beanz/m-bot-scad/readme.md

# M-bot
D-Bot-style printer with MGN rails

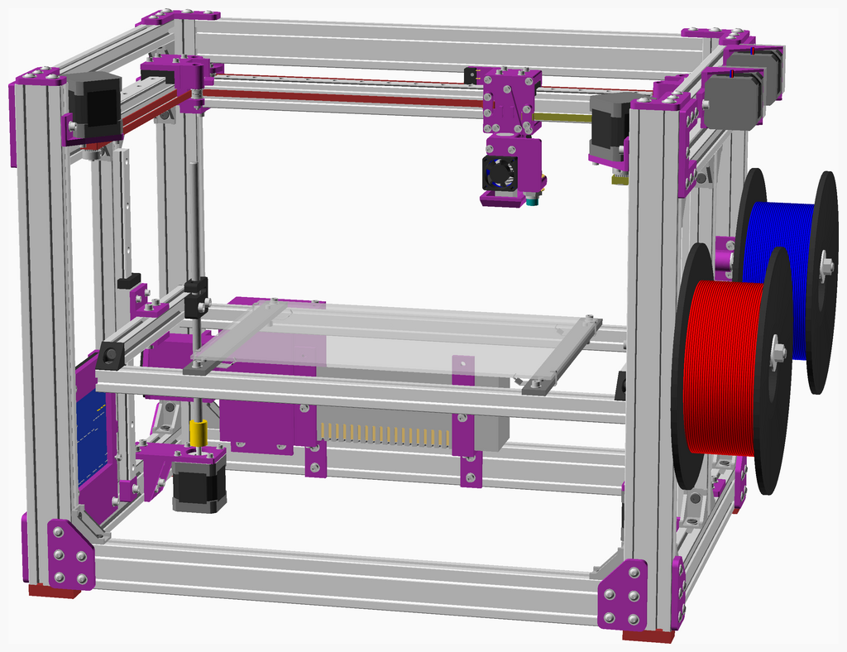
[picture p1: assemblies/main_assembled.png]
Main Assembly


<span></span>

---
## Table of Contents
1. [Parts list](#Parts_list)
1. [Duct Assembly](#duct_assembly)
1. [Z Motor Assembly](#z_motor_assembly)
1. [Spool Rod Assembly](#spool_rod_assembly)
1. [Bed Assembly](#bed_assembly)
1. [Z Axis Assembly](#z_axis_assembly)
1. [Idler Assembly](#idler_assembly)
1. [Right Y Carriage Assembly](#right_y_carriage_assembly)
1. [Left Y Carriage Assembly](#left_y_carriage_assembly)
1. [X Carriage Rear Assembly](#x_carriage_rear_assembly)
1. [X Carriage Front Assembly](#x_carriage_front_assembly)
1. [X Carriage Assembly](#x_carriage_assembly)
1. [X Rail Assembly](#x_rail_assembly)
1. [X Rail Extrusion Assembly](#x_rail_extrusion_assembly)
1. [X Rail Carriage Assembly](#x_rail_carriage_assembly)
1. [X Axis Assembly](#x_axis_assembly)
1. [Xy Combined Assembly](#xy_combined_assembly)
1. [Lower Back Frame Assembly](#lower_back_frame_assembly)
1. [Milled Corner For Tapped End Assembly](#milled_corner_for_tapped_end_assembly)
1. [Cast Corner Bracket Assembly](#cast_corner_bracket_assembly)
1. [Left Front Top Corner Assembly](#left_front_top_corner_assembly)
1. [Left Back Top Corner Assembly](#left_back_top_corner_assembly)
1. [Side Top Corner Assembly](#side_top_corner_assembly)
1. [Left Motor Assembly](#left_motor_assembly)
1. [Y Endstop Assembly](#y_endstop_assembly)
1. [Y Rail Assembly](#y_rail_assembly)
1. [Left Y Rail Assembly](#left_y_rail_assembly)
1. [Left Upper End Assembly](#left_upper_end_assembly)
1. [Bottom Corner Assembly](#bottom_corner_assembly)
1. [Reversed Bottom Corner Assembly](#reversed_bottom_corner_assembly)
1. [Duet Mount Assembly](#duet_mount_assembly)
1. [Z Carriage Assembly](#z_carriage_assembly)
1. [Z Rail Assembly](#z_rail_assembly)
1. [Left Z Axis Rail Assembly](#left_z_axis_rail_assembly)
1. [Milled Corner Bracket Assembly](#milled_corner_bracket_assembly)
1. [Rail Guard Assembly](#rail_guard_assembly)
1. [Z Motor Mount Assembly](#z_motor_mount_assembly)
1. [Left Lower End Assembly](#left_lower_end_assembly)
1. [Left Lower End With Z Assembly](#left_lower_end_with_z_assembly)
1. [Left Central End Assembly](#left_central_end_assembly)
1. [Dual Idler Assembly](#dual_idler_assembly)
1. [Back Left Idler Assembly](#back_left_idler_assembly)
1. [Left Rear Upright Assembly](#left_rear_upright_assembly)
1. [Left Central And Rear Assembly](#left_central_and_rear_assembly)
1. [Left Front Upright Assembly](#left_front_upright_assembly)
1. [Left End Frame Assembly](#left_end_frame_assembly)
1. [Left End With Z Carriage Rail Assembly](#left_end_with_z_carriage_rail_assembly)
1. [Titan Mount Assembly](#titan_mount_assembly)
1. [Right Front Top Corner Assembly](#right_front_top_corner_assembly)
1. [Right Back Top Corner Assembly](#right_back_top_corner_assembly)
1. [Right Motor Assembly](#right_motor_assembly)
1. [Right Y Rail Assembly](#right_y_rail_assembly)
1. [Right Upper End Assembly](#right_upper_end_assembly)
1. [Right Z Axis Rail Assembly](#right_z_axis_rail_assembly)
1. [Right Lower End Assembly](#right_lower_end_assembly)
1. [Right Lower End With Z Assembly](#right_lower_end_with_z_assembly)
1. [Right Central End Assembly](#right_central_end_assembly)
1. [Back Right Idler Assembly](#back_right_idler_assembly)
1. [Right Rear Upright Assembly](#right_rear_upright_assembly)
1. [Right Central And Rear Assembly](#right_central_and_rear_assembly)
1. [Right Front Upright Assembly](#right_front_upright_assembly)
1. [Right End Frame Assembly](#right_end_frame_assembly)
1. [Right End With Z Carriage Rail Assembly](#right_end_with_z_carriage_rail_assembly)
1. [Frame Assembly](#frame_assembly)
1. [Frame With X Rail Assembly](#frame_with_x_rail_assembly)
1. [Frame With Bed Assembly](#frame_with_bed_assembly)
1. [Frame With Spool Holder Assembly](#frame_with_spool_holder_assembly)
1. [Frame With Z Motor Assembly](#frame_with_z_motor_assembly)
1. [Hotend Assembly](#hotend_assembly)
1. [Belts Assembly](#belts_assembly)
1. [Socket Assembly](#socket_assembly)
1. [Duet Assembly](#duet_assembly)
1. [Main Assembly](#main_assembly)

<span></span>
[Top](#TOP)

---

## Parts list
| <span style="writing-mode: vertical-rl; text-orientation: mixed;">Duct</span> | <span style="writing-mode: vertical-rl; text-orientation: mixed;">2 x Z&nbsp;Motor</span> | <span style="writing-mode: vertical-rl; text-orientation: mixed;">2 x Spool&nbsp;Rod</span> | <span style="writing-mode: verti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
|---:|---:|---:|---:|---:|---:|---:|---:|---:|---:|---:|---:|---:|---:|---:|---:|---:|---:|---:|---:|---:|---:|---:|---:|---:|---:|---:|---:|---:|---:|---:|---:|---:|---:|---:|---:|---:|---:|---:|---:|---:|---:|---:|---:|---:|---:|---:|---:|---:|---:|---:|---:|---:|---:|---:|---:|---:|---:|---:|---:|---:|---:|---:|---:|---:|---:|---:|---:|---:|---:|---:|---:|---:|:---|
|  |  |  |  |  |  |  |  |  |  |  |  |  |  |  |  |  |  |  |  |  |  |  |  |  |  |  |  |  |  |  |  |  |  |  |  |  |  |  |  |  |  |  |  |  |  |  |  |  |  |  |  |  |  |  |  |  |  |  |  |  |  |  |  |  |  |  |  |  |  |  |  | | **Vitamins** |
| &nbsp;&nbsp;.&nbsp; | &nbsp;&nbsp;.&nbsp; | &nbsp;&nbsp;4&nbsp; | &nbsp;&nbsp;.&nbsp; | &nbsp;&nbsp;.&nbsp; | &nbsp;&nbsp;.&nbsp; | &nbsp;&nbsp;.&nbsp; | &nbsp;&nbsp;.&nbsp; | &nbsp;&nbsp;.&nbsp; | &nbsp;&nbsp;.&nbsp; | &nbsp;&nbsp;.&nbsp; | &nbsp;&nbsp;.&nbsp; | &nbsp;&nbsp;.&nbsp; | &nbsp;&nbsp;.&nbsp; | &nbsp;&nbsp;.&nbsp; | &nbsp;&nbsp;.&nbsp; | &nbsp;&nbsp;.&nbsp; | &nbsp;&nbsp;.&nbsp; | &nbsp;&nbsp;.&nbsp; | &nbsp;&nbsp;.&nbsp; | &nbsp;&nbsp;.&nbsp; | &nbsp;&nbsp;.&nbsp; | &nbsp;&nbsp;.&nbsp; | &nbsp;&nbsp;.&nbsp; | &nbsp;&nbsp;.&nbsp; | &nbsp;&nbsp;.&nbsp; | &nbsp;&nbsp;.&nbsp; | &nbsp;&nbsp;.&nbsp; | &nbsp;&nbsp;.&nbsp; | &nbsp;&nbsp;.&nbsp; | &nbsp;&nbsp;.&nbsp; | &nbsp;&nbsp;.&nbsp; | &nbsp;&nbsp;.&nbsp; | &nbsp;&nbsp;.&nbsp; | &nbsp;&nbsp;.&nbsp; | &nbsp;&nbsp;.&nbsp; | &nbsp;&nbsp;.&nbsp; | &nbsp;&nbsp;.&nbsp; | &nbsp;&nbsp;.&nbsp; | &nbsp;&nbsp;.&nbsp; | &nbsp;&nbsp;.&nbsp; | &nbsp;&nbsp;.&nbsp; | &nbsp;&nbsp;.&nbsp; | &nbsp;&nbsp;.&nbsp; | &nbsp;&nbsp;.&nbsp; | &nbsp;&nbsp;.&nbsp; | &nbsp;&nbsp;.&nbsp; | &nbsp;&nbsp;.&nbsp; | &nbsp;&nbsp;.&nbsp; | &nbsp;&nbsp;.&nbsp; | &nbsp;&nbsp;.&nbsp; | &nbsp;&nbsp;.&nbsp; | &nbsp;&nbsp;.&nbsp; | &nbsp;&nbsp;.&nbsp; | &nbsp;&nbsp;.&nbsp; | &nbsp;&nbsp;.&nbsp; | &nbsp;&nbsp;.&nbsp; | &nbsp;&nbsp;.&nbsp; | &nbsp;&nbsp;.&nbsp; | &nbsp;&nbsp;.&nbsp; | &nbsp;&nbsp;.&nbsp; | &nbsp;&nbsp;.&nbsp; | &nbsp;&nbsp;.&nbsp; | &nbsp;&nbsp;.&nbsp; | &nbsp;&nbsp;.&nbsp; | &nbsp;&nbsp;.&nbsp; | &nbsp;&nbsp;.&nbsp; | &nbsp;&nbsp;.&nbsp; | &nbsp;&nbsp;.&nbsp; | &nbsp;&nbsp;.&nbsp; | &nbsp;&nbsp;.&nbsp; | &nbsp;&nbsp;.&nbsp; |  &nbsp;&nbsp;4&nbsp; | &nbsp;&nbsp; Ball bearing 608-2RS 8mm x 22mm x 7mm |
| &nbsp;&nbsp;.&nbsp; | &nbsp;&nbsp;.&nbsp; | &nbsp;&nbsp;.&nbsp; | &nbsp;&nbsp;.&nbsp; | &nbsp;&nbsp;.&nbsp; | &nbsp;&nbsp;8&nbsp; | &nbsp;&nbsp;.&nbsp; | &nbsp;&nbsp;.&nbsp; | &nbsp;&nbsp;.&nbsp; | &nbsp;&nbsp;.&nbsp; | &nbsp;&nbsp;.&nbsp; | &nbsp;&nbsp;.&nbsp; | &nbsp;&nbsp;.&nbsp; | &nbsp;&nbsp;.&nbsp; | &nbsp;&nbsp;.&nbsp; | &nbsp;&nbsp;.&nbsp; | &nbsp;&nbsp;.&nbsp; | &nbsp;&nbsp;.&nbsp; | &nbsp;&nbsp;.&nbsp; | &nbsp;&nbsp;.&nbsp; | &nbsp;&nbsp;.&nbsp; | &nbsp;&nbsp;.&nbsp; | &nbsp;&nbsp;.&nbsp; | &nbsp;&nbsp;.&nbsp; | &nbsp;&nbsp;.&nbsp; | &nbsp;&nbsp;.&nbsp; | &nbsp;&nbsp;.&nbsp; | &nbsp;&nbsp;.&nbsp; | &nbsp;&nbsp;.&nbsp; | &nbsp;&nbsp;.&nbsp; | &nbsp;&nbsp;.&nbsp; | &nbsp;&nbsp;.&nbsp; | &nbsp;&nbsp;.&nbsp; | &nbsp;&nbsp;.&nbsp; | &nbsp;&nbsp;.&nbsp; | &nbsp;&nbsp;.&nbsp; | &nbsp;&nbsp;.&nbsp; | &nbsp;&nbsp;.&nbsp; | &nbsp;&nbsp;.&nbsp; | &nbsp;&nbsp;8&nbsp; | &nbsp;&nbsp;.&nbsp; | &nbsp;&nbsp;.&nbsp; | &nbsp;&nbsp;.&nbsp; | &nbsp;&nbsp;.&nbsp; | &nbsp;&nbsp;.&nbsp; | &nbsp;&nbsp;.&nbsp; | &nbsp;&nbsp;.&nbsp; | &nbsp;&nbsp;.&nbsp; | &nbsp;&nbsp;.&nbsp; | &nbsp;&nbsp;.&nbsp; | &nbsp;&nbsp;.&nbsp; | &nbsp;&nbsp;.&nbsp; | &nbsp;&nbsp;.&nbsp; | &nbsp;&nbsp;.&nbsp; | &nbsp;&nbsp;.&nbsp; | &nbsp;&nbsp;.&nbsp; | &nbsp;&nbsp;.&nbsp; | &nbsp;&nbsp;.&nbsp; | &nbsp;&nbsp;.&nbsp; | &nbsp;&nbsp;.&nbsp; | &nbsp;&nbsp;.&nbsp; | &nbsp;&nbsp;.&nbsp; | &nbsp;&nbsp;.&nbsp; | &nbsp;&nbsp;.&nbsp; | &nbsp;&nbsp;.&nbsp; | &nbsp;&nbsp;.&nbsp; | &nbsp;&nbsp;.&nbsp; | &nbsp;&nbsp;.&nbsp; | &nbsp;&nbsp;.&nbsp; | &nbsp;&nbsp;.&nbsp; | &nbsp;&nbsp;.&nbsp; | &nbsp;&nbsp;.&nbsp; |  &nbsp;&nbsp;16&nbsp; | &nbsp;&nbsp; Ball bearing F623-2RS 3mm x 10mm x 4mm |
| &nbsp;&nbsp;1&nbsp; | &nbsp;&nbsp;.&nbsp; | &nbsp;&nbsp;.&nbsp; | &nbsp;&nbsp;.&nbsp; | &nbsp;&nbsp;.&nbsp; | &nbsp;&nbsp;.&nbsp; | &nbsp;&nbsp;.&nbsp; | &nbsp;&nbsp;.&nbsp; | &nbsp;&nbsp;.&nbsp; | &nbsp;&nbsp;.&nbsp; | &nbsp;&nbsp;.&nbsp; | &nbsp;&nbsp;.&nbsp; | &nbsp;&nbsp;.&nbsp; | &nbsp;&nbsp;.&nbsp; | &nbsp;&nbsp;.&nbsp; | &nbsp;&nbsp;.&nbsp; | &nbsp;&nbsp;.&nbsp; | &nbsp;&nbsp;.&nbsp; | &nbsp;&nbsp;.&nbsp; | &nbsp;&nbsp;.&nbsp; | &nbsp;&nbsp;.&nbsp; | &nbsp;&nbsp;.&nbsp; | &nbsp;&nbsp;.&nbsp; | &nbsp;&nbsp;.&nbsp; | &nbsp;&nbsp;.&nbsp; | &nbsp;&nbsp;.&nbsp; | &nbsp;&nbsp;.&nbsp; | &nbsp;&nbsp;.&nbsp; | &nbsp;&nbsp;.&nbsp; | &nbsp;&nbsp;.&nbsp; | &nbsp;&nbsp;.&nbsp; | &nbsp;&nbsp;.&nbsp; | &nbsp;&nbsp;.&nbsp; | &nbsp;&nbsp;.&nbsp; | &nbsp;&nbsp;.&nbsp; | &nbsp;&nbsp;.&nbsp; | &nbsp;&nbsp;.&nbsp; | &nbsp;&nbsp;.&nbsp; | &nbsp;&nbsp;.&nbsp; | &nbsp;&nbsp;.&nbsp; | &nbsp;&nbsp;.&nbsp; | &nbsp;&nbsp;.&nbsp; | &nbsp;&nbsp;.&nbsp; | &nbsp;&nbsp;.&nbsp; | &nbsp;&nbsp;.&nbsp; | &nbsp;&nbsp;.&nbsp; | &nbsp;&nbsp;.&nbsp; | &nbsp;&nbsp;.&nbsp; | &nbsp;&nbsp;.&nbsp; | &nbsp;&nbsp;.&nbsp; | &nbsp;&nbsp;.&nbsp; | &nbsp;&nbsp;.&nbsp; | &nbsp;&nbsp;.&nbsp; | &nbsp;&nbsp;.&nbsp; | &nbsp;&nbsp;.&nbsp; | &nbsp;&nbsp;.&nbsp; | &nbsp;&nbsp;.&nbsp; | &nbsp;&nbsp;.&nbsp; | &nbsp;&nbsp;.&nbsp; | &nbsp;&nbsp;.&nbsp; | &nbsp;&nbsp;.&nbsp; | &nbsp;&nbsp;.&nbsp; | &nbsp;&nbsp;.&nbsp; | &nbsp;&nbsp;.&nbsp; | &nbsp;&nbsp;.&nbsp; | &nbsp;&nbsp;.&nbsp; | &nbsp;&nbsp;.&nbsp; | &nbsp;&nbsp;.&nbsp; | &nbsp;&nbsp;.&nbsp; | &nbsp;&nbsp;.&nbsp; | &nbsp;&nbsp;.&nbsp; | &nbsp;&nbsp;.&nbsp; |  &nbsp;&nbsp;1&nbsp; | &nbsp;&nbsp; Blower Runda RB5015 |
| &nbsp;&nbsp;.&nbsp; | &nbsp;&nbsp;.&nbsp; | &nbsp;&nbsp;.&nbsp; | &nbsp;&nbsp;.&nbsp; | &nbsp;&nbsp;.&nbsp; | &nbsp;&nbsp;.&nbsp; | &nbsp;&nbsp;.&nbsp; | &nbsp;&nbsp;.&nbsp; | &nbsp;&nbsp;.&nbsp; | &nbsp;&nbsp;.&nbsp; | &nbsp;&nbsp;.&nbsp; | &nbsp;&nbsp;.&nbsp; | &nbsp;&nbsp;.&nbsp; | &nbsp;&nbsp;.&nbsp; | &nbsp;&nbsp;.&nbsp; | &nbsp;&nbsp;.&nbsp; | &nbsp;&nbsp;.&nbsp; | &nbsp;&nbsp;.&nbsp; | &nbsp;&nbsp;.&nbsp; | &nbsp;&nbsp;.&nbsp; | &nbsp;&nbsp;.&nbsp; | &nbsp;&nbsp;.&nbsp; | &nbsp;&nbsp;.&nbsp; | &nbsp;&nbsp;.&nbsp; | &nbsp;&nbsp;.&nbsp; | &nbsp;&nbsp;.&nbsp; | &nbsp;&nbsp;.&nbsp; | &nbsp;&nbsp;.&nbsp; | &nbsp;&nbsp;.&nbsp; | &nbsp;&nbsp;.&nbsp; | &nbsp;&nbsp;.&nbsp; | &nbsp;&nbsp;.&nbsp; | &nbsp;&nbsp;.&nbsp; | &nbsp;&nbsp;.&nbsp; | &nbsp;&nbsp;.&nbsp; | &nbsp;&nbsp;.&nbsp; | &nbsp;&nbsp;.&nbsp; | &nbsp;&nbsp;.&nbsp; | &nbsp;&nbsp;.&nbsp; | &nbsp;&nbsp;.&nbsp; | &nbsp;&nbsp;.&nbsp; | &nbsp;&nbsp;.&nbsp; | &nbsp;&nbsp;.&nbsp; | &nbsp;&nbsp;.&nbsp; | &nbsp;&nbsp;.&nbsp; | &nbsp;&nbsp;.&nbsp; | &nbsp;&nbsp;.&nbsp; | &nbsp;&nbsp;.&nbsp; | &nbsp;&nbsp;.&nbsp; | &nbsp;&nbsp;.&nbsp; | &nbsp;&nbsp;.&nbsp; | &nbsp;&nbsp;.&nbsp; | &nbsp;&nbsp;.&nbsp; | &nbsp;&nbsp;.&nbsp; | &nbsp;&nbsp;.&nbsp; | &nbsp;&nbsp;.&nbsp; | &nbsp;&nbsp;.&nbsp; | &nbsp;&nbsp;.&nbsp; | &nbsp;&nbsp;.&nbsp; | &nbsp;&nbsp;.&nbsp; | &nbsp;&nbsp;.&nbsp; | &nbsp;&nbsp;.&nbsp; | &nbsp;&nbsp;.&nbsp; | &nbsp;&nbsp;.&nbsp; | &nbsp;&nbsp;.&nbsp; | &nbsp;&nbsp;.&nbsp; | &nbsp;&nbsp;.&nbsp; | &nbsp;&nbsp;.&nbsp; | &nbsp;&nbsp;.&nbsp; | &nbsp;&nbsp;.&nbsp; | &nbsp;&nbsp;1&nbsp; | &nbsp;&nbsp;.&nbsp; |  &nbsp;&nbsp;1&nbsp; | &nbsp;&nbsp; Cat 5 patch cable 300mm |
| &nbsp;&nbsp;.&nbsp; | &nbsp;&nbsp;.&nbsp; | &nbsp;&nbsp;.&nbsp; | &nbsp;&nbsp;.&nbsp; | &nbsp;&nbsp;.&nbsp; | &nbsp;&nbsp;.&nbsp; | &nbsp;&nbsp;.&nbsp; | &nbsp;&nbsp;.&nbsp; | &nbsp;&nbsp;.&nbsp; | &nbsp;&nbsp;.&nbsp; | &nbsp;&nbsp;.&nbsp; | &nbsp;&nbsp;.&nbsp; | &nbsp;&nbsp;.&nbsp; | &nbsp;&nbsp;.&nbsp; | &nbsp;&nbsp;.&nbsp; | &nbsp;&nbsp;.&nbsp; | &nbsp;&nbsp;.&nbsp; | &nbsp;&nbsp;.&nbsp; | &nbsp;&nbsp;.&nbsp; | &nbsp;&nbsp;.&nbsp; | &nbsp;&nbsp;.&nbsp; | &nbsp;&nbsp;.&nbsp; | &nbsp;&nbsp;.&nbsp; | &nbsp;&nbsp;.&nbsp; | &nbsp;&nbsp;.&nbsp; | &nbsp;&nbsp;.&nbsp; | &nbsp;&nbsp;.&nbsp; | &nbsp;&nbsp;.&nbsp; | &nbsp;&nbsp;.&nbsp; | &nbsp;&nbsp;.&nbsp; | &nbsp;&nbsp;.&nbsp; | &nbsp;&nbsp;.&nbsp; | &nbsp;&nbsp;.&nbsp; | &nbsp;&nbsp;.&nbsp; | &nbsp;&nbsp;.&nbsp; | &nbsp;&nbsp;.&nbsp; | &nbsp;&nbsp;.&nbsp; | &nbsp;&nbsp;.&nbsp; | &nbsp;&nbsp;.&nbsp; | &nbsp;&nbsp;.&nbsp; | &nbsp;&nbsp;.&nbsp; | &nbsp;&nbsp;.&nbsp; | &nbsp;&nbsp;.&nbsp; | &nbsp;&nbsp;.&nbsp; | &nbsp;&nbsp;.&nbsp; | &nbsp;&nbsp;.&nbsp; | &nbsp;&nbsp;.&nbsp; | &nbsp;&nbsp;.&nbsp; | &nbsp;&nbsp;.&nbsp; | &nbsp;&nbsp;.&nbsp; | &nbsp;&nbsp;.&nbsp; | &nbsp;&nbsp;.&nbsp; | &nbsp;&nbsp;.&nbsp; | &nbsp;&nbsp;.&nbsp; | &nbsp;&nbsp;.&nbsp; | &nbsp;&nbsp;.&nbsp; | &nbsp;&nbsp;.&nbsp; | &nbsp;&nbsp;.&nbsp; | &nbsp;&nbsp;.&nbsp; | &nbsp;&nbsp;.&nbsp; | &nbsp;&nbsp;.&nbsp; | &nbsp;&nbsp;.&nbsp; | &nbsp;&nbsp;.&nbsp; | &nbsp;&nbsp;.&nbsp; | &nbsp;&nbsp;.&nbsp; | &nbsp;&nbsp;.&nbsp; | &nbsp;&nbsp;.&nbsp; | &nbsp;&nbsp;.&nbsp; | &nbsp;&nbsp;.&nbsp; | &nbsp;&nbsp;.&nbsp; | &nbsp;&nbsp;1&nbsp; | &nbsp;&nbsp;.&nbsp; |  &nbsp;&nbsp;1&nbsp; | &nbsp;&nbsp; Duet 2 Ethernet electronics |
| &nbsp;&nbsp;.&nbsp; | &nbsp;&nbsp;.&nbsp; | &nbsp;&nbsp;.&nbsp; | &nbsp;&nbsp;.&nbsp; | &nbsp;&nbsp;.&nbsp; | &nbsp;&nbsp;.&nbsp; | &nbsp;&nbsp;.&nbsp; | &nbsp;&nbsp;.&nbsp; | &nbsp;&nbsp;.&nbsp; | &nbsp;&nbsp;.&nbsp; | &nbsp;&nbsp;.&nbsp; | &nbsp;&nbsp;.&nbsp; | &nbsp;&nbsp;.&nbsp; | &nbsp;&nbsp;.&nbsp; | &nbsp;&nbsp;.&nbsp; | &nbsp;&nbsp;.&nbsp; | &nbsp;&nbsp;.&nbsp; | &nbsp;&nbsp;.&nbsp; | &nbsp;&nbsp;.&nbsp; | &nbsp;&nbsp;.&nbsp; | &nbsp;&nbsp;.&nbsp; | &nbsp;&nbsp;.&nbsp; | &nbsp;&nbsp;.&nbsp; | &nbsp;&nbsp;.&nbsp; | &nbsp;&nbsp;.&nbsp; | &nbsp;&nbsp;.&nbsp; | &nbsp;&nbsp;.&nbsp; | &nbsp;&nbsp;.&nbsp; | &nbsp;&nbsp;.&nbsp; | &nbsp;&nbsp;.&nbsp; | &nbsp;&nbsp;.&nbsp; | &nbsp;&nbsp;.&nbsp; | &nbsp;&nbsp;.&nbsp; | &nbsp;&nbsp;.&nbsp; | &nbsp;&nbsp;.&nbsp; | &nbsp;&nbsp;.&nbsp; | &nbsp;&nbsp;.&nbsp; | &nbsp;&nbsp;.&nbsp; | &nbsp;&nbsp;.&nbsp; | &nbsp;&nbsp;.&nbsp; | &nbsp;&nbsp;.&nbsp; | &nbsp;&nbsp;.&nbsp; | &nbsp;&nbsp;.&nbsp; | &nbsp;&nbsp;.&nbsp; | &nbsp;&nbsp;.&nbsp; | &nbsp;&nbsp;.&nbsp; | &nbsp;&nbsp;2&nbsp; | &nbsp;&nbsp;.&nbsp; | &nbsp;&nbsp;.&nbsp; | &nbsp;&nbsp;.&nbsp; | &nbsp;&nbsp;.&nbsp; | &nbsp;&nbsp;.&nbsp; | &nbsp;&nbsp;.&nbsp; | &nbsp;&nbsp;.&nbsp; | &nbsp;&nbsp;.&nbsp; | &nbsp;&nbsp;.&nbsp; | &nbsp;&nbsp;.&nbsp; | &nbsp;&nbsp;.&nbsp; | &nbsp;&nbsp;.&nbsp; | &nbsp;&nbsp;.&nbsp; | &nbsp;&nbsp;.&nbsp; | &nbsp;&nbsp;.&nbsp; | &nbsp;&nbsp;.&nbsp; | &nbsp;&nbsp;.&nbsp; | &nbsp;&nbsp;.&nbsp; | &nbsp;&nbsp;.&nbsp; | &nbsp;&nbsp;.&nbsp; | &nbsp;&nbsp;.&nbsp; | &nbsp;&nbsp;.&nbsp; | &nbsp;&nbsp;.&nbsp; | &nbsp;&nbsp;.&nbsp; | &nbsp;&nbsp;.&nbsp; |  &nbsp;&nbsp;2&nbsp; | &nbsp;&nbsp; E3D Titan Extruder |
| &nbsp;&nbsp;.&nbsp; | &nbsp;&nbsp;.&nbsp; | &nbsp;&nbsp;.&nbsp; | &nbsp;&nbsp;.&nbsp; | &nbsp;&nbsp;.&nbsp; | &nbsp;&nbsp;.&nbsp; | &nbsp;&nbsp;.&nbsp; | &nbsp;&nbsp;.&nbsp; | &nbsp;&nbsp;.&nbsp; | &nbsp;&nbsp;.&nbsp; | &nbsp;&nbsp;.&nbsp; | &nbsp;&nbsp;.&nbsp; | &nbsp;&nbsp;.&nbsp; | &nbsp;&nbsp;.&nbsp; | &nbsp;&nbsp;.&nbsp; | &nbsp;&nbsp;.&nbsp; | &nbsp;&nbsp;.&nbsp; | &nbsp;&nbsp;.&nbsp; | &nbsp;&nbsp;.&nbsp; | &nbsp;&nbsp;.&nbsp; | &nbsp;&nbsp;.&nbsp; | &nbsp;&nbsp;.&nbsp; | &nbsp;&nbsp;.&nbsp; | &nbsp;&nbsp;.&nbsp; | &nbsp;&nbsp;.&nbsp; | &nbsp;&nbsp;.&nbsp; | &nbsp;&nbsp;.&nbsp; | &nbsp;&nbsp;.&nbsp; | &nbsp;&nbsp;.&nbsp; | &nbsp;&nbsp;.&nbsp; | &nbsp;&nbsp;.&nbsp; | &nbsp;&nbsp;.&nbsp; | &nbsp;&nbsp;.&nbsp; | &nbsp;&nbsp;.&nbsp; | &nbsp;&nbsp;.&nbsp; | &nbsp;&nbsp;.&nbsp; | &nbsp;&nbsp;.&nbsp; | &nbsp;&nbsp;.&nbsp; | &nbsp;&nbsp;.&nbsp; | &nbsp;&nbsp;.&nbsp; | &nbsp;&nbsp;.&nbsp; | &nbsp;&nbsp;.&nbsp; | &nbsp;&nbsp;.&nbsp; | &nbsp;&nbsp;.&nbsp; | &nbsp;&nbsp;.&nbsp; | &nbsp;&nbsp;1&nbsp; | &nbsp;&nbsp;.&nbsp; | &nbsp;&nbsp;.&nbsp; | &nbsp;&nbsp;.&nbsp; | &nbsp;&nbsp;.&nbsp; | &nbsp;&nbsp;.&nbsp; | &nbsp;&nbsp;.&nbsp; | &nbsp;&nbsp;.&nbsp; | &nbsp;&nbsp;.&nbsp; | &nbsp;&nbsp;.&nbsp; | &nbsp;&nbsp;.&nbsp; | &nbsp;&nbsp;.&nbsp; | &nbsp;&nbsp;.&nbsp; | &nbsp;&nbsp;.&nbsp; | &nbsp;&nbsp;.&nbsp; | &nbsp;&nbsp;.&nbsp; | &nbsp;&nbsp;1&nbsp; | &nbsp;&nbsp;.&nbsp; | &nbsp;&nbsp;.&nbsp; | &nbsp;&nbsp;.&nbsp; | &nbsp;&nbsp;.&nbsp; | &nbsp;&nbsp;.&nbsp; | &nbsp;&nbsp;.&nbsp; | &nbsp;&nbsp;.&nbsp; | &nbsp;&nbsp;.&nbsp; | &nbsp;&nbsp;.&nbsp; | &nbsp;&nbsp;.&nbsp; |  &nbsp;&nbsp;2&nbsp; | &nbsp;&nbsp; Extrusion E2020 x 220mm |
| &nbsp;&nbsp;.&nbsp; | &nbsp;&nbsp;.&nbsp; | &nbsp;&nbsp;.&nbsp; | &nbsp;&nbsp;.&nbsp; | &nbsp;&nbsp;.&nbsp; | &nbsp;&nbsp;.&nbsp; | &nbsp;&nbsp;.&nbsp; | &nbsp;&nbsp;.&nbsp; | &nbsp;&nbsp;.&nbsp; | &nbsp;&nbsp;.&nbsp; | &nbsp;&nbsp;.&nbsp; | &nbsp;&nbsp;.&nbsp; | &nbsp;&nbsp;.&nbsp; | &nbsp;&nbsp;.&nbsp; | &nbsp;&nbsp;.&nbsp; | &nbsp;&nbsp;.&nbsp; | &nbsp;&nbsp;.&nbsp; | &nbsp;&nbsp;.&nbsp; | &nbsp;&nbsp;.&nbsp; | &nbsp;&nbsp;.&nbsp; | &nbsp;&nbsp;.&nbsp; | &nbsp;&nbsp;.&nbsp; | &nbsp;&nbsp;.&nbsp; | &nbsp;&nbsp;.&nbsp; | &nbsp;&nbsp;.&nbsp; | &nbsp;&nbsp;.&nbsp; | &nbsp;&nbsp;.&nbsp; | &nbsp;&nbsp;.&nbsp; | &nbsp;&nbsp;.&nbsp; | &nbsp;&nbsp;.&nbsp; | &nbsp;&nbsp;.&nbsp; | &nbsp;&nbsp;.&nbsp; | &nbsp;&nbsp;1&nbsp; | &nbsp;&nbsp;.&nbsp; | &nbsp;&nbsp;.&nbsp; | &nbsp;&nbsp;.&nbsp; | &nbsp;&nbsp;.&nbsp; | &nbsp;&nbsp;.&nbsp; | &nbsp;&nbsp;.&nbsp; | &nbsp;&nbsp;.&nbsp; | &nbsp;&nbsp;.&nbsp; | &nbsp;&nbsp;.&nbsp; | &nbsp;&nbsp;.&nbsp; | &nbsp;&nbsp;.&nbsp; | &nbsp;&nbsp;.&nbsp; | &nbsp;&nbsp;.&nbsp; | &nbsp;&nbsp;.&nbsp; | &nbsp;&nbsp;.&nbsp; | &nbsp;&nbsp;.&nbsp; | &nbsp;&nbsp;.&nbsp; | &nbsp;&nbsp;.&nbsp; | &nbsp;&nbsp;.&nbsp; | &nbsp;&nbsp;1&nbsp; | &nbsp;&nbsp;.&nbsp; | &nbsp;&nbsp;.&nbsp; | &nbsp;&nbsp;.&nbsp; | &nbsp;&nbsp;.&nbsp; | &nbsp;&nbsp;.&nbsp; | &nbsp;&nbsp;.&nbsp; | &nbsp;&nbsp;.&nbsp; | &nbsp;&nbsp;.&nbsp; | &nbsp;&nbsp;.&nbsp; | &nbsp;&nbsp;.&nbsp; | &nbsp;&nbsp;.&nbsp; | &nbsp;&nbsp;.&nbsp; | &nbsp;&nbsp;.&nbsp; | &nbsp;&nbsp;.&nbsp; | &nbsp;&nbsp;.&nbsp; | &nbsp;&nbsp;.&nbsp; | &nbsp;&nbsp;.&nbsp; | &nbsp;&nbsp;.&nbsp; | &nbsp;&nbsp;.&nbsp; |  &nbsp;&nbsp;2&nbsp; | &nbsp;&nbsp; Extrusion E2020 x 320mm |
| &nbsp;&nbsp;.&nbsp; | &nbsp;&nbsp;.&nbsp; | &nbsp;&nbsp;.&nbsp; | &nbsp;&nbsp;.&nbsp; | &nbsp;&nbsp;.&nbsp; | &nbsp;&nbsp;.&nbsp; | &nbsp;&nbsp;.&nbsp; | &nbsp;&nbsp;.&nbsp; | &nbsp;&nbsp;.&nbsp; | &nbsp;&nbsp;.&nbsp; | &nbsp;&nbsp;.&nbsp; | &nbsp;&nbsp;.&nbsp; | &nbsp;&nbsp;.&nbsp; | &nbsp;&nbsp;.&nbsp; | &nbsp;&nbsp;.&nbsp; | &nbsp;&nbsp;.&nbsp; | &nbsp;&nbsp;.&nbsp; | &nbsp;&nbsp;.&nbsp; | &nbsp;&nbsp;.&nbsp; | &nbsp;&nbsp;.&nbsp; | &nbsp;&nbsp;.&nbsp; | &nbsp;&nbsp;.&nbsp; | &nbsp;&nbsp;.&nbsp; | &nbsp;&nbsp;.&nbsp; | &nbsp;&nbsp;.&nbsp; | &nbsp;&nbsp;.&nbsp; | &nbsp;&nbsp;1&nbsp; | &nbsp;&nbsp;.&nbsp; | &nbsp;&nbsp;.&nbsp; | &nbsp;&nbsp;.&nbsp; | &nbsp;&nbsp;.&nbsp; | &nbsp;&nbsp;.&nbsp; | &nbsp;&nbsp;.&nbsp; | &nbsp;&nbsp;.&nbsp; | &nbsp;&nbsp;.&nbsp; | &nbsp;&nbsp;.&nbsp; | &nbsp;&nbsp;.&nbsp; | &nbsp;&nbsp;.&nbsp; | &nbsp;&nbsp;.&nbsp; | &nbsp;&nbsp;.&nbsp; | &nbsp;&nbsp;.&nbsp; | &nbsp;&nbsp;.&nbsp; | &nbsp;&nbsp;.&nbsp; | &nbsp;&nbsp;.&nbsp; | &nbsp;&nbsp;.&nbsp; | &nbsp;&nbsp;.&nbsp; | &nbsp;&nbsp;.&nbsp; | &nbsp;&nbsp;.&nbsp; | &nbsp;&nbsp;.&nbsp; | &nbsp;&nbsp;.&nbsp; | &nbsp;&nbsp;.&nbsp; | &nbsp;&nbsp;1&nbsp; | &nbsp;&nbsp;.&nbsp; | &nbsp;&nbsp;.&nbsp; | &nbsp;&nbsp;.&nbsp; | &nbsp;&nbsp;.&nbsp; | &nbsp;&nbsp;.&nbsp; | &nbsp;&nbsp;.&nbsp; | &nbsp;&nbsp;.&nbsp; | &nbsp;&nbsp;.&nbsp; | &nbsp;&nbsp;.&nbsp; | &nbsp;&nbsp;.&nbsp; | &nbsp;&nbsp;.&nbsp; | &nbsp;&nbsp;.&nbsp; | &nbsp;&nbsp;.&nbsp; | &nbsp;&nbsp;.&nbsp; | &nbsp;&nbsp;.&nbsp; | &nbsp;&nbsp;.&nbsp; | &nbsp;&nbsp;.&nbsp; | &nbsp;&nbsp;.&nbsp; | &nbsp;&nbsp;.&nbsp; | &nbsp;&nbsp;.&nbsp; |  &nbsp;&nbsp;2&nbsp; | &nbsp;&nbsp; Extrusion E2020 x 354mm |
| &nbsp;&nbsp;.&nbsp; | &nbsp;&nbsp;.&nbsp; | &nbsp;&nbsp;.&nbsp; | &nbsp;&nbsp;.&nbsp; | &nbsp;&nbsp;.&nbsp; | &nbsp;&nbsp;.&nbsp; | &nbsp;&nbsp;.&nbsp; | &nbsp;&nbsp;.&nbsp; | &nbsp;&nbsp;.&nbsp; | &nbsp;&nbsp;.&nbsp; | &nbsp;&nbsp;.&nbsp; | &nbsp;&nbsp;.&nbsp; | &nbsp;&nbsp;1&nbsp; | &nbsp;&nbsp;.&nbsp; | &nbsp;&nbsp;.&nbsp; | &nbsp;&nbsp;.&nbsp; | &nbsp;&nbsp;.&nbsp; | &nbsp;&nbsp;.&nbsp; | &nbsp;&nbsp;.&nbsp; | &nbsp;&nbsp;.&nbsp; | &nbsp;&nbsp;.&nbsp; | &nbsp;&nbsp;.&nbsp; | &nbsp;&nbsp;.&nbsp; | &nbsp;&nbsp;.&nbsp; | &nbsp;&nbsp;.&nbsp; | &nbsp;&nbsp;.&nbsp; | &nbsp;&nbsp;.&nbsp; | &nbsp;&nbsp;.&nbsp; | &nbsp;&nbsp;.&nbsp; | &nbsp;&nbsp;.&nbsp; | &nbsp;&nbsp;.&nbsp; | &nbsp;&nbsp;.&nbsp; | &nbsp;&nbsp;.&nbsp; | &nbsp;&nbsp;.&nbsp; | &nbsp;&nbsp;.&nbsp; | &nbsp;&nbsp;.&nbsp; | &nbsp;&nbsp;.&nbsp; | &nbsp;&nbsp;.&nbsp; | &nbsp;&nbsp;.&nbsp; | &nbsp;&nbsp;.&nbsp; | &nbsp;&nbsp;.&nbsp; | &nbsp;&nbsp;.&nbsp; | &nbsp;&nbsp;.&nbsp; | &nbsp;&nbsp;.&nbsp; | &nbsp;&nbsp;.&nbsp; | &nbsp;&nbsp;.&nbsp; | &nbsp;&nbsp;.&nbsp; | &nbsp;&nbsp;.&nbsp; | &nbsp;&nbsp;.&nbsp; | &nbsp;&nbsp;.&nbsp; | &nbsp;&nbsp;.&nbsp; | &nbsp;&nbsp;.&nbsp; | &nbsp;&nbsp;.&nbsp; | &nbsp;&nbsp;.&nbsp; | &nbsp;&nbsp;.&nbsp; | &nbsp;&nbsp;.&nbsp; | &nbsp;&nbsp;.&nbsp; | &nbsp;&nbsp;.&nbsp; | &nbsp;&nbsp;.&nbsp; | &nbsp;&nbsp;.&nbsp; | &nbsp;&nbsp;.&nbsp; | &nbsp;&nbsp;.&nbsp; | &nbsp;&nbsp;.&nbsp; | &nbsp;&nbsp;.&nbsp; | &nbsp;&nbsp;.&nbsp; | &nbsp;&nbsp;.&nbsp; | &nbsp;&nbsp;.&nbsp; | &nbsp;&nbsp;.&nbsp; | &nbsp;&nbsp;.&nbsp; | &nbsp;&nbsp;.&nbsp; | &nbsp;&nbsp;.&nbsp; | &nbsp;&nbsp;.&nbsp; |  &nbsp;&nbsp;1&nbsp; | &nbsp;&nbsp; Extrusion E2020 x 450mm |
| &nbsp;&nbsp;.&nbsp; | &nbsp;&nbsp;.&nbsp; | &nbsp;&nbsp;.&nbsp; | &nbsp;&nbsp;.&nbsp; | &nbsp;&nbsp;2&nbsp; | &nbsp;&nbsp;.&nbsp; | &nbsp;&nbsp;.&nbsp; | &nbsp;&nbsp;.&nbsp; | &nbsp;&nbsp;.&nbsp; | &nbsp;&nbsp;.&nbsp; | &nbsp;&nbsp;.&nbsp; | &nbsp;&nbsp;.&nbsp; | &nbsp;&nbsp;.&nbsp; | &nbsp;&nbsp;.&nbsp; | &nbsp;&nbsp;.&nbsp; | &nbsp;&nbsp;.&nbsp; | &nbsp;&nbsp;.&nbsp; | &nbsp;&nbsp;.&nbsp; | &nbsp;&nbsp;.&nbsp; | &nbsp;&nbsp;.&nbsp; | &nbsp;&nbsp;.&nbsp; | &nbsp;&nbsp;.&nbsp; | &nbsp;&nbsp;.&nbsp; | &nbsp;&nbsp;.&nbsp; | &nbsp;&nbsp;.&nbsp; | &nbsp;&nbsp;.&nbsp; | &nbsp;&nbsp;.&nbsp; | &nbsp;&nbsp;.&nbsp; | &nbsp;&nbsp;.&nbsp; | &nbsp;&nbsp;.&nbsp; | &nbsp;&nbsp;.&nbsp; | &nbsp;&nbsp;.&nbsp; | &nbsp;&nbsp;.&nbsp; | &nbsp;&nbsp;.&nbsp; | &nbsp;&nbsp;.&nbsp; | &nbsp;&nbsp;.&nbsp; | &nbsp;&nbsp;.&nbsp; | &nbsp;&nbsp;.&nbsp; | &nbsp;&nbsp;.&nbsp; | &nbsp;&nbsp;.&nbsp; | &nbsp;&nbsp;.&nbsp; | &nbsp;&nbsp;.&nbsp; | &nbsp;&nbsp;.&nbsp; | &nbsp;&nbsp;.&nbsp; | &nbsp;&nbsp;.&nbsp; | &nbsp;&nbsp;.&nbsp; | &nbsp;&nbsp;.&nbsp; | &nbsp;&nbsp;.&nbsp; | &nbsp;&nbsp;.&nbsp; | &nbsp;&nbsp;.&nbsp; | &nbsp;&nbsp;.&nbsp; | &nbsp;&nbsp;.&nbsp; | &nbsp;&nbsp;.&nbsp; | &nbsp;&nbsp;.&nbsp; | &nbsp;&nbsp;.&nbsp; | &nbsp;&nbsp;.&nbsp; | &nbsp;&nbsp;.&nbsp; | &nbsp;&nbsp;.&nbsp; | &nbsp;&nbsp;.&nbsp; | &nbsp;&nbsp;.&nbsp; | &nbsp;&nbsp;.&nbsp; | &nbsp;&nbsp;.&nbsp; | &nbsp;&nbsp;.&nbsp; | &nbsp;&nbsp;.&nbsp; | &nbsp;&nbsp;.&nbsp; | &nbsp;&nbsp;.&nbsp; | &nbsp;&nbsp;.&nbsp; | &nbsp;&nbsp;.&nbsp; | &nbsp;&nbsp;.&nbsp; | &nbsp;&nbsp;.&nbsp; | &nbsp;&nbsp;.&nbsp; | &nbsp;&nbsp;.&nbsp; |  &nbsp;&nbsp;2&nbsp; | &nbsp;&nbsp; Extrusion E2020 x 470mm |
| &nbsp;&nbsp;.&nbsp; | &nbsp;&nbsp;.&nbsp; | &nbsp;&nbsp;.&nbsp; | &nbsp;&nbsp;.&nbsp; | &nbsp;&nbsp;.&nbsp; | &nbsp;&nbsp;.&nbsp; | &nbsp;&nbsp;.&nbsp; | &nbsp;&nbsp;.&nbsp; | &nbsp;&nbsp;.&nbsp; | &nbsp;&nbsp;.&nbsp; | &nbsp;&nbsp;.&nbsp; | &nbsp;&nbsp;.&nbsp; | &nbsp;&nbsp;.&nbsp; | &nbsp;&nbsp;.&nbsp; | &nbsp;&nbsp;.&nbsp; | &nbsp;&nbsp;.&nbsp; | &nbsp;&nbsp;.&nbsp; | &nbsp;&nbsp;.&nbsp; | &nbsp;&nbsp;.&nbsp; | &nbsp;&nbsp;.&nbsp; | &nbsp;&nbsp;.&nbsp; | &nbsp;&nbsp;.&nbsp; | &nbsp;&nbsp;.&nbsp; | &nbsp;&nbsp;.&nbsp; | &nbsp;&nbsp;.&nbsp; | &nbsp;&nbsp;1&nbsp; | &nbsp;&nbsp;.&nbsp; | &nbsp;&nbsp;.&nbsp; | &nbsp;&nbsp;.&nbsp; | &nbsp;&nbsp;.&nbsp; | &nbsp;&nbsp;.&nbsp; | &nbsp;&nbsp;.&nbsp; | &nbsp;&nbsp;.&nbsp; | &nbsp;&nbsp;.&nbsp; | &nbsp;&nbsp;.&nbsp; | &nbsp;&nbsp;.&nbsp; | &nbsp;&nbsp;1&nbsp; | &nbsp;&nbsp;.&nbsp; | &nbsp;&nbsp;.&nbsp; | &nbsp;&nbsp;.&nbsp; | &nbsp;&nbsp;.&nbsp; | &nbsp;&nbsp;.&nbsp; | &nbsp;&nbsp;.&nbsp; | &nbsp;&nbsp;.&nbsp; | &nbsp;&nbsp;.&nbsp; | &nbsp;&nbsp;.&nbsp; | &nbsp;&nbsp;.&nbsp; | &nbsp;&nbsp;.&nbsp; | &nbsp;&nbsp;.&nbsp; | &nbsp;&nbsp;.&nbsp; | &nbsp;&nbsp;1&nbsp; | &nbsp;&nbsp;.&nbsp; | &nbsp;&nbsp;.&nbsp; | &nbsp;&nbsp;1&nbsp; | &nbsp;&nbsp;.&nbsp; | &nbsp;&nbsp;.&nbsp; | &nbsp;&nbsp;.&nbsp; | &nbsp;&nbsp;.&nbsp; | &nbsp;&nbsp;.&nbsp; | &nbsp;&nbsp;.&nbsp; | &nbsp;&nbsp;.&nbsp; | &nbsp;&nbsp;.&nbsp; | &nbsp;&nbsp;.&nbsp; | &nbsp;&nbsp;.&nbsp; | &nbsp;&nbsp;.&nbsp; | &nbsp;&nbsp;.&nbsp; | &nbsp;&nbsp;.&nbsp; | &nbsp;&nbsp;.&nbsp; | &nbsp;&nbsp;.&nbsp; | &nbsp;&nbsp;.&nbsp; | &nbsp;&nbsp;.&nbsp; | &nbsp;&nbsp;.&nbsp; |  &nbsp;&nbsp;4&nbsp; | &nbsp;&nbsp; Extrusion E2040 x 354mm |
| &nbsp;&nbsp;.&nbsp; | &nbsp;&nbsp;.&nbsp; | &nbsp;&nbsp;.&nbsp; | &nbsp;&nbsp;.&nbsp; | &nbsp;&nbsp;.&nbsp; | &nbsp;&nbsp;.&nbsp; | &nbsp;&nbsp;.&nbsp; | &nbsp;&nbsp;.&nbsp; | &nbsp;&nbsp;.&nbsp; | &nbsp;&nbsp;.&nbsp; | &nbsp;&nbsp;.&nbsp; | &nbsp;&nbsp;.&nbsp; | &nbsp;&nbsp;.&nbsp; | &nbsp;&nbsp;.&nbsp; | &nbsp;&nbsp;.&nbsp; | &nbsp;&nbsp;.&nbsp; | &nbsp;&nbsp;.&nbsp; | &nbsp;&nbsp;.&nbsp; | &nbsp;&nbsp;.&nbsp; | &nbsp;&nbsp;.&nbsp; | &nbsp;&nbsp;.&nbsp; | &nbsp;&nbsp;.&nbsp; | &nbsp;&nbsp;.&nbsp; | &nbsp;&nbsp;.&nbsp; | &nbsp;&nbsp;.&nbsp; | &nbsp;&nbsp;.&nbsp; | &nbsp;&nbsp;.&nbsp; | &nbsp;&nbsp;.&nbsp; | &nbsp;&nbsp;.&nbsp; | &nbsp;&nbsp;.&nbsp; | &nbsp;&nbsp;.&nbsp; | &nbsp;&nbsp;.&nbsp; | &nbsp;&nbsp;.&nbsp; | &nbsp;&nbsp;.&nbsp; | &nbsp;&nbsp;.&nbsp; | &nbsp;&nbsp;.&nbsp; | &nbsp;&nbsp;.&nbsp; | &nbsp;&nbsp;.&nbsp; | &nbsp;&nbsp;.&nbsp; | &nbsp;&nbsp;.&nbsp; | &nbsp;&nbsp;.&nbsp; | &nbsp;&nbsp;1&nbsp; | &nbsp;&nbsp;.&nbsp; | &nbsp;&nbsp;1&nbsp; | &nbsp;&nbsp;.&nbsp; | &nbsp;&nbsp;.&nbsp; | &nbsp;&nbsp;.&nbsp; | &nbsp;&nbsp;.&nbsp; | &nbsp;&nbsp;.&nbsp; | &nbsp;&nbsp;.&nbsp; | &nbsp;&nbsp;.&nbsp; | &nbsp;&nbsp;.&nbsp; | &nbsp;&nbsp;.&nbsp; | &nbsp;&nbsp;.&nbsp; | &nbsp;&nbsp;.&nbsp; | &nbsp;&nbsp;.&nbsp; | &nbsp;&nbsp;.&nbsp; | &nbsp;&nbsp;1&nbsp; | &nbsp;&nbsp;.&nbsp; | &nbsp;&nbsp;1&nbsp; | &nbsp;&nbsp;.&nbsp; | &nbsp;&nbsp;.&nbsp; | &nbsp;&nbsp;.&nbsp; | &nbsp;&nbsp;.&nbsp; | &nbsp;&nbsp;.&nbsp; | &nbsp;&nbsp;.&nbsp; | &nbsp;&nbsp;.&nbsp; | &nbsp;&nbsp;.&nbsp; | &nbsp;&nbsp;.&nbsp; | &nbsp;&nbsp;.&nbsp; | &nbsp;&nbsp;.&nbsp; | &nbsp;&nbsp;.&nbsp; |  &nbsp;&nbsp;4&nbsp; | &nbsp;&nbsp; Extrusion E2040 x 430mm |
| &nbsp;&nbsp;.&nbsp; | &nbsp;&nbsp;.&nbsp; | &nbsp;&nbsp;.&nbsp; | &nbsp;&nbsp;.&nbsp; | &nbsp;&nbsp;.&nbsp; | &nbsp;&nbsp;.&nbsp; | &nbsp;&nbsp;.&nbsp; | &nbsp;&nbsp;.&nbsp; | &nbsp;&nbsp;.&nbsp; | &nbsp;&nbsp;.&nbsp; | &nbsp;&nbsp;.&nbsp; | &nbsp;&nbsp;.&nbsp; | &nbsp;&nbsp;.&nbsp; | &nbsp;&nbsp;.&nbsp; | &nbsp;&nbsp;.&nbsp; | &nbsp;&nbsp;.&nbsp; | &nbsp;&nbsp;1&nbsp; | &nbsp;&nbsp;.&nbsp; | &nbsp;&nbsp;.&nbsp; | &nbsp;&nbsp;.&nbsp; | &nbsp;&nbsp;.&nbsp; | &nbsp;&nbsp;.&nbsp; | &nbsp;&nbsp;.&nbsp; | &nbsp;&nbsp;.&nbsp; | &nbsp;&nbsp;.&nbsp; | &nbsp;&nbsp;.&nbsp; | &nbsp;&nbsp;.&nbsp; | &nbsp;&nbsp;.&nbsp; | &nbsp;&nbsp;.&nbsp; | &nbsp;&nbsp;.&nbsp; | &nbsp;&nbsp;.&nbsp; | &nbsp;&nbsp;.&nbsp; | &nbsp;&nbsp;.&nbsp; | &nbsp;&nbsp;.&nbsp; | &nbsp;&nbsp;.&nbsp; | &nbsp;&nbsp;.&nbsp; | &nbsp;&nbsp;.&nbsp; | &nbsp;&nbsp;.&nbsp; | &nbsp;&nbsp;.&nbsp; | &nbsp;&nbsp;.&nbsp; | &nbsp;&nbsp;.&nbsp; | &nbsp;&nbsp;.&nbsp; | &nbsp;&nbsp;.&nbsp; | &nbsp;&nbsp;.&nbsp; | &nbsp;&nbsp;.&nbsp; | &nbsp;&nbsp;.&nbsp; | &nbsp;&nbsp;.&nbsp; | &nbsp;&nbsp;.&nbsp; | &nbsp;&nbsp;.&nbsp; | &nbsp;&nbsp;.&nbsp; | &nbsp;&nbsp;.&nbsp; | &nbsp;&nbsp;.&nbsp; | &nbsp;&nbsp;.&nbsp; | &nbsp;&nbsp;.&nbsp; | &nbsp;&nbsp;.&nbsp; | &nbsp;&nbsp;.&nbsp; | &nbsp;&nbsp;.&nbsp; | &nbsp;&nbsp;.&nbsp; | &nbsp;&nbsp;.&nbsp; | &nbsp;&nbsp;.&nbsp; | &nbsp;&nbsp;.&nbsp; | &nbsp;&nbsp;.&nbsp; | &nbsp;&nbsp;2&nbsp; | &nbsp;&nbsp;.&nbsp; | &nbsp;&nbsp;.&nbsp; | &nbsp;&nbsp;.&nbsp; | &nbsp;&nbsp;.&nbsp; | &nbsp;&nbsp;.&nbsp; | &nbsp;&nbsp;.&nbsp; | &nbsp;&nbsp;.&nbsp; | &nbsp;&nbsp;.&nbsp; | &nbsp;&nbsp;.&nbsp; |  &nbsp;&nbsp;3&nbsp; | &nbsp;&nbsp; Extrusion E2040 x 472mm |
| &nbsp;&nbsp;.&nbsp; | &nbsp;&nbsp;.&nbsp; | &nbsp;&nbsp;.&nbsp; | &nbsp;&nbsp;.&nbsp; | &nbsp;&nbsp;.&nbsp; | &nbsp;&nbsp;.&nbsp; | &nbsp;&nbsp;.&nbsp; | &nbsp;&nbsp;.&nbsp; | &nbsp;&nbsp;.&nbsp; | &nbsp;&nbsp;.&nbsp; | &nbsp;&nbsp;.&nbsp; | &nbsp;&nbsp;.&nbsp; | &nbsp;&nbsp;.&nbsp; | &nbsp;&nbsp;.&nbsp; | &nbsp;&nbsp;.&nbsp; | &nbsp;&nbsp;.&nbsp; | &nbsp;&nbsp;.&nbsp; | &nbsp;&nbsp;.&nbsp; | &nbsp;&nbsp;24&nbsp; | &nbsp;&nbsp;.&nbsp; | &nbsp;&nbsp;.&nbsp; | &nbsp;&nbsp;.&nbsp; | &nbsp;&nbsp;.&nbsp; | &nbsp;&nbsp;.&nbsp; | &nbsp;&nbsp;.&nbsp; | &nbsp;&nbsp;.&nbsp; | &nbsp;&nbsp;.&nbsp; | &nbsp;&nbsp;.&nbsp; | &nbsp;&nbsp;.&nbsp; | &nbsp;&nbsp;.&nbsp; | &nbsp;&nbsp;.&nbsp; | &nbsp;&nbsp;.&nbsp; | &nbsp;&nbsp;.&nbsp; | &nbsp;&nbsp;.&nbsp; | &nbsp;&nbsp;.&nbsp; | &nbsp;&nbsp;.&nbsp; | &nbsp;&nbsp;.&nbsp; | &nbsp;&nbsp;.&nbsp; | &nbsp;&nbsp;.&nbsp; | &nbsp;&nbsp;.&nbsp; | &nbsp;&nbsp;.&nbsp; | &nbsp;&nbsp;.&nbsp; | &nbsp;&nbsp;.&nbsp; | &nbsp;&nbsp;.&nbsp; | &nbsp;&nbsp;.&nbsp; | &nbsp;&nbsp;.&nbsp; | &nbsp;&nbsp;.&nbsp; | &nbsp;&nbsp;.&nbsp; | &nbsp;&nbsp;.&nbsp; | &nbsp;&nbsp;.&nbsp; | &nbsp;&nbsp;.&nbsp; | &nbsp;&nbsp;.&nbsp; | &nbsp;&nbsp;.&nbsp; | &nbsp;&nbsp;.&nbsp; | &nbsp;&nbsp;.&nbsp; | &nbsp;&nbsp;.&nbsp; | &nbsp;&nbsp;.&nbsp; | &nbsp;&nbsp;.&nbsp; | &nbsp;&nbsp;.&nbsp; | &nbsp;&nbsp;.&nbsp; | &nbsp;&nbsp;.&nbsp; | &nbsp;&nbsp;.&nbsp; | &nbsp;&nbsp;.&nbsp; | &nbsp;&nbsp;.&nbsp; | &nbsp;&nbsp;.&nbsp; | &nbsp;&nbsp;.&nbsp; | &nbsp;&nbsp;.&nbsp; | &nbsp;&nbsp;.&nbsp; | &nbsp;&nbsp;.&nbsp; | &nbsp;&nbsp;.&nbsp; | &nbsp;&nbsp;.&nbsp; | &nbsp;&nbsp;.&nbsp; |  &nbsp;&nbsp;24&nbsp; | &nbsp;&nbsp; Extrusion corner bracket 20mm for E2020t |
| &nbsp;&nbsp;.&nbsp; | &nbsp;&nbsp;.&nbsp; | &nbsp;&nbsp;.&nbsp; | &nbsp;&nbsp;.&nbsp; | &nbsp;&nbsp;.&nbsp; | &nbsp;&nbsp;.&nbsp; | &nbsp;&nbsp;.&nbsp; | &nbsp;&nbsp;.&nbsp; | &nbsp;&nbsp;.&nbsp; | &nbsp;&nbsp;.&nbsp; | &nbsp;&nbsp;.&nbsp; | &nbsp;&nbsp;.&nbsp; | &nbsp;&nbsp;.&nbsp; | &nbsp;&nbsp;.&nbsp; | &nbsp;&nbsp;.&nbsp; | &nbsp;&nbsp;.&nbsp; | &nbsp;&nbsp;.&nbsp; | &nbsp;&nbsp;.&nbsp; | &nbsp;&nbsp;.&nbsp; | &nbsp;&nbsp;.&nbsp; | &nbsp;&nbsp;.&nbsp; | &nbsp;&nbsp;.&nbsp; | &nbsp;&nbsp;.&nbsp; | &nbsp;&nbsp;.&nbsp; | &nbsp;&nbsp;.&nbsp; | &nbsp;&nbsp;.&nbsp; | &nbsp;&nbsp;.&nbsp; | &nbsp;&nbsp;.&nbsp; | &nbsp;&nbsp;.&nbsp; | &nbsp;&nbsp;.&nbsp; | &nbsp;&nbsp;.&nbsp; | &nbsp;&nbsp;.&nbsp; | &nbsp;&nbsp;.&nbsp; | &nbsp;&nbsp;.&nbsp; | &nbsp;&nbsp;.&nbsp; | &nbsp;&nbsp;.&nbsp; | &nbsp;&nbsp;.&nbsp; | &nbsp;&nbsp;.&nbsp; | &nbsp;&nbsp;.&nbsp; | &nbsp;&nbsp;.&nbsp; | &nbsp;&nbsp;.&nbsp; | &nbsp;&nbsp;1&nbsp; | &nbsp;&nbsp;.&nbsp; | &nbsp;&nbsp;.&nbsp; | &nbsp;&nbsp;.&nbsp; | &nbsp;&nbsp;.&nbsp; | &nbsp;&nbsp;.&nbsp; | &nbsp;&nbsp;.&nbsp; | &nbsp;&nbsp;.&nbsp; | &nbsp;&nbsp;.&nbsp; | &nbsp;&nbsp;.&nbsp; | &nbsp;&nbsp;.&nbsp; | &nbsp;&nbsp;.&nbsp; | &nbsp;&nbsp;.&nbsp; | &nbsp;&nbsp;.&nbsp; | &nbsp;&nbsp;.&nbsp; | &nbsp;&nbsp;.&nbsp; | &nbsp;&nbsp;1&nbsp; | &nbsp;&nbsp;.&nbsp; | &nbsp;&nbsp;.&nbsp; | &nbsp;&nbsp;.&nbsp; | &nbsp;&nbsp;.&nbsp; | &nbsp;&nbsp;.&nbsp; | &nbsp;&nbsp;.&nbsp; | &nbsp;&nbsp;.&nbsp; | &nbsp;&nbsp;.&nbsp; | &nbsp;&nbsp;.&nbsp; | &nbsp;&nbsp;.&nbsp; | &nbsp;&nbsp;.&nbsp; | &nbsp;&nbsp;.&nbsp; | &nbsp;&nbsp;.&nbsp; | &nbsp;&nbsp;.&nbsp; |  &nbsp;&nbsp;2&nbsp; | &nbsp;&nbsp; Extrusion inner corner bracket for E2020t |
| &nbsp;&nbsp;.&nbsp; | &nbsp;&nbsp;.&nbsp; | &nbsp;&nbsp;.&nbsp; | &nbsp;&nbsp;.&nbsp; | &nbsp;&nbsp;.&nbsp; | &nbsp;&nbsp;.&nbsp; | &nbsp;&nbsp;.&nbsp; | &nbsp;&nbsp;.&nbsp; | &nbsp;&nbsp;.&nbsp; | &nbsp;&nbsp;.&nbsp; | &nbsp;&nbsp;.&nbsp; | &nbsp;&nbsp;.&nbsp; | &nbsp;&nbsp;.&nbsp; | &nbsp;&nbsp;.&nbsp; | &nbsp;&nbsp;.&nbsp; | &nbsp;&nbsp;.&nbsp; | &nbsp;&nbsp;.&nbsp; | &nbsp;&nbsp;.&nbsp; | &nbsp;&nbsp;.&nbsp; | &nbsp;&nbsp;.&nbsp; | &nbsp;&nbsp;.&nbsp; | &nbsp;&nbsp;.&nbsp; | &nbsp;&nbsp;.&nbsp; | &nbsp;&nbsp;.&nbsp; | &nbsp;&nbsp;.&nbsp; | &nbsp;&nbsp;.&nbsp; | &nbsp;&nbsp;.&nbsp; | &nbsp;&nbsp;.&nbsp; | &nbsp;&nbsp;.&nbsp; | &nbsp;&nbsp;.&nbsp; | &nbsp;&nbsp;.&nbsp; | &nbsp;&nbsp;.&nbsp; | &nbsp;&nbsp;.&nbsp; | &nbsp;&nbsp;.&nbsp; | &nbsp;&nbsp;.&nbsp; | &nbsp;&nbsp;.&nbsp; | &nbsp;&nbsp;.&nbsp; | &nbsp;&nbsp;.&nbsp; | &nbsp;&nbsp;.&nbsp; | &nbsp;&nbsp;.&nbsp; | &nbsp;&nbsp;.&nbsp; | &nbsp;&nbsp;.&nbsp; | &nbsp;&nbsp;.&nbsp; | &nbsp;&nbsp;.&nbsp; | &nbsp;&nbsp;.&nbsp; | &nbsp;&nbsp;.&nbsp; | &nbsp;&nbsp;.&nbsp; | &nbsp;&nbsp;.&nbsp; | &nbsp;&nbsp;.&nbsp; | &nbsp;&nbsp;.&nbsp; | &nbsp;&nbsp;.&nbsp; | &nbsp;&nbsp;.&nbsp; | &nbsp;&nbsp;.&nbsp; | &nbsp;&nbsp;.&nbsp; | &nbsp;&nbsp;.&nbsp; | &nbsp;&nbsp;.&nbsp; | &nbsp;&nbsp;.&nbsp; | &nbsp;&nbsp;.&nbsp; | &nbsp;&nbsp;.&nbsp; | &nbsp;&nbsp;.&nbsp; | &nbsp;&nbsp;.&nbsp; | &nbsp;&nbsp;.&nbsp; | &nbsp;&nbsp;.&nbsp; | &nbsp;&nbsp;.&nbsp; | &nbsp;&nbsp;.&nbsp; | &nbsp;&nbsp;.&nbsp; | &nbsp;&nbsp;.&nbsp; | &nbsp;&nbsp;1&nbsp; | &nbsp;&nbsp;.&nbsp; | &nbsp;&nbsp;.&nbsp; | &nbsp;&nbsp;.&nbsp; | &nbsp;&nbsp;.&nbsp; |  &nbsp;&nbsp;1&nbsp; | &nbsp;&nbsp; Fan 30mm x 10mm |
| &nbsp;&nbsp;.&nbsp; | &nbsp;&nbsp;.&nbsp; | &nbsp;&nbsp;.&nbsp; | &nbsp;&nbsp;.&nbsp; | &nbsp;&nbsp;.&nbsp; | &nbsp;&nbsp;.&nbsp; | &nbsp;&nbsp;.&nbsp; | &nbsp;&nbsp;.&nbsp; | &nbsp;&nbsp;.&nbsp; | &nbsp;&nbsp;.&nbsp; | &nbsp;&nbsp;.&nbsp; | &nbsp;&nbsp;.&nbsp; | &nbsp;&nbsp;.&nbsp; | &nbsp;&nbsp;.&nbsp; | &nbsp;&nbsp;.&nbsp; | &nbsp;&nbsp;.&nbsp; | &nbsp;&nbsp;.&nbsp; | &nbsp;&nbsp;.&nbsp; | &nbsp;&nbsp;.&nbsp; | &nbsp;&nbsp;.&nbsp; | &nbsp;&nbsp;.&nbsp; | &nbsp;&nbsp;.&nbsp; | &nbsp;&nbsp;.&nbsp; | &nbsp;&nbsp;.&nbsp; | &nbsp;&nbsp;.&nbsp; | &nbsp;&nbsp;.&nbsp; | &nbsp;&nbsp;.&nbsp; | &nbsp;&nbsp;.&nbsp; | &nbsp;&nbsp;.&nbsp; | &nbsp;&nbsp;.&nbsp; | &nbsp;&nbsp;.&nbsp; | &nbsp;&nbsp;.&nbsp; | &nbsp;&nbsp;.&nbsp; | &nbsp;&nbsp;.&nbsp; | &nbsp;&nbsp;.&nbsp; | &nbsp;&nbsp;.&nbsp; | &nbsp;&nbsp;.&nbsp; | &nbsp;&nbsp;.&nbsp; | &nbsp;&nbsp;.&nbsp; | &nbsp;&nbsp;.&nbsp; | &nbsp;&nbsp;.&nbsp; | &nbsp;&nbsp;.&nbsp; | &nbsp;&nbsp;.&nbsp; | &nbsp;&nbsp;.&nbsp; | &nbsp;&nbsp;.&nbsp; | &nbsp;&nbsp;.&nbsp; | &nbsp;&nbsp;.&nbsp; | &nbsp;&nbsp;.&nbsp; | &nbsp;&nbsp;.&nbsp; | &nbsp;&nbsp;.&nbsp; | &nbsp;&nbsp;.&nbsp; | &nbsp;&nbsp;.&nbsp; | &nbsp;&nbsp;.&nbsp; | &nbsp;&nbsp;.&nbsp; | &nbsp;&nbsp;.&nbsp; | &nbsp;&nbsp;.&nbsp; | &nbsp;&nbsp;.&nbsp; | &nbsp;&nbsp;.&nbsp; | &nbsp;&nbsp;.&nbsp; | &nbsp;&nbsp;.&nbsp; | &nbsp;&nbsp;.&nbsp; | &nbsp;&nbsp;.&nbsp; | &nbsp;&nbsp;.&nbsp; | &nbsp;&nbsp;.&nbsp; | &nbsp;&nbsp;.&nbsp; | &nbsp;&nbsp;2&nbsp; | &nbsp;&nbsp;.&nbsp; | &nbsp;&nbsp;.&nbsp; | &nbsp;&nbsp;.&nbsp; | &nbsp;&nbsp;.&nbsp; | &nbsp;&nbsp;.&nbsp; | &nbsp;&nbsp;.&nbsp; |  &nbsp;&nbsp;2&nbsp; | &nbsp;&nbsp; Filament spool 200 x 60 |
| &nbsp;&nbsp;.&nbsp; | &nbsp;&nbsp;.&nbsp; | &nbsp;&nbsp;.&nbsp; | &nbsp;&nbsp;.&nbsp; | &nbsp;&nbsp;.&nbsp; | &nbsp;&nbsp;.&nbsp; | &nbsp;&nbsp;.&nbsp; | &nbsp;&nbsp;.&nbsp; | &nbsp;&nbsp;.&nbsp; | &nbsp;&nbsp;.&nbsp; | &nbsp;&nbsp;.&nbsp; | &nbsp;&nbsp;.&nbsp; | &nbsp;&nbsp;.&nbsp; | &nbsp;&nbsp;.&nbsp; | &nbsp;&nbsp;.&nbsp; | &nbsp;&nbsp;.&nbsp; | &nbsp;&nbsp;.&nbsp; | &nbsp;&nbsp;.&nbsp; | &nbsp;&nbsp;.&nbsp; | &nbsp;&nbsp;.&nbsp; | &nbsp;&nbsp;.&nbsp; | &nbsp;&nbsp;.&nbsp; | &nbsp;&nbsp;.&nbsp; | &nbsp;&nbsp;.&nbsp; | &nbsp;&nbsp;.&nbsp; | &nbsp;&nbsp;.&nbsp; | &nbsp;&nbsp;.&nbsp; | &nbsp;&nbsp;.&nbsp; | &nbsp;&nbsp;.&nbsp; | &nbsp;&nbsp;.&nbsp; | &nbsp;&nbsp;.&nbsp; | &nbsp;&nbsp;.&nbsp; | &nbsp;&nbsp;.&nbsp; | &nbsp;&nbsp;.&nbsp; | &nbsp;&nbsp;.&nbsp; | &nbsp;&nbsp;.&nbsp; | &nbsp;&nbsp;.&nbsp; | &nbsp;&nbsp;.&nbsp; | &nbsp;&nbsp;.&nbsp; | &nbsp;&nbsp;.&nbsp; | &nbsp;&nbsp;.&nbsp; | &nbsp;&nbsp;.&nbsp; | &nbsp;&nbsp;.&nbsp; | &nbsp;&nbsp;.&nbsp; | &nbsp;&nbsp;.&nbsp; | &nbsp;&nbsp;.&nbsp; | &nbsp;&nbsp;.&nbsp; | &nbsp;&nbsp;.&nbsp; | &nbsp;&nbsp;.&nbsp; | &nbsp;&nbsp;.&nbsp; | &nbsp;&nbsp;.&nbsp; | &nbsp;&nbsp;.&nbsp; | &nbsp;&nbsp;.&nbsp; | &nbsp;&nbsp;.&nbsp; | &nbsp;&nbsp;.&nbsp; | &nbsp;&nbsp;.&nbsp; | &nbsp;&nbsp;.&nbsp; | &nbsp;&nbsp;.&nbsp; | &nbsp;&nbsp;.&nbsp; | &nbsp;&nbsp;.&nbsp; | &nbsp;&nbsp;.&nbsp; | &nbsp;&nbsp;.&nbsp; | &nbsp;&nbsp;.&nbsp; | &nbsp;&nbsp;.&nbsp; | &nbsp;&nbsp;.&nbsp; | &nbsp;&nbsp;.&nbsp; | &nbsp;&nbsp;.&nbsp; | &nbsp;&nbsp;.&nbsp; | &nbsp;&nbsp;1&nbsp; | &nbsp;&nbsp;.&nbsp; | &nbsp;&nbsp;.&nbsp; | &nbsp;&nbsp;.&nbsp; |  &nbsp;&nbsp;1&nbsp; | &nbsp;&nbsp; GT2 1601.66 |
| &nbsp;&nbsp;.&nbsp; | &nbsp;&nbsp;.&nbsp; | &nbsp;&nbsp;.&nbsp; | &nbsp;&nbsp;.&nbsp; | &nbsp;&nbsp;.&nbsp; | &nbsp;&nbsp;.&nbsp; | &nbsp;&nbsp;.&nbsp; | &nbsp;&nbsp;.&nbsp; | &nbsp;&nbsp;.&nbsp; | &nbsp;&nbsp;.&nbsp; | &nbsp;&nbsp;.&nbsp; | &nbsp;&nbsp;.&nbsp; | &nbsp;&nbsp;.&nbsp; | &nbsp;&nbsp;.&nbsp; | &nbsp;&nbsp;.&nbsp; | &nbsp;&nbsp;.&nbsp; | &nbsp;&nbsp;.&nbsp; | &nbsp;&nbsp;.&nbsp; | &nbsp;&nbsp;.&nbsp; | &nbsp;&nbsp;.&nbsp; | &nbsp;&nbsp;.&nbsp; | &nbsp;&nbsp;.&nbsp; | &nbsp;&nbsp;.&nbsp; | &nbsp;&nbsp;.&nbsp; | &nbsp;&nbsp;.&nbsp; | &nbsp;&nbsp;.&nbsp; | &nbsp;&nbsp;.&nbsp; | &nbsp;&nbsp;.&nbsp; | &nbsp;&nbsp;.&nbsp; | &nbsp;&nbsp;.&nbsp; | &nbsp;&nbsp;.&nbsp; | &nbsp;&nbsp;.&nbsp; | &nbsp;&nbsp;.&nbsp; | &nbsp;&nbsp;.&nbsp; | &nbsp;&nbsp;.&nbsp; | &nbsp;&nbsp;.&nbsp; | &nbsp;&nbsp;.&nbsp; | &nbsp;&nbsp;.&nbsp; | &nbsp;&nbsp;.&nbsp; | &nbsp;&nbsp;.&nbsp; | &nbsp;&nbsp;.&nbsp; | &nbsp;&nbsp;.&nbsp; | &nbsp;&nbsp;.&nbsp; | &nbsp;&nbsp;.&nbsp; | &nbsp;&nbsp;.&nbsp; | &nbsp;&nbsp;.&nbsp; | &nbsp;&nbsp;.&nbsp; | &nbsp;&nbsp;.&nbsp; | &nbsp;&nbsp;.&nbsp; | &nbsp;&nbsp;.&nbsp; | &nbsp;&nbsp;.&nbsp; | &nbsp;&nbsp;.&nbsp; | &nbsp;&nbsp;.&nbsp; | &nbsp;&nbsp;.&nbsp; | &nbsp;&nbsp;.&nbsp; | &nbsp;&nbsp;.&nbsp; | &nbsp;&nbsp;.&nbsp; | &nbsp;&nbsp;.&nbsp; | &nbsp;&nbsp;.&nbsp; | &nbsp;&nbsp;.&nbsp; | &nbsp;&nbsp;.&nbsp; | &nbsp;&nbsp;.&nbsp; | &nbsp;&nbsp;.&nbsp; | &nbsp;&nbsp;.&nbsp; | &nbsp;&nbsp;.&nbsp; | &nbsp;&nbsp;.&nbsp; | &nbsp;&nbsp;.&nbsp; | &nbsp;&nbsp;.&nbsp; | &nbsp;&nbsp;1&nbsp; | &nbsp;&nbsp;.&nbsp; | &nbsp;&nbsp;.&nbsp; | &nbsp;&nbsp;.&nbsp; |  &nbsp;&nbsp;1&nbsp; | &nbsp;&nbsp; GT2 1609.36 |
| &nbsp;&nbsp;.&nbsp; | &nbsp;&nbsp;.&nbsp; | &nbsp;&nbsp;.&nbsp; | &nbsp;&nbsp;.&nbsp; | &nbsp;&nbsp;.&nbsp; | &nbsp;&nbsp;.&nbsp; | &nbsp;&nbsp;.&nbsp; | &nbsp;&nbsp;.&nbsp; | &nbsp;&nbsp;.&nbsp; | &nbsp;&nbsp;.&nbsp; | &nbsp;&nbsp;.&nbsp; | &nbsp;&nbsp;.&nbsp; | &nbsp;&nbsp;.&nbsp; | &nbsp;&nbsp;.&nbsp; | &nbsp;&nbsp;.&nbsp; | &nbsp;&nbsp;.&nbsp; | &nbsp;&nbsp;.&nbsp; | &nbsp;&nbsp;.&nbsp; | &nbsp;&nbsp;.&nbsp; | &nbsp;&nbsp;.&nbsp; | &nbsp;&nbsp;.&nbsp; | &nbsp;&nbsp;.&nbsp; | &nbsp;&nbsp;.&nbsp; | &nbsp;&nbsp;.&nbsp; | &nbsp;&nbsp;.&nbsp; | &nbsp;&nbsp;.&nbsp; | &nbsp;&nbsp;.&nbsp; | &nbsp;&nbsp;.&nbsp; | &nbsp;&nbsp;.&nbsp; | &nbsp;&nbsp;.&nbsp; | &nbsp;&nbsp;.&nbsp; | &nbsp;&nbsp;.&nbsp; | &nbsp;&nbsp;.&nbsp; | &nbsp;&nbsp;.&nbsp; | &nbsp;&nbsp;.&nbsp; | &nbsp;&nbsp;.&nbsp; | &nbsp;&nbsp;.&nbsp; | &nbsp;&nbsp;.&nbsp; | &nbsp;&nbsp;.&nbsp; | &nbsp;&nbsp;.&nbsp; | &nbsp;&nbsp;.&nbsp; | &nbsp;&nbsp;.&nbsp; | &nbsp;&nbsp;.&nbsp; | &nbsp;&nbsp;.&nbsp; | &nbsp;&nbsp;.&nbsp; | &nbsp;&nbsp;.&nbsp; | &nbsp;&nbsp;.&nbsp; | &nbsp;&nbsp;.&nbsp; | &nbsp;&nbsp;.&nbsp; | &nbsp;&nbsp;.&nbsp; | &nbsp;&nbsp;.&nbsp; | &nbsp;&nbsp;.&nbsp; | &nbsp;&nbsp;.&nbsp; | &nbsp;&nbsp;.&nbsp; | &nbsp;&nbsp;.&nbsp; | &nbsp;&nbsp;.&nbsp; | &nbsp;&nbsp;.&nbsp; | &nbsp;&nbsp;.&nbsp; | &nbsp;&nbsp;.&nbsp; | &nbsp;&nbsp;.&nbsp; | &nbsp;&nbsp;.&nbsp; | &nbsp;&nbsp;.&nbsp; | &nbsp;&nbsp;.&nbsp; | &nbsp;&nbsp;.&nbsp; | &nbsp;&nbsp;.&nbsp; | &nbsp;&nbsp;.&nbsp; | &nbsp;&nbsp;.&nbsp; | &nbsp;&nbsp;.&nbsp; | &nbsp;&nbsp;.&nbsp; | &nbsp;&nbsp;1&nbsp; | &nbsp;&nbsp;.&nbsp; | &nbsp;&nbsp;.&nbsp; |  &nbsp;&nbsp;1&nbsp; | &nbsp;&nbsp; IEC320 C14 switched fused inlet module |
| &nbsp;&nbsp;.&nbsp; | &nbsp;&nbsp;.&nbsp; | &nbsp;&nbsp;.&nbsp; | &nbsp;&nbsp;.&nbsp; | &nbsp;&nbsp;.&nbsp; | &nbsp;&nbsp;.&nbsp; | &nbsp;&nbsp;.&nbsp; | &nbsp;&nbsp;.&nbsp; | &nbsp;&nbsp;.&nbsp; | &nbsp;&nbsp;.&nbsp; | &nbsp;&nbsp;.&nbsp; | &nbsp;&nbsp;.&nbsp; | &nbsp;&nbsp;.&nbsp; | &nbsp;&nbsp;.&nbsp; | &nbsp;&nbsp;.&nbsp; | &nbsp;&nbsp;.&nbsp; | &nbsp;&nbsp;.&nbsp; | &nbsp;&nbsp;.&nbsp; | &nbsp;&nbsp;.&nbsp; | &nbsp;&nbsp;.&nbsp; | &nbsp;&nbsp;.&nbsp; | &nbsp;&nbsp;.&nbsp; | &nbsp;&nbsp;.&nbsp; | &nbsp;&nbsp;.&nbsp; | &nbsp;&nbsp;.&nbsp; | &nbsp;&nbsp;.&nbsp; | &nbsp;&nbsp;.&nbsp; | &nbsp;&nbsp;.&nbsp; | &nbsp;&nbsp;.&nbsp; | &nbsp;&nbsp;.&nbsp; | &nbsp;&nbsp;.&nbsp; | &nbsp;&nbsp;.&nbsp; | &nbsp;&nbsp;.&nbsp; | &nbsp;&nbsp;.&nbsp; | &nbsp;&nbsp;.&nbsp; | &nbsp;&nbsp;.&nbsp; | &nbsp;&nbsp;.&nbsp; | &nbsp;&nbsp;.&nbsp; | &nbsp;&nbsp;.&nbsp; | &nbsp;&nbsp;.&nbsp; | &nbsp;&nbsp;.&nbsp; | &nbsp;&nbsp;.&nbsp; | &nbsp;&nbsp;.&nbsp; | &nbsp;&nbsp;.&nbsp; | &nbsp;&nbsp;.&nbsp; | &nbsp;&nbsp;.&nbsp; | &nbsp;&nbsp;.&nbsp; | &nbsp;&nbsp;.&nbsp; | &nbsp;&nbsp;.&nbsp; | &nbsp;&nbsp;.&nbsp; | &nbsp;&nbsp;.&nbsp; | &nbsp;&nbsp;.&nbsp; | &nbsp;&nbsp;.&nbsp; | &nbsp;&nbsp;.&nbsp; | &nbsp;&nbsp;.&nbsp; | &nbsp;&nbsp;.&nbsp; | &nbsp;&nbsp;.&nbsp; | &nbsp;&nbsp;.&nbsp; | &nbsp;&nbsp;.&nbsp; | &nbsp;&nbsp;.&nbsp; | &nbsp;&nbsp;.&nbsp; | &nbsp;&nbsp;.&nbsp; | &nbsp;&nbsp;.&nbsp; | &nbsp;&nbsp;.&nbsp; | &nbsp;&nbsp;.&nbsp; | &nbsp;&nbsp;.&nbsp; | &nbsp;&nbsp;.&nbsp; | &nbsp;&nbsp;1&nbsp; | &nbsp;&nbsp;.&nbsp; | &nbsp;&nbsp;.&nbsp; | &nbsp;&nbsp;.&nbsp; | &nbsp;&nbsp;.&nbsp; |  &nbsp;&nbsp;1&nbsp; | &nbsp;&nbsp; Inductive Probe |
| &nbsp;&nbsp;.&nbsp; | &nbsp;&nbsp;2&nbsp; | &nbsp;&nbsp;.&nbsp; | &nbsp;&nbsp;.&nbsp; | &nbsp;&nbsp;.&nbsp; | &nbsp;&nbsp;.&nbsp; | &nbsp;&nbsp;.&nbsp; | &nbsp;&nbsp;.&nbsp; | &nbsp;&nbsp;.&nbsp; | &nbsp;&nbsp;.&nbsp; | &nbsp;&nbsp;.&nbsp; | &nbsp;&nbsp;.&nbsp; | &nbsp;&nbsp;.&nbsp; | &nbsp;&nbsp;.&nbsp; | &nbsp;&nbsp;.&nbsp; | &nbsp;&nbsp;.&nbsp; | &nbsp;&nbsp;.&nbsp; | &nbsp;&nbsp;.&nbsp; | &nbsp;&nbsp;.&nbsp; | &nbsp;&nbsp;.&nbsp; | &nbsp;&nbsp;.&nbsp; | &nbsp;&nbsp;.&nbsp; | &nbsp;&nbsp;.&nbsp; | &nbsp;&nbsp;.&nbsp; | &nbsp;&nbsp;.&nbsp; | &nbsp;&nbsp;.&nbsp; | &nbsp;&nbsp;.&nbsp; | &nbsp;&nbsp;.&nbsp; | &nbsp;&nbsp;.&nbsp; | &nbsp;&nbsp;.&nbsp; | &nbsp;&nbsp;.&nbsp; | &nbsp;&nbsp;.&nbsp; | &nbsp;&nbsp;.&nbsp; | &nbsp;&nbsp;.&nbsp; | &nbsp;&nbsp;.&nbsp; | &nbsp;&nbsp;.&nbsp; | &nbsp;&nbsp;.&nbsp; | &nbsp;&nbsp;.&nbsp; | &nbsp;&nbsp;.&nbsp; | &nbsp;&nbsp;.&nbsp; | &nbsp;&nbsp;.&nbsp; | &nbsp;&nbsp;.&nbsp; | &nbsp;&nbsp;.&nbsp; | &nbsp;&nbsp;.&nbsp; | &nbsp;&nbsp;.&nbsp; | &nbsp;&nbsp;.&nbsp; | &nbsp;&nbsp;.&nbsp; | &nbsp;&nbsp;.&nbsp; | &nbsp;&nbsp;.&nbsp; | &nbsp;&nbsp;.&nbsp; | &nbsp;&nbsp;.&nbsp; | &nbsp;&nbsp;.&nbsp; | &nbsp;&nbsp;.&nbsp; | &nbsp;&nbsp;.&nbsp; | &nbsp;&nbsp;.&nbsp; | &nbsp;&nbsp;.&nbsp; | &nbsp;&nbsp;.&nbsp; | &nbsp;&nbsp;.&nbsp; | &nbsp;&nbsp;.&nbsp; | &nbsp;&nbsp;.&nbsp; | &nbsp;&nbsp;.&nbsp; | &nbsp;&nbsp;.&nbsp; | &nbsp;&nbsp;.&nbsp; | &nbsp;&nbsp;.&nbsp; | &nbsp;&nbsp;.&nbsp; | &nbsp;&nbsp;.&nbsp; | &nbsp;&nbsp;.&nbsp; | &nbsp;&nbsp;.&nbsp; | &nbsp;&nbsp;.&nbsp; | &nbsp;&nbsp;.&nbsp; | &nbsp;&nbsp;.&nbsp; | &nbsp;&nbsp;.&nbsp; |  &nbsp;&nbsp;2&nbsp; | &nbsp;&nbsp; Leadscrew 8 x 250mm, 8mm lead, 4 starts |
| &nbsp;&nbsp;.&nbsp; | &nbsp;&nbsp;.&nbsp; | &nbsp;&nbsp;.&nbsp; | &nbsp;&nbsp;.&nbsp; | &nbsp;&nbsp;.&nbsp; | &nbsp;&nbsp;.&nbsp; | &nbsp;&nbsp;.&nbsp; | &nbsp;&nbsp;.&nbsp; | &nbsp;&nbsp;.&nbsp; | &nbsp;&nbsp;.&nbsp; | &nbsp;&nbsp;.&nbsp; | &nbsp;&nbsp;1&nbsp; | &nbsp;&nbsp;.&nbsp; | &nbsp;&nbsp;.&nbsp; | &nbsp;&nbsp;.&nbsp; | &nbsp;&nbsp;.&nbsp; | &nbsp;&nbsp;.&nbsp; | &nbsp;&nbsp;.&nbsp; | &nbsp;&nbsp;.&nbsp; | &nbsp;&nbsp;.&nbsp; | &nbsp;&nbsp;.&nbsp; | &nbsp;&nbsp;.&nbsp; | &nbsp;&nbsp;.&nbsp; | &nbsp;&nbsp;.&nbsp; | &nbsp;&nbsp;.&nbsp; | &nbsp;&nbsp;.&nbsp; | &nbsp;&nbsp;.&nbsp; | &nbsp;&nbsp;.&nbsp; | &nbsp;&nbsp;.&nbsp; | &nbsp;&nbsp;.&nbsp; | &nbsp;&nbsp;.&nbsp; | &nbsp;&nbsp;.&nbsp; | &nbsp;&nbsp;.&nbsp; | &nbsp;&nbsp;.&nbsp; | &nbsp;&nbsp;.&nbsp; | &nbsp;&nbsp;.&nbsp; | &nbsp;&nbsp;.&nbsp; | &nbsp;&nbsp;.&nbsp; | &nbsp;&nbsp;.&nbsp; | &nbsp;&nbsp;.&nbsp; | &nbsp;&nbsp;.&nbsp; | &nbsp;&nbsp;.&nbsp; | &nbsp;&nbsp;.&nbsp; | &nbsp;&nbsp;.&nbsp; | &nbsp;&nbsp;.&nbsp; | &nbsp;&nbsp;.&nbsp; | &nbsp;&nbsp;.&nbsp; | &nbsp;&nbsp;.&nbsp; | &nbsp;&nbsp;.&nbsp; | &nbsp;&nbsp;.&nbsp; | &nbsp;&nbsp;.&nbsp; | &nbsp;&nbsp;.&nbsp; | &nbsp;&nbsp;.&nbsp; | &nbsp;&nbsp;.&nbsp; | &nbsp;&nbsp;.&nbsp; | &nbsp;&nbsp;.&nbsp; | &nbsp;&nbsp;.&nbsp; | &nbsp;&nbsp;.&nbsp; | &nbsp;&nbsp;.&nbsp; | &nbsp;&nbsp;.&nbsp; | &nbsp;&nbsp;.&nbsp; | &nbsp;&nbsp;.&nbsp; | &nbsp;&nbsp;.&nbsp; | &nbsp;&nbsp;.&nbsp; | &nbsp;&nbsp;.&nbsp; | &nbsp;&nbsp;.&nbsp; | &nbsp;&nbsp;.&nbsp; | &nbsp;&nbsp;.&nbsp; | &nbsp;&nbsp;.&nbsp; | &nbsp;&nbsp;.&nbsp; | &nbsp;&nbsp;.&nbsp; | &nbsp;&nbsp;.&nbsp; |  &nbsp;&nbsp;1&nbsp; | &nbsp;&nbsp; Linear rail MGN12 x 400mm |
| &nbsp;&nbsp;.&nbsp; | &nbsp;&nbsp;.&nbsp; | &nbsp;&nbsp;.&nbsp; | &nbsp;&nbsp;.&nbsp; | &nbsp;&nbsp;.&nbsp; | &nbsp;&nbsp;.&nbsp; | &nbsp;&nbsp;.&nbsp; | &nbsp;&nbsp;.&nbsp; | &nbsp;&nbsp;.&nbsp; | &nbsp;&nbsp;.&nbsp; | &nbsp;&nbsp;.&nbsp; | &nbsp;&nbsp;.&nbsp; | &nbsp;&nbsp;.&nbsp; | &nbsp;&nbsp;.&nbsp; | &nbsp;&nbsp;.&nbsp; | &nbsp;&nbsp;.&nbsp; | &nbsp;&nbsp;.&nbsp; | &nbsp;&nbsp;.&nbsp; | &nbsp;&nbsp;.&nbsp; | &nbsp;&nbsp;.&nbsp; | &nbsp;&nbsp;.&nbsp; | &nbsp;&nbsp;.&nbsp; | &nbsp;&nbsp;.&nbsp; | &nbsp;&nbsp;.&nbsp; | &nbsp;&nbsp;2&nbsp; | &nbsp;&nbsp;.&nbsp; | &nbsp;&nbsp;.&nbsp; | &nbsp;&nbsp;.&nbsp; | &nbsp;&nbsp;.&nbsp; | &nbsp;&nbsp;.&nbsp; | &nbsp;&nbsp;.&nbsp; | &nbsp;&nbsp;2&nbsp; | &nbsp;&nbsp;.&nbsp; | &nbsp;&nbsp;.&nbsp; | &nbsp;&nbsp;.&nbsp; | &nbsp;&nbsp;.&nbsp; | &nbsp;&nbsp;.&nbsp; | &nbsp;&nbsp;.&nbsp; | &nbsp;&nbsp;.&nbsp; | &nbsp;&nbsp;.&nbsp; | &nbsp;&nbsp;.&nbsp; | &nbsp;&nbsp;.&nbsp; | &nbsp;&nbsp;.&nbsp; | &nbsp;&nbsp;.&nbsp; | &nbsp;&nbsp;.&nbsp; | &nbsp;&nbsp;.&nbsp; | &nbsp;&nbsp;.&nbsp; | &nbsp;&nbsp;.&nbsp; | &nbsp;&nbsp;.&nbsp; | &nbsp;&nbsp;.&nbsp; | &nbsp;&nbsp;.&nbsp; | &nbsp;&nbsp;.&nbsp; | &nbsp;&nbsp;.&nbsp; | &nbsp;&nbsp;.&nbsp; | &nbsp;&nbsp;.&nbsp; | &nbsp;&nbsp;.&nbsp; | &nbsp;&nbsp;.&nbsp; | &nbsp;&nbsp;.&nbsp; | &nbsp;&nbsp;.&nbsp; | &nbsp;&nbsp;.&nbsp; | &nbsp;&nbsp;.&nbsp; | &nbsp;&nbsp;.&nbsp; | &nbsp;&nbsp;.&nbsp; | &nbsp;&nbsp;.&nbsp; | &nbsp;&nbsp;.&nbsp; | &nbsp;&nbsp;.&nbsp; | &nbsp;&nbsp;.&nbsp; | &nbsp;&nbsp;.&nbsp; | &nbsp;&nbsp;.&nbsp; | &nbsp;&nbsp;.&nbsp; | &nbsp;&nbsp;.&nbsp; | &nbsp;&nbsp;.&nbsp; |  &nbsp;&nbsp;4&nbsp; | &nbsp;&nbsp; Linear rail MGN15 x 300mm |
| &nbsp;&nbsp;.&nbsp; | &nbsp;&nbsp;.&nbsp; | &nbsp;&nbsp;.&nbsp; | &nbsp;&nbsp;.&nbsp; | &nbsp;&nbsp;.&nbsp; | &nbsp;&nbsp;.&nbsp; | &nbsp;&nbsp;.&nbsp; | &nbsp;&nbsp;.&nbsp; | &nbsp;&nbsp;.&nbsp; | &nbsp;&nbsp;.&nbsp; | &nbsp;&nbsp;.&nbsp; | &nbsp;&nbsp;1&nbsp; | &nbsp;&nbsp;.&nbsp; | &nbsp;&nbsp;.&nbsp; | &nbsp;&nbsp;.&nbsp; | &nbsp;&nbsp;.&nbsp; | &nbsp;&nbsp;.&nbsp; | &nbsp;&nbsp;.&nbsp; | &nbsp;&nbsp;.&nbsp; | &nbsp;&nbsp;.&nbsp; | &nbsp;&nbsp;.&nbsp; | &nbsp;&nbsp;.&nbsp; | &nbsp;&nbsp;.&nbsp; | &nbsp;&nbsp;.&nbsp; | &nbsp;&nbsp;.&nbsp; | &nbsp;&nbsp;.&nbsp; | &nbsp;&nbsp;.&nbsp; | &nbsp;&nbsp;.&nbsp; | &nbsp;&nbsp;.&nbsp; | &nbsp;&nbsp;.&nbsp; | &nbsp;&nbsp;.&nbsp; | &nbsp;&nbsp;.&nbsp; | &nbsp;&nbsp;.&nbsp; | &nbsp;&nbsp;.&nbsp; | &nbsp;&nbsp;.&nbsp; | &nbsp;&nbsp;.&nbsp; | &nbsp;&nbsp;.&nbsp; | &nbsp;&nbsp;.&nbsp; | &nbsp;&nbsp;.&nbsp; | &nbsp;&nbsp;.&nbsp; | &nbsp;&nbsp;.&nbsp; | &nbsp;&nbsp;.&nbsp; | &nbsp;&nbsp;.&nbsp; | &nbsp;&nbsp;.&nbsp; | &nbsp;&nbsp;.&nbsp; | &nbsp;&nbsp;.&nbsp; | &nbsp;&nbsp;.&nbsp; | &nbsp;&nbsp;.&nbsp; | &nbsp;&nbsp;.&nbsp; | &nbsp;&nbsp;.&nbsp; | &nbsp;&nbsp;.&nbsp; | &nbsp;&nbsp;.&nbsp; | &nbsp;&nbsp;.&nbsp; | &nbsp;&nbsp;.&nbsp; | &nbsp;&nbsp;.&nbsp; | &nbsp;&nbsp;.&nbsp; | &nbsp;&nbsp;.&nbsp; | &nbsp;&nbsp;.&nbsp; | &nbsp;&nbsp;.&nbsp; | &nbsp;&nbsp;.&nbsp; | &nbsp;&nbsp;.&nbsp; | &nbsp;&nbsp;.&nbsp; | &nbsp;&nbsp;.&nbsp; | &nbsp;&nbsp;.&nbsp; | &nbsp;&nbsp;.&nbsp; | &nbsp;&nbsp;.&nbsp; | &nbsp;&nbsp;.&nbsp; | &nbsp;&nbsp;.&nbsp; | &nbsp;&nbsp;.&nbsp; | &nbsp;&nbsp;.&nbsp; | &nbsp;&nbsp;.&nbsp; | &nbsp;&nbsp;.&nbsp; |  &nbsp;&nbsp;1&nbsp; | &nbsp;&nbsp; Linear rail carriage MGN12H |
| &nbsp;&nbsp;.&nbsp; | &nbsp;&nbsp;.&nbsp; | &nbsp;&nbsp;.&nbsp; | &nbsp;&nbsp;.&nbsp; | &nbsp;&nbsp;.&nbsp; | &nbsp;&nbsp;.&nbsp; | &nbsp;&nbsp;.&nbsp; | &nbsp;&nbsp;.&nbsp; | &nbsp;&nbsp;.&nbsp; | &nbsp;&nbsp;.&nbsp; | &nbsp;&nbsp;.&nbsp; | &nbsp;&nbsp;.&nbsp; | &nbsp;&nbsp;.&nbsp; | &nbsp;&nbsp;.&nbsp; | &nbsp;&nbsp;.&nbsp; | &nbsp;&nbsp;.&nbsp; | &nbsp;&nbsp;.&nbsp; | &nbsp;&nbsp;.&nbsp; | &nbsp;&nbsp;.&nbsp; | &nbsp;&nbsp;.&nbsp; | &nbsp;&nbsp;.&nbsp; | &nbsp;&nbsp;.&nbsp; | &nbsp;&nbsp;.&nbsp; | &nbsp;&nbsp;.&nbsp; | &nbsp;&nbsp;2&nbsp; | &nbsp;&nbsp;.&nbsp; | &nbsp;&nbsp;.&nbsp; | &nbsp;&nbsp;.&nbsp; | &nbsp;&nbsp;.&nbsp; | &nbsp;&nbsp;.&nbsp; | &nbsp;&nbsp;2&nbsp; | &nbsp;&nbsp;.&nbsp; | &nbsp;&nbsp;.&nbsp; | &nbsp;&nbsp;.&nbsp; | &nbsp;&nbsp;.&nbsp; | &nbsp;&nbsp;.&nbsp; | &nbsp;&nbsp;.&nbsp; | &nbsp;&nbsp;.&nbsp; | &nbsp;&nbsp;.&nbsp; | &nbsp;&nbsp;.&nbsp; | &nbsp;&nbsp;.&nbsp; | &nbsp;&nbsp;.&nbsp; | &nbsp;&nbsp;.&nbsp; | &nbsp;&nbsp;.&nbsp; | &nbsp;&nbsp;.&nbsp; | &nbsp;&nbsp;.&nbsp; | &nbsp;&nbsp;.&nbsp; | &nbsp;&nbsp;.&nbsp; | &nbsp;&nbsp;.&nbsp; | &nbsp;&nbsp;.&nbsp; | &nbsp;&nbsp;.&nbsp; | &nbsp;&nbsp;.&nbsp; | &nbsp;&nbsp;.&nbsp; | &nbsp;&nbsp;.&nbsp; | &nbsp;&nbsp;.&nbsp; | &nbsp;&nbsp;.&nbsp; | &nbsp;&nbsp;.&nbsp; | &nbsp;&nbsp;.&nbsp; | &nbsp;&nbsp;.&nbsp; | &nbsp;&nbsp;.&nbsp; | &nbsp;&nbsp;.&nbsp; | &nbsp;&nbsp;.&nbsp; | &nbsp;&nbsp;.&nbsp; | &nbsp;&nbsp;.&nbsp; | &nbsp;&nbsp;.&nbsp; | &nbsp;&nbsp;.&nbsp; | &nbsp;&nbsp;.&nbsp; | &nbsp;&nbsp;.&nbsp; | &nbsp;&nbsp;.&nbsp; | &nbsp;&nbsp;.&nbsp; | &nbsp;&nbsp;.&nbsp; | &nbsp;&nbsp;.&nbsp; |  &nbsp;&nbsp;4&nbsp; | &nbsp;&nbsp; Linear rail carriage MGN15H |
| &nbsp;&nbsp;.&nbsp; | &nbsp;&nbsp;.&nbsp; | &nbsp;&nbsp;.&nbsp; | &nbsp;&nbsp;.&nbsp; | &nbsp;&nbsp;.&nbsp; | &nbsp;&nbsp;.&nbsp; | &nbsp;&nbsp;.&nbsp; | &nbsp;&nbsp;.&nbsp; | &nbsp;&nbsp;.&nbsp; | &nbsp;&nbsp;.&nbsp; | &nbsp;&nbsp;.&nbsp; | &nbsp;&nbsp;.&nbsp; | &nbsp;&nbsp;.&nbsp; | &nbsp;&nbsp;.&nbsp; | &nbsp;&nbsp;.&nbsp; | &nbsp;&nbsp;.&nbsp; | &nbsp;&nbsp;.&nbsp; | &nbsp;&nbsp;.&nbsp; | &nbsp;&nbsp;.&nbsp; | &nbsp;&nbsp;.&nbsp; | &nbsp;&nbsp;.&nbsp; | &nbsp;&nbsp;.&nbsp; | &nbsp;&nbsp;.&nbsp; | &nbsp;&nbsp;.&nbsp; | &nbsp;&nbsp;.&nbsp; | &nbsp;&nbsp;.&nbsp; | &nbsp;&nbsp;.&nbsp; | &nbsp;&nbsp;.&nbsp; | &nbsp;&nbsp;.&nbsp; | &nbsp;&nbsp;.&nbsp; | &nbsp;&nbsp;.&nbsp; | &nbsp;&nbsp;.&nbsp; | &nbsp;&nbsp;.&nbsp; | &nbsp;&nbsp;.&nbsp; | &nbsp;&nbsp;.&nbsp; | &nbsp;&nbsp;.&nbsp; | &nbsp;&nbsp;.&nbsp; | &nbsp;&nbsp;.&nbsp; | &nbsp;&nbsp;.&nbsp; | &nbsp;&nbsp;.&nbsp; | &nbsp;&nbsp;.&nbsp; | &nbsp;&nbsp;.&nbsp; | &nbsp;&nbsp;.&nbsp; | &nbsp;&nbsp;.&nbsp; | &nbsp;&nbsp;.&nbsp; | &nbsp;&nbsp;.&nbsp; | &nbsp;&nbsp;.&nbsp; | &nbsp;&nbsp;.&nbsp; | &nbsp;&nbsp;.&nbsp; | &nbsp;&nbsp;.&nbsp; | &nbsp;&nbsp;.&nbsp; | &nbsp;&nbsp;.&nbsp; | &nbsp;&nbsp;.&nbsp; | &nbsp;&nbsp;.&nbsp; | &nbsp;&nbsp;.&nbsp; | &nbsp;&nbsp;.&nbsp; | &nbsp;&nbsp;.&nbsp; | &nbsp;&nbsp;.&nbsp; | &nbsp;&nbsp;.&nbsp; | &nbsp;&nbsp;.&nbsp; | &nbsp;&nbsp;.&nbsp; | &nbsp;&nbsp;.&nbsp; | &nbsp;&nbsp;.&nbsp; | &nbsp;&nbsp;.&nbsp; | &nbsp;&nbsp;.&nbsp; | &nbsp;&nbsp;.&nbsp; | &nbsp;&nbsp;.&nbsp; | &nbsp;&nbsp;.&nbsp; | &nbsp;&nbsp;.&nbsp; | &nbsp;&nbsp;.&nbsp; | &nbsp;&nbsp;1&nbsp; | &nbsp;&nbsp;.&nbsp; |  &nbsp;&nbsp;1&nbsp; | &nbsp;&nbsp; Micro SD card |
| &nbsp;&nbsp;.&nbsp; | &nbsp;&nbsp;.&nbsp; | &nbsp;&nbsp;.&nbsp; | &nbsp;&nbsp;.&nbsp; | &nbsp;&nbsp;.&nbsp; | &nbsp;&nbsp;.&nbsp; | &nbsp;&nbsp;.&nbsp; | &nbsp;&nbsp;.&nbsp; | &nbsp;&nbsp;1&nbsp; | &nbsp;&nbsp;.&nbsp; | &nbsp;&nbsp;.&nbsp; | &nbsp;&nbsp;.&nbsp; | &nbsp;&nbsp;.&nbsp; | &nbsp;&nbsp;.&nbsp; | &nbsp;&nbsp;.&nbsp; | &nbsp;&nbsp;.&nbsp; | &nbsp;&nbsp;.&nbsp; | &nbsp;&nbsp;.&nbsp; | &nbsp;&nbsp;.&nbsp; | &nbsp;&nbsp;.&nbsp; | &nbsp;&nbsp;.&nbsp; | &nbsp;&nbsp;.&nbsp; | &nbsp;&nbsp;.&nbsp; | &nbsp;&nbsp;1&nbsp; | &nbsp;&nbsp;.&nbsp; | &nbsp;&nbsp;.&nbsp; | &nbsp;&nbsp;.&nbsp; | &nbsp;&nbsp;.&nbsp; | &nbsp;&nbsp;.&nbsp; | &nbsp;&nbsp;.&nbsp; | &nbsp;&nbsp;.&nbsp; | &nbsp;&nbsp;.&nbsp; | &nbsp;&nbsp;.&nbsp; | &nbsp;&nbsp;.&nbsp; | &nbsp;&nbsp;.&nbsp; | &nbsp;&nbsp;.&nbsp; | &nbsp;&nbsp;.&nbsp; | &nbsp;&nbsp;.&nbsp; | &nbsp;&nbsp;.&nbsp; | &nbsp;&nbsp;.&nbsp; | &nbsp;&nbsp;.&nbsp; | &nbsp;&nbsp;.&nbsp; | &nbsp;&nbsp;.&nbsp; | &nbsp;&nbsp;.&nbsp; | &nbsp;&nbsp;.&nbsp; | &nbsp;&nbsp;.&nbsp; | &nbsp;&nbsp;.&nbsp; | &nbsp;&nbsp;.&nbsp; | &nbsp;&nbsp;.&nbsp; | &nbsp;&nbsp;.&nbsp; | &nbsp;&nbsp;.&nbsp; | &nbsp;&nbsp;.&nbsp; | &nbsp;&nbsp;.&nbsp; | &nbsp;&nbsp;.&nbsp; | &nbsp;&nbsp;.&nbsp; | &nbsp;&nbsp;.&nbsp; | &nbsp;&nbsp;.&nbsp; | &nbsp;&nbsp;.&nbsp; | &nbsp;&nbsp;.&nbsp; | &nbsp;&nbsp;.&nbsp; | &nbsp;&nbsp;.&nbsp; | &nbsp;&nbsp;.&nbsp; | &nbsp;&nbsp;.&nbsp; | &nbsp;&nbsp;.&nbsp; | &nbsp;&nbsp;.&nbsp; | &nbsp;&nbsp;.&nbsp; | &nbsp;&nbsp;.&nbsp; | &nbsp;&nbsp;.&nbsp; | &nbsp;&nbsp;.&nbsp; | &nbsp;&nbsp;.&nbsp; | &nbsp;&nbsp;.&nbsp; | &nbsp;&nbsp;.&nbsp; |  &nbsp;&nbsp;2&nbsp; | &nbsp;&nbsp; Microswitch SS-01 or SS-5GL |
| &nbsp;&nbsp;.&nbsp; | &nbsp;&nbsp;.&nbsp; | &nbsp;&nbsp;.&nbsp; | &nbsp;&nbsp;.&nbsp; | &nbsp;&nbsp;.&nbsp; | &nbsp;&nbsp;.&nbsp; | &nbsp;&nbsp;.&nbsp; | &nbsp;&nbsp;.&nbsp; | &nbsp;&nbsp;.&nbsp; | &nbsp;&nbsp;.&nbsp; | &nbsp;&nbsp;.&nbsp; | &nbsp;&nbsp;.&nbsp; | &nbsp;&nbsp;.&nbsp; | &nbsp;&nbsp;.&nbsp; | &nbsp;&nbsp;.&nbsp; | &nbsp;&nbsp;.&nbsp; | &nbsp;&nbsp;.&nbsp; | &nbsp;&nbsp;.&nbsp; | &nbsp;&nbsp;.&nbsp; | &nbsp;&nbsp;.&nbsp; | &nbsp;&nbsp;.&nbsp; | &nbsp;&nbsp;.&nbsp; | &nbsp;&nbsp;.&nbsp; | &nbsp;&nbsp;.&nbsp; | &nbsp;&nbsp;.&nbsp; | &nbsp;&nbsp;.&nbsp; | &nbsp;&nbsp;.&nbsp; | &nbsp;&nbsp;.&nbsp; | &nbsp;&nbsp;.&nbsp; | &nbsp;&nbsp;.&nbsp; | &nbsp;&nbsp;.&nbsp; | &nbsp;&nbsp;.&nbsp; | &nbsp;&nbsp;.&nbsp; | &nbsp;&nbsp;.&nbsp; | &nbsp;&nbsp;.&nbsp; | &nbsp;&nbsp;.&nbsp; | &nbsp;&nbsp;.&nbsp; | &nbsp;&nbsp;.&nbsp; | &nbsp;&nbsp;.&nbsp; | &nbsp;&nbsp;.&nbsp; | &nbsp;&nbsp;.&nbsp; | &nbsp;&nbsp;.&nbsp; | &nbsp;&nbsp;.&nbsp; | &nbsp;&nbsp;.&nbsp; | &nbsp;&nbsp;.&nbsp; | &nbsp;&nbsp;.&nbsp; | &nbsp;&nbsp;.&nbsp; | &nbsp;&nbsp;.&nbsp; | &nbsp;&nbsp;.&nbsp; | &nbsp;&nbsp;.&nbsp; | &nbsp;&nbsp;.&nbsp; | &nbsp;&nbsp;.&nbsp; | &nbsp;&nbsp;.&nbsp; | &nbsp;&nbsp;.&nbsp; | &nbsp;&nbsp;.&nbsp; | &nbsp;&nbsp;.&nbsp; | &nbsp;&nbsp;.&nbsp; | &nbsp;&nbsp;.&nbsp; | &nbsp;&nbsp;.&nbsp; | &nbsp;&nbsp;.&nbsp; | &nbsp;&nbsp;.&nbsp; | &nbsp;&nbsp;.&nbsp; | &nbsp;&nbsp;.&nbsp; | &nbsp;&nbsp;.&nbsp; | &nbsp;&nbsp;.&nbsp; | &nbsp;&nbsp;.&nbsp; | &nbsp;&nbsp;.&nbsp; | &nbsp;&nbsp;2&nbsp; | &nbsp;&nbsp;.&nbsp; | &nbsp;&nbsp;.&nbsp; | &nbsp;&nbsp;.&nbsp; | &nbsp;&nbsp;.&nbsp; |  &nbsp;&nbsp;2&nbsp; | &nbsp;&nbsp; Nut M12 x 4mm  |
| &nbsp;&nbsp;.&nbsp; | &nbsp;&nbsp;.&nbsp; | &nbsp;&nbsp;.&nbsp; | &nbsp;&nbsp;.&nbsp; | &nbsp;&nbsp;.&nbsp; | &nbsp;&nbsp;.&nbsp; | &nbsp;&nbsp;.&nbsp; | &nbsp;&nbsp;.&nbsp; | &nbsp;&nbsp;.&nbsp; | &nbsp;&nbsp;.&nbsp; | &nbsp;&nbsp;.&nbsp; | &nbsp;&nbsp;16&nbsp; | &nbsp;&nbsp;.&nbsp; | &nbsp;&nbsp;.&nbsp; | &nbsp;&nbsp;.&nbsp; | &nbsp;&nbsp;.&nbsp; | &nbsp;&nbsp;.&nbsp; | &nbsp;&nbsp;.&nbsp; | &nbsp;&nbsp;.&nbsp; | &nbsp;&nbsp;.&nbsp; | &nbsp;&nbsp;.&nbsp; | &nbsp;&nbsp;.&nbsp; | &nbsp;&nbsp;.&nbsp; | &nbsp;&nbsp;.&nbsp; | &nbsp;&nbsp;.&nbsp; | &nbsp;&nbsp;.&nbsp; | &nbsp;&nbsp;.&nbsp; | &nbsp;&nbsp;.&nbsp; | &nbsp;&nbsp;.&nbsp; | &nbsp;&nbsp;.&nbsp; | &nbsp;&nbsp;.&nbsp; | &nbsp;&nbsp;.&nbsp; | &nbsp;&nbsp;.&nbsp; | &nbsp;&nbsp;.&nbsp; | &nbsp;&nbsp;.&nbsp; | &nbsp;&nbsp;.&nbsp; | &nbsp;&nbsp;.&nbsp; | &nbsp;&nbsp;.&nbsp; | &nbsp;&nbsp;.&nbsp; | &nbsp;&nbsp;.&nbsp; | &nbsp;&nbsp;.&nbsp; | &nbsp;&nbsp;.&nbsp; | &nbsp;&nbsp;.&nbsp; | &nbsp;&nbsp;.&nbsp; | &nbsp;&nbsp;.&nbsp; | &nbsp;&nbsp;.&nbsp; | &nbsp;&nbsp;.&nbsp; | &nbsp;&nbsp;.&nbsp; | &nbsp;&nbsp;.&nbsp; | &nbsp;&nbsp;.&nbsp; | &nbsp;&nbsp;.&nbsp; | &nbsp;&nbsp;.&nbsp; | &nbsp;&nbsp;.&nbsp; | &nbsp;&nbsp;.&nbsp; | &nbsp;&nbsp;.&nbsp; | &nbsp;&nbsp;.&nbsp; | &nbsp;&nbsp;.&nbsp; | &nbsp;&nbsp;.&nbsp; | &nbsp;&nbsp;.&nbsp; | &nbsp;&nbsp;.&nbsp; | &nbsp;&nbsp;.&nbsp; | &nbsp;&nbsp;.&nbsp; | &nbsp;&nbsp;.&nbsp; | &nbsp;&nbsp;.&nbsp; | &nbsp;&nbsp;.&nbsp; | &nbsp;&nbsp;.&nbsp; | &nbsp;&nbsp;.&nbsp; | &nbsp;&nbsp;.&nbsp; | &nbsp;&nbsp;.&nbsp; | &nbsp;&nbsp;.&nbsp; | &nbsp;&nbsp;.&nbsp; | &nbsp;&nbsp;.&nbsp; |  &nbsp;&nbsp;16&nbsp; | &nbsp;&nbsp; Nut M3 sliding T |
| &nbsp;&nbsp;1&nbsp; | &nbsp;&nbsp;.&nbsp; | &nbsp;&nbsp;.&nbsp; | &nbsp;&nbsp;.&nbsp; | &nbsp;&nbsp;.&nbsp; | &nbsp;&nbsp;.&nbsp; | &nbsp;&nbsp;2&nbsp; | &nbsp;&nbsp;2&nbsp; | &nbsp;&nbsp;5&nbsp; | &nbsp;&nbsp;7&nbsp; | &nbsp;&nbsp;2&nbsp; | &nbsp;&nbsp;.&nbsp; | &nbsp;&nbsp;.&nbsp; | &nbsp;&nbsp;.&nbsp; | &nbsp;&nbsp;2&nbsp; | &nbsp;&nbsp;.&nbsp; | &nbsp;&nbsp;.&nbsp; | &nbsp;&nbsp;.&nbsp; | &nbsp;&nbsp;.&nbsp; | &nbsp;&nbsp;.&nbsp; | &nbsp;&nbsp;.&nbsp; | &nbsp;&nbsp;.&nbsp; | &nbsp;&nbsp;.&nbsp; | &nbsp;&nbsp;.&nbsp; | &nbsp;&nbsp;.&nbsp; | &nbsp;&nbsp;.&nbsp; | &nbsp;&nbsp;.&nbsp; | &nbsp;&nbsp;.&nbsp; | &nbsp;&nbsp;.&nbsp; | &nbsp;&nbsp;.&nbsp; | &nbsp;&nbsp;.&nbsp; | &nbsp;&nbsp;.&nbsp; | &nbsp;&nbsp;.&nbsp; | &nbsp;&nbsp;.&nbsp; | &nbsp;&nbsp;.&nbsp; | &nbsp;&nbsp;.&nbsp; | &nbsp;&nbsp;.&nbsp; | &nbsp;&nbsp;.&nbsp; | &nbsp;&nbsp;.&nbsp; | &nbsp;&nbsp;.&nbsp; | &nbsp;&nbsp;1&nbsp; | &nbsp;&nbsp;.&nbsp; | &nbsp;&nbsp;.&nbsp; | &nbsp;&nbsp;.&nbsp; | &nbsp;&nbsp;.&nbsp; | &nbsp;&nbsp;.&nbsp; | &nbsp;&nbsp;.&nbsp; | &nbsp;&nbsp;.&nbsp; | &nbsp;&nbsp;.&nbsp; | &nbsp;&nbsp;.&nbsp; | &nbsp;&nbsp;.&nbsp; | &nbsp;&nbsp;.&nbsp; | &nbsp;&nbsp;.&nbsp; | &nbsp;&nbsp;.&nbsp; | &nbsp;&nbsp;.&nbsp; | &nbsp;&nbsp;.&nbsp; | &nbsp;&nbsp;1&nbsp; | &nbsp;&nbsp;.&nbsp; | &nbsp;&nbsp;.&nbsp; | &nbsp;&nbsp;.&nbsp; | &nbsp;&nbsp;.&nbsp; | &nbsp;&nbsp;.&nbsp; | &nbsp;&nbsp;.&nbsp; | &nbsp;&nbsp;.&nbsp; | &nbsp;&nbsp;.&nbsp; | &nbsp;&nbsp;.&nbsp; | &nbsp;&nbsp;.&nbsp; | &nbsp;&nbsp;2&nbsp; | &nbsp;&nbsp;.&nbsp; | &nbsp;&nbsp;.&nbsp; | &nbsp;&nbsp;4&nbsp; | &nbsp;&nbsp;.&nbsp; |  &nbsp;&nbsp;29&nbsp; | &nbsp;&nbsp; Nut M3 x 2.4mm  |
| &nbsp;&nbsp;.&nbsp; | &nbsp;&nbsp;.&nbsp; | &nbsp;&nbsp;.&nbsp; | &nbsp;&nbsp;.&nbsp; | &nbsp;&nbsp;4&nbsp; | &nbsp;&nbsp;.&nbsp; | &nbsp;&nbsp;2&nbsp; | &nbsp;&nbsp;2&nbsp; | &nbsp;&nbsp;.&nbsp; | &nbsp;&nbsp;.&nbsp; | &nbsp;&nbsp;.&nbsp; | &nbsp;&nbsp;.&nbsp; | &nbsp;&nbsp;.&nbsp; | &nbsp;&nbsp;.&nbsp; | &nbsp;&nbsp;.&nbsp; | &nbsp;&nbsp;.&nbsp; | &nbsp;&nbsp;6&nbsp; | &nbsp;&nbsp;.&nbsp; | &nbsp;&nbsp;48&nbsp; | &nbsp;&nbsp;2&nbsp; | &nbsp;&nbsp;3&nbsp; | &nbsp;&nbsp;28&nbsp; | &nbsp;&nbsp;3&nbsp; | &nbsp;&nbsp;1&nbsp; | &nbsp;&nbsp;16&nbsp; | &nbsp;&nbsp;.&nbsp; | &nbsp;&nbsp;.&nbsp; | &nbsp;&nbsp;20&nbsp; | &nbsp;&nbsp;20&nbsp; | &nbsp;&nbsp;6&nbsp; | &nbsp;&nbsp;.&nbsp; | &nbsp;&nbsp;16&nbsp; | &nbsp;&nbsp;.&nbsp; | &nbsp;&nbsp;.&nbsp; | &nbsp;&nbsp;2&nbsp; | &nbsp;&nbsp;.&nbsp; | &nbsp;&nbsp;.&nbsp; | &nbsp;&nbsp;.&nbsp; | &nbsp;&nbsp;.&nbsp; | &nbsp;&nbsp;.&nbsp; | &nbsp;&nbsp;3&nbsp; | &nbsp;&nbsp;4&nbsp; | &nbsp;&nbsp;.&nbsp; | &nbsp;&nbsp;.&nbsp; | &nbsp;&nbsp;.&nbsp; | &nbsp;&nbsp;4&nbsp; | &nbsp;&nbsp;4&nbsp; | &nbsp;&nbsp;2&nbsp; | &nbsp;&nbsp;3&nbsp; | &nbsp;&nbsp;3&nbsp; | &nbsp;&nbsp;.&nbsp; | &nbsp;&nbsp;.&nbsp; | &nbsp;&nbsp;.&nbsp; | &nbsp;&nbsp;.&nbsp; | &nbsp;&nbsp;.&nbsp; | &nbsp;&nbsp;.&nbsp; | &nbsp;&nbsp;3&nbsp; | &nbsp;&nbsp;4&nbsp; | &nbsp;&nbsp;.&nbsp; | &nbsp;&nbsp;4&nbsp; | &nbsp;&nbsp;.&nbsp; | &nbsp;&nbsp;4&nbsp; | &nbsp;&nbsp;.&nbsp; | &nbsp;&nbsp;.&nbsp; | &nbsp;&nbsp;.&nbsp; | &nbsp;&nbsp;.&nbsp; | &nbsp;&nbsp;.&nbsp; | &nbsp;&nbsp;.&nbsp; | &nbsp;&nbsp;.&nbsp; | &nbsp;&nbsp;.&nbsp; | &nbsp;&nbsp;.&nbsp; | &nbsp;&nbsp;.&nbsp; |  &nbsp;&nbsp;217&nbsp; | &nbsp;&nbsp; Nut M4 sliding T |
| &nbsp;&nbsp;.&nbsp; | &nbsp;&nbsp;.&nbsp; | &nbsp;&nbsp;.&nbsp; | &nbsp;&nbsp;.&nbsp; | &nbsp;&nbsp;.&nbsp; | &nbsp;&nbsp;.&nbsp; | &nbsp;&nbsp;.&nbsp; | &nbsp;&nbsp;.&nbsp; | &nbsp;&nbsp;.&nbsp; | &nbsp;&nbsp;.&nbsp; | &nbsp;&nbsp;.&nbsp; | &nbsp;&nbsp;.&nbsp; | &nbsp;&nbsp;.&nbsp; | &nbsp;&nbsp;.&nbsp; | &nbsp;&nbsp;.&nbsp; | &nbsp;&nbsp;.&nbsp; | &nbsp;&nbsp;.&nbsp; | &nbsp;&nbsp;4&nbsp; | &nbsp;&nbsp;.&nbsp; | &nbsp;&nbsp;.&nbsp; | &nbsp;&nbsp;.&nbsp; | &nbsp;&nbsp;.&nbsp; | &nbsp;&nbsp;.&nbsp; | &nbsp;&nbsp;.&nbsp; | &nbsp;&nbsp;.&nbsp; | &nbsp;&nbsp;.&nbsp; | &nbsp;&nbsp;.&nbsp; | &nbsp;&nbsp;.&nbsp; | &nbsp;&nbsp;.&nbsp; | &nbsp;&nbsp;.&nbsp; | &nbsp;&nbsp;.&nbsp; | &nbsp;&nbsp;.&nbsp; | &nbsp;&nbsp;.&nbsp; | &nbsp;&nbsp;8&nbsp; | &nbsp;&nbsp;.&nbsp; | &nbsp;&nbsp;12&nbsp; | &nbsp;&nbsp;.&nbsp; | &nbsp;&nbsp;.&nbsp; | &nbsp;&nbsp;.&nbsp; | &nbsp;&nbsp;.&nbsp; | &nbsp;&nbsp;.&nbsp; | &nbsp;&nbsp;.&nbsp; | &nbsp;&nbsp;.&nbsp; | &nbsp;&nbsp;.&nbsp; | &nbsp;&nbsp;.&nbsp; | &nbsp;&nbsp;2&nbsp; | &nbsp;&nbsp;.&nbsp; | &nbsp;&nbsp;.&nbsp; | &nbsp;&nbsp;.&nbsp; | &nbsp;&nbsp;.&nbsp; | &nbsp;&nbsp;.&nbsp; | &nbsp;&nbsp;.&nbsp; | &nbsp;&nbsp;.&nbsp; | &nbsp;&nbsp;.&nbsp; | &nbsp;&nbsp;.&nbsp; | &nbsp;&nbsp;.&nbsp; | &nbsp;&nbsp;.&nbsp; | &nbsp;&nbsp;.&nbsp; | &nbsp;&nbsp;.&nbsp; | &nbsp;&nbsp;.&nbsp; | &nbsp;&nbsp;.&nbsp; | &nbsp;&nbsp;2&nbsp; | &nbsp;&nbsp;.&nbsp; | &nbsp;&nbsp;.&nbsp; | &nbsp;&nbsp;.&nbsp; | &nbsp;&nbsp;.&nbsp; | &nbsp;&nbsp;.&nbsp; | &nbsp;&nbsp;.&nbsp; | &nbsp;&nbsp;.&nbsp; | &nbsp;&nbsp;.&nbsp; | &nbsp;&nbsp;.&nbsp; | &nbsp;&nbsp;.&nbsp; |  &nbsp;&nbsp;28&nbsp; | &nbsp;&nbsp; Nut M5 sliding T |
| &nbsp;&nbsp;.&nbsp; | &nbsp;&nbsp;.&nbsp; | &nbsp;&nbsp;.&nbsp; | &nbsp;&nbsp;4&nbsp; | &nbsp;&nbsp;.&nbsp; | &nbsp;&nbsp;.&nbsp; | &nbsp;&nbsp;.&nbsp; | &nbsp;&nbsp;.&nbsp; | &nbsp;&nbsp;.&nbsp; | &nbsp;&nbsp;.&nbsp; | &nbsp;&nbsp;.&nbsp; | &nbsp;&nbsp;.&nbsp; | &nbsp;&nbsp;.&nbsp; | &nbsp;&nbsp;.&nbsp; | &nbsp;&nbsp;.&nbsp; | &nbsp;&nbsp;.&nbsp; | &nbsp;&nbsp;.&nbsp; | &nbsp;&nbsp;.&nbsp; | &nbsp;&nbsp;.&nbsp; | &nbsp;&nbsp;.&nbsp; | &nbsp;&nbsp;.&nbsp; | &nbsp;&nbsp;.&nbsp; | &nbsp;&nbsp;.&nbsp; | &nbsp;&nbsp;.&nbsp; | &nbsp;&nbsp;.&nbsp; | &nbsp;&nbsp;.&nbsp; | &nbsp;&nbsp;.&nbsp; | &nbsp;&nbsp;.&nbsp; | &nbsp;&nbsp;.&nbsp; | &nbsp;&nbsp;.&nbsp; | &nbsp;&nbsp;.&nbsp; | &nbsp;&nbsp;.&nbsp; | &nbsp;&nbsp;.&nbsp; | &nbsp;&nbsp;.&nbsp; | &nbsp;&nbsp;.&nbsp; | &nbsp;&nbsp;.&nbsp; | &nbsp;&nbsp;.&nbsp; | &nbsp;&nbsp;.&nbsp; | &nbsp;&nbsp;.&nbsp; | &nbsp;&nbsp;.&nbsp; | &nbsp;&nbsp;.&nbsp; | &nbsp;&nbsp;.&nbsp; | &nbsp;&nbsp;.&nbsp; | &nbsp;&nbsp;.&nbsp; | &nbsp;&nbsp;.&nbsp; | &nbsp;&nbsp;.&nbsp; | &nbsp;&nbsp;.&nbsp; | &nbsp;&nbsp;.&nbsp; | &nbsp;&nbsp;.&nbsp; | &nbsp;&nbsp;.&nbsp; | &nbsp;&nbsp;.&nbsp; | &nbsp;&nbsp;.&nbsp; | &nbsp;&nbsp;.&nbsp; | &nbsp;&nbsp;.&nbsp; | &nbsp;&nbsp;.&nbsp; | &nbsp;&nbsp;.&nbsp; | &nbsp;&nbsp;.&nbsp; | &nbsp;&nbsp;.&nbsp; | &nbsp;&nbsp;.&nbsp; | &nbsp;&nbsp;.&nbsp; | &nbsp;&nbsp;.&nbsp; | &nbsp;&nbsp;.&nbsp; | &nbsp;&nbsp;.&nbsp; | &nbsp;&nbsp;.&nbsp; | &nbsp;&nbsp;.&nbsp; | &nbsp;&nbsp;.&nbsp; | &nbsp;&nbsp;.&nbsp; | &nbsp;&nbsp;.&nbsp; | &nbsp;&nbsp;.&nbsp; | &nbsp;&nbsp;.&nbsp; | &nbsp;&nbsp;.&nbsp; | &nbsp;&nbsp;.&nbsp; |  &nbsp;&nbsp;4&nbsp; | &nbsp;&nbsp; Nut M5 x 4mm  |
| &nbsp;&nbsp;.&nbsp; | &nbsp;&nbsp;.&nbsp; | &nbsp;&nbsp;8&nbsp; | &nbsp;&nbsp;.&nbsp; | &nbsp;&nbsp;.&nbsp; | &nbsp;&nbsp;.&nbsp; | &nbsp;&nbsp;.&nbsp; | &nbsp;&nbsp;.&nbsp; | &nbsp;&nbsp;.&nbsp; | &nbsp;&nbsp;.&nbsp; | &nbsp;&nbsp;.&nbsp; | &nbsp;&nbsp;.&nbsp; | &nbsp;&nbsp;.&nbsp; | &nbsp;&nbsp;.&nbsp; | &nbsp;&nbsp;.&nbsp; | &nbsp;&nbsp;.&nbsp; | &nbsp;&nbsp;.&nbsp; | &nbsp;&nbsp;.&nbsp; | &nbsp;&nbsp;.&nbsp; | &nbsp;&nbsp;.&nbsp; | &nbsp;&nbsp;.&nbsp; | &nbsp;&nbsp;.&nbsp; | &nbsp;&nbsp;.&nbsp; | &nbsp;&nbsp;.&nbsp; | &nbsp;&nbsp;.&nbsp; | &nbsp;&nbsp;.&nbsp; | &nbsp;&nbsp;.&nbsp; | &nbsp;&nbsp;.&nbsp; | &nbsp;&nbsp;.&nbsp; | &nbsp;&nbsp;.&nbsp; | &nbsp;&nbsp;.&nbsp; | &nbsp;&nbsp;.&nbsp; | &nbsp;&nbsp;.&nbsp; | &nbsp;&nbsp;.&nbsp; | &nbsp;&nbsp;.&nbsp; | &nbsp;&nbsp;.&nbsp; | &nbsp;&nbsp;.&nbsp; | &nbsp;&nbsp;.&nbsp; | &nbsp;&nbsp;.&nbsp; | &nbsp;&nbsp;.&nbsp; | &nbsp;&nbsp;.&nbsp; | &nbsp;&nbsp;.&nbsp; | &nbsp;&nbsp;.&nbsp; | &nbsp;&nbsp;.&nbsp; | &nbsp;&nbsp;.&nbsp; | &nbsp;&nbsp;.&nbsp; | &nbsp;&nbsp;.&nbsp; | &nbsp;&nbsp;.&nbsp; | &nbsp;&nbsp;.&nbsp; | &nbsp;&nbsp;.&nbsp; | &nbsp;&nbsp;.&nbsp; | &nbsp;&nbsp;.&nbsp; | &nbsp;&nbsp;.&nbsp; | &nbsp;&nbsp;.&nbsp; | &nbsp;&nbsp;.&nbsp; | &nbsp;&nbsp;.&nbsp; | &nbsp;&nbsp;.&nbsp; | &nbsp;&nbsp;.&nbsp; | &nbsp;&nbsp;.&nbsp; | &nbsp;&nbsp;.&nbsp; | &nbsp;&nbsp;.&nbsp; | &nbsp;&nbsp;.&nbsp; | &nbsp;&nbsp;.&nbsp; | &nbsp;&nbsp;.&nbsp; | &nbsp;&nbsp;.&nbsp; | &nbsp;&nbsp;4&nbsp; | &nbsp;&nbsp;.&nbsp; | &nbsp;&nbsp;.&nbsp; | &nbsp;&nbsp;.&nbsp; | &nbsp;&nbsp;.&nbsp; | &nbsp;&nbsp;.&nbsp; | &nbsp;&nbsp;.&nbsp; |  &nbsp;&nbsp;12&nbsp; | &nbsp;&nbsp; Nut M8 x 6.5mm  |
| &nbsp;&nbsp;.&nbsp; | &nbsp;&nbsp;.&nbsp; | &nbsp;&nbsp;.&nbsp; | &nbsp;&nbsp;.&nbsp; | &nbsp;&nbsp;.&nbsp; | &nbsp;&nbsp;.&nbsp; | &nbsp;&nbsp;.&nbsp; | &nbsp;&nbsp;.&nbsp; | &nbsp;&nbsp;.&nbsp; | &nbsp;&nbsp;.&nbsp; | &nbsp;&nbsp;.&nbsp; | &nbsp;&nbsp;.&nbsp; | &nbsp;&nbsp;.&nbsp; | &nbsp;&nbsp;.&nbsp; | &nbsp;&nbsp;.&nbsp; | &nbsp;&nbsp;.&nbsp; | &nbsp;&nbsp;.&nbsp; | &nbsp;&nbsp;4&nbsp; | &nbsp;&nbsp;.&nbsp; | &nbsp;&nbsp;.&nbsp; | &nbsp;&nbsp;.&nbsp; | &nbsp;&nbsp;.&nbsp; | &nbsp;&nbsp;.&nbsp; | &nbsp;&nbsp;.&nbsp; | &nbsp;&nbsp;.&nbsp; | &nbsp;&nbsp;.&nbsp; | &nbsp;&nbsp;.&nbsp; | &nbsp;&nbsp;.&nbsp; | &nbsp;&nbsp;.&nbsp; | &nbsp;&nbsp;.&nbsp; | &nbsp;&nbsp;.&nbsp; | &nbsp;&nbsp;.&nbsp; | &nbsp;&nbsp;.&nbsp; | &nbsp;&nbsp;4&nbsp; | &nbsp;&nbsp;.&nbsp; | &nbsp;&nbsp;.&nbsp; | &nbsp;&nbsp;.&nbsp; | &nbsp;&nbsp;.&nbsp; | &nbsp;&nbsp;.&nbsp; | &nbsp;&nbsp;.&nbsp; | &nbsp;&nbsp;.&nbsp; | &nbsp;&nbsp;.&nbsp; | &nbsp;&nbsp;.&nbsp; | &nbsp;&nbsp;.&nbsp; | &nbsp;&nbsp;.&nbsp; | &nbsp;&nbsp;.&nbsp; | &nbsp;&nbsp;.&nbsp; | &nbsp;&nbsp;.&nbsp; | &nbsp;&nbsp;.&nbsp; | &nbsp;&nbsp;.&nbsp; | &nbsp;&nbsp;.&nbsp; | &nbsp;&nbsp;.&nbsp; | &nbsp;&nbsp;.&nbsp; | &nbsp;&nbsp;.&nbsp; | &nbsp;&nbsp;.&nbsp; | &nbsp;&nbsp;.&nbsp; | &nbsp;&nbsp;.&nbsp; | &nbsp;&nbsp;.&nbsp; | &nbsp;&nbsp;.&nbsp; | &nbsp;&nbsp;.&nbsp; | &nbsp;&nbsp;.&nbsp; | &nbsp;&nbsp;.&nbsp; | &nbsp;&nbsp;.&nbsp; | &nbsp;&nbsp;.&nbsp; | &nbsp;&nbsp;.&nbsp; | &nbsp;&nbsp;.&nbsp; | &nbsp;&nbsp;.&nbsp; | &nbsp;&nbsp;.&nbsp; | &nbsp;&nbsp;.&nbsp; | &nbsp;&nbsp;.&nbsp; | &nbsp;&nbsp;.&nbsp; | &nbsp;&nbsp;.&nbsp; |  &nbsp;&nbsp;8&nbsp; | &nbsp;&nbsp; Ooznest 90 Degree Angle Corner (VSLOT-B-90AC) |
| &nbsp;&nbsp;.&nbsp; | &nbsp;&nbsp;.&nbsp; | &nbsp;&nbsp;.&nbsp; | &nbsp;&nbsp;.&nbsp; | &nbsp;&nbsp;.&nbsp; | &nbsp;&nbsp;.&nbsp; | &nbsp;&nbsp;.&nbsp; | &nbsp;&nbsp;.&nbsp; | &nbsp;&nbsp;.&nbsp; | &nbsp;&nbsp;.&nbsp; | &nbsp;&nbsp;.&nbsp; | &nbsp;&nbsp;.&nbsp; | &nbsp;&nbsp;.&nbsp; | &nbsp;&nbsp;.&nbsp; | &nbsp;&nbsp;.&nbsp; | &nbsp;&nbsp;.&nbsp; | &nbsp;&nbsp;.&nbsp; | &nbsp;&nbsp;.&nbsp; | &nbsp;&nbsp;.&nbsp; | &nbsp;&nbsp;.&nbsp; | &nbsp;&nbsp;.&nbsp; | &nbsp;&nbsp;.&nbsp; | &nbsp;&nbsp;.&nbsp; | &nbsp;&nbsp;.&nbsp; | &nbsp;&nbsp;.&nbsp; | &nbsp;&nbsp;.&nbsp; | &nbsp;&nbsp;.&nbsp; | &nbsp;&nbsp;.&nbsp; | &nbsp;&nbsp;.&nbsp; | &nbsp;&nbsp;.&nbsp; | &nbsp;&nbsp;.&nbsp; | &nbsp;&nbsp;.&nbsp; | &nbsp;&nbsp;.&nbsp; | &nbsp;&nbsp;.&nbsp; | &nbsp;&nbsp;.&nbsp; | &nbsp;&nbsp;.&nbsp; | &nbsp;&nbsp;.&nbsp; | &nbsp;&nbsp;.&nbsp; | &nbsp;&nbsp;.&nbsp; | &nbsp;&nbsp;.&nbsp; | &nbsp;&nbsp;.&nbsp; | &nbsp;&nbsp;.&nbsp; | &nbsp;&nbsp;.&nbsp; | &nbsp;&nbsp;.&nbsp; | &nbsp;&nbsp;.&nbsp; | &nbsp;&nbsp;1&nbsp; | &nbsp;&nbsp;.&nbsp; | &nbsp;&nbsp;.&nbsp; | &nbsp;&nbsp;.&nbsp; | &nbsp;&nbsp;.&nbsp; | &nbsp;&nbsp;.&nbsp; | &nbsp;&nbsp;.&nbsp; | &nbsp;&nbsp;.&nbsp; | &nbsp;&nbsp;.&nbsp; | &nbsp;&nbsp;.&nbsp; | &nbsp;&nbsp;.&nbsp; | &nbsp;&nbsp;.&nbsp; | &nbsp;&nbsp;.&nbsp; | &nbsp;&nbsp;.&nbsp; | &nbsp;&nbsp;.&nbsp; | &nbsp;&nbsp;.&nbsp; | &nbsp;&nbsp;1&nbsp; | &nbsp;&nbsp;.&nbsp; | &nbsp;&nbsp;.&nbsp; | &nbsp;&nbsp;.&nbsp; | &nbsp;&nbsp;.&nbsp; | &nbsp;&nbsp;.&nbsp; | &nbsp;&nbsp;.&nbsp; | &nbsp;&nbsp;.&nbsp; | &nbsp;&nbsp;.&nbsp; | &nbsp;&nbsp;.&nbsp; | &nbsp;&nbsp;.&nbsp; |  &nbsp;&nbsp;2&nbsp; | &nbsp;&nbsp; Ooznest ACME anti-backlash nut |
| &nbsp;&nbsp;.&nbsp; | &nbsp;&nbsp;.&nbsp; | &nbsp;&nbsp;.&nbsp; | &nbsp;&nbsp;.&nbsp; | &nbsp;&nbsp;.&nbsp; | &nbsp;&nbsp;.&nbsp; | &nbsp;&nbsp;.&nbsp; | &nbsp;&nbsp;.&nbsp; | &nbsp;&nbsp;.&nbsp; | &nbsp;&nbsp;.&nbsp; | &nbsp;&nbsp;.&nbsp; | &nbsp;&nbsp;.&nbsp; | &nbsp;&nbsp;.&nbsp; | &nbsp;&nbsp;.&nbsp; | &nbsp;&nbsp;.&nbsp; | &nbsp;&nbsp;.&nbsp; | &nbsp;&nbsp;.&nbsp; | &nbsp;&nbsp;.&nbsp; | &nbsp;&nbsp;.&nbsp; | &nbsp;&nbsp;.&nbsp; | &nbsp;&nbsp;.&nbsp; | &nbsp;&nbsp;.&nbsp; | &nbsp;&nbsp;.&nbsp; | &nbsp;&nbsp;.&nbsp; | &nbsp;&nbsp;.&nbsp; | &nbsp;&nbsp;.&nbsp; | &nbsp;&nbsp;.&nbsp; | &nbsp;&nbsp;.&nbsp; | &nbsp;&nbsp;.&nbsp; | &nbsp;&nbsp;.&nbsp; | &nbsp;&nbsp;.&nbsp; | &nbsp;&nbsp;.&nbsp; | &nbsp;&nbsp;.&nbsp; | &nbsp;&nbsp;.&nbsp; | &nbsp;&nbsp;.&nbsp; | &nbsp;&nbsp;.&nbsp; | &nbsp;&nbsp;.&nbsp; | &nbsp;&nbsp;.&nbsp; | &nbsp;&nbsp;.&nbsp; | &nbsp;&nbsp;.&nbsp; | &nbsp;&nbsp;.&nbsp; | &nbsp;&nbsp;.&nbsp; | &nbsp;&nbsp;.&nbsp; | &nbsp;&nbsp;.&nbsp; | &nbsp;&nbsp;.&nbsp; | &nbsp;&nbsp;.&nbsp; | &nbsp;&nbsp;.&nbsp; | &nbsp;&nbsp;.&nbsp; | &nbsp;&nbsp;.&nbsp; | &nbsp;&nbsp;.&nbsp; | &nbsp;&nbsp;.&nbsp; | &nbsp;&nbsp;.&nbsp; | &nbsp;&nbsp;.&nbsp; | &nbsp;&nbsp;.&nbsp; | &nbsp;&nbsp;.&nbsp; | &nbsp;&nbsp;.&nbsp; | &nbsp;&nbsp;.&nbsp; | &nbsp;&nbsp;.&nbsp; | &nbsp;&nbsp;.&nbsp; | &nbsp;&nbsp;.&nbsp; | &nbsp;&nbsp;.&nbsp; | &nbsp;&nbsp;.&nbsp; | &nbsp;&nbsp;.&nbsp; | &nbsp;&nbsp;.&nbsp; | &nbsp;&nbsp;.&nbsp; | &nbsp;&nbsp;.&nbsp; | &nbsp;&nbsp;.&nbsp; | &nbsp;&nbsp;.&nbsp; | &nbsp;&nbsp;.&nbsp; | &nbsp;&nbsp;.&nbsp; | &nbsp;&nbsp;.&nbsp; | &nbsp;&nbsp;1&nbsp; |  &nbsp;&nbsp;1&nbsp; | &nbsp;&nbsp; PSU S-300-12 |
| &nbsp;&nbsp;.&nbsp; | &nbsp;&nbsp;.&nbsp; | &nbsp;&nbsp;.&nbsp; | &nbsp;&nbsp;.&nbsp; | &nbsp;&nbsp;.&nbsp; | &nbsp;&nbsp;.&nbsp; | &nbsp;&nbsp;.&nbsp; | &nbsp;&nbsp;.&nbsp; | &nbsp;&nbsp;.&nbsp; | &nbsp;&nbsp;.&nbsp; | &nbsp;&nbsp;.&nbsp; | &nbsp;&nbsp;.&nbsp; | &nbsp;&nbsp;.&nbsp; | &nbsp;&nbsp;.&nbsp; | &nbsp;&nbsp;.&nbsp; | &nbsp;&nbsp;.&nbsp; | &nbsp;&nbsp;.&nbsp; | &nbsp;&nbsp;.&nbsp; | &nbsp;&nbsp;.&nbsp; | &nbsp;&nbsp;.&nbsp; | &nbsp;&nbsp;.&nbsp; | &nbsp;&nbsp;.&nbsp; | &nbsp;&nbsp;1&nbsp; | &nbsp;&nbsp;.&nbsp; | &nbsp;&nbsp;.&nbsp; | &nbsp;&nbsp;.&nbsp; | &nbsp;&nbsp;.&nbsp; | &nbsp;&nbsp;.&nbsp; | &nbsp;&nbsp;.&nbsp; | &nbsp;&nbsp;.&nbsp; | &nbsp;&nbsp;.&nbsp; | &nbsp;&nbsp;.&nbsp; | &nbsp;&nbsp;.&nbsp; | &nbsp;&nbsp;.&nbsp; | &nbsp;&nbsp;.&nbsp; | &nbsp;&nbsp;.&nbsp; | &nbsp;&nbsp;.&nbsp; | &nbsp;&nbsp;.&nbsp; | &nbsp;&nbsp;.&nbsp; | &nbsp;&nbsp;.&nbsp; | &nbsp;&nbsp;.&nbsp; | &nbsp;&nbsp;.&nbsp; | &nbsp;&nbsp;.&nbsp; | &nbsp;&nbsp;.&nbsp; | &nbsp;&nbsp;.&nbsp; | &nbsp;&nbsp;.&nbsp; | &nbsp;&nbsp;.&nbsp; | &nbsp;&nbsp;.&nbsp; | &nbsp;&nbsp;.&nbsp; | &nbsp;&nbsp;1&nbsp; | &nbsp;&nbsp;.&nbsp; | &nbsp;&nbsp;.&nbsp; | &nbsp;&nbsp;.&nbsp; | &nbsp;&nbsp;.&nbsp; | &nbsp;&nbsp;.&nbsp; | &nbsp;&nbsp;.&nbsp; | &nbsp;&nbsp;.&nbsp; | &nbsp;&nbsp;.&nbsp; | &nbsp;&nbsp;.&nbsp; | &nbsp;&nbsp;.&nbsp; | &nbsp;&nbsp;.&nbsp; | &nbsp;&nbsp;.&nbsp; | &nbsp;&nbsp;.&nbsp; | &nbsp;&nbsp;.&nbsp; | &nbsp;&nbsp;.&nbsp; | &nbsp;&nbsp;.&nbsp; | &nbsp;&nbsp;.&nbsp; | &nbsp;&nbsp;.&nbsp; | &nbsp;&nbsp;.&nbsp; | &nbsp;&nbsp;.&nbsp; | &nbsp;&nbsp;.&nbsp; | &nbsp;&nbsp;.&nbsp; |  &nbsp;&nbsp;2&nbsp; | &nbsp;&nbsp; Pulley GT2OB 20 teeth |
| &nbsp;&nbsp;.&nbsp; | &nbsp;&nbsp;.&nbsp; | &nbsp;&nbsp;.&nbsp; | &nbsp;&nbsp;.&nbsp; | &nbsp;&nbsp;.&nbsp; | &nbsp;&nbsp;.&nbsp; | &nbsp;&nbsp;.&nbsp; | &nbsp;&nbsp;.&nbsp; | &nbsp;&nbsp;5&nbsp; | &nbsp;&nbsp;7&nbsp; | &nbsp;&nbsp;.&nbsp; | &nbsp;&nbsp;14&nbsp; | &nbsp;&nbsp;.&nbsp; | &nbsp;&nbsp;.&nbsp; | &nbsp;&nbsp;.&nbsp; | &nbsp;&nbsp;.&nbsp; | &nbsp;&nbsp;.&nbsp; | &nbsp;&nbsp;.&nbsp; | &nbsp;&nbsp;.&nbsp; | &nbsp;&nbsp;.&nbsp; | &nbsp;&nbsp;.&nbsp; | &nbsp;&nbsp;.&nbsp; | &nbsp;&nbsp;1&nbsp; | &nbsp;&nbsp;.&nbsp; | &nbsp;&nbsp;.&nbsp; | &nbsp;&nbsp;.&nbsp; | &nbsp;&nbsp;.&nbsp; | &nbsp;&nbsp;.&nbsp; | &nbsp;&nbsp;.&nbsp; | &nbsp;&nbsp;.&nbsp; | &nbsp;&nbsp;4&nbsp; | &nbsp;&nbsp;.&nbsp; | &nbsp;&nbsp;.&nbsp; | &nbsp;&nbsp;.&nbsp; | &nbsp;&nbsp;.&nbsp; | &nbsp;&nbsp;.&nbsp; | &nbsp;&nbsp;.&nbsp; | &nbsp;&nbsp;.&nbsp; | &nbsp;&nbsp;.&nbsp; | &nbsp;&nbsp;.&nbsp; | &nbsp;&nbsp;.&nbsp; | &nbsp;&nbsp;.&nbsp; | &nbsp;&nbsp;.&nbsp; | &nbsp;&nbsp;.&nbsp; | &nbsp;&nbsp;.&nbsp; | &nbsp;&nbsp;.&nbsp; | &nbsp;&nbsp;.&nbsp; | &nbsp;&nbsp;.&nbsp; | &nbsp;&nbsp;.&nbsp; | &nbsp;&nbsp;1&nbsp; | &nbsp;&nbsp;.&nbsp; | &nbsp;&nbsp;.&nbsp; | &nbsp;&nbsp;.&nbsp; | &nbsp;&nbsp;.&nbsp; | &nbsp;&nbsp;.&nbsp; | &nbsp;&nbsp;.&nbsp; | &nbsp;&nbsp;.&nbsp; | &nbsp;&nbsp;.&nbsp; | &nbsp;&nbsp;.&nbsp; | &nbsp;&nbsp;.&nbsp; | &nbsp;&nbsp;.&nbsp; | &nbsp;&nbsp;.&nbsp; | &nbsp;&nbsp;.&nbsp; | &nbsp;&nbsp;.&nbsp; | &nbsp;&nbsp;.&nbsp; | &nbsp;&nbsp;.&nbsp; | &nbsp;&nbsp;.&nbsp; | &nbsp;&nbsp;.&nbsp; | &nbsp;&nbsp;.&nbsp; | &nbsp;&nbsp;.&nbsp; | &nbsp;&nbsp;4&nbsp; | &nbsp;&nbsp;.&nbsp; |  &nbsp;&nbsp;36&nbsp; | &nbsp;&nbsp; Screw M3 cap x 10mm |
| &nbsp;&nbsp;.&nbsp; | &nbsp;&nbsp;.&nbsp; | &nbsp;&nbsp;.&nbsp; | &nbsp;&nbsp;.&nbsp; | &nbsp;&nbsp;.&nbsp; | &nbsp;&nbsp;.&nbsp; | &nbsp;&nbsp;.&nbsp; | &nbsp;&nbsp;.&nbsp; | &nbsp;&nbsp;.&nbsp; | &nbsp;&nbsp;.&nbsp; | &nbsp;&nbsp;.&nbsp; | &nbsp;&nbsp;.&nbsp; | &nbsp;&nbsp;.&nbsp; | &nbsp;&nbsp;4&nbsp; | &nbsp;&nbsp;.&nbsp; | &nbsp;&nbsp;.&nbsp; | &nbsp;&nbsp;.&nbsp; | &nbsp;&nbsp;.&nbsp; | &nbsp;&nbsp;.&nbsp; | &nbsp;&nbsp;.&nbsp; | &nbsp;&nbsp;.&nbsp; | &nbsp;&nbsp;.&nbsp; | &nbsp;&nbsp;3&nbsp; | &nbsp;&nbsp;2&nbsp; | &nbsp;&nbsp;12&nbsp; | &nbsp;&nbsp;.&nbsp; | &nbsp;&nbsp;.&nbsp; | &nbsp;&nbsp;.&nbsp; | &nbsp;&nbsp;.&nbsp; | &nbsp;&nbsp;.&nbsp; | &nbsp;&nbsp;4&nbsp; | &nbsp;&nbsp;12&nbsp; | &nbsp;&nbsp;.&nbsp; | &nbsp;&nbsp;.&nbsp; | &nbsp;&nbsp;.&nbsp; | &nbsp;&nbsp;.&nbsp; | &nbsp;&nbsp;.&nbsp; | &nbsp;&nbsp;.&nbsp; | &nbsp;&nbsp;.&nbsp; | &nbsp;&nbsp;.&nbsp; | &nbsp;&nbsp;.&nbsp; | &nbsp;&nbsp;.&nbsp; | &nbsp;&nbsp;.&nbsp; | &nbsp;&nbsp;.&nbsp; | &nbsp;&nbsp;.&nbsp; | &nbsp;&nbsp;.&nbsp; | &nbsp;&nbsp;.&nbsp; | &nbsp;&nbsp;.&nbsp; | &nbsp;&nbsp;.&nbsp; | &nbsp;&nbsp;3&nbsp; | &nbsp;&nbsp;.&nbsp; | &nbsp;&nbsp;.&nbsp; | &nbsp;&nbsp;.&nbsp; | &nbsp;&nbsp;.&nbsp; | &nbsp;&nbsp;.&nbsp; | &nbsp;&nbsp;.&nbsp; | &nbsp;&nbsp;.&nbsp; | &nbsp;&nbsp;.&nbsp; | &nbsp;&nbsp;.&nbsp; | &nbsp;&nbsp;.&nbsp; | &nbsp;&nbsp;.&nbsp; | &nbsp;&nbsp;.&nbsp; | &nbsp;&nbsp;.&nbsp; | &nbsp;&nbsp;8&nbsp; | &nbsp;&nbsp;.&nbsp; | &nbsp;&nbsp;.&nbsp; | &nbsp;&nbsp;8&nbsp; | &nbsp;&nbsp;.&nbsp; | &nbsp;&nbsp;.&nbsp; | &nbsp;&nbsp;.&nbsp; | &nbsp;&nbsp;.&nbsp; | &nbsp;&nbsp;.&nbsp; |  &nbsp;&nbsp;56&nbsp; | &nbsp;&nbsp; Screw M3 cap x 12mm |
| &nbsp;&nbsp;.&nbsp; | &nbsp;&nbsp;.&nbsp; | &nbsp;&nbsp;.&nbsp; | &nbsp;&nbsp;.&nbsp; | &nbsp;&nbsp;.&nbsp; | &nbsp;&nbsp;.&nbsp; | &nbsp;&nbsp;.&nbsp; | &nbsp;&nbsp;.&nbsp; | &nbsp;&nbsp;2&nbsp; | &nbsp;&nbsp;.&nbsp; | &nbsp;&nbsp;.&nbsp; | &nbsp;&nbsp;.&nbsp; | &nbsp;&nbsp;.&nbsp; | &nbsp;&nbsp;.&nbsp; | &nbsp;&nbsp;.&nbsp; | &nbsp;&nbsp;.&nbsp; | &nbsp;&nbsp;.&nbsp; | &nbsp;&nbsp;.&nbsp; | &nbsp;&nbsp;.&nbsp; | &nbsp;&nbsp;.&nbsp; | &nbsp;&nbsp;.&nbsp; | &nbsp;&nbsp;.&nbsp; | &nbsp;&nbsp;.&nbsp; | &nbsp;&nbsp;.&nbsp; | &nbsp;&nbsp;.&nbsp; | &nbsp;&nbsp;.&nbsp; | &nbsp;&nbsp;.&nbsp; | &nbsp;&nbsp;.&nbsp; | &nbsp;&nbsp;.&nbsp; | &nbsp;&nbsp;.&nbsp; | &nbsp;&nbsp;.&nbsp; | &nbsp;&nbsp;.&nbsp; | &nbsp;&nbsp;.&nbsp; | &nbsp;&nbsp;.&nbsp; | &nbsp;&nbsp;.&nbsp; | &nbsp;&nbsp;.&nbsp; | &nbsp;&nbsp;.&nbsp; | &nbsp;&nbsp;.&nbsp; | &nbsp;&nbsp;.&nbsp; | &nbsp;&nbsp;.&nbsp; | &nbsp;&nbsp;.&nbsp; | &nbsp;&nbsp;.&nbsp; | &nbsp;&nbsp;.&nbsp; | &nbsp;&nbsp;.&nbsp; | &nbsp;&nbsp;.&nbsp; | &nbsp;&nbsp;.&nbsp; | &nbsp;&nbsp;.&nbsp; | &nbsp;&nbsp;.&nbsp; | &nbsp;&nbsp;.&nbsp; | &nbsp;&nbsp;.&nbsp; | &nbsp;&nbsp;.&nbsp; | &nbsp;&nbsp;.&nbsp; | &nbsp;&nbsp;.&nbsp; | &nbsp;&nbsp;.&nbsp; | &nbsp;&nbsp;.&nbsp; | &nbsp;&nbsp;.&nbsp; | &nbsp;&nbsp;.&nbsp; | &nbsp;&nbsp;.&nbsp; | &nbsp;&nbsp;.&nbsp; | &nbsp;&nbsp;.&nbsp; | &nbsp;&nbsp;.&nbsp; | &nbsp;&nbsp;.&nbsp; | &nbsp;&nbsp;.&nbsp; | &nbsp;&nbsp;.&nbsp; | &nbsp;&nbsp;.&nbsp; | &nbsp;&nbsp;.&nbsp; | &nbsp;&nbsp;.&nbsp; | &nbsp;&nbsp;.&nbsp; | &nbsp;&nbsp;.&nbsp; | &nbsp;&nbsp;.&nbsp; | &nbsp;&nbsp;.&nbsp; | &nbsp;&nbsp;.&nbsp; |  &nbsp;&nbsp;2&nbsp; | &nbsp;&nbsp; Screw M3 cap x 14mm |
| &nbsp;&nbsp;.&nbsp; | &nbsp;&nbsp;.&nbsp; | &nbsp;&nbsp;.&nbsp; | &nbsp;&nbsp;.&nbsp; | &nbsp;&nbsp;.&nbsp; | &nbsp;&nbsp;.&nbsp; | &nbsp;&nbsp;2&nbsp; | &nbsp;&nbsp;2&nbsp; | &nbsp;&nbsp;.&nbsp; | &nbsp;&nbsp;.&nbsp; | &nbsp;&nbsp;.&nbsp; | &nbsp;&nbsp;.&nbsp; | &nbsp;&nbsp;.&nbsp; | &nbsp;&nbsp;.&nbsp; | &nbsp;&nbsp;.&nbsp; | &nbsp;&nbsp;.&nbsp; | &nbsp;&nbsp;.&nbsp; | &nbsp;&nbsp;.&nbsp; | &nbsp;&nbsp;.&nbsp; | &nbsp;&nbsp;.&nbsp; | &nbsp;&nbsp;.&nbsp; | &nbsp;&nbsp;.&nbsp; | &nbsp;&nbsp;.&nbsp; | &nbsp;&nbsp;.&nbsp; | &nbsp;&nbsp;.&nbsp; | &nbsp;&nbsp;.&nbsp; | &nbsp;&nbsp;.&nbsp; | &nbsp;&nbsp;.&nbsp; | &nbsp;&nbsp;.&nbsp; | &nbsp;&nbsp;.&nbsp; | &nbsp;&nbsp;.&nbsp; | &nbsp;&nbsp;.&nbsp; | &nbsp;&nbsp;.&nbsp; | &nbsp;&nbsp;.&nbsp; | &nbsp;&nbsp;.&nbsp; | &nbsp;&nbsp;.&nbsp; | &nbsp;&nbsp;.&nbsp; | &nbsp;&nbsp;.&nbsp; | &nbsp;&nbsp;.&nbsp; | &nbsp;&nbsp;.&nbsp; | &nbsp;&nbsp;.&nbsp; | &nbsp;&nbsp;.&nbsp; | &nbsp;&nbsp;.&nbsp; | &nbsp;&nbsp;.&nbsp; | &nbsp;&nbsp;.&nbsp; | &nbsp;&nbsp;.&nbsp; | &nbsp;&nbsp;.&nbsp; | &nbsp;&nbsp;.&nbsp; | &nbsp;&nbsp;.&nbsp; | &nbsp;&nbsp;.&nbsp; | &nbsp;&nbsp;.&nbsp; | &nbsp;&nbsp;.&nbsp; | &nbsp;&nbsp;.&nbsp; | &nbsp;&nbsp;.&nbsp; | &nbsp;&nbsp;.&nbsp; | &nbsp;&nbsp;.&nbsp; | &nbsp;&nbsp;.&nbsp; | &nbsp;&nbsp;.&nbsp; | &nbsp;&nbsp;.&nbsp; | &nbsp;&nbsp;.&nbsp; | &nbsp;&nbsp;.&nbsp; | &nbsp;&nbsp;.&nbsp; | &nbsp;&nbsp;.&nbsp; | &nbsp;&nbsp;.&nbsp; | &nbsp;&nbsp;.&nbsp; | &nbsp;&nbsp;.&nbsp; | &nbsp;&nbsp;.&nbsp; | &nbsp;&nbsp;.&nbsp; | &nbsp;&nbsp;.&nbsp; | &nbsp;&nbsp;.&nbsp; | &nbsp;&nbsp;.&nbsp; | &nbsp;&nbsp;.&nbsp; |  &nbsp;&nbsp;4&nbsp; | &nbsp;&nbsp; Screw M3 cap x 25mm |
| &nbsp;&nbsp;1&nbsp; | &nbsp;&nbsp;.&nbsp; | &nbsp;&nbsp;.&nbsp; | &nbsp;&nbsp;.&nbsp; | &nbsp;&nbsp;.&nbsp; | &nbsp;&nbsp;.&nbsp; | &nbsp;&nbsp;.&nbsp; | &nbsp;&nbsp;.&nbsp; | &nbsp;&nbsp;.&nbsp; | &nbsp;&nbsp;.&nbsp; | &nbsp;&nbsp;.&nbsp; | &nbsp;&nbsp;.&nbsp; | &nbsp;&nbsp;.&nbsp; | &nbsp;&nbsp;.&nbsp; | &nbsp;&nbsp;.&nbsp; | &nbsp;&nbsp;.&nbsp; | &nbsp;&nbsp;.&nbsp; | &nbsp;&nbsp;.&nbsp; | &nbsp;&nbsp;.&nbsp; | &nbsp;&nbsp;.&nbsp; | &nbsp;&nbsp;.&nbsp; | &nbsp;&nbsp;.&nbsp; | &nbsp;&nbsp;.&nbsp; | &nbsp;&nbsp;.&nbsp; | &nbsp;&nbsp;.&nbsp; | &nbsp;&nbsp;.&nbsp; | &nbsp;&nbsp;.&nbsp; | &nbsp;&nbsp;.&nbsp; | &nbsp;&nbsp;.&nbsp; | &nbsp;&nbsp;.&nbsp; | &nbsp;&nbsp;.&nbsp; | &nbsp;&nbsp;.&nbsp; | &nbsp;&nbsp;.&nbsp; | &nbsp;&nbsp;.&nbsp; | &nbsp;&nbsp;.&nbsp; | &nbsp;&nbsp;.&nbsp; | &nbsp;&nbsp;.&nbsp; | &nbsp;&nbsp;.&nbsp; | &nbsp;&nbsp;.&nbsp; | &nbsp;&nbsp;.&nbsp; | &nbsp;&nbsp;.&nbsp; | &nbsp;&nbsp;.&nbsp; | &nbsp;&nbsp;.&nbsp; | &nbsp;&nbsp;.&nbsp; | &nbsp;&nbsp;.&nbsp; | &nbsp;&nbsp;.&nbsp; | &nbsp;&nbsp;.&nbsp; | &nbsp;&nbsp;.&nbsp; | &nbsp;&nbsp;.&nbsp; | &nbsp;&nbsp;.&nbsp; | &nbsp;&nbsp;.&nbsp; | &nbsp;&nbsp;.&nbsp; | &nbsp;&nbsp;.&nbsp; | &nbsp;&nbsp;.&nbsp; | &nbsp;&nbsp;.&nbsp; | &nbsp;&nbsp;.&nbsp; | &nbsp;&nbsp;.&nbsp; | &nbsp;&nbsp;.&nbsp; | &nbsp;&nbsp;.&nbsp; | &nbsp;&nbsp;.&nbsp; | &nbsp;&nbsp;.&nbsp; | &nbsp;&nbsp;.&nbsp; | &nbsp;&nbsp;.&nbsp; | &nbsp;&nbsp;.&nbsp; | &nbsp;&nbsp;.&nbsp; | &nbsp;&nbsp;.&nbsp; | &nbsp;&nbsp;.&nbsp; | &nbsp;&nbsp;.&nbsp; | &nbsp;&nbsp;.&nbsp; | &nbsp;&nbsp;.&nbsp; | &nbsp;&nbsp;.&nbsp; | &nbsp;&nbsp;.&nbsp; |  &nbsp;&nbsp;1&nbsp; | &nbsp;&nbsp; Screw M3 cap x 30mm |
| &nbsp;&nbsp;.&nbsp; | &nbsp;&nbsp;.&nbsp; | &nbsp;&nbsp;.&nbsp; | &nbsp;&nbsp;.&nbsp; | &nbsp;&nbsp;.&nbsp; | &nbsp;&nbsp;.&nbsp; | &nbsp;&nbsp;.&nbsp; | &nbsp;&nbsp;.&nbsp; | &nbsp;&nbsp;.&nbsp; | &nbsp;&nbsp;.&nbsp; | &nbsp;&nbsp;.&nbsp; | &nbsp;&nbsp;.&nbsp; | &nbsp;&nbsp;.&nbsp; | &nbsp;&nbsp;.&nbsp; | &nbsp;&nbsp;.&nbsp; | &nbsp;&nbsp;.&nbsp; | &nbsp;&nbsp;.&nbsp; | &nbsp;&nbsp;.&nbsp; | &nbsp;&nbsp;.&nbsp; | &nbsp;&nbsp;.&nbsp; | &nbsp;&nbsp;.&nbsp; | &nbsp;&nbsp;.&nbsp; | &nbsp;&nbsp;.&nbsp; | &nbsp;&nbsp;.&nbsp; | &nbsp;&nbsp;.&nbsp; | &nbsp;&nbsp;.&nbsp; | &nbsp;&nbsp;.&nbsp; | &nbsp;&nbsp;.&nbsp; | &nbsp;&nbsp;.&nbsp; | &nbsp;&nbsp;.&nbsp; | &nbsp;&nbsp;.&nbsp; | &nbsp;&nbsp;.&nbsp; | &nbsp;&nbsp;.&nbsp; | &nbsp;&nbsp;.&nbsp; | &nbsp;&nbsp;.&nbsp; | &nbsp;&nbsp;.&nbsp; | &nbsp;&nbsp;.&nbsp; | &nbsp;&nbsp;.&nbsp; | &nbsp;&nbsp;.&nbsp; | &nbsp;&nbsp;.&nbsp; | &nbsp;&nbsp;1&nbsp; | &nbsp;&nbsp;.&nbsp; | &nbsp;&nbsp;.&nbsp; | &nbsp;&nbsp;.&nbsp; | &nbsp;&nbsp;.&nbsp; | &nbsp;&nbsp;.&nbsp; | &nbsp;&nbsp;.&nbsp; | &nbsp;&nbsp;.&nbsp; | &nbsp;&nbsp;.&nbsp; | &nbsp;&nbsp;.&nbsp; | &nbsp;&nbsp;.&nbsp; | &nbsp;&nbsp;.&nbsp; | &nbsp;&nbsp;.&nbsp; | &nbsp;&nbsp;.&nbsp; | &nbsp;&nbsp;.&nbsp; | &nbsp;&nbsp;.&nbsp; | &nbsp;&nbsp;1&nbsp; | &nbsp;&nbsp;.&nbsp; | &nbsp;&nbsp;.&nbsp; | &nbsp;&nbsp;.&nbsp; | &nbsp;&nbsp;.&nbsp; | &nbsp;&nbsp;.&nbsp; | &nbsp;&nbsp;.&nbsp; | &nbsp;&nbsp;.&nbsp; | &nbsp;&nbsp;.&nbsp; | &nbsp;&nbsp;.&nbsp; | &nbsp;&nbsp;.&nbsp; | &nbsp;&nbsp;.&nbsp; | &nbsp;&nbsp;.&nbsp; | &nbsp;&nbsp;.&nbsp; | &nbsp;&nbsp;.&nbsp; | &nbsp;&nbsp;.&nbsp; |  &nbsp;&nbsp;2&nbsp; | &nbsp;&nbsp; Screw M3 cap x 35mm |
| &nbsp;&nbsp;.&nbsp; | &nbsp;&nbsp;.&nbsp; | &nbsp;&nbsp;.&nbsp; | &nbsp;&nbsp;.&nbsp; | &nbsp;&nbsp;.&nbsp; | &nbsp;&nbsp;.&nbsp; | &nbsp;&nbsp;.&nbsp; | &nbsp;&nbsp;.&nbsp; | &nbsp;&nbsp;.&nbsp; | &nbsp;&nbsp;.&nbsp; | &nbsp;&nbsp;.&nbsp; | &nbsp;&nbsp;.&nbsp; | &nbsp;&nbsp;.&nbsp; | &nbsp;&nbsp;.&nbsp; | &nbsp;&nbsp;.&nbsp; | &nbsp;&nbsp;.&nbsp; | &nbsp;&nbsp;.&nbsp; | &nbsp;&nbsp;.&nbsp; | &nbsp;&nbsp;.&nbsp; | &nbsp;&nbsp;.&nbsp; | &nbsp;&nbsp;.&nbsp; | &nbsp;&nbsp;.&nbsp; | &nbsp;&nbsp;.&nbsp; | &nbsp;&nbsp;.&nbsp; | &nbsp;&nbsp;.&nbsp; | &nbsp;&nbsp;.&nbsp; | &nbsp;&nbsp;.&nbsp; | &nbsp;&nbsp;.&nbsp; | &nbsp;&nbsp;.&nbsp; | &nbsp;&nbsp;.&nbsp; | &nbsp;&nbsp;.&nbsp; | &nbsp;&nbsp;.&nbsp; | &nbsp;&nbsp;.&nbsp; | &nbsp;&nbsp;.&nbsp; | &nbsp;&nbsp;.&nbsp; | &nbsp;&nbsp;.&nbsp; | &nbsp;&nbsp;.&nbsp; | &nbsp;&nbsp;.&nbsp; | &nbsp;&nbsp;.&nbsp; | &nbsp;&nbsp;.&nbsp; | &nbsp;&nbsp;.&nbsp; | &nbsp;&nbsp;.&nbsp; | &nbsp;&nbsp;.&nbsp; | &nbsp;&nbsp;.&nbsp; | &nbsp;&nbsp;.&nbsp; | &nbsp;&nbsp;.&nbsp; | &nbsp;&nbsp;.&nbsp; | &nbsp;&nbsp;.&nbsp; | &nbsp;&nbsp;.&nbsp; | &nbsp;&nbsp;.&nbsp; | &nbsp;&nbsp;.&nbsp; | &nbsp;&nbsp;.&nbsp; | &nbsp;&nbsp;.&nbsp; | &nbsp;&nbsp;.&nbsp; | &nbsp;&nbsp;.&nbsp; | &nbsp;&nbsp;.&nbsp; | &nbsp;&nbsp;.&nbsp; | &nbsp;&nbsp;.&nbsp; | &nbsp;&nbsp;.&nbsp; | &nbsp;&nbsp;.&nbsp; | &nbsp;&nbsp;.&nbsp; | &nbsp;&nbsp;.&nbsp; | &nbsp;&nbsp;.&nbsp; | &nbsp;&nbsp;.&nbsp; | &nbsp;&nbsp;.&nbsp; | &nbsp;&nbsp;.&nbsp; | &nbsp;&nbsp;.&nbsp; | &nbsp;&nbsp;2&nbsp; | &nbsp;&nbsp;.&nbsp; | &nbsp;&nbsp;.&nbsp; | &nbsp;&nbsp;.&nbsp; | &nbsp;&nbsp;.&nbsp; |  &nbsp;&nbsp;2&nbsp; | &nbsp;&nbsp; Screw M3 cap x 40mm |
| &nbsp;&nbsp;.&nbsp; | &nbsp;&nbsp;.&nbsp; | &nbsp;&nbsp;.&nbsp; | &nbsp;&nbsp;.&nbsp; | &nbsp;&nbsp;.&nbsp; | &nbsp;&nbsp;.&nbsp; | &nbsp;&nbsp;.&nbsp; | &nbsp;&nbsp;.&nbsp; | &nbsp;&nbsp;.&nbsp; | &nbsp;&nbsp;.&nbsp; | &nbsp;&nbsp;2&nbsp; | &nbsp;&nbsp;.&nbsp; | &nbsp;&nbsp;.&nbsp; | &nbsp;&nbsp;.&nbsp; | &nbsp;&nbsp;1&nbsp; | &nbsp;&nbsp;.&nbsp; | &nbsp;&nbsp;.&nbsp; | &nbsp;&nbsp;.&nbsp; | &nbsp;&nbsp;.&nbsp; | &nbsp;&nbsp;.&nbsp; | &nbsp;&nbsp;.&nbsp; | &nbsp;&nbsp;.&nbsp; | &nbsp;&nbsp;.&nbsp; | &nbsp;&nbsp;.&nbsp; | &nbsp;&nbsp;.&nbsp; | &nbsp;&nbsp;.&nbsp; | &nbsp;&nbsp;.&nbsp; | &nbsp;&nbsp;.&nbsp; | &nbsp;&nbsp;.&nbsp; | &nbsp;&nbsp;.&nbsp; | &nbsp;&nbsp;.&nbsp; | &nbsp;&nbsp;.&nbsp; | &nbsp;&nbsp;.&nbsp; | &nbsp;&nbsp;.&nbsp; | &nbsp;&nbsp;.&nbsp; | &nbsp;&nbsp;.&nbsp; | &nbsp;&nbsp;.&nbsp; | &nbsp;&nbsp;.&nbsp; | &nbsp;&nbsp;.&nbsp; | &nbsp;&nbsp;.&nbsp; | &nbsp;&nbsp;.&nbsp; | &nbsp;&nbsp;.&nbsp; | &nbsp;&nbsp;.&nbsp; | &nbsp;&nbsp;.&nbsp; | &nbsp;&nbsp;.&nbsp; | &nbsp;&nbsp;.&nbsp; | &nbsp;&nbsp;.&nbsp; | &nbsp;&nbsp;.&nbsp; | &nbsp;&nbsp;.&nbsp; | &nbsp;&nbsp;.&nbsp; | &nbsp;&nbsp;.&nbsp; | &nbsp;&nbsp;.&nbsp; | &nbsp;&nbsp;.&nbsp; | &nbsp;&nbsp;.&nbsp; | &nbsp;&nbsp;.&nbsp; | &nbsp;&nbsp;.&nbsp; | &nbsp;&nbsp;.&nbsp; | &nbsp;&nbsp;.&nbsp; | &nbsp;&nbsp;.&nbsp; | &nbsp;&nbsp;.&nbsp; | &nbsp;&nbsp;.&nbsp; | &nbsp;&nbsp;.&nbsp; | &nbsp;&nbsp;.&nbsp; | &nbsp;&nbsp;.&nbsp; | &nbsp;&nbsp;.&nbsp; | &nbsp;&nbsp;.&nbsp; | &nbsp;&nbsp;.&nbsp; | &nbsp;&nbsp;.&nbsp; | &nbsp;&nbsp;.&nbsp; | &nbsp;&nbsp;.&nbsp; | &nbsp;&nbsp;.&nbsp; | &nbsp;&nbsp;.&nbsp; |  &nbsp;&nbsp;3&nbsp; | &nbsp;&nbsp; Screw M3 cap x 45mm |
| &nbsp;&nbsp;.&nbsp; | &nbsp;&nbsp;.&nbsp; | &nbsp;&nbsp;.&nbsp; | &nbsp;&nbsp;.&nbsp; | &nbsp;&nbsp;.&nbsp; | &nbsp;&nbsp;.&nbsp; | &nbsp;&nbsp;.&nbsp; | &nbsp;&nbsp;.&nbsp; | &nbsp;&nbsp;.&nbsp; | &nbsp;&nbsp;.&nbsp; | &nbsp;&nbsp;.&nbsp; | &nbsp;&nbsp;.&nbsp; | &nbsp;&nbsp;.&nbsp; | &nbsp;&nbsp;.&nbsp; | &nbsp;&nbsp;1&nbsp; | &nbsp;&nbsp;.&nbsp; | &nbsp;&nbsp;.&nbsp; | &nbsp;&nbsp;.&nbsp; | &nbsp;&nbsp;.&nbsp; | &nbsp;&nbsp;.&nbsp; | &nbsp;&nbsp;.&nbsp; | &nbsp;&nbsp;.&nbsp; | &nbsp;&nbsp;.&nbsp; | &nbsp;&nbsp;.&nbsp; | &nbsp;&nbsp;.&nbsp; | &nbsp;&nbsp;.&nbsp; | &nbsp;&nbsp;.&nbsp; | &nbsp;&nbsp;.&nbsp; | &nbsp;&nbsp;.&nbsp; | &nbsp;&nbsp;.&nbsp; | &nbsp;&nbsp;.&nbsp; | &nbsp;&nbsp;.&nbsp; | &nbsp;&nbsp;.&nbsp; | &nbsp;&nbsp;.&nbsp; | &nbsp;&nbsp;.&nbsp; | &nbsp;&nbsp;.&nbsp; | &nbsp;&nbsp;.&nbsp; | &nbsp;&nbsp;.&nbsp; | &nbsp;&nbsp;.&nbsp; | &nbsp;&nbsp;.&nbsp; | &nbsp;&nbsp;.&nbsp; | &nbsp;&nbsp;.&nbsp; | &nbsp;&nbsp;.&nbsp; | &nbsp;&nbsp;.&nbsp; | &nbsp;&nbsp;.&nbsp; | &nbsp;&nbsp;.&nbsp; | &nbsp;&nbsp;.&nbsp; | &nbsp;&nbsp;.&nbsp; | &nbsp;&nbsp;.&nbsp; | &nbsp;&nbsp;.&nbsp; | &nbsp;&nbsp;.&nbsp; | &nbsp;&nbsp;.&nbsp; | &nbsp;&nbsp;.&nbsp; | &nbsp;&nbsp;.&nbsp; | &nbsp;&nbsp;.&nbsp; | &nbsp;&nbsp;.&nbsp; | &nbsp;&nbsp;.&nbsp; | &nbsp;&nbsp;.&nbsp; | &nbsp;&nbsp;.&nbsp; | &nbsp;&nbsp;.&nbsp; | &nbsp;&nbsp;.&nbsp; | &nbsp;&nbsp;.&nbsp; | &nbsp;&nbsp;.&nbsp; | &nbsp;&nbsp;.&nbsp; | &nbsp;&nbsp;.&nbsp; | &nbsp;&nbsp;.&nbsp; | &nbsp;&nbsp;.&nbsp; | &nbsp;&nbsp;.&nbsp; | &nbsp;&nbsp;.&nbsp; | &nbsp;&nbsp;.&nbsp; | &nbsp;&nbsp;.&nbsp; | &nbsp;&nbsp;.&nbsp; |  &nbsp;&nbsp;1&nbsp; | &nbsp;&nbsp; Screw M3 cap x 50mm |
| &nbsp;&nbsp;.&nbsp; | &nbsp;&nbsp;.&nbsp; | &nbsp;&nbsp;.&nbsp; | &nbsp;&nbsp;.&nbsp; | &nbsp;&nbsp;.&nbsp; | &nbsp;&nbsp;.&nbsp; | &nbsp;&nbsp;.&nbsp; | &nbsp;&nbsp;.&nbsp; | &nbsp;&nbsp;.&nbsp; | &nbsp;&nbsp;.&nbsp; | &nbsp;&nbsp;.&nbsp; | &nbsp;&nbsp;.&nbsp; | &nbsp;&nbsp;.&nbsp; | &nbsp;&nbsp;.&nbsp; | &nbsp;&nbsp;.&nbsp; | &nbsp;&nbsp;.&nbsp; | &nbsp;&nbsp;.&nbsp; | &nbsp;&nbsp;.&nbsp; | &nbsp;&nbsp;.&nbsp; | &nbsp;&nbsp;.&nbsp; | &nbsp;&nbsp;.&nbsp; | &nbsp;&nbsp;.&nbsp; | &nbsp;&nbsp;.&nbsp; | &nbsp;&nbsp;.&nbsp; | &nbsp;&nbsp;.&nbsp; | &nbsp;&nbsp;.&nbsp; | &nbsp;&nbsp;.&nbsp; | &nbsp;&nbsp;.&nbsp; | &nbsp;&nbsp;.&nbsp; | &nbsp;&nbsp;.&nbsp; | &nbsp;&nbsp;.&nbsp; | &nbsp;&nbsp;.&nbsp; | &nbsp;&nbsp;.&nbsp; | &nbsp;&nbsp;.&nbsp; | &nbsp;&nbsp;.&nbsp; | &nbsp;&nbsp;.&nbsp; | &nbsp;&nbsp;.&nbsp; | &nbsp;&nbsp;.&nbsp; | &nbsp;&nbsp;.&nbsp; | &nbsp;&nbsp;.&nbsp; | &nbsp;&nbsp;.&nbsp; | &nbsp;&nbsp;.&nbsp; | &nbsp;&nbsp;.&nbsp; | &nbsp;&nbsp;.&nbsp; | &nbsp;&nbsp;.&nbsp; | &nbsp;&nbsp;.&nbsp; | &nbsp;&nbsp;.&nbsp; | &nbsp;&nbsp;.&nbsp; | &nbsp;&nbsp;.&nbsp; | &nbsp;&nbsp;.&nbsp; | &nbsp;&nbsp;.&nbsp; | &nbsp;&nbsp;.&nbsp; | &nbsp;&nbsp;.&nbsp; | &nbsp;&nbsp;.&nbsp; | &nbsp;&nbsp;.&nbsp; | &nbsp;&nbsp;.&nbsp; | &nbsp;&nbsp;.&nbsp; | &nbsp;&nbsp;.&nbsp; | &nbsp;&nbsp;.&nbsp; | &nbsp;&nbsp;.&nbsp; | &nbsp;&nbsp;.&nbsp; | &nbsp;&nbsp;.&nbsp; | &nbsp;&nbsp;.&nbsp; | &nbsp;&nbsp;.&nbsp; | &nbsp;&nbsp;.&nbsp; | &nbsp;&nbsp;.&nbsp; | &nbsp;&nbsp;.&nbsp; | &nbsp;&nbsp;.&nbsp; | &nbsp;&nbsp;.&nbsp; | &nbsp;&nbsp;2&nbsp; | &nbsp;&nbsp;.&nbsp; | &nbsp;&nbsp;.&nbsp; |  &nbsp;&nbsp;2&nbsp; | &nbsp;&nbsp; Screw M3 cs cap x  6mm |
| &nbsp;&nbsp;.&nbsp; | &nbsp;&nbsp;.&nbsp; | &nbsp;&nbsp;.&nbsp; | &nbsp;&nbsp;.&nbsp; | &nbsp;&nbsp;.&nbsp; | &nbsp;&nbsp;.&nbsp; | &nbsp;&nbsp;.&nbsp; | &nbsp;&nbsp;.&nbsp; | &nbsp;&nbsp;.&nbsp; | &nbsp;&nbsp;.&nbsp; | &nbsp;&nbsp;.&nbsp; | &nbsp;&nbsp;2&nbsp; | &nbsp;&nbsp;.&nbsp; | &nbsp;&nbsp;.&nbsp; | &nbsp;&nbsp;.&nbsp; | &nbsp;&nbsp;.&nbsp; | &nbsp;&nbsp;.&nbsp; | &nbsp;&nbsp;.&nbsp; | &nbsp;&nbsp;.&nbsp; | &nbsp;&nbsp;.&nbsp; | &nbsp;&nbsp;.&nbsp; | &nbsp;&nbsp;.&nbsp; | &nbsp;&nbsp;.&nbsp; | &nbsp;&nbsp;.&nbsp; | &nbsp;&nbsp;.&nbsp; | &nbsp;&nbsp;.&nbsp; | &nbsp;&nbsp;.&nbsp; | &nbsp;&nbsp;.&nbsp; | &nbsp;&nbsp;.&nbsp; | &nbsp;&nbsp;.&nbsp; | &nbsp;&nbsp;.&nbsp; | &nbsp;&nbsp;.&nbsp; | &nbsp;&nbsp;.&nbsp; | &nbsp;&nbsp;.&nbsp; | &nbsp;&nbsp;.&nbsp; | &nbsp;&nbsp;.&nbsp; | &nbsp;&nbsp;.&nbsp; | &nbsp;&nbsp;.&nbsp; | &nbsp;&nbsp;.&nbsp; | &nbsp;&nbsp;.&nbsp; | &nbsp;&nbsp;.&nbsp; | &nbsp;&nbsp;.&nbsp; | &nbsp;&nbsp;.&nbsp; | &nbsp;&nbsp;.&nbsp; | &nbsp;&nbsp;.&nbsp; | &nbsp;&nbsp;.&nbsp; | &nbsp;&nbsp;.&nbsp; | &nbsp;&nbsp;.&nbsp; | &nbsp;&nbsp;.&nbsp; | &nbsp;&nbsp;.&nbsp; | &nbsp;&nbsp;.&nbsp; | &nbsp;&nbsp;.&nbsp; | &nbsp;&nbsp;.&nbsp; | &nbsp;&nbsp;.&nbsp; | &nbsp;&nbsp;.&nbsp; | &nbsp;&nbsp;.&nbsp; | &nbsp;&nbsp;.&nbsp; | &nbsp;&nbsp;.&nbsp; | &nbsp;&nbsp;.&nbsp; | &nbsp;&nbsp;.&nbsp; | &nbsp;&nbsp;.&nbsp; | &nbsp;&nbsp;.&nbsp; | &nbsp;&nbsp;.&nbsp; | &nbsp;&nbsp;.&nbsp; | &nbsp;&nbsp;.&nbsp; | &nbsp;&nbsp;.&nbsp; | &nbsp;&nbsp;.&nbsp; | &nbsp;&nbsp;.&nbsp; | &nbsp;&nbsp;.&nbsp; | &nbsp;&nbsp;.&nbsp; | &nbsp;&nbsp;.&nbsp; | &nbsp;&nbsp;.&nbsp; |  &nbsp;&nbsp;2&nbsp; | &nbsp;&nbsp; Screw M3 cs cap x 12mm |
| &nbsp;&nbsp;.&nbsp; | &nbsp;&nbsp;.&nbsp; | &nbsp;&nbsp;.&nbsp; | &nbsp;&nbsp;.&nbsp; | &nbsp;&nbsp;.&nbsp; | &nbsp;&nbsp;.&nbsp; | &nbsp;&nbsp;.&nbsp; | &nbsp;&nbsp;.&nbsp; | &nbsp;&nbsp;.&nbsp; | &nbsp;&nbsp;.&nbsp; | &nbsp;&nbsp;.&nbsp; | &nbsp;&nbsp;.&nbsp; | &nbsp;&nbsp;.&nbsp; | &nbsp;&nbsp;.&nbsp; | &nbsp;&nbsp;.&nbsp; | &nbsp;&nbsp;.&nbsp; | &nbsp;&nbsp;.&nbsp; | &nbsp;&nbsp;.&nbsp; | &nbsp;&nbsp;.&nbsp; | &nbsp;&nbsp;.&nbsp; | &nbsp;&nbsp;.&nbsp; | &nbsp;&nbsp;.&nbsp; | &nbsp;&nbsp;.&nbsp; | &nbsp;&nbsp;.&nbsp; | &nbsp;&nbsp;4&nbsp; | &nbsp;&nbsp;.&nbsp; | &nbsp;&nbsp;.&nbsp; | &nbsp;&nbsp;.&nbsp; | &nbsp;&nbsp;.&nbsp; | &nbsp;&nbsp;.&nbsp; | &nbsp;&nbsp;.&nbsp; | &nbsp;&nbsp;4&nbsp; | &nbsp;&nbsp;.&nbsp; | &nbsp;&nbsp;.&nbsp; | &nbsp;&nbsp;.&nbsp; | &nbsp;&nbsp;.&nbsp; | &nbsp;&nbsp;.&nbsp; | &nbsp;&nbsp;.&nbsp; | &nbsp;&nbsp;.&nbsp; | &nbsp;&nbsp;.&nbsp; | &nbsp;&nbsp;.&nbsp; | &nbsp;&nbsp;.&nbsp; | &nbsp;&nbsp;.&nbsp; | &nbsp;&nbsp;.&nbsp; | &nbsp;&nbsp;.&nbsp; | &nbsp;&nbsp;.&nbsp; | &nbsp;&nbsp;.&nbsp; | &nbsp;&nbsp;.&nbsp; | &nbsp;&nbsp;.&nbsp; | &nbsp;&nbsp;.&nbsp; | &nbsp;&nbsp;.&nbsp; | &nbsp;&nbsp;.&nbsp; | &nbsp;&nbsp;.&nbsp; | &nbsp;&nbsp;.&nbsp; | &nbsp;&nbsp;.&nbsp; | &nbsp;&nbsp;.&nbsp; | &nbsp;&nbsp;.&nbsp; | &nbsp;&nbsp;.&nbsp; | &nbsp;&nbsp;.&nbsp; | &nbsp;&nbsp;.&nbsp; | &nbsp;&nbsp;.&nbsp; | &nbsp;&nbsp;.&nbsp; | &nbsp;&nbsp;.&nbsp; | &nbsp;&nbsp;.&nbsp; | &nbsp;&nbsp;.&nbsp; | &nbsp;&nbsp;.&nbsp; | &nbsp;&nbsp;.&nbsp; | &nbsp;&nbsp;.&nbsp; | &nbsp;&nbsp;.&nbsp; | &nbsp;&nbsp;.&nbsp; | &nbsp;&nbsp;.&nbsp; | &nbsp;&nbsp;.&nbsp; |  &nbsp;&nbsp;8&nbsp; | &nbsp;&nbsp; Screw M3 cs cap x 16mm |
| &nbsp;&nbsp;.&nbsp; | &nbsp;&nbsp;.&nbsp; | &nbsp;&nbsp;.&nbsp; | &nbsp;&nbsp;.&nbsp; | &nbsp;&nbsp;.&nbsp; | &nbsp;&nbsp;.&nbsp; | &nbsp;&nbsp;.&nbsp; | &nbsp;&nbsp;.&nbsp; | &nbsp;&nbsp;.&nbsp; | &nbsp;&nbsp;.&nbsp; | &nbsp;&nbsp;.&nbsp; | &nbsp;&nbsp;.&nbsp; | &nbsp;&nbsp;.&nbsp; | &nbsp;&nbsp;.&nbsp; | &nbsp;&nbsp;.&nbsp; | &nbsp;&nbsp;.&nbsp; | &nbsp;&nbsp;.&nbsp; | &nbsp;&nbsp;.&nbsp; | &nbsp;&nbsp;.&nbsp; | &nbsp;&nbsp;.&nbsp; | &nbsp;&nbsp;.&nbsp; | &nbsp;&nbsp;.&nbsp; | &nbsp;&nbsp;.&nbsp; | &nbsp;&nbsp;.&nbsp; | &nbsp;&nbsp;.&nbsp; | &nbsp;&nbsp;.&nbsp; | &nbsp;&nbsp;.&nbsp; | &nbsp;&nbsp;.&nbsp; | &nbsp;&nbsp;.&nbsp; | &nbsp;&nbsp;.&nbsp; | &nbsp;&nbsp;.&nbsp; | &nbsp;&nbsp;.&nbsp; | &nbsp;&nbsp;.&nbsp; | &nbsp;&nbsp;.&nbsp; | &nbsp;&nbsp;.&nbsp; | &nbsp;&nbsp;.&nbsp; | &nbsp;&nbsp;.&nbsp; | &nbsp;&nbsp;.&nbsp; | &nbsp;&nbsp;.&nbsp; | &nbsp;&nbsp;.&nbsp; | &nbsp;&nbsp;.&nbsp; | &nbsp;&nbsp;.&nbsp; | &nbsp;&nbsp;.&nbsp; | &nbsp;&nbsp;.&nbsp; | &nbsp;&nbsp;.&nbsp; | &nbsp;&nbsp;.&nbsp; | &nbsp;&nbsp;.&nbsp; | &nbsp;&nbsp;.&nbsp; | &nbsp;&nbsp;.&nbsp; | &nbsp;&nbsp;.&nbsp; | &nbsp;&nbsp;.&nbsp; | &nbsp;&nbsp;.&nbsp; | &nbsp;&nbsp;.&nbsp; | &nbsp;&nbsp;.&nbsp; | &nbsp;&nbsp;.&nbsp; | &nbsp;&nbsp;.&nbsp; | &nbsp;&nbsp;.&nbsp; | &nbsp;&nbsp;.&nbsp; | &nbsp;&nbsp;.&nbsp; | &nbsp;&nbsp;.&nbsp; | &nbsp;&nbsp;.&nbsp; | &nbsp;&nbsp;.&nbsp; | &nbsp;&nbsp;.&nbsp; | &nbsp;&nbsp;.&nbsp; | &nbsp;&nbsp;.&nbsp; | &nbsp;&nbsp;.&nbsp; | &nbsp;&nbsp;.&nbsp; | &nbsp;&nbsp;.&nbsp; | &nbsp;&nbsp;.&nbsp; | &nbsp;&nbsp;.&nbsp; | &nbsp;&nbsp;.&nbsp; | &nbsp;&nbsp;4&nbsp; |  &nbsp;&nbsp;4&nbsp; | &nbsp;&nbsp; Screw M4 cap x  8mm |
| &nbsp;&nbsp;.&nbsp; | &nbsp;&nbsp;.&nbsp; | &nbsp;&nbsp;.&nbsp; | &nbsp;&nbsp;.&nbsp; | &nbsp;&nbsp;4&nbsp; | &nbsp;&nbsp;.&nbsp; | &nbsp;&nbsp;2&nbsp; | &nbsp;&nbsp;2&nbsp; | &nbsp;&nbsp;.&nbsp; | &nbsp;&nbsp;.&nbsp; | &nbsp;&nbsp;.&nbsp; | &nbsp;&nbsp;.&nbsp; | &nbsp;&nbsp;.&nbsp; | &nbsp;&nbsp;.&nbsp; | &nbsp;&nbsp;.&nbsp; | &nbsp;&nbsp;.&nbsp; | &nbsp;&nbsp;6&nbsp; | &nbsp;&nbsp;.&nbsp; | &nbsp;&nbsp;.&nbsp; | &nbsp;&nbsp;.&nbsp; | &nbsp;&nbsp;.&nbsp; | &nbsp;&nbsp;.&nbsp; | &nbsp;&nbsp;3&nbsp; | &nbsp;&nbsp;1&nbsp; | &nbsp;&nbsp;.&nbsp; | &nbsp;&nbsp;.&nbsp; | &nbsp;&nbsp;.&nbsp; | &nbsp;&nbsp;.&nbsp; | &nbsp;&nbsp;.&nbsp; | &nbsp;&nbsp;6&nbsp; | &nbsp;&nbsp;.&nbsp; | &nbsp;&nbsp;.&nbsp; | &nbsp;&nbsp;.&nbsp; | &nbsp;&nbsp;.&nbsp; | &nbsp;&nbsp;.&nbsp; | &nbsp;&nbsp;12&nbsp; | &nbsp;&nbsp;.&nbsp; | &nbsp;&nbsp;.&nbsp; | &nbsp;&nbsp;.&nbsp; | &nbsp;&nbsp;.&nbsp; | &nbsp;&nbsp;3&nbsp; | &nbsp;&nbsp;.&nbsp; | &nbsp;&nbsp;4&nbsp; | &nbsp;&nbsp;.&nbsp; | &nbsp;&nbsp;.&nbsp; | &nbsp;&nbsp;4&nbsp; | &nbsp;&nbsp;4&nbsp; | &nbsp;&nbsp;.&nbsp; | &nbsp;&nbsp;.&nbsp; | &nbsp;&nbsp;3&nbsp; | &nbsp;&nbsp;.&nbsp; | &nbsp;&nbsp;.&nbsp; | &nbsp;&nbsp;.&nbsp; | &nbsp;&nbsp;.&nbsp; | &nbsp;&nbsp;.&nbsp; | &nbsp;&nbsp;.&nbsp; | &nbsp;&nbsp;3&nbsp; | &nbsp;&nbsp;4&nbsp; | &nbsp;&nbsp;.&nbsp; | &nbsp;&nbsp;4&nbsp; | &nbsp;&nbsp;.&nbsp; | &nbsp;&nbsp;4&nbsp; | &nbsp;&nbsp;.&nbsp; | &nbsp;&nbsp;.&nbsp; | &nbsp;&nbsp;.&nbsp; | &nbsp;&nbsp;.&nbsp; | &nbsp;&nbsp;.&nbsp; | &nbsp;&nbsp;.&nbsp; | &nbsp;&nbsp;.&nbsp; | &nbsp;&nbsp;.&nbsp; | &nbsp;&nbsp;.&nbsp; | &nbsp;&nbsp;4&nbsp; |  &nbsp;&nbsp;73&nbsp; | &nbsp;&nbsp; Screw M4 cap x 10mm |
| &nbsp;&nbsp;.&nbsp; | &nbsp;&nbsp;.&nbsp; | &nbsp;&nbsp;.&nbsp; | &nbsp;&nbsp;.&nbsp; | &nbsp;&nbsp;.&nbsp; | &nbsp;&nbsp;.&nbsp; | &nbsp;&nbsp;.&nbsp; | &nbsp;&nbsp;.&nbsp; | &nbsp;&nbsp;.&nbsp; | &nbsp;&nbsp;.&nbsp; | &nbsp;&nbsp;.&nbsp; | &nbsp;&nbsp;.&nbsp; | &nbsp;&nbsp;.&nbsp; | &nbsp;&nbsp;.&nbsp; | &nbsp;&nbsp;.&nbsp; | &nbsp;&nbsp;.&nbsp; | &nbsp;&nbsp;.&nbsp; | &nbsp;&nbsp;.&nbsp; | &nbsp;&nbsp;.&nbsp; | &nbsp;&nbsp;.&nbsp; | &nbsp;&nbsp;.&nbsp; | &nbsp;&nbsp;.&nbsp; | &nbsp;&nbsp;.&nbsp; | &nbsp;&nbsp;.&nbsp; | &nbsp;&nbsp;.&nbsp; | &nbsp;&nbsp;.&nbsp; | &nbsp;&nbsp;.&nbsp; | &nbsp;&nbsp;.&nbsp; | &nbsp;&nbsp;.&nbsp; | &nbsp;&nbsp;.&nbsp; | &nbsp;&nbsp;.&nbsp; | &nbsp;&nbsp;.&nbsp; | &nbsp;&nbsp;.&nbsp; | &nbsp;&nbsp;.&nbsp; | &nbsp;&nbsp;2&nbsp; | &nbsp;&nbsp;.&nbsp; | &nbsp;&nbsp;.&nbsp; | &nbsp;&nbsp;.&nbsp; | &nbsp;&nbsp;.&nbsp; | &nbsp;&nbsp;.&nbsp; | &nbsp;&nbsp;.&nbsp; | &nbsp;&nbsp;.&nbsp; | &nbsp;&nbsp;.&nbsp; | &nbsp;&nbsp;.&nbsp; | &nbsp;&nbsp;.&nbsp; | &nbsp;&nbsp;.&nbsp; | &nbsp;&nbsp;.&nbsp; | &nbsp;&nbsp;.&nbsp; | &nbsp;&nbsp;.&nbsp; | &nbsp;&nbsp;.&nbsp; | &nbsp;&nbsp;.&nbsp; | &nbsp;&nbsp;.&nbsp; | &nbsp;&nbsp;.&nbsp; | &nbsp;&nbsp;.&nbsp; | &nbsp;&nbsp;.&nbsp; | &nbsp;&nbsp;.&nbsp; | &nbsp;&nbsp;.&nbsp; | &nbsp;&nbsp;.&nbsp; | &nbsp;&nbsp;.&nbsp; | &nbsp;&nbsp;.&nbsp; | &nbsp;&nbsp;.&nbsp; | &nbsp;&nbsp;.&nbsp; | &nbsp;&nbsp;.&nbsp; | &nbsp;&nbsp;.&nbsp; | &nbsp;&nbsp;.&nbsp; | &nbsp;&nbsp;.&nbsp; | &nbsp;&nbsp;.&nbsp; | &nbsp;&nbsp;.&nbsp; | &nbsp;&nbsp;.&nbsp; | &nbsp;&nbsp;.&nbsp; | &nbsp;&nbsp;.&nbsp; | &nbsp;&nbsp;.&nbsp; |  &nbsp;&nbsp;2&nbsp; | &nbsp;&nbsp; Screw M4 cap x 16mm |
| &nbsp;&nbsp;.&nbsp; | &nbsp;&nbsp;.&nbsp; | &nbsp;&nbsp;.&nbsp; | &nbsp;&nbsp;.&nbsp; | &nbsp;&nbsp;.&nbsp; | &nbsp;&nbsp;.&nbsp; | &nbsp;&nbsp;.&nbsp; | &nbsp;&nbsp;.&nbsp; | &nbsp;&nbsp;.&nbsp; | &nbsp;&nbsp;.&nbsp; | &nbsp;&nbsp;.&nbsp; | &nbsp;&nbsp;.&nbsp; | &nbsp;&nbsp;.&nbsp; | &nbsp;&nbsp;.&nbsp; | &nbsp;&nbsp;.&nbsp; | &nbsp;&nbsp;.&nbsp; | &nbsp;&nbsp;.&nbsp; | &nbsp;&nbsp;.&nbsp; | &nbsp;&nbsp;.&nbsp; | &nbsp;&nbsp;2&nbsp; | &nbsp;&nbsp;3&nbsp; | &nbsp;&nbsp;28&nbsp; | &nbsp;&nbsp;.&nbsp; | &nbsp;&nbsp;.&nbsp; | &nbsp;&nbsp;.&nbsp; | &nbsp;&nbsp;.&nbsp; | &nbsp;&nbsp;.&nbsp; | &nbsp;&nbsp;20&nbsp; | &nbsp;&nbsp;20&nbsp; | &nbsp;&nbsp;.&nbsp; | &nbsp;&nbsp;.&nbsp; | &nbsp;&nbsp;.&nbsp; | &nbsp;&nbsp;.&nbsp; | &nbsp;&nbsp;.&nbsp; | &nbsp;&nbsp;.&nbsp; | &nbsp;&nbsp;.&nbsp; | &nbsp;&nbsp;.&nbsp; | &nbsp;&nbsp;.&nbsp; | &nbsp;&nbsp;.&nbsp; | &nbsp;&nbsp;.&nbsp; | &nbsp;&nbsp;.&nbsp; | &nbsp;&nbsp;.&nbsp; | &nbsp;&nbsp;.&nbsp; | &nbsp;&nbsp;.&nbsp; | &nbsp;&nbsp;.&nbsp; | &nbsp;&nbsp;.&nbsp; | &nbsp;&nbsp;.&nbsp; | &nbsp;&nbsp;2&nbsp; | &nbsp;&nbsp;3&nbsp; | &nbsp;&nbsp;.&nbsp; | &nbsp;&nbsp;.&nbsp; | &nbsp;&nbsp;.&nbsp; | &nbsp;&nbsp;.&nbsp; | &nbsp;&nbsp;.&nbsp; | &nbsp;&nbsp;.&nbsp; | &nbsp;&nbsp;.&nbsp; | &nbsp;&nbsp;.&nbsp; | &nbsp;&nbsp;.&nbsp; | &nbsp;&nbsp;.&nbsp; | &nbsp;&nbsp;.&nbsp; | &nbsp;&nbsp;.&nbsp; | &nbsp;&nbsp;.&nbsp; | &nbsp;&nbsp;.&nbsp; | &nbsp;&nbsp;.&nbsp; | &nbsp;&nbsp;.&nbsp; | &nbsp;&nbsp;.&nbsp; | &nbsp;&nbsp;.&nbsp; | &nbsp;&nbsp;.&nbsp; | &nbsp;&nbsp;.&nbsp; | &nbsp;&nbsp;.&nbsp; | &nbsp;&nbsp;.&nbsp; | &nbsp;&nbsp;.&nbsp; |  &nbsp;&nbsp;78&nbsp; | &nbsp;&nbsp; Screw M4 flanged x 10mm |
| &nbsp;&nbsp;.&nbsp; | &nbsp;&nbsp;.&nbsp; | &nbsp;&nbsp;.&nbsp; | &nbsp;&nbsp;4&nbsp; | &nbsp;&nbsp;.&nbsp; | &nbsp;&nbsp;.&nbsp; | &nbsp;&nbsp;.&nbsp; | &nbsp;&nbsp;.&nbsp; | &nbsp;&nbsp;.&nbsp; | &nbsp;&nbsp;.&nbsp; | &nbsp;&nbsp;.&nbsp; | &nbsp;&nbsp;.&nbsp; | &nbsp;&nbsp;.&nbsp; | &nbsp;&nbsp;.&nbsp; | &nbsp;&nbsp;.&nbsp; | &nbsp;&nbsp;.&nbsp; | &nbsp;&nbsp;.&nbsp; | &nbsp;&nbsp;.&nbsp; | &nbsp;&nbsp;.&nbsp; | &nbsp;&nbsp;.&nbsp; | &nbsp;&nbsp;.&nbsp; | &nbsp;&nbsp;.&nbsp; | &nbsp;&nbsp;.&nbsp; | &nbsp;&nbsp;.&nbsp; | &nbsp;&nbsp;.&nbsp; | &nbsp;&nbsp;.&nbsp; | &nbsp;&nbsp;.&nbsp; | &nbsp;&nbsp;.&nbsp; | &nbsp;&nbsp;.&nbsp; | &nbsp;&nbsp;.&nbsp; | &nbsp;&nbsp;.&nbsp; | &nbsp;&nbsp;.&nbsp; | &nbsp;&nbsp;.&nbsp; | &nbsp;&nbsp;.&nbsp; | &nbsp;&nbsp;.&nbsp; | &nbsp;&nbsp;.&nbsp; | &nbsp;&nbsp;.&nbsp; | &nbsp;&nbsp;.&nbsp; | &nbsp;&nbsp;.&nbsp; | &nbsp;&nbsp;.&nbsp; | &nbsp;&nbsp;.&nbsp; | &nbsp;&nbsp;.&nbsp; | &nbsp;&nbsp;.&nbsp; | &nbsp;&nbsp;.&nbsp; | &nbsp;&nbsp;.&nbsp; | &nbsp;&nbsp;.&nbsp; | &nbsp;&nbsp;.&nbsp; | &nbsp;&nbsp;.&nbsp; | &nbsp;&nbsp;.&nbsp; | &nbsp;&nbsp;.&nbsp; | &nbsp;&nbsp;.&nbsp; | &nbsp;&nbsp;.&nbsp; | &nbsp;&nbsp;.&nbsp; | &nbsp;&nbsp;.&nbsp; | &nbsp;&nbsp;.&nbsp; | &nbsp;&nbsp;.&nbsp; | &nbsp;&nbsp;.&nbsp; | &nbsp;&nbsp;.&nbsp; | &nbsp;&nbsp;.&nbsp; | &nbsp;&nbsp;.&nbsp; | &nbsp;&nbsp;.&nbsp; | &nbsp;&nbsp;.&nbsp; | &nbsp;&nbsp;.&nbsp; | &nbsp;&nbsp;.&nbsp; | &nbsp;&nbsp;.&nbsp; | &nbsp;&nbsp;.&nbsp; | &nbsp;&nbsp;.&nbsp; | &nbsp;&nbsp;.&nbsp; | &nbsp;&nbsp;.&nbsp; | &nbsp;&nbsp;.&nbsp; | &nbsp;&nbsp;.&nbsp; | &nbsp;&nbsp;.&nbsp; |  &nbsp;&nbsp;4&nbsp; | &nbsp;&nbsp; Screw M5 cap x 14mm |
| &nbsp;&nbsp;.&nbsp; | &nbsp;&nbsp;.&nbsp; | &nbsp;&nbsp;.&nbsp; | &nbsp;&nbsp;.&nbsp; | &nbsp;&nbsp;.&nbsp; | &nbsp;&nbsp;.&nbsp; | &nbsp;&nbsp;.&nbsp; | &nbsp;&nbsp;.&nbsp; | &nbsp;&nbsp;.&nbsp; | &nbsp;&nbsp;.&nbsp; | &nbsp;&nbsp;.&nbsp; | &nbsp;&nbsp;.&nbsp; | &nbsp;&nbsp;.&nbsp; | &nbsp;&nbsp;.&nbsp; | &nbsp;&nbsp;.&nbsp; | &nbsp;&nbsp;.&nbsp; | &nbsp;&nbsp;.&nbsp; | &nbsp;&nbsp;.&nbsp; | &nbsp;&nbsp;.&nbsp; | &nbsp;&nbsp;.&nbsp; | &nbsp;&nbsp;.&nbsp; | &nbsp;&nbsp;.&nbsp; | &nbsp;&nbsp;.&nbsp; | &nbsp;&nbsp;.&nbsp; | &nbsp;&nbsp;.&nbsp; | &nbsp;&nbsp;.&nbsp; | &nbsp;&nbsp;.&nbsp; | &nbsp;&nbsp;.&nbsp; | &nbsp;&nbsp;.&nbsp; | &nbsp;&nbsp;.&nbsp; | &nbsp;&nbsp;.&nbsp; | &nbsp;&nbsp;.&nbsp; | &nbsp;&nbsp;.&nbsp; | &nbsp;&nbsp;.&nbsp; | &nbsp;&nbsp;.&nbsp; | &nbsp;&nbsp;.&nbsp; | &nbsp;&nbsp;.&nbsp; | &nbsp;&nbsp;.&nbsp; | &nbsp;&nbsp;.&nbsp; | &nbsp;&nbsp;.&nbsp; | &nbsp;&nbsp;.&nbsp; | &nbsp;&nbsp;.&nbsp; | &nbsp;&nbsp;.&nbsp; | &nbsp;&nbsp;.&nbsp; | &nbsp;&nbsp;.&nbsp; | &nbsp;&nbsp;2&nbsp; | &nbsp;&nbsp;.&nbsp; | &nbsp;&nbsp;.&nbsp; | &nbsp;&nbsp;.&nbsp; | &nbsp;&nbsp;.&nbsp; | &nbsp;&nbsp;.&nbsp; | &nbsp;&nbsp;.&nbsp; | &nbsp;&nbsp;.&nbsp; | &nbsp;&nbsp;.&nbsp; | &nbsp;&nbsp;.&nbsp; | &nbsp;&nbsp;.&nbsp; | &nbsp;&nbsp;.&nbsp; | &nbsp;&nbsp;.&nbsp; | &nbsp;&nbsp;.&nbsp; | &nbsp;&nbsp;.&nbsp; | &nbsp;&nbsp;.&nbsp; | &nbsp;&nbsp;2&nbsp; | &nbsp;&nbsp;.&nbsp; | &nbsp;&nbsp;.&nbsp; | &nbsp;&nbsp;.&nbsp; | &nbsp;&nbsp;.&nbsp; | &nbsp;&nbsp;.&nbsp; | &nbsp;&nbsp;.&nbsp; | &nbsp;&nbsp;.&nbsp; | &nbsp;&nbsp;.&nbsp; | &nbsp;&nbsp;.&nbsp; | &nbsp;&nbsp;.&nbsp; |  &nbsp;&nbsp;4&nbsp; | &nbsp;&nbsp; Screw M5 cap x 16mm |
| &nbsp;&nbsp;.&nbsp; | &nbsp;&nbsp;.&nbsp; | &nbsp;&nbsp;.&nbsp; | &nbsp;&nbsp;.&nbsp; | &nbsp;&nbsp;.&nbsp; | &nbsp;&nbsp;.&nbsp; | &nbsp;&nbsp;.&nbsp; | &nbsp;&nbsp;.&nbsp; | &nbsp;&nbsp;.&nbsp; | &nbsp;&nbsp;.&nbsp; | &nbsp;&nbsp;.&nbsp; | &nbsp;&nbsp;.&nbsp; | &nbsp;&nbsp;.&nbsp; | &nbsp;&nbsp;.&nbsp; | &nbsp;&nbsp;.&nbsp; | &nbsp;&nbsp;.&nbsp; | &nbsp;&nbsp;.&nbsp; | &nbsp;&nbsp;.&nbsp; | &nbsp;&nbsp;.&nbsp; | &nbsp;&nbsp;.&nbsp; | &nbsp;&nbsp;.&nbsp; | &nbsp;&nbsp;.&nbsp; | &nbsp;&nbsp;.&nbsp; | &nbsp;&nbsp;.&nbsp; | &nbsp;&nbsp;.&nbsp; | &nbsp;&nbsp;.&nbsp; | &nbsp;&nbsp;.&nbsp; | &nbsp;&nbsp;.&nbsp; | &nbsp;&nbsp;.&nbsp; | &nbsp;&nbsp;.&nbsp; | &nbsp;&nbsp;.&nbsp; | &nbsp;&nbsp;.&nbsp; | &nbsp;&nbsp;.&nbsp; | &nbsp;&nbsp;.&nbsp; | &nbsp;&nbsp;.&nbsp; | &nbsp;&nbsp;.&nbsp; | &nbsp;&nbsp;.&nbsp; | &nbsp;&nbsp;.&nbsp; | &nbsp;&nbsp;.&nbsp; | &nbsp;&nbsp;.&nbsp; | &nbsp;&nbsp;.&nbsp; | &nbsp;&nbsp;2&nbsp; | &nbsp;&nbsp;2&nbsp; | &nbsp;&nbsp;2&nbsp; | &nbsp;&nbsp;2&nbsp; | &nbsp;&nbsp;.&nbsp; | &nbsp;&nbsp;.&nbsp; | &nbsp;&nbsp;.&nbsp; | &nbsp;&nbsp;.&nbsp; | &nbsp;&nbsp;.&nbsp; | &nbsp;&nbsp;.&nbsp; | &nbsp;&nbsp;.&nbsp; | &nbsp;&nbsp;.&nbsp; | &nbsp;&nbsp;.&nbsp; | &nbsp;&nbsp;.&nbsp; | &nbsp;&nbsp;.&nbsp; | &nbsp;&nbsp;.&nbsp; | &nbsp;&nbsp;2&nbsp; | &nbsp;&nbsp;2&nbsp; | &nbsp;&nbsp;2&nbsp; | &nbsp;&nbsp;2&nbsp; | &nbsp;&nbsp;.&nbsp; | &nbsp;&nbsp;.&nbsp; | &nbsp;&nbsp;.&nbsp; | &nbsp;&nbsp;.&nbsp; | &nbsp;&nbsp;.&nbsp; | &nbsp;&nbsp;.&nbsp; | &nbsp;&nbsp;.&nbsp; | &nbsp;&nbsp;.&nbsp; | &nbsp;&nbsp;.&nbsp; | &nbsp;&nbsp;.&nbsp; | &nbsp;&nbsp;.&nbsp; |  &nbsp;&nbsp;16&nbsp; | &nbsp;&nbsp; Screw M5 flanged x 12mm |
| &nbsp;&nbsp;.&nbsp; | &nbsp;&nbsp;.&nbsp; | &nbsp;&nbsp;.&nbsp; | &nbsp;&nbsp;.&nbsp; | &nbsp;&nbsp;.&nbsp; | &nbsp;&nbsp;.&nbsp; | &nbsp;&nbsp;.&nbsp; | &nbsp;&nbsp;.&nbsp; | &nbsp;&nbsp;.&nbsp; | &nbsp;&nbsp;.&nbsp; | &nbsp;&nbsp;.&nbsp; | &nbsp;&nbsp;.&nbsp; | &nbsp;&nbsp;.&nbsp; | &nbsp;&nbsp;.&nbsp; | &nbsp;&nbsp;.&nbsp; | &nbsp;&nbsp;.&nbsp; | &nbsp;&nbsp;.&nbsp; | &nbsp;&nbsp;.&nbsp; | &nbsp;&nbsp;48&nbsp; | &nbsp;&nbsp;.&nbsp; | &nbsp;&nbsp;.&nbsp; | &nbsp;&nbsp;.&nbsp; | &nbsp;&nbsp;.&nbsp; | &nbsp;&nbsp;.&nbsp; | &nbsp;&nbsp;.&nbsp; | &nbsp;&nbsp;.&nbsp; | &nbsp;&nbsp;.&nbsp; | &nbsp;&nbsp;.&nbsp; | &nbsp;&nbsp;.&nbsp; | &nbsp;&nbsp;.&nbsp; | &nbsp;&nbsp;.&nbsp; | &nbsp;&nbsp;.&nbsp; | &nbsp;&nbsp;.&nbsp; | &nbsp;&nbsp;.&nbsp; | &nbsp;&nbsp;.&nbsp; | &nbsp;&nbsp;.&nbsp; | &nbsp;&nbsp;.&nbsp; | &nbsp;&nbsp;.&nbsp; | &nbsp;&nbsp;.&nbsp; | &nbsp;&nbsp;.&nbsp; | &nbsp;&nbsp;.&nbsp; | &nbsp;&nbsp;.&nbsp; | &nbsp;&nbsp;.&nbsp; | &nbsp;&nbsp;.&nbsp; | &nbsp;&nbsp;.&nbsp; | &nbsp;&nbsp;.&nbsp; | &nbsp;&nbsp;.&nbsp; | &nbsp;&nbsp;.&nbsp; | &nbsp;&nbsp;.&nbsp; | &nbsp;&nbsp;.&nbsp; | &nbsp;&nbsp;.&nbsp; | &nbsp;&nbsp;.&nbsp; | &nbsp;&nbsp;.&nbsp; | &nbsp;&nbsp;.&nbsp; | &nbsp;&nbsp;.&nbsp; | &nbsp;&nbsp;.&nbsp; | &nbsp;&nbsp;.&nbsp; | &nbsp;&nbsp;.&nbsp; | &nbsp;&nbsp;.&nbsp; | &nbsp;&nbsp;.&nbsp; | &nbsp;&nbsp;.&nbsp; | &nbsp;&nbsp;.&nbsp; | &nbsp;&nbsp;.&nbsp; | &nbsp;&nbsp;.&nbsp; | &nbsp;&nbsp;.&nbsp; | &nbsp;&nbsp;.&nbsp; | &nbsp;&nbsp;.&nbsp; | &nbsp;&nbsp;.&nbsp; | &nbsp;&nbsp;.&nbsp; | &nbsp;&nbsp;.&nbsp; | &nbsp;&nbsp;.&nbsp; | &nbsp;&nbsp;.&nbsp; |  &nbsp;&nbsp;48&nbsp; | &nbsp;&nbsp; Screw M5 low profile x  8mm |
| &nbsp;&nbsp;.&nbsp; | &nbsp;&nbsp;.&nbsp; | &nbsp;&nbsp;.&nbsp; | &nbsp;&nbsp;.&nbsp; | &nbsp;&nbsp;.&nbsp; | &nbsp;&nbsp;.&nbsp; | &nbsp;&nbsp;.&nbsp; | &nbsp;&nbsp;.&nbsp; | &nbsp;&nbsp;.&nbsp; | &nbsp;&nbsp;.&nbsp; | &nbsp;&nbsp;.&nbsp; | &nbsp;&nbsp;.&nbsp; | &nbsp;&nbsp;.&nbsp; | &nbsp;&nbsp;.&nbsp; | &nbsp;&nbsp;.&nbsp; | &nbsp;&nbsp;.&nbsp; | &nbsp;&nbsp;.&nbsp; | &nbsp;&nbsp;4&nbsp; | &nbsp;&nbsp;.&nbsp; | &nbsp;&nbsp;.&nbsp; | &nbsp;&nbsp;.&nbsp; | &nbsp;&nbsp;.&nbsp; | &nbsp;&nbsp;.&nbsp; | &nbsp;&nbsp;.&nbsp; | &nbsp;&nbsp;.&nbsp; | &nbsp;&nbsp;.&nbsp; | &nbsp;&nbsp;.&nbsp; | &nbsp;&nbsp;.&nbsp; | &nbsp;&nbsp;.&nbsp; | &nbsp;&nbsp;.&nbsp; | &nbsp;&nbsp;.&nbsp; | &nbsp;&nbsp;.&nbsp; | &nbsp;&nbsp;.&nbsp; | &nbsp;&nbsp;8&nbsp; | &nbsp;&nbsp;.&nbsp; | &nbsp;&nbsp;.&nbsp; | &nbsp;&nbsp;.&nbsp; | &nbsp;&nbsp;.&nbsp; | &nbsp;&nbsp;.&nbsp; | &nbsp;&nbsp;.&nbsp; | &nbsp;&nbsp;.&nbsp; | &nbsp;&nbsp;.&nbsp; | &nbsp;&nbsp;.&nbsp; | &nbsp;&nbsp;.&nbsp; | &nbsp;&nbsp;.&nbsp; | &nbsp;&nbsp;.&nbsp; | &nbsp;&nbsp;.&nbsp; | &nbsp;&nbsp;.&nbsp; | &nbsp;&nbsp;.&nbsp; | &nbsp;&nbsp;.&nbsp; | &nbsp;&nbsp;.&nbsp; | &nbsp;&nbsp;.&nbsp; | &nbsp;&nbsp;.&nbsp; | &nbsp;&nbsp;.&nbsp; | &nbsp;&nbsp;.&nbsp; | &nbsp;&nbsp;.&nbsp; | &nbsp;&nbsp;.&nbsp; | &nbsp;&nbsp;.&nbsp; | &nbsp;&nbsp;.&nbsp; | &nbsp;&nbsp;.&nbsp; | &nbsp;&nbsp;.&nbsp; | &nbsp;&nbsp;.&nbsp; | &nbsp;&nbsp;.&nbsp; | &nbsp;&nbsp;.&nbsp; | &nbsp;&nbsp;.&nbsp; | &nbsp;&nbsp;.&nbsp; | &nbsp;&nbsp;.&nbsp; | &nbsp;&nbsp;.&nbsp; | &nbsp;&nbsp;.&nbsp; | &nbsp;&nbsp;.&nbsp; | &nbsp;&nbsp;.&nbsp; | &nbsp;&nbsp;.&nbsp; |  &nbsp;&nbsp;12&nbsp; | &nbsp;&nbsp; Screw M5 low profile x 10mm |
| &nbsp;&nbsp;.&nbsp; | &nbsp;&nbsp;.&nbsp; | &nbsp;&nbsp;.&nbsp; | &nbsp;&nbsp;.&nbsp; | &nbsp;&nbsp;.&nbsp; | &nbsp;&nbsp;.&nbsp; | &nbsp;&nbsp;.&nbsp; | &nbsp;&nbsp;.&nbsp; | &nbsp;&nbsp;.&nbsp; | &nbsp;&nbsp;.&nbsp; | &nbsp;&nbsp;.&nbsp; | &nbsp;&nbsp;.&nbsp; | &nbsp;&nbsp;.&nbsp; | &nbsp;&nbsp;.&nbsp; | &nbsp;&nbsp;.&nbsp; | &nbsp;&nbsp;.&nbsp; | &nbsp;&nbsp;.&nbsp; | &nbsp;&nbsp;4&nbsp; | &nbsp;&nbsp;.&nbsp; | &nbsp;&nbsp;.&nbsp; | &nbsp;&nbsp;.&nbsp; | &nbsp;&nbsp;.&nbsp; | &nbsp;&nbsp;.&nbsp; | &nbsp;&nbsp;.&nbsp; | &nbsp;&nbsp;.&nbsp; | &nbsp;&nbsp;.&nbsp; | &nbsp;&nbsp;.&nbsp; | &nbsp;&nbsp;.&nbsp; | &nbsp;&nbsp;.&nbsp; | &nbsp;&nbsp;.&nbsp; | &nbsp;&nbsp;.&nbsp; | &nbsp;&nbsp;.&nbsp; | &nbsp;&nbsp;.&nbsp; | &nbsp;&nbsp;.&nbsp; | &nbsp;&nbsp;.&nbsp; | &nbsp;&nbsp;.&nbsp; | &nbsp;&nbsp;.&nbsp; | &nbsp;&nbsp;.&nbsp; | &nbsp;&nbsp;.&nbsp; | &nbsp;&nbsp;.&nbsp; | &nbsp;&nbsp;.&nbsp; | &nbsp;&nbsp;.&nbsp; | &nbsp;&nbsp;.&nbsp; | &nbsp;&nbsp;.&nbsp; | &nbsp;&nbsp;.&nbsp; | &nbsp;&nbsp;.&nbsp; | &nbsp;&nbsp;.&nbsp; | &nbsp;&nbsp;.&nbsp; | &nbsp;&nbsp;.&nbsp; | &nbsp;&nbsp;.&nbsp; | &nbsp;&nbsp;.&nbsp; | &nbsp;&nbsp;.&nbsp; | &nbsp;&nbsp;.&nbsp; | &nbsp;&nbsp;.&nbsp; | &nbsp;&nbsp;.&nbsp; | &nbsp;&nbsp;.&nbsp; | &nbsp;&nbsp;.&nbsp; | &nbsp;&nbsp;.&nbsp; | &nbsp;&nbsp;.&nbsp; | &nbsp;&nbsp;.&nbsp; | &nbsp;&nbsp;.&nbsp; | &nbsp;&nbsp;.&nbsp; | &nbsp;&nbsp;.&nbsp; | &nbsp;&nbsp;.&nbsp; | &nbsp;&nbsp;.&nbsp; | &nbsp;&nbsp;.&nbsp; | &nbsp;&nbsp;.&nbsp; | &nbsp;&nbsp;.&nbsp; | &nbsp;&nbsp;.&nbsp; | &nbsp;&nbsp;.&nbsp; | &nbsp;&nbsp;.&nbsp; | &nbsp;&nbsp;.&nbsp; |  &nbsp;&nbsp;4&nbsp; | &nbsp;&nbsp; Screw M5 low profile x 12mm |
| &nbsp;&nbsp;.&nbsp; | &nbsp;&nbsp;.&nbsp; | &nbsp;&nbsp;.&nbsp; | &nbsp;&nbsp;.&nbsp; | &nbsp;&nbsp;.&nbsp; | &nbsp;&nbsp;.&nbsp; | &nbsp;&nbsp;.&nbsp; | &nbsp;&nbsp;.&nbsp; | &nbsp;&nbsp;.&nbsp; | &nbsp;&nbsp;.&nbsp; | &nbsp;&nbsp;.&nbsp; | &nbsp;&nbsp;.&nbsp; | &nbsp;&nbsp;.&nbsp; | &nbsp;&nbsp;.&nbsp; | &nbsp;&nbsp;.&nbsp; | &nbsp;&nbsp;.&nbsp; | &nbsp;&nbsp;.&nbsp; | &nbsp;&nbsp;.&nbsp; | &nbsp;&nbsp;.&nbsp; | &nbsp;&nbsp;.&nbsp; | &nbsp;&nbsp;.&nbsp; | &nbsp;&nbsp;.&nbsp; | &nbsp;&nbsp;.&nbsp; | &nbsp;&nbsp;.&nbsp; | &nbsp;&nbsp;.&nbsp; | &nbsp;&nbsp;.&nbsp; | &nbsp;&nbsp;.&nbsp; | &nbsp;&nbsp;.&nbsp; | &nbsp;&nbsp;.&nbsp; | &nbsp;&nbsp;.&nbsp; | &nbsp;&nbsp;.&nbsp; | &nbsp;&nbsp;.&nbsp; | &nbsp;&nbsp;.&nbsp; | &nbsp;&nbsp;.&nbsp; | &nbsp;&nbsp;.&nbsp; | &nbsp;&nbsp;.&nbsp; | &nbsp;&nbsp;.&nbsp; | &nbsp;&nbsp;.&nbsp; | &nbsp;&nbsp;.&nbsp; | &nbsp;&nbsp;.&nbsp; | &nbsp;&nbsp;.&nbsp; | &nbsp;&nbsp;.&nbsp; | &nbsp;&nbsp;.&nbsp; | &nbsp;&nbsp;.&nbsp; | &nbsp;&nbsp;.&nbsp; | &nbsp;&nbsp;.&nbsp; | &nbsp;&nbsp;2&nbsp; | &nbsp;&nbsp;.&nbsp; | &nbsp;&nbsp;.&nbsp; | &nbsp;&nbsp;.&nbsp; | &nbsp;&nbsp;.&nbsp; | &nbsp;&nbsp;.&nbsp; | &nbsp;&nbsp;.&nbsp; | &nbsp;&nbsp;.&nbsp; | &nbsp;&nbsp;.&nbsp; | &nbsp;&nbsp;.&nbsp; | &nbsp;&nbsp;.&nbsp; | &nbsp;&nbsp;.&nbsp; | &nbsp;&nbsp;.&nbsp; | &nbsp;&nbsp;.&nbsp; | &nbsp;&nbsp;.&nbsp; | &nbsp;&nbsp;.&nbsp; | &nbsp;&nbsp;.&nbsp; | &nbsp;&nbsp;.&nbsp; | &nbsp;&nbsp;.&nbsp; | &nbsp;&nbsp;.&nbsp; | &nbsp;&nbsp;.&nbsp; | &nbsp;&nbsp;.&nbsp; | &nbsp;&nbsp;.&nbsp; | &nbsp;&nbsp;.&nbsp; | &nbsp;&nbsp;.&nbsp; | &nbsp;&nbsp;.&nbsp; |  &nbsp;&nbsp;2&nbsp; | &nbsp;&nbsp; Stepper motor NEMA17 x 40mm |
| &nbsp;&nbsp;.&nbsp; | &nbsp;&nbsp;2&nbsp; | &nbsp;&nbsp;.&nbsp; | &nbsp;&nbsp;.&nbsp; | &nbsp;&nbsp;.&nbsp; | &nbsp;&nbsp;.&nbsp; | &nbsp;&nbsp;.&nbsp; | &nbsp;&nbsp;.&nbsp; | &nbsp;&nbsp;.&nbsp; | &nbsp;&nbsp;.&nbsp; | &nbsp;&nbsp;.&nbsp; | &nbsp;&nbsp;.&nbsp; | &nbsp;&nbsp;.&nbsp; | &nbsp;&nbsp;.&nbsp; | &nbsp;&nbsp;.&nbsp; | &nbsp;&nbsp;.&nbsp; | &nbsp;&nbsp;.&nbsp; | &nbsp;&nbsp;.&nbsp; | &nbsp;&nbsp;.&nbsp; | &nbsp;&nbsp;.&nbsp; | &nbsp;&nbsp;.&nbsp; | &nbsp;&nbsp;.&nbsp; | &nbsp;&nbsp;1&nbsp; | &nbsp;&nbsp;.&nbsp; | &nbsp;&nbsp;.&nbsp; | &nbsp;&nbsp;.&nbsp; | &nbsp;&nbsp;.&nbsp; | &nbsp;&nbsp;.&nbsp; | &nbsp;&nbsp;.&nbsp; | &nbsp;&nbsp;.&nbsp; | &nbsp;&nbsp;.&nbsp; | &nbsp;&nbsp;.&nbsp; | &nbsp;&nbsp;.&nbsp; | &nbsp;&nbsp;.&nbsp; | &nbsp;&nbsp;.&nbsp; | &nbsp;&nbsp;.&nbsp; | &nbsp;&nbsp;.&nbsp; | &nbsp;&nbsp;.&nbsp; | &nbsp;&nbsp;.&nbsp; | &nbsp;&nbsp;.&nbsp; | &nbsp;&nbsp;.&nbsp; | &nbsp;&nbsp;.&nbsp; | &nbsp;&nbsp;.&nbsp; | &nbsp;&nbsp;.&nbsp; | &nbsp;&nbsp;.&nbsp; | &nbsp;&nbsp;.&nbsp; | &nbsp;&nbsp;.&nbsp; | &nbsp;&nbsp;.&nbsp; | &nbsp;&nbsp;.&nbsp; | &nbsp;&nbsp;1&nbsp; | &nbsp;&nbsp;.&nbsp; | &nbsp;&nbsp;.&nbsp; | &nbsp;&nbsp;.&nbsp; | &nbsp;&nbsp;.&nbsp; | &nbsp;&nbsp;.&nbsp; | &nbsp;&nbsp;.&nbsp; | &nbsp;&nbsp;.&nbsp; | &nbsp;&nbsp;.&nbsp; | &nbsp;&nbsp;.&nbsp; | &nbsp;&nbsp;.&nbsp; | &nbsp;&nbsp;.&nbsp; | &nbsp;&nbsp;.&nbsp; | &nbsp;&nbsp;.&nbsp; | &nbsp;&nbsp;.&nbsp; | &nbsp;&nbsp;.&nbsp; | &nbsp;&nbsp;.&nbsp; | &nbsp;&nbsp;.&nbsp; | &nbsp;&nbsp;.&nbsp; | &nbsp;&nbsp;.&nbsp; | &nbsp;&nbsp;.&nbsp; | &nbsp;&nbsp;.&nbsp; | &nbsp;&nbsp;.&nbsp; |  &nbsp;&nbsp;4&nbsp; | &nbsp;&nbsp; Stepper motor NEMA17 x 47mm |
| &nbsp;&nbsp;.&nbsp; | &nbsp;&nbsp;.&nbsp; | &nbsp;&nbsp;.&nbsp; | &nbsp;&nbsp;4&nbsp; | &nbsp;&nbsp;.&nbsp; | &nbsp;&nbsp;.&nbsp; | &nbsp;&nbsp;.&nbsp; | &nbsp;&nbsp;.&nbsp; | &nbsp;&nbsp;.&nbsp; | &nbsp;&nbsp;.&nbsp; | &nbsp;&nbsp;.&nbsp; | &nbsp;&nbsp;.&nbsp; | &nbsp;&nbsp;.&nbsp; | &nbsp;&nbsp;.&nbsp; | &nbsp;&nbsp;.&nbsp; | &nbsp;&nbsp;.&nbsp; | &nbsp;&nbsp;.&nbsp; | &nbsp;&nbsp;.&nbsp; | &nbsp;&nbsp;.&nbsp; | &nbsp;&nbsp;.&nbsp; | &nbsp;&nbsp;.&nbsp; | &nbsp;&nbsp;.&nbsp; | &nbsp;&nbsp;.&nbsp; | &nbsp;&nbsp;.&nbsp; | &nbsp;&nbsp;.&nbsp; | &nbsp;&nbsp;.&nbsp; | &nbsp;&nbsp;.&nbsp; | &nbsp;&nbsp;.&nbsp; | &nbsp;&nbsp;.&nbsp; | &nbsp;&nbsp;.&nbsp; | &nbsp;&nbsp;.&nbsp; | &nbsp;&nbsp;.&nbsp; | &nbsp;&nbsp;.&nbsp; | &nbsp;&nbsp;.&nbsp; | &nbsp;&nbsp;.&nbsp; | &nbsp;&nbsp;.&nbsp; | &nbsp;&nbsp;.&nbsp; | &nbsp;&nbsp;.&nbsp; | &nbsp;&nbsp;.&nbsp; | &nbsp;&nbsp;.&nbsp; | &nbsp;&nbsp;.&nbsp; | &nbsp;&nbsp;.&nbsp; | &nbsp;&nbsp;.&nbsp; | &nbsp;&nbsp;.&nbsp; | &nbsp;&nbsp;.&nbsp; | &nbsp;&nbsp;.&nbsp; | &nbsp;&nbsp;.&nbsp; | &nbsp;&nbsp;.&nbsp; | &nbsp;&nbsp;.&nbsp; | &nbsp;&nbsp;.&nbsp; | &nbsp;&nbsp;.&nbsp; | &nbsp;&nbsp;.&nbsp; | &nbsp;&nbsp;.&nbsp; | &nbsp;&nbsp;.&nbsp; | &nbsp;&nbsp;.&nbsp; | &nbsp;&nbsp;.&nbsp; | &nbsp;&nbsp;.&nbsp; | &nbsp;&nbsp;.&nbsp; | &nbsp;&nbsp;.&nbsp; | &nbsp;&nbsp;.&nbsp; | &nbsp;&nbsp;.&nbsp; | &nbsp;&nbsp;.&nbsp; | &nbsp;&nbsp;.&nbsp; | &nbsp;&nbsp;.&nbsp; | &nbsp;&nbsp;.&nbsp; | &nbsp;&nbsp;.&nbsp; | &nbsp;&nbsp;.&nbsp; | &nbsp;&nbsp;.&nbsp; | &nbsp;&nbsp;.&nbsp; | &nbsp;&nbsp;.&nbsp; | &nbsp;&nbsp;.&nbsp; | &nbsp;&nbsp;.&nbsp; |  &nbsp;&nbsp;4&nbsp; | &nbsp;&nbsp; Swiss picture clip UKPFS1008_10 11mm |
| &nbsp;&nbsp;.&nbsp; | &nbsp;&nbsp;.&nbsp; | &nbsp;&nbsp;2&nbsp; | &nbsp;&nbsp;.&nbsp; | &nbsp;&nbsp;.&nbsp; | &nbsp;&nbsp;.&nbsp; | &nbsp;&nbsp;.&nbsp; | &nbsp;&nbsp;.&nbsp; | &nbsp;&nbsp;.&nbsp; | &nbsp;&nbsp;.&nbsp; | &nbsp;&nbsp;.&nbsp; | &nbsp;&nbsp;.&nbsp; | &nbsp;&nbsp;.&nbsp; | &nbsp;&nbsp;.&nbsp; | &nbsp;&nbsp;.&nbsp; | &nbsp;&nbsp;.&nbsp; | &nbsp;&nbsp;.&nbsp; | &nbsp;&nbsp;.&nbsp; | &nbsp;&nbsp;.&nbsp; | &nbsp;&nbsp;.&nbsp; | &nbsp;&nbsp;.&nbsp; | &nbsp;&nbsp;.&nbsp; | &nbsp;&nbsp;.&nbsp; | &nbsp;&nbsp;.&nbsp; | &nbsp;&nbsp;.&nbsp; | &nbsp;&nbsp;.&nbsp; | &nbsp;&nbsp;.&nbsp; | &nbsp;&nbsp;.&nbsp; | &nbsp;&nbsp;.&nbsp; | &nbsp;&nbsp;.&nbsp; | &nbsp;&nbsp;.&nbsp; | &nbsp;&nbsp;.&nbsp; | &nbsp;&nbsp;.&nbsp; | &nbsp;&nbsp;.&nbsp; | &nbsp;&nbsp;.&nbsp; | &nbsp;&nbsp;.&nbsp; | &nbsp;&nbsp;.&nbsp; | &nbsp;&nbsp;.&nbsp; | &nbsp;&nbsp;.&nbsp; | &nbsp;&nbsp;.&nbsp; | &nbsp;&nbsp;.&nbsp; | &nbsp;&nbsp;.&nbsp; | &nbsp;&nbsp;.&nbsp; | &nbsp;&nbsp;.&nbsp; | &nbsp;&nbsp;.&nbsp; | &nbsp;&nbsp;.&nbsp; | &nbsp;&nbsp;.&nbsp; | &nbsp;&nbsp;.&nbsp; | &nbsp;&nbsp;.&nbsp; | &nbsp;&nbsp;.&nbsp; | &nbsp;&nbsp;.&nbsp; | &nbsp;&nbsp;.&nbsp; | &nbsp;&nbsp;.&nbsp; | &nbsp;&nbsp;.&nbsp; | &nbsp;&nbsp;.&nbsp; | &nbsp;&nbsp;.&nbsp; | &nbsp;&nbsp;.&nbsp; | &nbsp;&nbsp;.&nbsp; | &nbsp;&nbsp;.&nbsp; | &nbsp;&nbsp;.&nbsp; | &nbsp;&nbsp;.&nbsp; | &nbsp;&nbsp;.&nbsp; | &nbsp;&nbsp;.&nbsp; | &nbsp;&nbsp;.&nbsp; | &nbsp;&nbsp;.&nbsp; | &nbsp;&nbsp;.&nbsp; | &nbsp;&nbsp;.&nbsp; | &nbsp;&nbsp;.&nbsp; | &nbsp;&nbsp;.&nbsp; | &nbsp;&nbsp;.&nbsp; | &nbsp;&nbsp;.&nbsp; | &nbsp;&nbsp;.&nbsp; |  &nbsp;&nbsp;2&nbsp; | &nbsp;&nbsp; Threaded rod M8 x 132mm |
| &nbsp;&nbsp;2&nbsp; | &nbsp;&nbsp;.&nbsp; | &nbsp;&nbsp;.&nbsp; | &nbsp;&nbsp;.&nbsp; | &nbsp;&nbsp;.&nbsp; | &nbsp;&nbsp;12&nbsp; | &nbsp;&nbsp;4&nbsp; | &nbsp;&nbsp;4&nbsp; | &nbsp;&nbsp;7&nbsp; | &nbsp;&nbsp;7&nbsp; | &nbsp;&nbsp;4&nbsp; | &nbsp;&nbsp;.&nbsp; | &nbsp;&nbsp;.&nbsp; | &nbsp;&nbsp;4&nbsp; | &nbsp;&nbsp;4&nbsp; | &nbsp;&nbsp;.&nbsp; | &nbsp;&nbsp;.&nbsp; | &nbsp;&nbsp;.&nbsp; | &nbsp;&nbsp;.&nbsp; | &nbsp;&nbsp;.&nbsp; | &nbsp;&nbsp;.&nbsp; | &nbsp;&nbsp;.&nbsp; | &nbsp;&nbsp;3&nbsp; | &nbsp;&nbsp;2&nbsp; | &nbsp;&nbsp;.&nbsp; | &nbsp;&nbsp;.&nbsp; | &nbsp;&nbsp;.&nbsp; | &nbsp;&nbsp;.&nbsp; | &nbsp;&nbsp;.&nbsp; | &nbsp;&nbsp;.&nbsp; | &nbsp;&nbsp;4&nbsp; | &nbsp;&nbsp;.&nbsp; | &nbsp;&nbsp;.&nbsp; | &nbsp;&nbsp;.&nbsp; | &nbsp;&nbsp;.&nbsp; | &nbsp;&nbsp;.&nbsp; | &nbsp;&nbsp;.&nbsp; | &nbsp;&nbsp;.&nbsp; | &nbsp;&nbsp;.&nbsp; | &nbsp;&nbsp;10&nbsp; | &nbsp;&nbsp;2&nbsp; | &nbsp;&nbsp;.&nbsp; | &nbsp;&nbsp;.&nbsp; | &nbsp;&nbsp;.&nbsp; | &nbsp;&nbsp;.&nbsp; | &nbsp;&nbsp;.&nbsp; | &nbsp;&nbsp;.&nbsp; | &nbsp;&nbsp;.&nbsp; | &nbsp;&nbsp;.&nbsp; | &nbsp;&nbsp;3&nbsp; | &nbsp;&nbsp;.&nbsp; | &nbsp;&nbsp;.&nbsp; | &nbsp;&nbsp;.&nbsp; | &nbsp;&nbsp;.&nbsp; | &nbsp;&nbsp;.&nbsp; | &nbsp;&nbsp;.&nbsp; | &nbsp;&nbsp;2&nbsp; | &nbsp;&nbsp;.&nbsp; | &nbsp;&nbsp;.&nbsp; | &nbsp;&nbsp;.&nbsp; | &nbsp;&nbsp;.&nbsp; | &nbsp;&nbsp;.&nbsp; | &nbsp;&nbsp;.&nbsp; | &nbsp;&nbsp;8&nbsp; | &nbsp;&nbsp;.&nbsp; | &nbsp;&nbsp;.&nbsp; | &nbsp;&nbsp;8&nbsp; | &nbsp;&nbsp;4&nbsp; | &nbsp;&nbsp;.&nbsp; | &nbsp;&nbsp;.&nbsp; | &nbsp;&nbsp;8&nbsp; | &nbsp;&nbsp;.&nbsp; |  &nbsp;&nbsp;102&nbsp; | &nbsp;&nbsp; Washer  M3 x 7mm x 0.5mm |
| &nbsp;&nbsp;.&nbsp; | &nbsp;&nbsp;.&nbsp; | &nbsp;&nbsp;.&nbsp; | &nbsp;&nbsp;.&nbsp; | &nbsp;&nbsp;4&nbsp; | &nbsp;&nbsp;.&nbsp; | &nbsp;&nbsp;2&nbsp; | &nbsp;&nbsp;2&nbsp; | &nbsp;&nbsp;.&nbsp; | &nbsp;&nbsp;.&nbsp; | &nbsp;&nbsp;.&nbsp; | &nbsp;&nbsp;.&nbsp; | &nbsp;&nbsp;.&nbsp; | &nbsp;&nbsp;.&nbsp; | &nbsp;&nbsp;.&nbsp; | &nbsp;&nbsp;.&nbsp; | &nbsp;&nbsp;6&nbsp; | &nbsp;&nbsp;.&nbsp; | &nbsp;&nbsp;.&nbsp; | &nbsp;&nbsp;.&nbsp; | &nbsp;&nbsp;.&nbsp; | &nbsp;&nbsp;.&nbsp; | &nbsp;&nbsp;3&nbsp; | &nbsp;&nbsp;1&nbsp; | &nbsp;&nbsp;.&nbsp; | &nbsp;&nbsp;.&nbsp; | &nbsp;&nbsp;.&nbsp; | &nbsp;&nbsp;.&nbsp; | &nbsp;&nbsp;.&nbsp; | &nbsp;&nbsp;6&nbsp; | &nbsp;&nbsp;.&nbsp; | &nbsp;&nbsp;.&nbsp; | &nbsp;&nbsp;.&nbsp; | &nbsp;&nbsp;.&nbsp; | &nbsp;&nbsp;2&nbsp; | &nbsp;&nbsp;12&nbsp; | &nbsp;&nbsp;.&nbsp; | &nbsp;&nbsp;.&nbsp; | &nbsp;&nbsp;.&nbsp; | &nbsp;&nbsp;.&nbsp; | &nbsp;&nbsp;3&nbsp; | &nbsp;&nbsp;.&nbsp; | &nbsp;&nbsp;4&nbsp; | &nbsp;&nbsp;.&nbsp; | &nbsp;&nbsp;.&nbsp; | &nbsp;&nbsp;4&nbsp; | &nbsp;&nbsp;4&nbsp; | &nbsp;&nbsp;.&nbsp; | &nbsp;&nbsp;.&nbsp; | &nbsp;&nbsp;3&nbsp; | &nbsp;&nbsp;.&nbsp; | &nbsp;&nbsp;.&nbsp; | &nbsp;&nbsp;.&nbsp; | &nbsp;&nbsp;.&nbsp; | &nbsp;&nbsp;.&nbsp; | &nbsp;&nbsp;.&nbsp; | &nbsp;&nbsp;3&nbsp; | &nbsp;&nbsp;4&nbsp; | &nbsp;&nbsp;.&nbsp; | &nbsp;&nbsp;4&nbsp; | &nbsp;&nbsp;.&nbsp; | &nbsp;&nbsp;4&nbsp; | &nbsp;&nbsp;.&nbsp; | &nbsp;&nbsp;.&nbsp; | &nbsp;&nbsp;.&nbsp; | &nbsp;&nbsp;.&nbsp; | &nbsp;&nbsp;.&nbsp; | &nbsp;&nbsp;.&nbsp; | &nbsp;&nbsp;.&nbsp; | &nbsp;&nbsp;.&nbsp; | &nbsp;&nbsp;.&nbsp; | &nbsp;&nbsp;8&nbsp; |  &nbsp;&nbsp;79&nbsp; | &nbsp;&nbsp; Washer  M4 x 9mm x 0.8mm |
| &nbsp;&nbsp;.&nbsp; | &nbsp;&nbsp;.&nbsp; | &nbsp;&nbsp;.&nbsp; | &nbsp;&nbsp;.&nbsp; | &nbsp;&nbsp;.&nbsp; | &nbsp;&nbsp;.&nbsp; | &nbsp;&nbsp;.&nbsp; | &nbsp;&nbsp;.&nbsp; | &nbsp;&nbsp;.&nbsp; | &nbsp;&nbsp;.&nbsp; | &nbsp;&nbsp;.&nbsp; | &nbsp;&nbsp;.&nbsp; | &nbsp;&nbsp;.&nbsp; | &nbsp;&nbsp;.&nbsp; | &nbsp;&nbsp;.&nbsp; | &nbsp;&nbsp;.&nbsp; | &nbsp;&nbsp;.&nbsp; | &nbsp;&nbsp;.&nbsp; | &nbsp;&nbsp;48&nbsp; | &nbsp;&nbsp;.&nbsp; | &nbsp;&nbsp;.&nbsp; | &nbsp;&nbsp;.&nbsp; | &nbsp;&nbsp;.&nbsp; | &nbsp;&nbsp;.&nbsp; | &nbsp;&nbsp;.&nbsp; | &nbsp;&nbsp;.&nbsp; | &nbsp;&nbsp;.&nbsp; | &nbsp;&nbsp;.&nbsp; | &nbsp;&nbsp;.&nbsp; | &nbsp;&nbsp;.&nbsp; | &nbsp;&nbsp;.&nbsp; | &nbsp;&nbsp;.&nbsp; | &nbsp;&nbsp;.&nbsp; | &nbsp;&nbsp;.&nbsp; | &nbsp;&nbsp;.&nbsp; | &nbsp;&nbsp;.&nbsp; | &nbsp;&nbsp;.&nbsp; | &nbsp;&nbsp;.&nbsp; | &nbsp;&nbsp;.&nbsp; | &nbsp;&nbsp;.&nbsp; | &nbsp;&nbsp;.&nbsp; | &nbsp;&nbsp;.&nbsp; | &nbsp;&nbsp;.&nbsp; | &nbsp;&nbsp;.&nbsp; | &nbsp;&nbsp;.&nbsp; | &nbsp;&nbsp;2&nbsp; | &nbsp;&nbsp;.&nbsp; | &nbsp;&nbsp;.&nbsp; | &nbsp;&nbsp;.&nbsp; | &nbsp;&nbsp;.&nbsp; | &nbsp;&nbsp;.&nbsp; | &nbsp;&nbsp;.&nbsp; | &nbsp;&nbsp;.&nbsp; | &nbsp;&nbsp;.&nbsp; | &nbsp;&nbsp;.&nbsp; | &nbsp;&nbsp;.&nbsp; | &nbsp;&nbsp;.&nbsp; | &nbsp;&nbsp;.&nbsp; | &nbsp;&nbsp;.&nbsp; | &nbsp;&nbsp;.&nbsp; | &nbsp;&nbsp;.&nbsp; | &nbsp;&nbsp;2&nbsp; | &nbsp;&nbsp;.&nbsp; | &nbsp;&nbsp;.&nbsp; | &nbsp;&nbsp;.&nbsp; | &nbsp;&nbsp;.&nbsp; | &nbsp;&nbsp;.&nbsp; | &nbsp;&nbsp;.&nbsp; | &nbsp;&nbsp;.&nbsp; | &nbsp;&nbsp;.&nbsp; | &nbsp;&nbsp;.&nbsp; | &nbsp;&nbsp;.&nbsp; |  &nbsp;&nbsp;52&nbsp; | &nbsp;&nbsp; Washer  M5 x 10mm x 1mm |
| &nbsp;&nbsp;.&nbsp; | &nbsp;&nbsp;.&nbsp; | &nbsp;&nbsp;8&nbsp; | &nbsp;&nbsp;.&nbsp; | &nbsp;&nbsp;.&nbsp; | &nbsp;&nbsp;.&nbsp; | &nbsp;&nbsp;.&nbsp; | &nbsp;&nbsp;.&nbsp; | &nbsp;&nbsp;.&nbsp; | &nbsp;&nbsp;.&nbsp; | &nbsp;&nbsp;.&nbsp; | &nbsp;&nbsp;.&nbsp; | &nbsp;&nbsp;.&nbsp; | &nbsp;&nbsp;.&nbsp; | &nbsp;&nbsp;.&nbsp; | &nbsp;&nbsp;.&nbsp; | &nbsp;&nbsp;.&nbsp; | &nbsp;&nbsp;.&nbsp; | &nbsp;&nbsp;.&nbsp; | &nbsp;&nbsp;.&nbsp; | &nbsp;&nbsp;.&nbsp; | &nbsp;&nbsp;.&nbsp; | &nbsp;&nbsp;.&nbsp; | &nbsp;&nbsp;.&nbsp; | &nbsp;&nbsp;.&nbsp; | &nbsp;&nbsp;.&nbsp; | &nbsp;&nbsp;.&nbsp; | &nbsp;&nbsp;.&nbsp; | &nbsp;&nbsp;.&nbsp; | &nbsp;&nbsp;.&nbsp; | &nbsp;&nbsp;.&nbsp; | &nbsp;&nbsp;.&nbsp; | &nbsp;&nbsp;.&nbsp; | &nbsp;&nbsp;.&nbsp; | &nbsp;&nbsp;.&nbsp; | &nbsp;&nbsp;.&nbsp; | &nbsp;&nbsp;.&nbsp; | &nbsp;&nbsp;.&nbsp; | &nbsp;&nbsp;.&nbsp; | &nbsp;&nbsp;.&nbsp; | &nbsp;&nbsp;.&nbsp; | &nbsp;&nbsp;.&nbsp; | &nbsp;&nbsp;.&nbsp; | &nbsp;&nbsp;.&nbsp; | &nbsp;&nbsp;.&nbsp; | &nbsp;&nbsp;.&nbsp; | &nbsp;&nbsp;.&nbsp; | &nbsp;&nbsp;.&nbsp; | &nbsp;&nbsp;.&nbsp; | &nbsp;&nbsp;.&nbsp; | &nbsp;&nbsp;.&nbsp; | &nbsp;&nbsp;.&nbsp; | &nbsp;&nbsp;.&nbsp; | &nbsp;&nbsp;.&nbsp; | &nbsp;&nbsp;.&nbsp; | &nbsp;&nbsp;.&nbsp; | &nbsp;&nbsp;.&nbsp; | &nbsp;&nbsp;.&nbsp; | &nbsp;&nbsp;.&nbsp; | &nbsp;&nbsp;.&nbsp; | &nbsp;&nbsp;.&nbsp; | &nbsp;&nbsp;.&nbsp; | &nbsp;&nbsp;.&nbsp; | &nbsp;&nbsp;.&nbsp; | &nbsp;&nbsp;.&nbsp; | &nbsp;&nbsp;4&nbsp; | &nbsp;&nbsp;.&nbsp; | &nbsp;&nbsp;.&nbsp; | &nbsp;&nbsp;.&nbsp; | &nbsp;&nbsp;.&nbsp; | &nbsp;&nbsp;.&nbsp; | &nbsp;&nbsp;.&nbsp; |  &nbsp;&nbsp;12&nbsp; | &nbsp;&nbsp; Washer  M8 x 17mm x 1.6mm |
| &nbsp;&nbsp;.&nbsp; | &nbsp;&nbsp;.&nbsp; | &nbsp;&nbsp;4&nbsp; | &nbsp;&nbsp;.&nbsp; | &nbsp;&nbsp;.&nbsp; | &nbsp;&nbsp;.&nbsp; | &nbsp;&nbsp;.&nbsp; | &nbsp;&nbsp;.&nbsp; | &nbsp;&nbsp;.&nbsp; | &nbsp;&nbsp;.&nbsp; | &nbsp;&nbsp;.&nbsp; | &nbsp;&nbsp;.&nbsp; | &nbsp;&nbsp;.&nbsp; | &nbsp;&nbsp;.&nbsp; | &nbsp;&nbsp;.&nbsp; | &nbsp;&nbsp;.&nbsp; | &nbsp;&nbsp;.&nbsp; | &nbsp;&nbsp;.&nbsp; | &nbsp;&nbsp;.&nbsp; | &nbsp;&nbsp;.&nbsp; | &nbsp;&nbsp;.&nbsp; | &nbsp;&nbsp;.&nbsp; | &nbsp;&nbsp;.&nbsp; | &nbsp;&nbsp;.&nbsp; | &nbsp;&nbsp;.&nbsp; | &nbsp;&nbsp;.&nbsp; | &nbsp;&nbsp;.&nbsp; | &nbsp;&nbsp;.&nbsp; | &nbsp;&nbsp;.&nbsp; | &nbsp;&nbsp;.&nbsp; | &nbsp;&nbsp;.&nbsp; | &nbsp;&nbsp;.&nbsp; | &nbsp;&nbsp;.&nbsp; | &nbsp;&nbsp;.&nbsp; | &nbsp;&nbsp;.&nbsp; | &nbsp;&nbsp;.&nbsp; | &nbsp;&nbsp;.&nbsp; | &nbsp;&nbsp;.&nbsp; | &nbsp;&nbsp;.&nbsp; | &nbsp;&nbsp;.&nbsp; | &nbsp;&nbsp;.&nbsp; | &nbsp;&nbsp;.&nbsp; | &nbsp;&nbsp;.&nbsp; | &nbsp;&nbsp;.&nbsp; | &nbsp;&nbsp;.&nbsp; | &nbsp;&nbsp;.&nbsp; | &nbsp;&nbsp;.&nbsp; | &nbsp;&nbsp;.&nbsp; | &nbsp;&nbsp;.&nbsp; | &nbsp;&nbsp;.&nbsp; | &nbsp;&nbsp;.&nbsp; | &nbsp;&nbsp;.&nbsp; | &nbsp;&nbsp;.&nbsp; | &nbsp;&nbsp;.&nbsp; | &nbsp;&nbsp;.&nbsp; | &nbsp;&nbsp;.&nbsp; | &nbsp;&nbsp;.&nbsp; | &nbsp;&nbsp;.&nbsp; | &nbsp;&nbsp;.&nbsp; | &nbsp;&nbsp;.&nbsp; | &nbsp;&nbsp;.&nbsp; | &nbsp;&nbsp;.&nbsp; | &nbsp;&nbsp;.&nbsp; | &nbsp;&nbsp;.&nbsp; | &nbsp;&nbsp;.&nbsp; | &nbsp;&nbsp;.&nbsp; | &nbsp;&nbsp;.&nbsp; | &nbsp;&nbsp;.&nbsp; | &nbsp;&nbsp;.&nbsp; | &nbsp;&nbsp;.&nbsp; | &nbsp;&nbsp;.&nbsp; | &nbsp;&nbsp;.&nbsp; |  &nbsp;&nbsp;4&nbsp; | &nbsp;&nbsp; Washer penny  M8 x 30mm x 1.5mm |
| &nbsp;&nbsp;.&nbsp; | &nbsp;&nbsp;.&nbsp; | &nbsp;&nbsp;.&nbsp; | &nbsp;&nbsp;.&nbsp; | &nbsp;&nbsp;.&nbsp; | &nbsp;&nbsp;.&nbsp; | &nbsp;&nbsp;.&nbsp; | &nbsp;&nbsp;.&nbsp; | &nbsp;&nbsp;.&nbsp; | &nbsp;&nbsp;.&nbsp; | &nbsp;&nbsp;.&nbsp; | &nbsp;&nbsp;.&nbsp; | &nbsp;&nbsp;.&nbsp; | &nbsp;&nbsp;.&nbsp; | &nbsp;&nbsp;.&nbsp; | &nbsp;&nbsp;.&nbsp; | &nbsp;&nbsp;.&nbsp; | &nbsp;&nbsp;.&nbsp; | &nbsp;&nbsp;.&nbsp; | &nbsp;&nbsp;.&nbsp; | &nbsp;&nbsp;.&nbsp; | &nbsp;&nbsp;.&nbsp; | &nbsp;&nbsp;.&nbsp; | &nbsp;&nbsp;.&nbsp; | &nbsp;&nbsp;.&nbsp; | &nbsp;&nbsp;.&nbsp; | &nbsp;&nbsp;.&nbsp; | &nbsp;&nbsp;.&nbsp; | &nbsp;&nbsp;.&nbsp; | &nbsp;&nbsp;.&nbsp; | &nbsp;&nbsp;.&nbsp; | &nbsp;&nbsp;.&nbsp; | &nbsp;&nbsp;.&nbsp; | &nbsp;&nbsp;.&nbsp; | &nbsp;&nbsp;.&nbsp; | &nbsp;&nbsp;.&nbsp; | &nbsp;&nbsp;.&nbsp; | &nbsp;&nbsp;.&nbsp; | &nbsp;&nbsp;.&nbsp; | &nbsp;&nbsp;.&nbsp; | &nbsp;&nbsp;.&nbsp; | &nbsp;&nbsp;.&nbsp; | &nbsp;&nbsp;.&nbsp; | &nbsp;&nbsp;.&nbsp; | &nbsp;&nbsp;.&nbsp; | &nbsp;&nbsp;.&nbsp; | &nbsp;&nbsp;.&nbsp; | &nbsp;&nbsp;.&nbsp; | &nbsp;&nbsp;.&nbsp; | &nbsp;&nbsp;.&nbsp; | &nbsp;&nbsp;.&nbsp; | &nbsp;&nbsp;.&nbsp; | &nbsp;&nbsp;.&nbsp; | &nbsp;&nbsp;.&nbsp; | &nbsp;&nbsp;.&nbsp; | &nbsp;&nbsp;.&nbsp; | &nbsp;&nbsp;.&nbsp; | &nbsp;&nbsp;.&nbsp; | &nbsp;&nbsp;.&nbsp; | &nbsp;&nbsp;.&nbsp; | &nbsp;&nbsp;.&nbsp; | &nbsp;&nbsp;.&nbsp; | &nbsp;&nbsp;.&nbsp; | &nbsp;&nbsp;.&nbsp; | &nbsp;&nbsp;.&nbsp; | &nbsp;&nbsp;.&nbsp; | &nbsp;&nbsp;.&nbsp; | &nbsp;&nbsp;2&nbsp; | &nbsp;&nbsp;.&nbsp; | &nbsp;&nbsp;.&nbsp; | &nbsp;&nbsp;.&nbsp; | &nbsp;&nbsp;.&nbsp; |  &nbsp;&nbsp;2&nbsp; | &nbsp;&nbsp; Washer star M12 x 1mm |
| &nbsp;&nbsp;.&nbsp; | &nbsp;&nbsp;.&nbsp; | &nbsp;&nbsp;.&nbsp; | &nbsp;&nbsp;2&nbsp; | &nbsp;&nbsp;.&nbsp; | &nbsp;&nbsp;.&nbsp; | &nbsp;&nbsp;.&nbsp; | &nbsp;&nbsp;.&nbsp; | &nbsp;&nbsp;.&nbsp; | &nbsp;&nbsp;.&nbsp; | &nbsp;&nbsp;.&nbsp; | &nbsp;&nbsp;.&nbsp; | &nbsp;&nbsp;.&nbsp; | &nbsp;&nbsp;.&nbsp; | &nbsp;&nbsp;.&nbsp; | &nbsp;&nbsp;.&nbsp; | &nbsp;&nbsp;.&nbsp; | &nbsp;&nbsp;.&nbsp; | &nbsp;&nbsp;.&nbsp; | &nbsp;&nbsp;.&nbsp; | &nbsp;&nbsp;.&nbsp; | &nbsp;&nbsp;.&nbsp; | &nbsp;&nbsp;.&nbsp; | &nbsp;&nbsp;.&nbsp; | &nbsp;&nbsp;.&nbsp; | &nbsp;&nbsp;.&nbsp; | &nbsp;&nbsp;.&nbsp; | &nbsp;&nbsp;.&nbsp; | &nbsp;&nbsp;.&nbsp; | &nbsp;&nbsp;.&nbsp; | &nbsp;&nbsp;.&nbsp; | &nbsp;&nbsp;.&nbsp; | &nbsp;&nbsp;.&nbsp; | &nbsp;&nbsp;.&nbsp; | &nbsp;&nbsp;.&nbsp; | &nbsp;&nbsp;.&nbsp; | &nbsp;&nbsp;.&nbsp; | &nbsp;&nbsp;.&nbsp; | &nbsp;&nbsp;.&nbsp; | &nbsp;&nbsp;.&nbsp; | &nbsp;&nbsp;.&nbsp; | &nbsp;&nbsp;.&nbsp; | &nbsp;&nbsp;.&nbsp; | &nbsp;&nbsp;.&nbsp; | &nbsp;&nbsp;.&nbsp; | &nbsp;&nbsp;.&nbsp; | &nbsp;&nbsp;.&nbsp; | &nbsp;&nbsp;.&nbsp; | &nbsp;&nbsp;.&nbsp; | &nbsp;&nbsp;.&nbsp; | &nbsp;&nbsp;.&nbsp; | &nbsp;&nbsp;.&nbsp; | &nbsp;&nbsp;.&nbsp; | &nbsp;&nbsp;.&nbsp; | &nbsp;&nbsp;.&nbsp; | &nbsp;&nbsp;.&nbsp; | &nbsp;&nbsp;.&nbsp; | &nbsp;&nbsp;.&nbsp; | &nbsp;&nbsp;.&nbsp; | &nbsp;&nbsp;.&nbsp; | &nbsp;&nbsp;.&nbsp; | &nbsp;&nbsp;.&nbsp; | &nbsp;&nbsp;.&nbsp; | &nbsp;&nbsp;.&nbsp; | &nbsp;&nbsp;.&nbsp; | &nbsp;&nbsp;.&nbsp; | &nbsp;&nbsp;.&nbsp; | &nbsp;&nbsp;.&nbsp; | &nbsp;&nbsp;.&nbsp; | &nbsp;&nbsp;.&nbsp; | &nbsp;&nbsp;.&nbsp; | &nbsp;&nbsp;.&nbsp; |  &nbsp;&nbsp;2&nbsp; | &nbsp;&nbsp; aluminium flat bar 20mm x 260mm x 5mm |
| &nbsp;&nbsp;.&nbsp; | &nbsp;&nbsp;.&nbsp; | &nbsp;&nbsp;.&nbsp; | &nbsp;&nbsp;1&nbsp; | &nbsp;&nbsp;.&nbsp; | &nbsp;&nbsp;.&nbsp; | &nbsp;&nbsp;.&nbsp; | &nbsp;&nbsp;.&nbsp; | &nbsp;&nbsp;.&nbsp; | &nbsp;&nbsp;.&nbsp; | &nbsp;&nbsp;.&nbsp; | &nbsp;&nbsp;.&nbsp; | &nbsp;&nbsp;.&nbsp; | &nbsp;&nbsp;.&nbsp; | &nbsp;&nbsp;.&nbsp; | &nbsp;&nbsp;.&nbsp; | &nbsp;&nbsp;.&nbsp; | &nbsp;&nbsp;.&nbsp; | &nbsp;&nbsp;.&nbsp; | &nbsp;&nbsp;.&nbsp; | &nbsp;&nbsp;.&nbsp; | &nbsp;&nbsp;.&nbsp; | &nbsp;&nbsp;.&nbsp; | &nbsp;&nbsp;.&nbsp; | &nbsp;&nbsp;.&nbsp; | &nbsp;&nbsp;.&nbsp; | &nbsp;&nbsp;.&nbsp; | &nbsp;&nbsp;.&nbsp; | &nbsp;&nbsp;.&nbsp; | &nbsp;&nbsp;.&nbsp; | &nbsp;&nbsp;.&nbsp; | &nbsp;&nbsp;.&nbsp; | &nbsp;&nbsp;.&nbsp; | &nbsp;&nbsp;.&nbsp; | &nbsp;&nbsp;.&nbsp; | &nbsp;&nbsp;.&nbsp; | &nbsp;&nbsp;.&nbsp; | &nbsp;&nbsp;.&nbsp; | &nbsp;&nbsp;.&nbsp; | &nbsp;&nbsp;.&nbsp; | &nbsp;&nbsp;.&nbsp; | &nbsp;&nbsp;.&nbsp; | &nbsp;&nbsp;.&nbsp; | &nbsp;&nbsp;.&nbsp; | &nbsp;&nbsp;.&nbsp; | &nbsp;&nbsp;.&nbsp; | &nbsp;&nbsp;.&nbsp; | &nbsp;&nbsp;.&nbsp; | &nbsp;&nbsp;.&nbsp; | &nbsp;&nbsp;.&nbsp; | &nbsp;&nbsp;.&nbsp; | &nbsp;&nbsp;.&nbsp; | &nbsp;&nbsp;.&nbsp; | &nbsp;&nbsp;.&nbsp; | &nbsp;&nbsp;.&nbsp; | &nbsp;&nbsp;.&nbsp; | &nbsp;&nbsp;.&nbsp; | &nbsp;&nbsp;.&nbsp; | &nbsp;&nbsp;.&nbsp; | &nbsp;&nbsp;.&nbsp; | &nbsp;&nbsp;.&nbsp; | &nbsp;&nbsp;.&nbsp; | &nbsp;&nbsp;.&nbsp; | &nbsp;&nbsp;.&nbsp; | &nbsp;&nbsp;.&nbsp; | &nbsp;&nbsp;.&nbsp; | &nbsp;&nbsp;.&nbsp; | &nbsp;&nbsp;.&nbsp; | &nbsp;&nbsp;.&nbsp; | &nbsp;&nbsp;.&nbsp; | &nbsp;&nbsp;.&nbsp; | &nbsp;&nbsp;.&nbsp; |  &nbsp;&nbsp;1&nbsp; | &nbsp;&nbsp; aluminium plate 314mm x 214mm x 3mm |
| &nbsp;&nbsp;5&nbsp; | &nbsp;&nbsp;4&nbsp; | &nbsp;&nbsp;26&nbsp; | &nbsp;&nbsp;15&nbsp; | &nbsp;&nbsp;14&nbsp; | &nbsp;&nbsp;20&nbsp; | &nbsp;&nbsp;14&nbsp; | &nbsp;&nbsp;14&nbsp; | &nbsp;&nbsp;20&nbsp; | &nbsp;&nbsp;21&nbsp; | &nbsp;&nbsp;8&nbsp; | &nbsp;&nbsp;34&nbsp; | &nbsp;&nbsp;1&nbsp; | &nbsp;&nbsp;8&nbsp; | &nbsp;&nbsp;8&nbsp; | &nbsp;&nbsp;.&nbsp; | &nbsp;&nbsp;19&nbsp; | &nbsp;&nbsp;16&nbsp; | &nbsp;&nbsp;168&nbsp; | &nbsp;&nbsp;4&nbsp; | &nbsp;&nbsp;6&nbsp; | &nbsp;&nbsp;56&nbsp; | &nbsp;&nbsp;18&nbsp; | &nbsp;&nbsp;8&nbsp; | &nbsp;&nbsp;36&nbsp; | &nbsp;&nbsp;1&nbsp; | &nbsp;&nbsp;1&nbsp; | &nbsp;&nbsp;40&nbsp; | &nbsp;&nbsp;40&nbsp; | &nbsp;&nbsp;18&nbsp; | &nbsp;&nbsp;14&nbsp; | &nbsp;&nbsp;34&nbsp; | &nbsp;&nbsp;1&nbsp; | &nbsp;&nbsp;20&nbsp; | &nbsp;&nbsp;6&nbsp; | &nbsp;&nbsp;36&nbsp; | &nbsp;&nbsp;1&nbsp; | &nbsp;&nbsp;.&nbsp; | &nbsp;&nbsp;.&nbsp; | &nbsp;&nbsp;18&nbsp; | &nbsp;&nbsp;13&nbsp; | &nbsp;&nbsp;8&nbsp; | &nbsp;&nbsp;10&nbsp; | &nbsp;&nbsp;3&nbsp; | &nbsp;&nbsp;2&nbsp; | &nbsp;&nbsp;20&nbsp; | &nbsp;&nbsp;16&nbsp; | &nbsp;&nbsp;4&nbsp; | &nbsp;&nbsp;6&nbsp; | &nbsp;&nbsp;18&nbsp; | &nbsp;&nbsp;1&nbsp; | &nbsp;&nbsp;1&nbsp; | &nbsp;&nbsp;1&nbsp; | &nbsp;&nbsp;1&nbsp; | &nbsp;&nbsp;.&nbsp; | &nbsp;&nbsp;.&nbsp; | &nbsp;&nbsp;13&nbsp; | &nbsp;&nbsp;16&nbsp; | &nbsp;&nbsp;2&nbsp; | &nbsp;&nbsp;15&nbsp; | &nbsp;&nbsp;2&nbsp; | &nbsp;&nbsp;20&nbsp; | &nbsp;&nbsp;2&nbsp; | &nbsp;&nbsp;16&nbsp; | &nbsp;&nbsp;.&nbsp; | &nbsp;&nbsp;10&nbsp; | &nbsp;&nbsp;16&nbsp; | &nbsp;&nbsp;14&nbsp; | &nbsp;&nbsp;2&nbsp; | &nbsp;&nbsp;3&nbsp; | &nbsp;&nbsp;19&nbsp; | &nbsp;&nbsp;17&nbsp; | &nbsp;&nbsp;1044&nbsp; | &nbsp;&nbsp;Total vitamins count |
|  |  |  |  |  |  |  |  |  |  |  |  |  |  |  |  |  |  |  |  |  |  |  |  |  |  |  |  |  |  |  |  |  |  |  |  |  |  |  |  |  |  |  |  |  |  |  |  |  |  |  |  |  |  |  |  |  |  |  |  |  |  |  |  |  |  |  |  |  |  |  |  | | **3D printed parts** |
| &nbsp;&nbsp;.&nbsp; | &nbsp;&nbsp;.&nbsp; | &nbsp;&nbsp;.&nbsp; | &nbsp;&nbsp;.&nbsp; | &nbsp;&nbsp;.&nbsp; | &nbsp;&nbsp;.&nbsp; | &nbsp;&nbsp;.&nbsp; | &nbsp;&nbsp;.&nbsp; | &nbsp;&nbsp;.&nbsp; | &nbsp;&nbsp;.&nbsp; | &nbsp;&nbsp;.&nbsp; | &nbsp;&nbsp;.&nbsp; | &nbsp;&nbsp;.&nbsp; | &nbsp;&nbsp;.&nbsp; | &nbsp;&nbsp;.&nbsp; | &nbsp;&nbsp;.&nbsp; | &nbsp;&nbsp;.&nbsp; | &nbsp;&nbsp;.&nbsp; | &nbsp;&nbsp;.&nbsp; | &nbsp;&nbsp;.&nbsp; | &nbsp;&nbsp;1&nbsp; | &nbsp;&nbsp;.&nbsp; | &nbsp;&nbsp;.&nbsp; | &nbsp;&nbsp;.&nbsp; | &nbsp;&nbsp;.&nbsp; | &nbsp;&nbsp;.&nbsp; | &nbsp;&nbsp;.&nbsp; | &nbsp;&nbsp;.&nbsp; | &nbsp;&nbsp;.&nbsp; | &nbsp;&nbsp;.&nbsp; | &nbsp;&nbsp;.&nbsp; | &nbsp;&nbsp;.&nbsp; | &nbsp;&nbsp;.&nbsp; | &nbsp;&nbsp;.&nbsp; | &nbsp;&nbsp;.&nbsp; | &nbsp;&nbsp;.&nbsp; | &nbsp;&nbsp;.&nbsp; | &nbsp;&nbsp;.&nbsp; | &nbsp;&nbsp;.&nbsp; | &nbsp;&nbsp;.&nbsp; | &nbsp;&nbsp;.&nbsp; | &nbsp;&nbsp;.&nbsp; | &nbsp;&nbsp;.&nbsp; | &nbsp;&nbsp;.&nbsp; | &nbsp;&nbsp;.&nbsp; | &nbsp;&nbsp;.&nbsp; | &nbsp;&nbsp;.&nbsp; | &nbsp;&nbsp;.&nbsp; | &nbsp;&nbsp;1&nbsp; | &nbsp;&nbsp;.&nbsp; | &nbsp;&nbsp;.&nbsp; | &nbsp;&nbsp;.&nbsp; | &nbsp;&nbsp;.&nbsp; | &nbsp;&nbsp;.&nbsp; | &nbsp;&nbsp;.&nbsp; | &nbsp;&nbsp;.&nbsp; | &nbsp;&nbsp;.&nbsp; | &nbsp;&nbsp;.&nbsp; | &nbsp;&nbsp;.&nbsp; | &nbsp;&nbsp;.&nbsp; | &nbsp;&nbsp;.&nbsp; | &nbsp;&nbsp;.&nbsp; | &nbsp;&nbsp;.&nbsp; | &nbsp;&nbsp;.&nbsp; | &nbsp;&nbsp;.&nbsp; | &nbsp;&nbsp;.&nbsp; | &nbsp;&nbsp;.&nbsp; | &nbsp;&nbsp;.&nbsp; | &nbsp;&nbsp;.&nbsp; | &nbsp;&nbsp;.&nbsp; | &nbsp;&nbsp;.&nbsp; | &nbsp;&nbsp;.&nbsp; |  &nbsp;&nbsp;2&nbsp; | &nbsp;&nbsp;back_top_corner.stl |
| &nbsp;&nbsp;.&nbsp; | &nbsp;&nbsp;.&nbsp; | &nbsp;&nbsp;.&nbsp; | &nbsp;&nbsp;.&nbsp; | &nbsp;&nbsp;.&nbsp; | &nbsp;&nbsp;.&nbsp; | &nbsp;&nbsp;.&nbsp; | &nbsp;&nbsp;.&nbsp; | &nbsp;&nbsp;2&nbsp; | &nbsp;&nbsp;2&nbsp; | &nbsp;&nbsp;.&nbsp; | &nbsp;&nbsp;.&nbsp; | &nbsp;&nbsp;.&nbsp; | &nbsp;&nbsp;.&nbsp; | &nbsp;&nbsp;.&nbsp; | &nbsp;&nbsp;.&nbsp; | &nbsp;&nbsp;.&nbsp; | &nbsp;&nbsp;.&nbsp; | &nbsp;&nbsp;.&nbsp; | &nbsp;&nbsp;.&nbsp; | &nbsp;&nbsp;.&nbsp; | &nbsp;&nbsp;.&nbsp; | &nbsp;&nbsp;.&nbsp; | &nbsp;&nbsp;.&nbsp; | &nbsp;&nbsp;.&nbsp; | &nbsp;&nbsp;.&nbsp; | &nbsp;&nbsp;.&nbsp; | &nbsp;&nbsp;.&nbsp; | &nbsp;&nbsp;.&nbsp; | &nbsp;&nbsp;.&nbsp; | &nbsp;&nbsp;.&nbsp; | &nbsp;&nbsp;.&nbsp; | &nbsp;&nbsp;.&nbsp; | &nbsp;&nbsp;.&nbsp; | &nbsp;&nbsp;.&nbsp; | &nbsp;&nbsp;.&nbsp; | &nbsp;&nbsp;.&nbsp; | &nbsp;&nbsp;.&nbsp; | &nbsp;&nbsp;.&nbsp; | &nbsp;&nbsp;.&nbsp; | &nbsp;&nbsp;.&nbsp; | &nbsp;&nbsp;.&nbsp; | &nbsp;&nbsp;.&nbsp; | &nbsp;&nbsp;.&nbsp; | &nbsp;&nbsp;.&nbsp; | &nbsp;&nbsp;.&nbsp; | &nbsp;&nbsp;.&nbsp; | &nbsp;&nbsp;.&nbsp; | &nbsp;&nbsp;.&nbsp; | &nbsp;&nbsp;.&nbsp; | &nbsp;&nbsp;.&nbsp; | &nbsp;&nbsp;.&nbsp; | &nbsp;&nbsp;.&nbsp; | &nbsp;&nbsp;.&nbsp; | &nbsp;&nbsp;.&nbsp; | &nbsp;&nbsp;.&nbsp; | &nbsp;&nbsp;.&nbsp; | &nbsp;&nbsp;.&nbsp; | &nbsp;&nbsp;.&nbsp; | &nbsp;&nbsp;.&nbsp; | &nbsp;&nbsp;.&nbsp; | &nbsp;&nbsp;.&nbsp; | &nbsp;&nbsp;.&nbsp; | &nbsp;&nbsp;.&nbsp; | &nbsp;&nbsp;.&nbsp; | &nbsp;&nbsp;.&nbsp; | &nbsp;&nbsp;.&nbsp; | &nbsp;&nbsp;.&nbsp; | &nbsp;&nbsp;.&nbsp; | &nbsp;&nbsp;.&nbsp; | &nbsp;&nbsp;.&nbsp; | &nbsp;&nbsp;.&nbsp; |  &nbsp;&nbsp;4&nbsp; | &nbsp;&nbsp;belt_clamp.stl |
| &nbsp;&nbsp;.&nbsp; | &nbsp;&nbsp;.&nbsp; | &nbsp;&nbsp;.&nbsp; | &nbsp;&nbsp;.&nbsp; | &nbsp;&nbsp;.&nbsp; | &nbsp;&nbsp;.&nbsp; | &nbsp;&nbsp;.&nbsp; | &nbsp;&nbsp;.&nbsp; | &nbsp;&nbsp;.&nbsp; | &nbsp;&nbsp;.&nbsp; | &nbsp;&nbsp;.&nbsp; | &nbsp;&nbsp;.&nbsp; | &nbsp;&nbsp;.&nbsp; | &nbsp;&nbsp;.&nbsp; | &nbsp;&nbsp;.&nbsp; | &nbsp;&nbsp;.&nbsp; | &nbsp;&nbsp;.&nbsp; | &nbsp;&nbsp;.&nbsp; | &nbsp;&nbsp;.&nbsp; | &nbsp;&nbsp;.&nbsp; | &nbsp;&nbsp;.&nbsp; | &nbsp;&nbsp;.&nbsp; | &nbsp;&nbsp;.&nbsp; | &nbsp;&nbsp;.&nbsp; | &nbsp;&nbsp;.&nbsp; | &nbsp;&nbsp;.&nbsp; | &nbsp;&nbsp;.&nbsp; | &nbsp;&nbsp;4&nbsp; | &nbsp;&nbsp;4&nbsp; | &nbsp;&nbsp;.&nbsp; | &nbsp;&nbsp;.&nbsp; | &nbsp;&nbsp;.&nbsp; | &nbsp;&nbsp;.&nbsp; | &nbsp;&nbsp;.&nbsp; | &nbsp;&nbsp;.&nbsp; | &nbsp;&nbsp;.&nbsp; | &nbsp;&nbsp;.&nbsp; | &nbsp;&nbsp;.&nbsp; | &nbsp;&nbsp;.&nbsp; | &nbsp;&nbsp;.&nbsp; | &nbsp;&nbsp;.&nbsp; | &nbsp;&nbsp;.&nbsp; | &nbsp;&nbsp;.&nbsp; | &nbsp;&nbsp;.&nbsp; | &nbsp;&nbsp;.&nbsp; | &nbsp;&nbsp;.&nbsp; | &nbsp;&nbsp;.&nbsp; | &nbsp;&nbsp;.&nbsp; | &nbsp;&nbsp;.&nbsp; | &nbsp;&nbsp;.&nbsp; | &nbsp;&nbsp;.&nbsp; | &nbsp;&nbsp;.&nbsp; | &nbsp;&nbsp;.&nbsp; | &nbsp;&nbsp;.&nbsp; | &nbsp;&nbsp;.&nbsp; | &nbsp;&nbsp;.&nbsp; | &nbsp;&nbsp;.&nbsp; | &nbsp;&nbsp;.&nbsp; | &nbsp;&nbsp;.&nbsp; | &nbsp;&nbsp;.&nbsp; | &nbsp;&nbsp;.&nbsp; | &nbsp;&nbsp;.&nbsp; | &nbsp;&nbsp;.&nbsp; | &nbsp;&nbsp;.&nbsp; | &nbsp;&nbsp;.&nbsp; | &nbsp;&nbsp;.&nbsp; | &nbsp;&nbsp;.&nbsp; | &nbsp;&nbsp;.&nbsp; | &nbsp;&nbsp;.&nbsp; | &nbsp;&nbsp;.&nbsp; | &nbsp;&nbsp;.&nbsp; | &nbsp;&nbsp;.&nbsp; |  &nbsp;&nbsp;8&nbsp; | &nbsp;&nbsp;bottom_corner.stl |
| &nbsp;&nbsp;1&nbsp; | &nbsp;&nbsp;.&nbsp; | &nbsp;&nbsp;.&nbsp; | &nbsp;&nbsp;.&nbsp; | &nbsp;&nbsp;.&nbsp; | &nbsp;&nbsp;.&nbsp; | &nbsp;&nbsp;.&nbsp; | &nbsp;&nbsp;.&nbsp; | &nbsp;&nbsp;.&nbsp; | &nbsp;&nbsp;.&nbsp; | &nbsp;&nbsp;.&nbsp; | &nbsp;&nbsp;.&nbsp; | &nbsp;&nbsp;.&nbsp; | &nbsp;&nbsp;.&nbsp; | &nbsp;&nbsp;.&nbsp; | &nbsp;&nbsp;.&nbsp; | &nbsp;&nbsp;.&nbsp; | &nbsp;&nbsp;.&nbsp; | &nbsp;&nbsp;.&nbsp; | &nbsp;&nbsp;.&nbsp; | &nbsp;&nbsp;.&nbsp; | &nbsp;&nbsp;.&nbsp; | &nbsp;&nbsp;.&nbsp; | &nbsp;&nbsp;.&nbsp; | &nbsp;&nbsp;.&nbsp; | &nbsp;&nbsp;.&nbsp; | &nbsp;&nbsp;.&nbsp; | &nbsp;&nbsp;.&nbsp; | &nbsp;&nbsp;.&nbsp; | &nbsp;&nbsp;.&nbsp; | &nbsp;&nbsp;.&nbsp; | &nbsp;&nbsp;.&nbsp; | &nbsp;&nbsp;.&nbsp; | &nbsp;&nbsp;.&nbsp; | &nbsp;&nbsp;.&nbsp; | &nbsp;&nbsp;.&nbsp; | &nbsp;&nbsp;.&nbsp; | &nbsp;&nbsp;.&nbsp; | &nbsp;&nbsp;.&nbsp; | &nbsp;&nbsp;.&nbsp; | &nbsp;&nbsp;.&nbsp; | &nbsp;&nbsp;.&nbsp; | &nbsp;&nbsp;.&nbsp; | &nbsp;&nbsp;.&nbsp; | &nbsp;&nbsp;.&nbsp; | &nbsp;&nbsp;.&nbsp; | &nbsp;&nbsp;.&nbsp; | &nbsp;&nbsp;.&nbsp; | &nbsp;&nbsp;.&nbsp; | &nbsp;&nbsp;.&nbsp; | &nbsp;&nbsp;.&nbsp; | &nbsp;&nbsp;.&nbsp; | &nbsp;&nbsp;.&nbsp; | &nbsp;&nbsp;.&nbsp; | &nbsp;&nbsp;.&nbsp; | &nbsp;&nbsp;.&nbsp; | &nbsp;&nbsp;.&nbsp; | &nbsp;&nbsp;.&nbsp; | &nbsp;&nbsp;.&nbsp; | &nbsp;&nbsp;.&nbsp; | &nbsp;&nbsp;.&nbsp; | &nbsp;&nbsp;.&nbsp; | &nbsp;&nbsp;.&nbsp; | &nbsp;&nbsp;.&nbsp; | &nbsp;&nbsp;.&nbsp; | &nbsp;&nbsp;.&nbsp; | &nbsp;&nbsp;.&nbsp; | &nbsp;&nbsp;.&nbsp; | &nbsp;&nbsp;.&nbsp; | &nbsp;&nbsp;.&nbsp; | &nbsp;&nbsp;.&nbsp; | &nbsp;&nbsp;.&nbsp; |  &nbsp;&nbsp;1&nbsp; | &nbsp;&nbsp;duct.stl |
| &nbsp;&nbsp;1&nbsp; | &nbsp;&nbsp;.&nbsp; | &nbsp;&nbsp;.&nbsp; | &nbsp;&nbsp;.&nbsp; | &nbsp;&nbsp;.&nbsp; | &nbsp;&nbsp;.&nbsp; | &nbsp;&nbsp;.&nbsp; | &nbsp;&nbsp;.&nbsp; | &nbsp;&nbsp;.&nbsp; | &nbsp;&nbsp;.&nbsp; | &nbsp;&nbsp;.&nbsp; | &nbsp;&nbsp;.&nbsp; | &nbsp;&nbsp;.&nbsp; | &nbsp;&nbsp;.&nbsp; | &nbsp;&nbsp;.&nbsp; | &nbsp;&nbsp;.&nbsp; | &nbsp;&nbsp;.&nbsp; | &nbsp;&nbsp;.&nbsp; | &nbsp;&nbsp;.&nbsp; | &nbsp;&nbsp;.&nbsp; | &nbsp;&nbsp;.&nbsp; | &nbsp;&nbsp;.&nbsp; | &nbsp;&nbsp;.&nbsp; | &nbsp;&nbsp;.&nbsp; | &nbsp;&nbsp;.&nbsp; | &nbsp;&nbsp;.&nbsp; | &nbsp;&nbsp;.&nbsp; | &nbsp;&nbsp;.&nbsp; | &nbsp;&nbsp;.&nbsp; | &nbsp;&nbsp;.&nbsp; | &nbsp;&nbsp;.&nbsp; | &nbsp;&nbsp;.&nbsp; | &nbsp;&nbsp;.&nbsp; | &nbsp;&nbsp;.&nbsp; | &nbsp;&nbsp;.&nbsp; | &nbsp;&nbsp;.&nbsp; | &nbsp;&nbsp;.&nbsp; | &nbsp;&nbsp;.&nbsp; | &nbsp;&nbsp;.&nbsp; | &nbsp;&nbsp;.&nbsp; | &nbsp;&nbsp;.&nbsp; | &nbsp;&nbsp;.&nbsp; | &nbsp;&nbsp;.&nbsp; | &nbsp;&nbsp;.&nbsp; | &nbsp;&nbsp;.&nbsp; | &nbsp;&nbsp;.&nbsp; | &nbsp;&nbsp;.&nbsp; | &nbsp;&nbsp;.&nbsp; | &nbsp;&nbsp;.&nbsp; | &nbsp;&nbsp;.&nbsp; | &nbsp;&nbsp;.&nbsp; | &nbsp;&nbsp;.&nbsp; | &nbsp;&nbsp;.&nbsp; | &nbsp;&nbsp;.&nbsp; | &nbsp;&nbsp;.&nbsp; | &nbsp;&nbsp;.&nbsp; | &nbsp;&nbsp;.&nbsp; | &nbsp;&nbsp;.&nbsp; | &nbsp;&nbsp;.&nbsp; | &nbsp;&nbsp;.&nbsp; | &nbsp;&nbsp;.&nbsp; | &nbsp;&nbsp;.&nbsp; | &nbsp;&nbsp;.&nbsp; | &nbsp;&nbsp;.&nbsp; | &nbsp;&nbsp;.&nbsp; | &nbsp;&nbsp;.&nbsp; | &nbsp;&nbsp;.&nbsp; | &nbsp;&nbsp;.&nbsp; | &nbsp;&nbsp;.&nbsp; | &nbsp;&nbsp;.&nbsp; | &nbsp;&nbsp;.&nbsp; | &nbsp;&nbsp;.&nbsp; |  &nbsp;&nbsp;1&nbsp; | &nbsp;&nbsp;duct_mount.stl |
| &nbsp;&nbsp;.&nbsp; | &nbsp;&nbsp;.&nbsp; | &nbsp;&nbsp;.&nbsp; | &nbsp;&nbsp;.&nbsp; | &nbsp;&nbsp;.&nbsp; | &nbsp;&nbsp;.&nbsp; | &nbsp;&nbsp;.&nbsp; | &nbsp;&nbsp;.&nbsp; | &nbsp;&nbsp;.&nbsp; | &nbsp;&nbsp;.&nbsp; | &nbsp;&nbsp;.&nbsp; | &nbsp;&nbsp;.&nbsp; | &nbsp;&nbsp;.&nbsp; | &nbsp;&nbsp;.&nbsp; | &nbsp;&nbsp;.&nbsp; | &nbsp;&nbsp;.&nbsp; | &nbsp;&nbsp;.&nbsp; | &nbsp;&nbsp;.&nbsp; | &nbsp;&nbsp;.&nbsp; | &nbsp;&nbsp;.&nbsp; | &nbsp;&nbsp;.&nbsp; | &nbsp;&nbsp;.&nbsp; | &nbsp;&nbsp;.&nbsp; | &nbsp;&nbsp;.&nbsp; | &nbsp;&nbsp;.&nbsp; | &nbsp;&nbsp;.&nbsp; | &nbsp;&nbsp;.&nbsp; | &nbsp;&nbsp;.&nbsp; | &nbsp;&nbsp;.&nbsp; | &nbsp;&nbsp;1&nbsp; | &nbsp;&nbsp;.&nbsp; | &nbsp;&nbsp;.&nbsp; | &nbsp;&nbsp;.&nbsp; | &nbsp;&nbsp;.&nbsp; | &nbsp;&nbsp;.&nbsp; | &nbsp;&nbsp;.&nbsp; | &nbsp;&nbsp;.&nbsp; | &nbsp;&nbsp;.&nbsp; | &nbsp;&nbsp;.&nbsp; | &nbsp;&nbsp;.&nbsp; | &nbsp;&nbsp;.&nbsp; | &nbsp;&nbsp;.&nbsp; | &nbsp;&nbsp;.&nbsp; | &nbsp;&nbsp;.&nbsp; | &nbsp;&nbsp;.&nbsp; | &nbsp;&nbsp;.&nbsp; | &nbsp;&nbsp;.&nbsp; | &nbsp;&nbsp;.&nbsp; | &nbsp;&nbsp;.&nbsp; | &nbsp;&nbsp;.&nbsp; | &nbsp;&nbsp;.&nbsp; | &nbsp;&nbsp;.&nbsp; | &nbsp;&nbsp;.&nbsp; | &nbsp;&nbsp;.&nbsp; | &nbsp;&nbsp;.&nbsp; | &nbsp;&nbsp;.&nbsp; | &nbsp;&nbsp;.&nbsp; | &nbsp;&nbsp;.&nbsp; | &nbsp;&nbsp;.&nbsp; | &nbsp;&nbsp;.&nbsp; | &nbsp;&nbsp;.&nbsp; | &nbsp;&nbsp;.&nbsp; | &nbsp;&nbsp;.&nbsp; | &nbsp;&nbsp;.&nbsp; | &nbsp;&nbsp;.&nbsp; | &nbsp;&nbsp;.&nbsp; | &nbsp;&nbsp;.&nbsp; | &nbsp;&nbsp;.&nbsp; | &nbsp;&nbsp;.&nbsp; | &nbsp;&nbsp;.&nbsp; | &nbsp;&nbsp;.&nbsp; | &nbsp;&nbsp;.&nbsp; |  &nbsp;&nbsp;1&nbsp; | &nbsp;&nbsp;duet_mount.stl |
| &nbsp;&nbsp;.&nbsp; | &nbsp;&nbsp;.&nbsp; | &nbsp;&nbsp;.&nbsp; | &nbsp;&nbsp;.&nbsp; | &nbsp;&nbsp;.&nbsp; | &nbsp;&nbsp;.&nbsp; | &nbsp;&nbsp;.&nbsp; | &nbsp;&nbsp;.&nbsp; | &nbsp;&nbsp;.&nbsp; | &nbsp;&nbsp;.&nbsp; | &nbsp;&nbsp;.&nbsp; | &nbsp;&nbsp;.&nbsp; | &nbsp;&nbsp;.&nbsp; | &nbsp;&nbsp;.&nbsp; | &nbsp;&nbsp;.&nbsp; | &nbsp;&nbsp;.&nbsp; | &nbsp;&nbsp;.&nbsp; | &nbsp;&nbsp;.&nbsp; | &nbsp;&nbsp;.&nbsp; | &nbsp;&nbsp;.&nbsp; | &nbsp;&nbsp;.&nbsp; | &nbsp;&nbsp;.&nbsp; | &nbsp;&nbsp;.&nbsp; | &nbsp;&nbsp;.&nbsp; | &nbsp;&nbsp;.&nbsp; | &nbsp;&nbsp;.&nbsp; | &nbsp;&nbsp;.&nbsp; | &nbsp;&nbsp;.&nbsp; | &nbsp;&nbsp;.&nbsp; | &nbsp;&nbsp;.&nbsp; | &nbsp;&nbsp;.&nbsp; | &nbsp;&nbsp;.&nbsp; | &nbsp;&nbsp;.&nbsp; | &nbsp;&nbsp;.&nbsp; | &nbsp;&nbsp;.&nbsp; | &nbsp;&nbsp;.&nbsp; | &nbsp;&nbsp;.&nbsp; | &nbsp;&nbsp;.&nbsp; | &nbsp;&nbsp;.&nbsp; | &nbsp;&nbsp;.&nbsp; | &nbsp;&nbsp;.&nbsp; | &nbsp;&nbsp;1&nbsp; | &nbsp;&nbsp;.&nbsp; | &nbsp;&nbsp;1&nbsp; | &nbsp;&nbsp;.&nbsp; | &nbsp;&nbsp;.&nbsp; | &nbsp;&nbsp;.&nbsp; | &nbsp;&nbsp;.&nbsp; | &nbsp;&nbsp;.&nbsp; | &nbsp;&nbsp;.&nbsp; | &nbsp;&nbsp;.&nbsp; | &nbsp;&nbsp;.&nbsp; | &nbsp;&nbsp;.&nbsp; | &nbsp;&nbsp;.&nbsp; | &nbsp;&nbsp;.&nbsp; | &nbsp;&nbsp;.&nbsp; | &nbsp;&nbsp;.&nbsp; | &nbsp;&nbsp;1&nbsp; | &nbsp;&nbsp;.&nbsp; | &nbsp;&nbsp;1&nbsp; | &nbsp;&nbsp;.&nbsp; | &nbsp;&nbsp;.&nbsp; | &nbsp;&nbsp;.&nbsp; | &nbsp;&nbsp;.&nbsp; | &nbsp;&nbsp;.&nbsp; | &nbsp;&nbsp;.&nbsp; | &nbsp;&nbsp;.&nbsp; | &nbsp;&nbsp;.&nbsp; | &nbsp;&nbsp;.&nbsp; | &nbsp;&nbsp;.&nbsp; | &nbsp;&nbsp;.&nbsp; | &nbsp;&nbsp;.&nbsp; |  &nbsp;&nbsp;4&nbsp; | &nbsp;&nbsp;foot.stl |
| &nbsp;&nbsp;.&nbsp; | &nbsp;&nbsp;.&nbsp; | &nbsp;&nbsp;.&nbsp; | &nbsp;&nbsp;.&nbsp; | &nbsp;&nbsp;.&nbsp; | &nbsp;&nbsp;.&nbsp; | &nbsp;&nbsp;.&nbsp; | &nbsp;&nbsp;.&nbsp; | &nbsp;&nbsp;.&nbsp; | &nbsp;&nbsp;.&nbsp; | &nbsp;&nbsp;.&nbsp; | &nbsp;&nbsp;.&nbsp; | &nbsp;&nbsp;.&nbsp; | &nbsp;&nbsp;.&nbsp; | &nbsp;&nbsp;.&nbsp; | &nbsp;&nbsp;.&nbsp; | &nbsp;&nbsp;.&nbsp; | &nbsp;&nbsp;.&nbsp; | &nbsp;&nbsp;.&nbsp; | &nbsp;&nbsp;1&nbsp; | &nbsp;&nbsp;.&nbsp; | &nbsp;&nbsp;.&nbsp; | &nbsp;&nbsp;.&nbsp; | &nbsp;&nbsp;.&nbsp; | &nbsp;&nbsp;.&nbsp; | &nbsp;&nbsp;.&nbsp; | &nbsp;&nbsp;.&nbsp; | &nbsp;&nbsp;.&nbsp; | &nbsp;&nbsp;.&nbsp; | &nbsp;&nbsp;.&nbsp; | &nbsp;&nbsp;.&nbsp; | &nbsp;&nbsp;.&nbsp; | &nbsp;&nbsp;.&nbsp; | &nbsp;&nbsp;.&nbsp; | &nbsp;&nbsp;.&nbsp; | &nbsp;&nbsp;.&nbsp; | &nbsp;&nbsp;.&nbsp; | &nbsp;&nbsp;.&nbsp; | &nbsp;&nbsp;.&nbsp; | &nbsp;&nbsp;.&nbsp; | &nbsp;&nbsp;.&nbsp; | &nbsp;&nbsp;.&nbsp; | &nbsp;&nbsp;.&nbsp; | &nbsp;&nbsp;.&nbsp; | &nbsp;&nbsp;.&nbsp; | &nbsp;&nbsp;.&nbsp; | &nbsp;&nbsp;.&nbsp; | &nbsp;&nbsp;1&nbsp; | &nbsp;&nbsp;.&nbsp; | &nbsp;&nbsp;.&nbsp; | &nbsp;&nbsp;.&nbsp; | &nbsp;&nbsp;.&nbsp; | &nbsp;&nbsp;.&nbsp; | &nbsp;&nbsp;.&nbsp; | &nbsp;&nbsp;.&nbsp; | &nbsp;&nbsp;.&nbsp; | &nbsp;&nbsp;.&nbsp; | &nbsp;&nbsp;.&nbsp; | &nbsp;&nbsp;.&nbsp; | &nbsp;&nbsp;.&nbsp; | &nbsp;&nbsp;.&nbsp; | &nbsp;&nbsp;.&nbsp; | &nbsp;&nbsp;.&nbsp; | &nbsp;&nbsp;.&nbsp; | &nbsp;&nbsp;.&nbsp; | &nbsp;&nbsp;.&nbsp; | &nbsp;&nbsp;.&nbsp; | &nbsp;&nbsp;.&nbsp; | &nbsp;&nbsp;.&nbsp; | &nbsp;&nbsp;.&nbsp; | &nbsp;&nbsp;.&nbsp; | &nbsp;&nbsp;.&nbsp; |  &nbsp;&nbsp;2&nbsp; | &nbsp;&nbsp;front_top_corner.stl |
| &nbsp;&nbsp;.&nbsp; | &nbsp;&nbsp;.&nbsp; | &nbsp;&nbsp;.&nbsp; | &nbsp;&nbsp;.&nbsp; | &nbsp;&nbsp;.&nbsp; | &nbsp;&nbsp;.&nbsp; | &nbsp;&nbsp;.&nbsp; | &nbsp;&nbsp;.&nbsp; | &nbsp;&nbsp;.&nbsp; | &nbsp;&nbsp;.&nbsp; | &nbsp;&nbsp;.&nbsp; | &nbsp;&nbsp;.&nbsp; | &nbsp;&nbsp;.&nbsp; | &nbsp;&nbsp;.&nbsp; | &nbsp;&nbsp;.&nbsp; | &nbsp;&nbsp;.&nbsp; | &nbsp;&nbsp;.&nbsp; | &nbsp;&nbsp;.&nbsp; | &nbsp;&nbsp;.&nbsp; | &nbsp;&nbsp;.&nbsp; | &nbsp;&nbsp;.&nbsp; | &nbsp;&nbsp;.&nbsp; | &nbsp;&nbsp;.&nbsp; | &nbsp;&nbsp;.&nbsp; | &nbsp;&nbsp;.&nbsp; | &nbsp;&nbsp;.&nbsp; | &nbsp;&nbsp;.&nbsp; | &nbsp;&nbsp;.&nbsp; | &nbsp;&nbsp;.&nbsp; | &nbsp;&nbsp;.&nbsp; | &nbsp;&nbsp;.&nbsp; | &nbsp;&nbsp;.&nbsp; | &nbsp;&nbsp;.&nbsp; | &nbsp;&nbsp;.&nbsp; | &nbsp;&nbsp;.&nbsp; | &nbsp;&nbsp;.&nbsp; | &nbsp;&nbsp;.&nbsp; | &nbsp;&nbsp;.&nbsp; | &nbsp;&nbsp;.&nbsp; | &nbsp;&nbsp;.&nbsp; | &nbsp;&nbsp;.&nbsp; | &nbsp;&nbsp;.&nbsp; | &nbsp;&nbsp;.&nbsp; | &nbsp;&nbsp;.&nbsp; | &nbsp;&nbsp;.&nbsp; | &nbsp;&nbsp;.&nbsp; | &nbsp;&nbsp;.&nbsp; | &nbsp;&nbsp;.&nbsp; | &nbsp;&nbsp;.&nbsp; | &nbsp;&nbsp;.&nbsp; | &nbsp;&nbsp;.&nbsp; | &nbsp;&nbsp;.&nbsp; | &nbsp;&nbsp;.&nbsp; | &nbsp;&nbsp;.&nbsp; | &nbsp;&nbsp;.&nbsp; | &nbsp;&nbsp;.&nbsp; | &nbsp;&nbsp;.&nbsp; | &nbsp;&nbsp;.&nbsp; | &nbsp;&nbsp;.&nbsp; | &nbsp;&nbsp;.&nbsp; | &nbsp;&nbsp;.&nbsp; | &nbsp;&nbsp;.&nbsp; | &nbsp;&nbsp;.&nbsp; | &nbsp;&nbsp;.&nbsp; | &nbsp;&nbsp;.&nbsp; | &nbsp;&nbsp;.&nbsp; | &nbsp;&nbsp;.&nbsp; | &nbsp;&nbsp;1&nbsp; | &nbsp;&nbsp;.&nbsp; | &nbsp;&nbsp;.&nbsp; | &nbsp;&nbsp;.&nbsp; | &nbsp;&nbsp;.&nbsp; |  &nbsp;&nbsp;1&nbsp; | &nbsp;&nbsp;hotend_clamp.stl |
| &nbsp;&nbsp;.&nbsp; | &nbsp;&nbsp;.&nbsp; | &nbsp;&nbsp;.&nbsp; | &nbsp;&nbsp;.&nbsp; | &nbsp;&nbsp;.&nbsp; | &nbsp;&nbsp;.&nbsp; | &nbsp;&nbsp;.&nbsp; | &nbsp;&nbsp;.&nbsp; | &nbsp;&nbsp;.&nbsp; | &nbsp;&nbsp;1&nbsp; | &nbsp;&nbsp;.&nbsp; | &nbsp;&nbsp;.&nbsp; | &nbsp;&nbsp;.&nbsp; | &nbsp;&nbsp;.&nbsp; | &nbsp;&nbsp;.&nbsp; | &nbsp;&nbsp;.&nbsp; | &nbsp;&nbsp;.&nbsp; | &nbsp;&nbsp;.&nbsp; | &nbsp;&nbsp;.&nbsp; | &nbsp;&nbsp;.&nbsp; | &nbsp;&nbsp;.&nbsp; | &nbsp;&nbsp;.&nbsp; | &nbsp;&nbsp;.&nbsp; | &nbsp;&nbsp;.&nbsp; | &nbsp;&nbsp;.&nbsp; | &nbsp;&nbsp;.&nbsp; | &nbsp;&nbsp;.&nbsp; | &nbsp;&nbsp;.&nbsp; | &nbsp;&nbsp;.&nbsp; | &nbsp;&nbsp;.&nbsp; | &nbsp;&nbsp;.&nbsp; | &nbsp;&nbsp;.&nbsp; | &nbsp;&nbsp;.&nbsp; | &nbsp;&nbsp;.&nbsp; | &nbsp;&nbsp;.&nbsp; | &nbsp;&nbsp;.&nbsp; | &nbsp;&nbsp;.&nbsp; | &nbsp;&nbsp;.&nbsp; | &nbsp;&nbsp;.&nbsp; | &nbsp;&nbsp;.&nbsp; | &nbsp;&nbsp;.&nbsp; | &nbsp;&nbsp;.&nbsp; | &nbsp;&nbsp;.&nbsp; | &nbsp;&nbsp;.&nbsp; | &nbsp;&nbsp;.&nbsp; | &nbsp;&nbsp;.&nbsp; | &nbsp;&nbsp;.&nbsp; | &nbsp;&nbsp;.&nbsp; | &nbsp;&nbsp;.&nbsp; | &nbsp;&nbsp;.&nbsp; | &nbsp;&nbsp;.&nbsp; | &nbsp;&nbsp;.&nbsp; | &nbsp;&nbsp;.&nbsp; | &nbsp;&nbsp;.&nbsp; | &nbsp;&nbsp;.&nbsp; | &nbsp;&nbsp;.&nbsp; | &nbsp;&nbsp;.&nbsp; | &nbsp;&nbsp;.&nbsp; | &nbsp;&nbsp;.&nbsp; | &nbsp;&nbsp;.&nbsp; | &nbsp;&nbsp;.&nbsp; | &nbsp;&nbsp;.&nbsp; | &nbsp;&nbsp;.&nbsp; | &nbsp;&nbsp;.&nbsp; | &nbsp;&nbsp;.&nbsp; | &nbsp;&nbsp;.&nbsp; | &nbsp;&nbsp;.&nbsp; | &nbsp;&nbsp;.&nbsp; | &nbsp;&nbsp;.&nbsp; | &nbsp;&nbsp;.&nbsp; | &nbsp;&nbsp;.&nbsp; | &nbsp;&nbsp;.&nbsp; |  &nbsp;&nbsp;1&nbsp; | &nbsp;&nbsp;hotend_mount.stl |
| &nbsp;&nbsp;.&nbsp; | &nbsp;&nbsp;.&nbsp; | &nbsp;&nbsp;.&nbsp; | &nbsp;&nbsp;.&nbsp; | &nbsp;&nbsp;.&nbsp; | &nbsp;&nbsp;.&nbsp; | &nbsp;&nbsp;.&nbsp; | &nbsp;&nbsp;.&nbsp; | &nbsp;&nbsp;.&nbsp; | &nbsp;&nbsp;.&nbsp; | &nbsp;&nbsp;.&nbsp; | &nbsp;&nbsp;.&nbsp; | &nbsp;&nbsp;.&nbsp; | &nbsp;&nbsp;.&nbsp; | &nbsp;&nbsp;.&nbsp; | &nbsp;&nbsp;.&nbsp; | &nbsp;&nbsp;.&nbsp; | &nbsp;&nbsp;.&nbsp; | &nbsp;&nbsp;.&nbsp; | &nbsp;&nbsp;.&nbsp; | &nbsp;&nbsp;.&nbsp; | &nbsp;&nbsp;.&nbsp; | &nbsp;&nbsp;.&nbsp; | &nbsp;&nbsp;.&nbsp; | &nbsp;&nbsp;.&nbsp; | &nbsp;&nbsp;.&nbsp; | &nbsp;&nbsp;.&nbsp; | &nbsp;&nbsp;.&nbsp; | &nbsp;&nbsp;.&nbsp; | &nbsp;&nbsp;.&nbsp; | &nbsp;&nbsp;.&nbsp; | &nbsp;&nbsp;.&nbsp; | &nbsp;&nbsp;.&nbsp; | &nbsp;&nbsp;.&nbsp; | &nbsp;&nbsp;.&nbsp; | &nbsp;&nbsp;.&nbsp; | &nbsp;&nbsp;.&nbsp; | &nbsp;&nbsp;.&nbsp; | &nbsp;&nbsp;.&nbsp; | &nbsp;&nbsp;.&nbsp; | &nbsp;&nbsp;.&nbsp; | &nbsp;&nbsp;.&nbsp; | &nbsp;&nbsp;1&nbsp; | &nbsp;&nbsp;.&nbsp; | &nbsp;&nbsp;.&nbsp; | &nbsp;&nbsp;.&nbsp; | &nbsp;&nbsp;.&nbsp; | &nbsp;&nbsp;.&nbsp; | &nbsp;&nbsp;.&nbsp; | &nbsp;&nbsp;.&nbsp; | &nbsp;&nbsp;.&nbsp; | &nbsp;&nbsp;.&nbsp; | &nbsp;&nbsp;.&nbsp; | &nbsp;&nbsp;.&nbsp; | &nbsp;&nbsp;.&nbsp; | &nbsp;&nbsp;.&nbsp; | &nbsp;&nbsp;.&nbsp; | &nbsp;&nbsp;.&nbsp; | &nbsp;&nbsp;.&nbsp; | &nbsp;&nbsp;.&nbsp; | &nbsp;&nbsp;.&nbsp; | &nbsp;&nbsp;.&nbsp; | &nbsp;&nbsp;.&nbsp; | &nbsp;&nbsp;.&nbsp; | &nbsp;&nbsp;.&nbsp; | &nbsp;&nbsp;.&nbsp; | &nbsp;&nbsp;.&nbsp; | &nbsp;&nbsp;.&nbsp; | &nbsp;&nbsp;.&nbsp; | &nbsp;&nbsp;.&nbsp; | &nbsp;&nbsp;.&nbsp; | &nbsp;&nbsp;.&nbsp; |  &nbsp;&nbsp;1&nbsp; | &nbsp;&nbsp;iec_socket_mount.stl |
| &nbsp;&nbsp;.&nbsp; | &nbsp;&nbsp;.&nbsp; | &nbsp;&nbsp;.&nbsp; | &nbsp;&nbsp;.&nbsp; | &nbsp;&nbsp;.&nbsp; | &nbsp;&nbsp;.&nbsp; | &nbsp;&nbsp;.&nbsp; | &nbsp;&nbsp;.&nbsp; | &nbsp;&nbsp;.&nbsp; | &nbsp;&nbsp;.&nbsp; | &nbsp;&nbsp;.&nbsp; | &nbsp;&nbsp;.&nbsp; | &nbsp;&nbsp;.&nbsp; | &nbsp;&nbsp;.&nbsp; | &nbsp;&nbsp;.&nbsp; | &nbsp;&nbsp;.&nbsp; | &nbsp;&nbsp;.&nbsp; | &nbsp;&nbsp;.&nbsp; | &nbsp;&nbsp;.&nbsp; | &nbsp;&nbsp;.&nbsp; | &nbsp;&nbsp;.&nbsp; | &nbsp;&nbsp;.&nbsp; | &nbsp;&nbsp;.&nbsp; | &nbsp;&nbsp;.&nbsp; | &nbsp;&nbsp;.&nbsp; | &nbsp;&nbsp;.&nbsp; | &nbsp;&nbsp;.&nbsp; | &nbsp;&nbsp;.&nbsp; | &nbsp;&nbsp;.&nbsp; | &nbsp;&nbsp;.&nbsp; | &nbsp;&nbsp;.&nbsp; | &nbsp;&nbsp;.&nbsp; | &nbsp;&nbsp;.&nbsp; | &nbsp;&nbsp;.&nbsp; | &nbsp;&nbsp;.&nbsp; | &nbsp;&nbsp;.&nbsp; | &nbsp;&nbsp;.&nbsp; | &nbsp;&nbsp;.&nbsp; | &nbsp;&nbsp;.&nbsp; | &nbsp;&nbsp;.&nbsp; | &nbsp;&nbsp;1&nbsp; | &nbsp;&nbsp;.&nbsp; | &nbsp;&nbsp;.&nbsp; | &nbsp;&nbsp;.&nbsp; | &nbsp;&nbsp;.&nbsp; | &nbsp;&nbsp;.&nbsp; | &nbsp;&nbsp;.&nbsp; | &nbsp;&nbsp;.&nbsp; | &nbsp;&nbsp;.&nbsp; | &nbsp;&nbsp;.&nbsp; | &nbsp;&nbsp;.&nbsp; | &nbsp;&nbsp;.&nbsp; | &nbsp;&nbsp;.&nbsp; | &nbsp;&nbsp;.&nbsp; | &nbsp;&nbsp;.&nbsp; | &nbsp;&nbsp;.&nbsp; | &nbsp;&nbsp;.&nbsp; | &nbsp;&nbsp;.&nbsp; | &nbsp;&nbsp;.&nbsp; | &nbsp;&nbsp;.&nbsp; | &nbsp;&nbsp;.&nbsp; | &nbsp;&nbsp;.&nbsp; | &nbsp;&nbsp;.&nbsp; | &nbsp;&nbsp;.&nbsp; | &nbsp;&nbsp;.&nbsp; | &nbsp;&nbsp;.&nbsp; | &nbsp;&nbsp;.&nbsp; | &nbsp;&nbsp;.&nbsp; | &nbsp;&nbsp;.&nbsp; | &nbsp;&nbsp;.&nbsp; | &nbsp;&nbsp;.&nbsp; | &nbsp;&nbsp;.&nbsp; |  &nbsp;&nbsp;1&nbsp; | &nbsp;&nbsp;left_idler.stl |
| &nbsp;&nbsp;.&nbsp; | &nbsp;&nbsp;.&nbsp; | &nbsp;&nbsp;.&nbsp; | &nbsp;&nbsp;.&nbsp; | &nbsp;&nbsp;.&nbsp; | &nbsp;&nbsp;.&nbsp; | &nbsp;&nbsp;.&nbsp; | &nbsp;&nbsp;.&nbsp; | &nbsp;&nbsp;.&nbsp; | &nbsp;&nbsp;.&nbsp; | &nbsp;&nbsp;.&nbsp; | &nbsp;&nbsp;.&nbsp; | &nbsp;&nbsp;.&nbsp; | &nbsp;&nbsp;.&nbsp; | &nbsp;&nbsp;.&nbsp; | &nbsp;&nbsp;.&nbsp; | &nbsp;&nbsp;.&nbsp; | &nbsp;&nbsp;.&nbsp; | &nbsp;&nbsp;.&nbsp; | &nbsp;&nbsp;.&nbsp; | &nbsp;&nbsp;.&nbsp; | &nbsp;&nbsp;.&nbsp; | &nbsp;&nbsp;1&nbsp; | &nbsp;&nbsp;.&nbsp; | &nbsp;&nbsp;.&nbsp; | &nbsp;&nbsp;.&nbsp; | &nbsp;&nbsp;.&nbsp; | &nbsp;&nbsp;.&nbsp; | &nbsp;&nbsp;.&nbsp; | &nbsp;&nbsp;.&nbsp; | &nbsp;&nbsp;.&nbsp; | &nbsp;&nbsp;.&nbsp; | &nbsp;&nbsp;.&nbsp; | &nbsp;&nbsp;.&nbsp; | &nbsp;&nbsp;.&nbsp; | &nbsp;&nbsp;.&nbsp; | &nbsp;&nbsp;.&nbsp; | &nbsp;&nbsp;.&nbsp; | &nbsp;&nbsp;.&nbsp; | &nbsp;&nbsp;.&nbsp; | &nbsp;&nbsp;.&nbsp; | &nbsp;&nbsp;.&nbsp; | &nbsp;&nbsp;.&nbsp; | &nbsp;&nbsp;.&nbsp; | &nbsp;&nbsp;.&nbsp; | &nbsp;&nbsp;.&nbsp; | &nbsp;&nbsp;.&nbsp; | &nbsp;&nbsp;.&nbsp; | &nbsp;&nbsp;.&nbsp; | &nbsp;&nbsp;.&nbsp; | &nbsp;&nbsp;.&nbsp; | &nbsp;&nbsp;.&nbsp; | &nbsp;&nbsp;.&nbsp; | &nbsp;&nbsp;.&nbsp; | &nbsp;&nbsp;.&nbsp; | &nbsp;&nbsp;.&nbsp; | &nbsp;&nbsp;.&nbsp; | &nbsp;&nbsp;.&nbsp; | &nbsp;&nbsp;.&nbsp; | &nbsp;&nbsp;.&nbsp; | &nbsp;&nbsp;.&nbsp; | &nbsp;&nbsp;.&nbsp; | &nbsp;&nbsp;.&nbsp; | &nbsp;&nbsp;.&nbsp; | &nbsp;&nbsp;.&nbsp; | &nbsp;&nbsp;.&nbsp; | &nbsp;&nbsp;.&nbsp; | &nbsp;&nbsp;.&nbsp; | &nbsp;&nbsp;.&nbsp; | &nbsp;&nbsp;.&nbsp; | &nbsp;&nbsp;.&nbsp; | &nbsp;&nbsp;.&nbsp; |  &nbsp;&nbsp;1&nbsp; | &nbsp;&nbsp;left_motor_mount.stl |
| &nbsp;&nbsp;.&nbsp; | &nbsp;&nbsp;.&nbsp; | &nbsp;&nbsp;.&nbsp; | &nbsp;&nbsp;.&nbsp; | &nbsp;&nbsp;.&nbsp; | &nbsp;&nbsp;.&nbsp; | &nbsp;&nbsp;.&nbsp; | &nbsp;&nbsp;1&nbsp; | &nbsp;&nbsp;.&nbsp; | &nbsp;&nbsp;.&nbsp; | &nbsp;&nbsp;.&nbsp; | &nbsp;&nbsp;.&nbsp; | &nbsp;&nbsp;.&nbsp; | &nbsp;&nbsp;.&nbsp; | &nbsp;&nbsp;.&nbsp; | &nbsp;&nbsp;.&nbsp; | &nbsp;&nbsp;.&nbsp; | &nbsp;&nbsp;.&nbsp; | &nbsp;&nbsp;.&nbsp; | &nbsp;&nbsp;.&nbsp; | &nbsp;&nbsp;.&nbsp; | &nbsp;&nbsp;.&nbsp; | &nbsp;&nbsp;.&nbsp; | &nbsp;&nbsp;.&nbsp; | &nbsp;&nbsp;.&nbsp; | &nbsp;&nbsp;.&nbsp; | &nbsp;&nbsp;.&nbsp; | &nbsp;&nbsp;.&nbsp; | &nbsp;&nbsp;.&nbsp; | &nbsp;&nbsp;.&nbsp; | &nbsp;&nbsp;.&nbsp; | &nbsp;&nbsp;.&nbsp; | &nbsp;&nbsp;.&nbsp; | &nbsp;&nbsp;.&nbsp; | &nbsp;&nbsp;.&nbsp; | &nbsp;&nbsp;.&nbsp; | &nbsp;&nbsp;.&nbsp; | &nbsp;&nbsp;.&nbsp; | &nbsp;&nbsp;.&nbsp; | &nbsp;&nbsp;.&nbsp; | &nbsp;&nbsp;.&nbsp; | &nbsp;&nbsp;.&nbsp; | &nbsp;&nbsp;.&nbsp; | &nbsp;&nbsp;.&nbsp; | &nbsp;&nbsp;.&nbsp; | &nbsp;&nbsp;.&nbsp; | &nbsp;&nbsp;.&nbsp; | &nbsp;&nbsp;.&nbsp; | &nbsp;&nbsp;.&nbsp; | &nbsp;&nbsp;.&nbsp; | &nbsp;&nbsp;.&nbsp; | &nbsp;&nbsp;.&nbsp; | &nbsp;&nbsp;.&nbsp; | &nbsp;&nbsp;.&nbsp; | &nbsp;&nbsp;.&nbsp; | &nbsp;&nbsp;.&nbsp; | &nbsp;&nbsp;.&nbsp; | &nbsp;&nbsp;.&nbsp; | &nbsp;&nbsp;.&nbsp; | &nbsp;&nbsp;.&nbsp; | &nbsp;&nbsp;.&nbsp; | &nbsp;&nbsp;.&nbsp; | &nbsp;&nbsp;.&nbsp; | &nbsp;&nbsp;.&nbsp; | &nbsp;&nbsp;.&nbsp; | &nbsp;&nbsp;.&nbsp; | &nbsp;&nbsp;.&nbsp; | &nbsp;&nbsp;.&nbsp; | &nbsp;&nbsp;.&nbsp; | &nbsp;&nbsp;.&nbsp; | &nbsp;&nbsp;.&nbsp; | &nbsp;&nbsp;.&nbsp; |  &nbsp;&nbsp;1&nbsp; | &nbsp;&nbsp;left_y_carriage.stl |
| &nbsp;&nbsp;.&nbsp; | &nbsp;&nbsp;.&nbsp; | &nbsp;&nbsp;.&nbsp; | &nbsp;&nbsp;.&nbsp; | &nbsp;&nbsp;.&nbsp; | &nbsp;&nbsp;.&nbsp; | &nbsp;&nbsp;.&nbsp; | &nbsp;&nbsp;.&nbsp; | &nbsp;&nbsp;.&nbsp; | &nbsp;&nbsp;.&nbsp; | &nbsp;&nbsp;.&nbsp; | &nbsp;&nbsp;.&nbsp; | &nbsp;&nbsp;.&nbsp; | &nbsp;&nbsp;.&nbsp; | &nbsp;&nbsp;.&nbsp; | &nbsp;&nbsp;.&nbsp; | &nbsp;&nbsp;.&nbsp; | &nbsp;&nbsp;.&nbsp; | &nbsp;&nbsp;.&nbsp; | &nbsp;&nbsp;.&nbsp; | &nbsp;&nbsp;.&nbsp; | &nbsp;&nbsp;.&nbsp; | &nbsp;&nbsp;.&nbsp; | &nbsp;&nbsp;.&nbsp; | &nbsp;&nbsp;.&nbsp; | &nbsp;&nbsp;.&nbsp; | &nbsp;&nbsp;.&nbsp; | &nbsp;&nbsp;.&nbsp; | &nbsp;&nbsp;.&nbsp; | &nbsp;&nbsp;.&nbsp; | &nbsp;&nbsp;.&nbsp; | &nbsp;&nbsp;.&nbsp; | &nbsp;&nbsp;.&nbsp; | &nbsp;&nbsp;.&nbsp; | &nbsp;&nbsp;.&nbsp; | &nbsp;&nbsp;.&nbsp; | &nbsp;&nbsp;.&nbsp; | &nbsp;&nbsp;.&nbsp; | &nbsp;&nbsp;.&nbsp; | &nbsp;&nbsp;.&nbsp; | &nbsp;&nbsp;.&nbsp; | &nbsp;&nbsp;.&nbsp; | &nbsp;&nbsp;.&nbsp; | &nbsp;&nbsp;.&nbsp; | &nbsp;&nbsp;.&nbsp; | &nbsp;&nbsp;.&nbsp; | &nbsp;&nbsp;.&nbsp; | &nbsp;&nbsp;.&nbsp; | &nbsp;&nbsp;.&nbsp; | &nbsp;&nbsp;.&nbsp; | &nbsp;&nbsp;.&nbsp; | &nbsp;&nbsp;.&nbsp; | &nbsp;&nbsp;.&nbsp; | &nbsp;&nbsp;.&nbsp; | &nbsp;&nbsp;.&nbsp; | &nbsp;&nbsp;.&nbsp; | &nbsp;&nbsp;.&nbsp; | &nbsp;&nbsp;.&nbsp; | &nbsp;&nbsp;.&nbsp; | &nbsp;&nbsp;.&nbsp; | &nbsp;&nbsp;.&nbsp; | &nbsp;&nbsp;.&nbsp; | &nbsp;&nbsp;.&nbsp; | &nbsp;&nbsp;.&nbsp; | &nbsp;&nbsp;.&nbsp; | &nbsp;&nbsp;.&nbsp; | &nbsp;&nbsp;.&nbsp; | &nbsp;&nbsp;1&nbsp; | &nbsp;&nbsp;.&nbsp; | &nbsp;&nbsp;.&nbsp; | &nbsp;&nbsp;.&nbsp; | &nbsp;&nbsp;.&nbsp; |  &nbsp;&nbsp;1&nbsp; | &nbsp;&nbsp;probe_mount.stl |
| &nbsp;&nbsp;.&nbsp; | &nbsp;&nbsp;.&nbsp; | &nbsp;&nbsp;.&nbsp; | &nbsp;&nbsp;.&nbsp; | &nbsp;&nbsp;.&nbsp; | &nbsp;&nbsp;.&nbsp; | &nbsp;&nbsp;.&nbsp; | &nbsp;&nbsp;.&nbsp; | &nbsp;&nbsp;.&nbsp; | &nbsp;&nbsp;.&nbsp; | &nbsp;&nbsp;.&nbsp; | &nbsp;&nbsp;.&nbsp; | &nbsp;&nbsp;.&nbsp; | &nbsp;&nbsp;.&nbsp; | &nbsp;&nbsp;.&nbsp; | &nbsp;&nbsp;.&nbsp; | &nbsp;&nbsp;1&nbsp; | &nbsp;&nbsp;.&nbsp; | &nbsp;&nbsp;.&nbsp; | &nbsp;&nbsp;.&nbsp; | &nbsp;&nbsp;.&nbsp; | &nbsp;&nbsp;.&nbsp; | &nbsp;&nbsp;.&nbsp; | &nbsp;&nbsp;.&nbsp; | &nbsp;&nbsp;.&nbsp; | &nbsp;&nbsp;.&nbsp; | &nbsp;&nbsp;.&nbsp; | &nbsp;&nbsp;.&nbsp; | &nbsp;&nbsp;.&nbsp; | &nbsp;&nbsp;.&nbsp; | &nbsp;&nbsp;.&nbsp; | &nbsp;&nbsp;.&nbsp; | &nbsp;&nbsp;.&nbsp; | &nbsp;&nbsp;.&nbsp; | &nbsp;&nbsp;.&nbsp; | &nbsp;&nbsp;.&nbsp; | &nbsp;&nbsp;.&nbsp; | &nbsp;&nbsp;.&nbsp; | &nbsp;&nbsp;.&nbsp; | &nbsp;&nbsp;.&nbsp; | &nbsp;&nbsp;.&nbsp; | &nbsp;&nbsp;.&nbsp; | &nbsp;&nbsp;.&nbsp; | &nbsp;&nbsp;.&nbsp; | &nbsp;&nbsp;.&nbsp; | &nbsp;&nbsp;.&nbsp; | &nbsp;&nbsp;.&nbsp; | &nbsp;&nbsp;.&nbsp; | &nbsp;&nbsp;.&nbsp; | &nbsp;&nbsp;.&nbsp; | &nbsp;&nbsp;.&nbsp; | &nbsp;&nbsp;.&nbsp; | &nbsp;&nbsp;.&nbsp; | &nbsp;&nbsp;.&nbsp; | &nbsp;&nbsp;.&nbsp; | &nbsp;&nbsp;.&nbsp; | &nbsp;&nbsp;.&nbsp; | &nbsp;&nbsp;.&nbsp; | &nbsp;&nbsp;.&nbsp; | &nbsp;&nbsp;.&nbsp; | &nbsp;&nbsp;.&nbsp; | &nbsp;&nbsp;.&nbsp; | &nbsp;&nbsp;.&nbsp; | &nbsp;&nbsp;.&nbsp; | &nbsp;&nbsp;.&nbsp; | &nbsp;&nbsp;.&nbsp; | &nbsp;&nbsp;.&nbsp; | &nbsp;&nbsp;.&nbsp; | &nbsp;&nbsp;.&nbsp; | &nbsp;&nbsp;.&nbsp; | &nbsp;&nbsp;.&nbsp; | &nbsp;&nbsp;.&nbsp; |  &nbsp;&nbsp;1&nbsp; | &nbsp;&nbsp;psu_cover.stl |
| &nbsp;&nbsp;.&nbsp; | &nbsp;&nbsp;.&nbsp; | &nbsp;&nbsp;.&nbsp; | &nbsp;&nbsp;.&nbsp; | &nbsp;&nbsp;.&nbsp; | &nbsp;&nbsp;.&nbsp; | &nbsp;&nbsp;.&nbsp; | &nbsp;&nbsp;.&nbsp; | &nbsp;&nbsp;.&nbsp; | &nbsp;&nbsp;.&nbsp; | &nbsp;&nbsp;.&nbsp; | &nbsp;&nbsp;.&nbsp; | &nbsp;&nbsp;.&nbsp; | &nbsp;&nbsp;.&nbsp; | &nbsp;&nbsp;.&nbsp; | &nbsp;&nbsp;.&nbsp; | &nbsp;&nbsp;2&nbsp; | &nbsp;&nbsp;.&nbsp; | &nbsp;&nbsp;.&nbsp; | &nbsp;&nbsp;.&nbsp; | &nbsp;&nbsp;.&nbsp; | &nbsp;&nbsp;.&nbsp; | &nbsp;&nbsp;.&nbsp; | &nbsp;&nbsp;.&nbsp; | &nbsp;&nbsp;.&nbsp; | &nbsp;&nbsp;.&nbsp; | &nbsp;&nbsp;.&nbsp; | &nbsp;&nbsp;.&nbsp; | &nbsp;&nbsp;.&nbsp; | &nbsp;&nbsp;.&nbsp; | &nbsp;&nbsp;.&nbsp; | &nbsp;&nbsp;.&nbsp; | &nbsp;&nbsp;.&nbsp; | &nbsp;&nbsp;.&nbsp; | &nbsp;&nbsp;.&nbsp; | &nbsp;&nbsp;.&nbsp; | &nbsp;&nbsp;.&nbsp; | &nbsp;&nbsp;.&nbsp; | &nbsp;&nbsp;.&nbsp; | &nbsp;&nbsp;.&nbsp; | &nbsp;&nbsp;.&nbsp; | &nbsp;&nbsp;.&nbsp; | &nbsp;&nbsp;.&nbsp; | &nbsp;&nbsp;.&nbsp; | &nbsp;&nbsp;.&nbsp; | &nbsp;&nbsp;.&nbsp; | &nbsp;&nbsp;.&nbsp; | &nbsp;&nbsp;.&nbsp; | &nbsp;&nbsp;.&nbsp; | &nbsp;&nbsp;.&nbsp; | &nbsp;&nbsp;.&nbsp; | &nbsp;&nbsp;.&nbsp; | &nbsp;&nbsp;.&nbsp; | &nbsp;&nbsp;.&nbsp; | &nbsp;&nbsp;.&nbsp; | &nbsp;&nbsp;.&nbsp; | &nbsp;&nbsp;.&nbsp; | &nbsp;&nbsp;.&nbsp; | &nbsp;&nbsp;.&nbsp; | &nbsp;&nbsp;.&nbsp; | &nbsp;&nbsp;.&nbsp; | &nbsp;&nbsp;.&nbsp; | &nbsp;&nbsp;.&nbsp; | &nbsp;&nbsp;.&nbsp; | &nbsp;&nbsp;.&nbsp; | &nbsp;&nbsp;.&nbsp; | &nbsp;&nbsp;.&nbsp; | &nbsp;&nbsp;.&nbsp; | &nbsp;&nbsp;.&nbsp; | &nbsp;&nbsp;.&nbsp; | &nbsp;&nbsp;.&nbsp; | &nbsp;&nbsp;.&nbsp; |  &nbsp;&nbsp;2&nbsp; | &nbsp;&nbsp;psu_mount.stl |
| &nbsp;&nbsp;.&nbsp; | &nbsp;&nbsp;.&nbsp; | &nbsp;&nbsp;.&nbsp; | &nbsp;&nbsp;.&nbsp; | &nbsp;&nbsp;.&nbsp; | &nbsp;&nbsp;.&nbsp; | &nbsp;&nbsp;.&nbsp; | &nbsp;&nbsp;.&nbsp; | &nbsp;&nbsp;.&nbsp; | &nbsp;&nbsp;.&nbsp; | &nbsp;&nbsp;.&nbsp; | &nbsp;&nbsp;.&nbsp; | &nbsp;&nbsp;.&nbsp; | &nbsp;&nbsp;.&nbsp; | &nbsp;&nbsp;.&nbsp; | &nbsp;&nbsp;.&nbsp; | &nbsp;&nbsp;.&nbsp; | &nbsp;&nbsp;.&nbsp; | &nbsp;&nbsp;.&nbsp; | &nbsp;&nbsp;.&nbsp; | &nbsp;&nbsp;.&nbsp; | &nbsp;&nbsp;.&nbsp; | &nbsp;&nbsp;.&nbsp; | &nbsp;&nbsp;.&nbsp; | &nbsp;&nbsp;.&nbsp; | &nbsp;&nbsp;.&nbsp; | &nbsp;&nbsp;.&nbsp; | &nbsp;&nbsp;.&nbsp; | &nbsp;&nbsp;.&nbsp; | &nbsp;&nbsp;.&nbsp; | &nbsp;&nbsp;.&nbsp; | &nbsp;&nbsp;.&nbsp; | &nbsp;&nbsp;.&nbsp; | &nbsp;&nbsp;.&nbsp; | &nbsp;&nbsp;2&nbsp; | &nbsp;&nbsp;.&nbsp; | &nbsp;&nbsp;.&nbsp; | &nbsp;&nbsp;.&nbsp; | &nbsp;&nbsp;.&nbsp; | &nbsp;&nbsp;.&nbsp; | &nbsp;&nbsp;.&nbsp; | &nbsp;&nbsp;.&nbsp; | &nbsp;&nbsp;.&nbsp; | &nbsp;&nbsp;.&nbsp; | &nbsp;&nbsp;.&nbsp; | &nbsp;&nbsp;.&nbsp; | &nbsp;&nbsp;.&nbsp; | &nbsp;&nbsp;.&nbsp; | &nbsp;&nbsp;.&nbsp; | &nbsp;&nbsp;.&nbsp; | &nbsp;&nbsp;.&nbsp; | &nbsp;&nbsp;.&nbsp; | &nbsp;&nbsp;.&nbsp; | &nbsp;&nbsp;.&nbsp; | &nbsp;&nbsp;.&nbsp; | &nbsp;&nbsp;.&nbsp; | &nbsp;&nbsp;.&nbsp; | &nbsp;&nbsp;.&nbsp; | &nbsp;&nbsp;.&nbsp; | &nbsp;&nbsp;.&nbsp; | &nbsp;&nbsp;.&nbsp; | &nbsp;&nbsp;.&nbsp; | &nbsp;&nbsp;.&nbsp; | &nbsp;&nbsp;.&nbsp; | &nbsp;&nbsp;.&nbsp; | &nbsp;&nbsp;.&nbsp; | &nbsp;&nbsp;.&nbsp; | &nbsp;&nbsp;.&nbsp; | &nbsp;&nbsp;.&nbsp; | &nbsp;&nbsp;.&nbsp; | &nbsp;&nbsp;.&nbsp; | &nbsp;&nbsp;.&nbsp; |  &nbsp;&nbsp;2&nbsp; | &nbsp;&nbsp;rail_guard.stl |
| &nbsp;&nbsp;.&nbsp; | &nbsp;&nbsp;.&nbsp; | &nbsp;&nbsp;.&nbsp; | &nbsp;&nbsp;.&nbsp; | &nbsp;&nbsp;.&nbsp; | &nbsp;&nbsp;.&nbsp; | &nbsp;&nbsp;.&nbsp; | &nbsp;&nbsp;.&nbsp; | &nbsp;&nbsp;.&nbsp; | &nbsp;&nbsp;.&nbsp; | &nbsp;&nbsp;.&nbsp; | &nbsp;&nbsp;.&nbsp; | &nbsp;&nbsp;.&nbsp; | &nbsp;&nbsp;.&nbsp; | &nbsp;&nbsp;.&nbsp; | &nbsp;&nbsp;.&nbsp; | &nbsp;&nbsp;.&nbsp; | &nbsp;&nbsp;.&nbsp; | &nbsp;&nbsp;.&nbsp; | &nbsp;&nbsp;.&nbsp; | &nbsp;&nbsp;.&nbsp; | &nbsp;&nbsp;.&nbsp; | &nbsp;&nbsp;.&nbsp; | &nbsp;&nbsp;.&nbsp; | &nbsp;&nbsp;.&nbsp; | &nbsp;&nbsp;.&nbsp; | &nbsp;&nbsp;.&nbsp; | &nbsp;&nbsp;.&nbsp; | &nbsp;&nbsp;.&nbsp; | &nbsp;&nbsp;.&nbsp; | &nbsp;&nbsp;.&nbsp; | &nbsp;&nbsp;.&nbsp; | &nbsp;&nbsp;.&nbsp; | &nbsp;&nbsp;.&nbsp; | &nbsp;&nbsp;.&nbsp; | &nbsp;&nbsp;.&nbsp; | &nbsp;&nbsp;.&nbsp; | &nbsp;&nbsp;.&nbsp; | &nbsp;&nbsp;.&nbsp; | &nbsp;&nbsp;.&nbsp; | &nbsp;&nbsp;.&nbsp; | &nbsp;&nbsp;.&nbsp; | &nbsp;&nbsp;.&nbsp; | &nbsp;&nbsp;.&nbsp; | &nbsp;&nbsp;.&nbsp; | &nbsp;&nbsp;.&nbsp; | &nbsp;&nbsp;.&nbsp; | &nbsp;&nbsp;.&nbsp; | &nbsp;&nbsp;.&nbsp; | &nbsp;&nbsp;.&nbsp; | &nbsp;&nbsp;.&nbsp; | &nbsp;&nbsp;.&nbsp; | &nbsp;&nbsp;.&nbsp; | &nbsp;&nbsp;.&nbsp; | &nbsp;&nbsp;.&nbsp; | &nbsp;&nbsp;.&nbsp; | &nbsp;&nbsp;1&nbsp; | &nbsp;&nbsp;.&nbsp; | &nbsp;&nbsp;.&nbsp; | &nbsp;&nbsp;.&nbsp; | &nbsp;&nbsp;.&nbsp; | &nbsp;&nbsp;.&nbsp; | &nbsp;&nbsp;.&nbsp; | &nbsp;&nbsp;.&nbsp; | &nbsp;&nbsp;.&nbsp; | &nbsp;&nbsp;.&nbsp; | &nbsp;&nbsp;.&nbsp; | &nbsp;&nbsp;.&nbsp; | &nbsp;&nbsp;.&nbsp; | &nbsp;&nbsp;.&nbsp; | &nbsp;&nbsp;.&nbsp; | &nbsp;&nbsp;.&nbsp; |  &nbsp;&nbsp;1&nbsp; | &nbsp;&nbsp;right_idler.stl |
| &nbsp;&nbsp;.&nbsp; | &nbsp;&nbsp;.&nbsp; | &nbsp;&nbsp;.&nbsp; | &nbsp;&nbsp;.&nbsp; | &nbsp;&nbsp;.&nbsp; | &nbsp;&nbsp;.&nbsp; | &nbsp;&nbsp;.&nbsp; | &nbsp;&nbsp;.&nbsp; | &nbsp;&nbsp;.&nbsp; | &nbsp;&nbsp;.&nbsp; | &nbsp;&nbsp;.&nbsp; | &nbsp;&nbsp;.&nbsp; | &nbsp;&nbsp;.&nbsp; | &nbsp;&nbsp;.&nbsp; | &nbsp;&nbsp;.&nbsp; | &nbsp;&nbsp;.&nbsp; | &nbsp;&nbsp;.&nbsp; | &nbsp;&nbsp;.&nbsp; | &nbsp;&nbsp;.&nbsp; | &nbsp;&nbsp;.&nbsp; | &nbsp;&nbsp;.&nbsp; | &nbsp;&nbsp;.&nbsp; | &nbsp;&nbsp;.&nbsp; | &nbsp;&nbsp;.&nbsp; | &nbsp;&nbsp;.&nbsp; | &nbsp;&nbsp;.&nbsp; | &nbsp;&nbsp;.&nbsp; | &nbsp;&nbsp;.&nbsp; | &nbsp;&nbsp;.&nbsp; | &nbsp;&nbsp;.&nbsp; | &nbsp;&nbsp;.&nbsp; | &nbsp;&nbsp;.&nbsp; | &nbsp;&nbsp;.&nbsp; | &nbsp;&nbsp;.&nbsp; | &nbsp;&nbsp;.&nbsp; | &nbsp;&nbsp;.&nbsp; | &nbsp;&nbsp;.&nbsp; | &nbsp;&nbsp;.&nbsp; | &nbsp;&nbsp;.&nbsp; | &nbsp;&nbsp;.&nbsp; | &nbsp;&nbsp;.&nbsp; | &nbsp;&nbsp;.&nbsp; | &nbsp;&nbsp;.&nbsp; | &nbsp;&nbsp;.&nbsp; | &nbsp;&nbsp;.&nbsp; | &nbsp;&nbsp;.&nbsp; | &nbsp;&nbsp;.&nbsp; | &nbsp;&nbsp;.&nbsp; | &nbsp;&nbsp;.&nbsp; | &nbsp;&nbsp;1&nbsp; | &nbsp;&nbsp;.&nbsp; | &nbsp;&nbsp;.&nbsp; | &nbsp;&nbsp;.&nbsp; | &nbsp;&nbsp;.&nbsp; | &nbsp;&nbsp;.&nbsp; | &nbsp;&nbsp;.&nbsp; | &nbsp;&nbsp;.&nbsp; | &nbsp;&nbsp;.&nbsp; | &nbsp;&nbsp;.&nbsp; | &nbsp;&nbsp;.&nbsp; | &nbsp;&nbsp;.&nbsp; | &nbsp;&nbsp;.&nbsp; | &nbsp;&nbsp;.&nbsp; | &nbsp;&nbsp;.&nbsp; | &nbsp;&nbsp;.&nbsp; | &nbsp;&nbsp;.&nbsp; | &nbsp;&nbsp;.&nbsp; | &nbsp;&nbsp;.&nbsp; | &nbsp;&nbsp;.&nbsp; | &nbsp;&nbsp;.&nbsp; | &nbsp;&nbsp;.&nbsp; | &nbsp;&nbsp;.&nbsp; |  &nbsp;&nbsp;1&nbsp; | &nbsp;&nbsp;right_motor_mount.stl |
| &nbsp;&nbsp;.&nbsp; | &nbsp;&nbsp;.&nbsp; | &nbsp;&nbsp;.&nbsp; | &nbsp;&nbsp;.&nbsp; | &nbsp;&nbsp;.&nbsp; | &nbsp;&nbsp;.&nbsp; | &nbsp;&nbsp;1&nbsp; | &nbsp;&nbsp;.&nbsp; | &nbsp;&nbsp;.&nbsp; | &nbsp;&nbsp;.&nbsp; | &nbsp;&nbsp;.&nbsp; | &nbsp;&nbsp;.&nbsp; | &nbsp;&nbsp;.&nbsp; | &nbsp;&nbsp;.&nbsp; | &nbsp;&nbsp;.&nbsp; | &nbsp;&nbsp;.&nbsp; | &nbsp;&nbsp;.&nbsp; | &nbsp;&nbsp;.&nbsp; | &nbsp;&nbsp;.&nbsp; | &nbsp;&nbsp;.&nbsp; | &nbsp;&nbsp;.&nbsp; | &nbsp;&nbsp;.&nbsp; | &nbsp;&nbsp;.&nbsp; | &nbsp;&nbsp;.&nbsp; | &nbsp;&nbsp;.&nbsp; | &nbsp;&nbsp;.&nbsp; | &nbsp;&nbsp;.&nbsp; | &nbsp;&nbsp;.&nbsp; | &nbsp;&nbsp;.&nbsp; | &nbsp;&nbsp;.&nbsp; | &nbsp;&nbsp;.&nbsp; | &nbsp;&nbsp;.&nbsp; | &nbsp;&nbsp;.&nbsp; | &nbsp;&nbsp;.&nbsp; | &nbsp;&nbsp;.&nbsp; | &nbsp;&nbsp;.&nbsp; | &nbsp;&nbsp;.&nbsp; | &nbsp;&nbsp;.&nbsp; | &nbsp;&nbsp;.&nbsp; | &nbsp;&nbsp;.&nbsp; | &nbsp;&nbsp;.&nbsp; | &nbsp;&nbsp;.&nbsp; | &nbsp;&nbsp;.&nbsp; | &nbsp;&nbsp;.&nbsp; | &nbsp;&nbsp;.&nbsp; | &nbsp;&nbsp;.&nbsp; | &nbsp;&nbsp;.&nbsp; | &nbsp;&nbsp;.&nbsp; | &nbsp;&nbsp;.&nbsp; | &nbsp;&nbsp;.&nbsp; | &nbsp;&nbsp;.&nbsp; | &nbsp;&nbsp;.&nbsp; | &nbsp;&nbsp;.&nbsp; | &nbsp;&nbsp;.&nbsp; | &nbsp;&nbsp;.&nbsp; | &nbsp;&nbsp;.&nbsp; | &nbsp;&nbsp;.&nbsp; | &nbsp;&nbsp;.&nbsp; | &nbsp;&nbsp;.&nbsp; | &nbsp;&nbsp;.&nbsp; | &nbsp;&nbsp;.&nbsp; | &nbsp;&nbsp;.&nbsp; | &nbsp;&nbsp;.&nbsp; | &nbsp;&nbsp;.&nbsp; | &nbsp;&nbsp;.&nbsp; | &nbsp;&nbsp;.&nbsp; | &nbsp;&nbsp;.&nbsp; | &nbsp;&nbsp;.&nbsp; | &nbsp;&nbsp;.&nbsp; | &nbsp;&nbsp;.&nbsp; | &nbsp;&nbsp;.&nbsp; | &nbsp;&nbsp;.&nbsp; |  &nbsp;&nbsp;1&nbsp; | &nbsp;&nbsp;right_y_carriage.stl |
| &nbsp;&nbsp;.&nbsp; | &nbsp;&nbsp;.&nbsp; | &nbsp;&nbsp;.&nbsp; | &nbsp;&nbsp;.&nbsp; | &nbsp;&nbsp;.&nbsp; | &nbsp;&nbsp;.&nbsp; | &nbsp;&nbsp;.&nbsp; | &nbsp;&nbsp;.&nbsp; | &nbsp;&nbsp;.&nbsp; | &nbsp;&nbsp;.&nbsp; | &nbsp;&nbsp;.&nbsp; | &nbsp;&nbsp;.&nbsp; | &nbsp;&nbsp;.&nbsp; | &nbsp;&nbsp;.&nbsp; | &nbsp;&nbsp;.&nbsp; | &nbsp;&nbsp;.&nbsp; | &nbsp;&nbsp;.&nbsp; | &nbsp;&nbsp;.&nbsp; | &nbsp;&nbsp;.&nbsp; | &nbsp;&nbsp;.&nbsp; | &nbsp;&nbsp;.&nbsp; | &nbsp;&nbsp;4&nbsp; | &nbsp;&nbsp;.&nbsp; | &nbsp;&nbsp;.&nbsp; | &nbsp;&nbsp;.&nbsp; | &nbsp;&nbsp;.&nbsp; | &nbsp;&nbsp;.&nbsp; | &nbsp;&nbsp;.&nbsp; | &nbsp;&nbsp;.&nbsp; | &nbsp;&nbsp;.&nbsp; | &nbsp;&nbsp;.&nbsp; | &nbsp;&nbsp;.&nbsp; | &nbsp;&nbsp;.&nbsp; | &nbsp;&nbsp;.&nbsp; | &nbsp;&nbsp;.&nbsp; | &nbsp;&nbsp;.&nbsp; | &nbsp;&nbsp;.&nbsp; | &nbsp;&nbsp;.&nbsp; | &nbsp;&nbsp;.&nbsp; | &nbsp;&nbsp;.&nbsp; | &nbsp;&nbsp;.&nbsp; | &nbsp;&nbsp;.&nbsp; | &nbsp;&nbsp;.&nbsp; | &nbsp;&nbsp;.&nbsp; | &nbsp;&nbsp;.&nbsp; | &nbsp;&nbsp;.&nbsp; | &nbsp;&nbsp;.&nbsp; | &nbsp;&nbsp;.&nbsp; | &nbsp;&nbsp;.&nbsp; | &nbsp;&nbsp;.&nbsp; | &nbsp;&nbsp;.&nbsp; | &nbsp;&nbsp;.&nbsp; | &nbsp;&nbsp;.&nbsp; | &nbsp;&nbsp;.&nbsp; | &nbsp;&nbsp;.&nbsp; | &nbsp;&nbsp;.&nbsp; | &nbsp;&nbsp;.&nbsp; | &nbsp;&nbsp;.&nbsp; | &nbsp;&nbsp;.&nbsp; | &nbsp;&nbsp;.&nbsp; | &nbsp;&nbsp;.&nbsp; | &nbsp;&nbsp;.&nbsp; | &nbsp;&nbsp;.&nbsp; | &nbsp;&nbsp;.&nbsp; | &nbsp;&nbsp;.&nbsp; | &nbsp;&nbsp;.&nbsp; | &nbsp;&nbsp;.&nbsp; | &nbsp;&nbsp;.&nbsp; | &nbsp;&nbsp;.&nbsp; | &nbsp;&nbsp;.&nbsp; | &nbsp;&nbsp;.&nbsp; | &nbsp;&nbsp;.&nbsp; |  &nbsp;&nbsp;4&nbsp; | &nbsp;&nbsp;side_top_corner.stl |
| &nbsp;&nbsp;.&nbsp; | &nbsp;&nbsp;.&nbsp; | &nbsp;&nbsp;.&nbsp; | &nbsp;&nbsp;.&nbsp; | &nbsp;&nbsp;.&nbsp; | &nbsp;&nbsp;.&nbsp; | &nbsp;&nbsp;.&nbsp; | &nbsp;&nbsp;.&nbsp; | &nbsp;&nbsp;.&nbsp; | &nbsp;&nbsp;.&nbsp; | &nbsp;&nbsp;.&nbsp; | &nbsp;&nbsp;.&nbsp; | &nbsp;&nbsp;.&nbsp; | &nbsp;&nbsp;.&nbsp; | &nbsp;&nbsp;.&nbsp; | &nbsp;&nbsp;.&nbsp; | &nbsp;&nbsp;.&nbsp; | &nbsp;&nbsp;.&nbsp; | &nbsp;&nbsp;.&nbsp; | &nbsp;&nbsp;.&nbsp; | &nbsp;&nbsp;.&nbsp; | &nbsp;&nbsp;.&nbsp; | &nbsp;&nbsp;.&nbsp; | &nbsp;&nbsp;.&nbsp; | &nbsp;&nbsp;.&nbsp; | &nbsp;&nbsp;.&nbsp; | &nbsp;&nbsp;.&nbsp; | &nbsp;&nbsp;.&nbsp; | &nbsp;&nbsp;.&nbsp; | &nbsp;&nbsp;.&nbsp; | &nbsp;&nbsp;.&nbsp; | &nbsp;&nbsp;.&nbsp; | &nbsp;&nbsp;.&nbsp; | &nbsp;&nbsp;.&nbsp; | &nbsp;&nbsp;.&nbsp; | &nbsp;&nbsp;.&nbsp; | &nbsp;&nbsp;.&nbsp; | &nbsp;&nbsp;.&nbsp; | &nbsp;&nbsp;.&nbsp; | &nbsp;&nbsp;.&nbsp; | &nbsp;&nbsp;.&nbsp; | &nbsp;&nbsp;.&nbsp; | &nbsp;&nbsp;.&nbsp; | &nbsp;&nbsp;.&nbsp; | &nbsp;&nbsp;.&nbsp; | &nbsp;&nbsp;.&nbsp; | &nbsp;&nbsp;.&nbsp; | &nbsp;&nbsp;.&nbsp; | &nbsp;&nbsp;.&nbsp; | &nbsp;&nbsp;.&nbsp; | &nbsp;&nbsp;.&nbsp; | &nbsp;&nbsp;.&nbsp; | &nbsp;&nbsp;.&nbsp; | &nbsp;&nbsp;.&nbsp; | &nbsp;&nbsp;.&nbsp; | &nbsp;&nbsp;.&nbsp; | &nbsp;&nbsp;.&nbsp; | &nbsp;&nbsp;1&nbsp; | &nbsp;&nbsp;.&nbsp; | &nbsp;&nbsp;1&nbsp; | &nbsp;&nbsp;.&nbsp; | &nbsp;&nbsp;.&nbsp; | &nbsp;&nbsp;.&nbsp; | &nbsp;&nbsp;.&nbsp; | &nbsp;&nbsp;.&nbsp; | &nbsp;&nbsp;.&nbsp; | &nbsp;&nbsp;.&nbsp; | &nbsp;&nbsp;.&nbsp; | &nbsp;&nbsp;.&nbsp; | &nbsp;&nbsp;.&nbsp; | &nbsp;&nbsp;.&nbsp; | &nbsp;&nbsp;.&nbsp; |  &nbsp;&nbsp;2&nbsp; | &nbsp;&nbsp;spool_rod_holder.stl |
| &nbsp;&nbsp;.&nbsp; | &nbsp;&nbsp;.&nbsp; | &nbsp;&nbsp;.&nbsp; | &nbsp;&nbsp;.&nbsp; | &nbsp;&nbsp;.&nbsp; | &nbsp;&nbsp;.&nbsp; | &nbsp;&nbsp;.&nbsp; | &nbsp;&nbsp;.&nbsp; | &nbsp;&nbsp;.&nbsp; | &nbsp;&nbsp;.&nbsp; | &nbsp;&nbsp;.&nbsp; | &nbsp;&nbsp;.&nbsp; | &nbsp;&nbsp;.&nbsp; | &nbsp;&nbsp;.&nbsp; | &nbsp;&nbsp;.&nbsp; | &nbsp;&nbsp;.&nbsp; | &nbsp;&nbsp;.&nbsp; | &nbsp;&nbsp;.&nbsp; | &nbsp;&nbsp;.&nbsp; | &nbsp;&nbsp;.&nbsp; | &nbsp;&nbsp;.&nbsp; | &nbsp;&nbsp;.&nbsp; | &nbsp;&nbsp;.&nbsp; | &nbsp;&nbsp;.&nbsp; | &nbsp;&nbsp;.&nbsp; | &nbsp;&nbsp;.&nbsp; | &nbsp;&nbsp;.&nbsp; | &nbsp;&nbsp;.&nbsp; | &nbsp;&nbsp;.&nbsp; | &nbsp;&nbsp;.&nbsp; | &nbsp;&nbsp;.&nbsp; | &nbsp;&nbsp;.&nbsp; | &nbsp;&nbsp;.&nbsp; | &nbsp;&nbsp;.&nbsp; | &nbsp;&nbsp;.&nbsp; | &nbsp;&nbsp;.&nbsp; | &nbsp;&nbsp;.&nbsp; | &nbsp;&nbsp;.&nbsp; | &nbsp;&nbsp;.&nbsp; | &nbsp;&nbsp;.&nbsp; | &nbsp;&nbsp;.&nbsp; | &nbsp;&nbsp;.&nbsp; | &nbsp;&nbsp;.&nbsp; | &nbsp;&nbsp;.&nbsp; | &nbsp;&nbsp;.&nbsp; | &nbsp;&nbsp;.&nbsp; | &nbsp;&nbsp;2&nbsp; | &nbsp;&nbsp;.&nbsp; | &nbsp;&nbsp;.&nbsp; | &nbsp;&nbsp;.&nbsp; | &nbsp;&nbsp;.&nbsp; | &nbsp;&nbsp;.&nbsp; | &nbsp;&nbsp;.&nbsp; | &nbsp;&nbsp;.&nbsp; | &nbsp;&nbsp;.&nbsp; | &nbsp;&nbsp;.&nbsp; | &nbsp;&nbsp;.&nbsp; | &nbsp;&nbsp;.&nbsp; | &nbsp;&nbsp;.&nbsp; | &nbsp;&nbsp;.&nbsp; | &nbsp;&nbsp;.&nbsp; | &nbsp;&nbsp;.&nbsp; | &nbsp;&nbsp;.&nbsp; | &nbsp;&nbsp;.&nbsp; | &nbsp;&nbsp;.&nbsp; | &nbsp;&nbsp;.&nbsp; | &nbsp;&nbsp;.&nbsp; | &nbsp;&nbsp;.&nbsp; | &nbsp;&nbsp;.&nbsp; | &nbsp;&nbsp;.&nbsp; | &nbsp;&nbsp;.&nbsp; | &nbsp;&nbsp;.&nbsp; |  &nbsp;&nbsp;2&nbsp; | &nbsp;&nbsp;titan_mount.stl |
| &nbsp;&nbsp;.&nbsp; | &nbsp;&nbsp;.&nbsp; | &nbsp;&nbsp;.&nbsp; | &nbsp;&nbsp;.&nbsp; | &nbsp;&nbsp;.&nbsp; | &nbsp;&nbsp;.&nbsp; | &nbsp;&nbsp;.&nbsp; | &nbsp;&nbsp;.&nbsp; | &nbsp;&nbsp;.&nbsp; | &nbsp;&nbsp;1&nbsp; | &nbsp;&nbsp;.&nbsp; | &nbsp;&nbsp;.&nbsp; | &nbsp;&nbsp;.&nbsp; | &nbsp;&nbsp;.&nbsp; | &nbsp;&nbsp;.&nbsp; | &nbsp;&nbsp;.&nbsp; | &nbsp;&nbsp;.&nbsp; | &nbsp;&nbsp;.&nbsp; | &nbsp;&nbsp;.&nbsp; | &nbsp;&nbsp;.&nbsp; | &nbsp;&nbsp;.&nbsp; | &nbsp;&nbsp;.&nbsp; | &nbsp;&nbsp;.&nbsp; | &nbsp;&nbsp;.&nbsp; | &nbsp;&nbsp;.&nbsp; | &nbsp;&nbsp;.&nbsp; | &nbsp;&nbsp;.&nbsp; | &nbsp;&nbsp;.&nbsp; | &nbsp;&nbsp;.&nbsp; | &nbsp;&nbsp;.&nbsp; | &nbsp;&nbsp;.&nbsp; | &nbsp;&nbsp;.&nbsp; | &nbsp;&nbsp;.&nbsp; | &nbsp;&nbsp;.&nbsp; | &nbsp;&nbsp;.&nbsp; | &nbsp;&nbsp;.&nbsp; | &nbsp;&nbsp;.&nbsp; | &nbsp;&nbsp;.&nbsp; | &nbsp;&nbsp;.&nbsp; | &nbsp;&nbsp;.&nbsp; | &nbsp;&nbsp;.&nbsp; | &nbsp;&nbsp;.&nbsp; | &nbsp;&nbsp;.&nbsp; | &nbsp;&nbsp;.&nbsp; | &nbsp;&nbsp;.&nbsp; | &nbsp;&nbsp;.&nbsp; | &nbsp;&nbsp;.&nbsp; | &nbsp;&nbsp;.&nbsp; | &nbsp;&nbsp;.&nbsp; | &nbsp;&nbsp;.&nbsp; | &nbsp;&nbsp;.&nbsp; | &nbsp;&nbsp;.&nbsp; | &nbsp;&nbsp;.&nbsp; | &nbsp;&nbsp;.&nbsp; | &nbsp;&nbsp;.&nbsp; | &nbsp;&nbsp;.&nbsp; | &nbsp;&nbsp;.&nbsp; | &nbsp;&nbsp;.&nbsp; | &nbsp;&nbsp;.&nbsp; | &nbsp;&nbsp;.&nbsp; | &nbsp;&nbsp;.&nbsp; | &nbsp;&nbsp;.&nbsp; | &nbsp;&nbsp;.&nbsp; | &nbsp;&nbsp;.&nbsp; | &nbsp;&nbsp;.&nbsp; | &nbsp;&nbsp;.&nbsp; | &nbsp;&nbsp;.&nbsp; | &nbsp;&nbsp;.&nbsp; | &nbsp;&nbsp;.&nbsp; | &nbsp;&nbsp;.&nbsp; | &nbsp;&nbsp;.&nbsp; | &nbsp;&nbsp;.&nbsp; |  &nbsp;&nbsp;1&nbsp; | &nbsp;&nbsp;x_carriage_front.stl |
| &nbsp;&nbsp;.&nbsp; | &nbsp;&nbsp;.&nbsp; | &nbsp;&nbsp;.&nbsp; | &nbsp;&nbsp;.&nbsp; | &nbsp;&nbsp;.&nbsp; | &nbsp;&nbsp;.&nbsp; | &nbsp;&nbsp;.&nbsp; | &nbsp;&nbsp;.&nbsp; | &nbsp;&nbsp;.&nbsp; | &nbsp;&nbsp;.&nbsp; | &nbsp;&nbsp;1&nbsp; | &nbsp;&nbsp;.&nbsp; | &nbsp;&nbsp;.&nbsp; | &nbsp;&nbsp;1&nbsp; | &nbsp;&nbsp;.&nbsp; | &nbsp;&nbsp;.&nbsp; | &nbsp;&nbsp;.&nbsp; | &nbsp;&nbsp;.&nbsp; | &nbsp;&nbsp;.&nbsp; | &nbsp;&nbsp;.&nbsp; | &nbsp;&nbsp;.&nbsp; | &nbsp;&nbsp;.&nbsp; | &nbsp;&nbsp;.&nbsp; | &nbsp;&nbsp;.&nbsp; | &nbsp;&nbsp;.&nbsp; | &nbsp;&nbsp;.&nbsp; | &nbsp;&nbsp;.&nbsp; | &nbsp;&nbsp;.&nbsp; | &nbsp;&nbsp;.&nbsp; | &nbsp;&nbsp;.&nbsp; | &nbsp;&nbsp;.&nbsp; | &nbsp;&nbsp;.&nbsp; | &nbsp;&nbsp;.&nbsp; | &nbsp;&nbsp;.&nbsp; | &nbsp;&nbsp;.&nbsp; | &nbsp;&nbsp;.&nbsp; | &nbsp;&nbsp;.&nbsp; | &nbsp;&nbsp;.&nbsp; | &nbsp;&nbsp;.&nbsp; | &nbsp;&nbsp;.&nbsp; | &nbsp;&nbsp;.&nbsp; | &nbsp;&nbsp;.&nbsp; | &nbsp;&nbsp;.&nbsp; | &nbsp;&nbsp;.&nbsp; | &nbsp;&nbsp;.&nbsp; | &nbsp;&nbsp;.&nbsp; | &nbsp;&nbsp;.&nbsp; | &nbsp;&nbsp;.&nbsp; | &nbsp;&nbsp;.&nbsp; | &nbsp;&nbsp;.&nbsp; | &nbsp;&nbsp;.&nbsp; | &nbsp;&nbsp;.&nbsp; | &nbsp;&nbsp;.&nbsp; | &nbsp;&nbsp;.&nbsp; | &nbsp;&nbsp;.&nbsp; | &nbsp;&nbsp;.&nbsp; | &nbsp;&nbsp;.&nbsp; | &nbsp;&nbsp;.&nbsp; | &nbsp;&nbsp;.&nbsp; | &nbsp;&nbsp;.&nbsp; | &nbsp;&nbsp;.&nbsp; | &nbsp;&nbsp;.&nbsp; | &nbsp;&nbsp;.&nbsp; | &nbsp;&nbsp;.&nbsp; | &nbsp;&nbsp;.&nbsp; | &nbsp;&nbsp;.&nbsp; | &nbsp;&nbsp;.&nbsp; | &nbsp;&nbsp;.&nbsp; | &nbsp;&nbsp;.&nbsp; | &nbsp;&nbsp;.&nbsp; | &nbsp;&nbsp;.&nbsp; | &nbsp;&nbsp;.&nbsp; |  &nbsp;&nbsp;2&nbsp; | &nbsp;&nbsp;x_carriage_mount.stl |
| &nbsp;&nbsp;.&nbsp; | &nbsp;&nbsp;.&nbsp; | &nbsp;&nbsp;.&nbsp; | &nbsp;&nbsp;.&nbsp; | &nbsp;&nbsp;.&nbsp; | &nbsp;&nbsp;.&nbsp; | &nbsp;&nbsp;.&nbsp; | &nbsp;&nbsp;.&nbsp; | &nbsp;&nbsp;1&nbsp; | &nbsp;&nbsp;.&nbsp; | &nbsp;&nbsp;.&nbsp; | &nbsp;&nbsp;.&nbsp; | &nbsp;&nbsp;.&nbsp; | &nbsp;&nbsp;.&nbsp; | &nbsp;&nbsp;.&nbsp; | &nbsp;&nbsp;.&nbsp; | &nbsp;&nbsp;.&nbsp; | &nbsp;&nbsp;.&nbsp; | &nbsp;&nbsp;.&nbsp; | &nbsp;&nbsp;.&nbsp; | &nbsp;&nbsp;.&nbsp; | &nbsp;&nbsp;.&nbsp; | &nbsp;&nbsp;.&nbsp; | &nbsp;&nbsp;.&nbsp; | &nbsp;&nbsp;.&nbsp; | &nbsp;&nbsp;.&nbsp; | &nbsp;&nbsp;.&nbsp; | &nbsp;&nbsp;.&nbsp; | &nbsp;&nbsp;.&nbsp; | &nbsp;&nbsp;.&nbsp; | &nbsp;&nbsp;.&nbsp; | &nbsp;&nbsp;.&nbsp; | &nbsp;&nbsp;.&nbsp; | &nbsp;&nbsp;.&nbsp; | &nbsp;&nbsp;.&nbsp; | &nbsp;&nbsp;.&nbsp; | &nbsp;&nbsp;.&nbsp; | &nbsp;&nbsp;.&nbsp; | &nbsp;&nbsp;.&nbsp; | &nbsp;&nbsp;.&nbsp; | &nbsp;&nbsp;.&nbsp; | &nbsp;&nbsp;.&nbsp; | &nbsp;&nbsp;.&nbsp; | &nbsp;&nbsp;.&nbsp; | &nbsp;&nbsp;.&nbsp; | &nbsp;&nbsp;.&nbsp; | &nbsp;&nbsp;.&nbsp; | &nbsp;&nbsp;.&nbsp; | &nbsp;&nbsp;.&nbsp; | &nbsp;&nbsp;.&nbsp; | &nbsp;&nbsp;.&nbsp; | &nbsp;&nbsp;.&nbsp; | &nbsp;&nbsp;.&nbsp; | &nbsp;&nbsp;.&nbsp; | &nbsp;&nbsp;.&nbsp; | &nbsp;&nbsp;.&nbsp; | &nbsp;&nbsp;.&nbsp; | &nbsp;&nbsp;.&nbsp; | &nbsp;&nbsp;.&nbsp; | &nbsp;&nbsp;.&nbsp; | &nbsp;&nbsp;.&nbsp; | &nbsp;&nbsp;.&nbsp; | &nbsp;&nbsp;.&nbsp; | &nbsp;&nbsp;.&nbsp; | &nbsp;&nbsp;.&nbsp; | &nbsp;&nbsp;.&nbsp; | &nbsp;&nbsp;.&nbsp; | &nbsp;&nbsp;.&nbsp; | &nbsp;&nbsp;.&nbsp; | &nbsp;&nbsp;.&nbsp; | &nbsp;&nbsp;.&nbsp; | &nbsp;&nbsp;.&nbsp; |  &nbsp;&nbsp;1&nbsp; | &nbsp;&nbsp;x_carriage_rear.stl |
| &nbsp;&nbsp;.&nbsp; | &nbsp;&nbsp;.&nbsp; | &nbsp;&nbsp;.&nbsp; | &nbsp;&nbsp;.&nbsp; | &nbsp;&nbsp;.&nbsp; | &nbsp;&nbsp;.&nbsp; | &nbsp;&nbsp;.&nbsp; | &nbsp;&nbsp;.&nbsp; | &nbsp;&nbsp;1&nbsp; | &nbsp;&nbsp;.&nbsp; | &nbsp;&nbsp;.&nbsp; | &nbsp;&nbsp;.&nbsp; | &nbsp;&nbsp;.&nbsp; | &nbsp;&nbsp;.&nbsp; | &nbsp;&nbsp;.&nbsp; | &nbsp;&nbsp;.&nbsp; | &nbsp;&nbsp;.&nbsp; | &nbsp;&nbsp;.&nbsp; | &nbsp;&nbsp;.&nbsp; | &nbsp;&nbsp;.&nbsp; | &nbsp;&nbsp;.&nbsp; | &nbsp;&nbsp;.&nbsp; | &nbsp;&nbsp;.&nbsp; | &nbsp;&nbsp;.&nbsp; | &nbsp;&nbsp;.&nbsp; | &nbsp;&nbsp;.&nbsp; | &nbsp;&nbsp;.&nbsp; | &nbsp;&nbsp;.&nbsp; | &nbsp;&nbsp;.&nbsp; | &nbsp;&nbsp;.&nbsp; | &nbsp;&nbsp;.&nbsp; | &nbsp;&nbsp;.&nbsp; | &nbsp;&nbsp;.&nbsp; | &nbsp;&nbsp;.&nbsp; | &nbsp;&nbsp;.&nbsp; | &nbsp;&nbsp;.&nbsp; | &nbsp;&nbsp;.&nbsp; | &nbsp;&nbsp;.&nbsp; | &nbsp;&nbsp;.&nbsp; | &nbsp;&nbsp;.&nbsp; | &nbsp;&nbsp;.&nbsp; | &nbsp;&nbsp;.&nbsp; | &nbsp;&nbsp;.&nbsp; | &nbsp;&nbsp;.&nbsp; | &nbsp;&nbsp;.&nbsp; | &nbsp;&nbsp;.&nbsp; | &nbsp;&nbsp;.&nbsp; | &nbsp;&nbsp;.&nbsp; | &nbsp;&nbsp;.&nbsp; | &nbsp;&nbsp;.&nbsp; | &nbsp;&nbsp;.&nbsp; | &nbsp;&nbsp;.&nbsp; | &nbsp;&nbsp;.&nbsp; | &nbsp;&nbsp;.&nbsp; | &nbsp;&nbsp;.&nbsp; | &nbsp;&nbsp;.&nbsp; | &nbsp;&nbsp;.&nbsp; | &nbsp;&nbsp;.&nbsp; | &nbsp;&nbsp;.&nbsp; | &nbsp;&nbsp;.&nbsp; | &nbsp;&nbsp;.&nbsp; | &nbsp;&nbsp;.&nbsp; | &nbsp;&nbsp;.&nbsp; | &nbsp;&nbsp;.&nbsp; | &nbsp;&nbsp;.&nbsp; | &nbsp;&nbsp;.&nbsp; | &nbsp;&nbsp;.&nbsp; | &nbsp;&nbsp;.&nbsp; | &nbsp;&nbsp;.&nbsp; | &nbsp;&nbsp;.&nbsp; | &nbsp;&nbsp;.&nbsp; | &nbsp;&nbsp;.&nbsp; |  &nbsp;&nbsp;1&nbsp; | &nbsp;&nbsp;x_endstop_mount.stl |
| &nbsp;&nbsp;.&nbsp; | &nbsp;&nbsp;.&nbsp; | &nbsp;&nbsp;.&nbsp; | &nbsp;&nbsp;.&nbsp; | &nbsp;&nbsp;.&nbsp; | &nbsp;&nbsp;.&nbsp; | &nbsp;&nbsp;.&nbsp; | &nbsp;&nbsp;.&nbsp; | &nbsp;&nbsp;.&nbsp; | &nbsp;&nbsp;.&nbsp; | &nbsp;&nbsp;.&nbsp; | &nbsp;&nbsp;.&nbsp; | &nbsp;&nbsp;.&nbsp; | &nbsp;&nbsp;.&nbsp; | &nbsp;&nbsp;.&nbsp; | &nbsp;&nbsp;.&nbsp; | &nbsp;&nbsp;.&nbsp; | &nbsp;&nbsp;.&nbsp; | &nbsp;&nbsp;.&nbsp; | &nbsp;&nbsp;.&nbsp; | &nbsp;&nbsp;.&nbsp; | &nbsp;&nbsp;.&nbsp; | &nbsp;&nbsp;.&nbsp; | &nbsp;&nbsp;1&nbsp; | &nbsp;&nbsp;.&nbsp; | &nbsp;&nbsp;.&nbsp; | &nbsp;&nbsp;.&nbsp; | &nbsp;&nbsp;.&nbsp; | &nbsp;&nbsp;.&nbsp; | &nbsp;&nbsp;.&nbsp; | &nbsp;&nbsp;.&nbsp; | &nbsp;&nbsp;.&nbsp; | &nbsp;&nbsp;.&nbsp; | &nbsp;&nbsp;.&nbsp; | &nbsp;&nbsp;.&nbsp; | &nbsp;&nbsp;.&nbsp; | &nbsp;&nbsp;.&nbsp; | &nbsp;&nbsp;.&nbsp; | &nbsp;&nbsp;.&nbsp; | &nbsp;&nbsp;.&nbsp; | &nbsp;&nbsp;.&nbsp; | &nbsp;&nbsp;.&nbsp; | &nbsp;&nbsp;.&nbsp; | &nbsp;&nbsp;.&nbsp; | &nbsp;&nbsp;.&nbsp; | &nbsp;&nbsp;.&nbsp; | &nbsp;&nbsp;.&nbsp; | &nbsp;&nbsp;.&nbsp; | &nbsp;&nbsp;.&nbsp; | &nbsp;&nbsp;.&nbsp; | &nbsp;&nbsp;.&nbsp; | &nbsp;&nbsp;.&nbsp; | &nbsp;&nbsp;.&nbsp; | &nbsp;&nbsp;.&nbsp; | &nbsp;&nbsp;.&nbsp; | &nbsp;&nbsp;.&nbsp; | &nbsp;&nbsp;.&nbsp; | &nbsp;&nbsp;.&nbsp; | &nbsp;&nbsp;.&nbsp; | &nbsp;&nbsp;.&nbsp; | &nbsp;&nbsp;.&nbsp; | &nbsp;&nbsp;.&nbsp; | &nbsp;&nbsp;.&nbsp; | &nbsp;&nbsp;.&nbsp; | &nbsp;&nbsp;.&nbsp; | &nbsp;&nbsp;.&nbsp; | &nbsp;&nbsp;.&nbsp; | &nbsp;&nbsp;.&nbsp; | &nbsp;&nbsp;.&nbsp; | &nbsp;&nbsp;.&nbsp; | &nbsp;&nbsp;.&nbsp; | &nbsp;&nbsp;.&nbsp; |  &nbsp;&nbsp;1&nbsp; | &nbsp;&nbsp;y_endstop_mount.stl |
| &nbsp;&nbsp;.&nbsp; | &nbsp;&nbsp;.&nbsp; | &nbsp;&nbsp;.&nbsp; | &nbsp;&nbsp;.&nbsp; | &nbsp;&nbsp;.&nbsp; | &nbsp;&nbsp;.&nbsp; | &nbsp;&nbsp;.&nbsp; | &nbsp;&nbsp;.&nbsp; | &nbsp;&nbsp;.&nbsp; | &nbsp;&nbsp;.&nbsp; | &nbsp;&nbsp;.&nbsp; | &nbsp;&nbsp;.&nbsp; | &nbsp;&nbsp;.&nbsp; | &nbsp;&nbsp;.&nbsp; | &nbsp;&nbsp;.&nbsp; | &nbsp;&nbsp;.&nbsp; | &nbsp;&nbsp;.&nbsp; | &nbsp;&nbsp;.&nbsp; | &nbsp;&nbsp;.&nbsp; | &nbsp;&nbsp;.&nbsp; | &nbsp;&nbsp;.&nbsp; | &nbsp;&nbsp;.&nbsp; | &nbsp;&nbsp;.&nbsp; | &nbsp;&nbsp;.&nbsp; | &nbsp;&nbsp;.&nbsp; | &nbsp;&nbsp;.&nbsp; | &nbsp;&nbsp;.&nbsp; | &nbsp;&nbsp;.&nbsp; | &nbsp;&nbsp;.&nbsp; | &nbsp;&nbsp;.&nbsp; | &nbsp;&nbsp;.&nbsp; | &nbsp;&nbsp;.&nbsp; | &nbsp;&nbsp;.&nbsp; | &nbsp;&nbsp;.&nbsp; | &nbsp;&nbsp;.&nbsp; | &nbsp;&nbsp;2&nbsp; | &nbsp;&nbsp;.&nbsp; | &nbsp;&nbsp;.&nbsp; | &nbsp;&nbsp;.&nbsp; | &nbsp;&nbsp;.&nbsp; | &nbsp;&nbsp;.&nbsp; | &nbsp;&nbsp;.&nbsp; | &nbsp;&nbsp;.&nbsp; | &nbsp;&nbsp;.&nbsp; | &nbsp;&nbsp;.&nbsp; | &nbsp;&nbsp;.&nbsp; | &nbsp;&nbsp;.&nbsp; | &nbsp;&nbsp;.&nbsp; | &nbsp;&nbsp;.&nbsp; | &nbsp;&nbsp;.&nbsp; | &nbsp;&nbsp;.&nbsp; | &nbsp;&nbsp;.&nbsp; | &nbsp;&nbsp;.&nbsp; | &nbsp;&nbsp;.&nbsp; | &nbsp;&nbsp;.&nbsp; | &nbsp;&nbsp;.&nbsp; | &nbsp;&nbsp;.&nbsp; | &nbsp;&nbsp;.&nbsp; | &nbsp;&nbsp;.&nbsp; | &nbsp;&nbsp;.&nbsp; | &nbsp;&nbsp;.&nbsp; | &nbsp;&nbsp;.&nbsp; | &nbsp;&nbsp;.&nbsp; | &nbsp;&nbsp;.&nbsp; | &nbsp;&nbsp;.&nbsp; | &nbsp;&nbsp;.&nbsp; | &nbsp;&nbsp;.&nbsp; | &nbsp;&nbsp;.&nbsp; | &nbsp;&nbsp;.&nbsp; | &nbsp;&nbsp;.&nbsp; | &nbsp;&nbsp;.&nbsp; | &nbsp;&nbsp;.&nbsp; |  &nbsp;&nbsp;2&nbsp; | &nbsp;&nbsp;z_motor_mount.stl |
| &nbsp;&nbsp;.&nbsp; | &nbsp;&nbsp;.&nbsp; | &nbsp;&nbsp;.&nbsp; | &nbsp;&nbsp;.&nbsp; | &nbsp;&nbsp;.&nbsp; | &nbsp;&nbsp;.&nbsp; | &nbsp;&nbsp;.&nbsp; | &nbsp;&nbsp;.&nbsp; | &nbsp;&nbsp;.&nbsp; | &nbsp;&nbsp;.&nbsp; | &nbsp;&nbsp;.&nbsp; | &nbsp;&nbsp;.&nbsp; | &nbsp;&nbsp;.&nbsp; | &nbsp;&nbsp;.&nbsp; | &nbsp;&nbsp;.&nbsp; | &nbsp;&nbsp;.&nbsp; | &nbsp;&nbsp;.&nbsp; | &nbsp;&nbsp;.&nbsp; | &nbsp;&nbsp;.&nbsp; | &nbsp;&nbsp;.&nbsp; | &nbsp;&nbsp;.&nbsp; | &nbsp;&nbsp;.&nbsp; | &nbsp;&nbsp;.&nbsp; | &nbsp;&nbsp;.&nbsp; | &nbsp;&nbsp;.&nbsp; | &nbsp;&nbsp;.&nbsp; | &nbsp;&nbsp;.&nbsp; | &nbsp;&nbsp;.&nbsp; | &nbsp;&nbsp;.&nbsp; | &nbsp;&nbsp;.&nbsp; | &nbsp;&nbsp;2&nbsp; | &nbsp;&nbsp;.&nbsp; | &nbsp;&nbsp;.&nbsp; | &nbsp;&nbsp;.&nbsp; | &nbsp;&nbsp;.&nbsp; | &nbsp;&nbsp;.&nbsp; | &nbsp;&nbsp;.&nbsp; | &nbsp;&nbsp;.&nbsp; | &nbsp;&nbsp;.&nbsp; | &nbsp;&nbsp;.&nbsp; | &nbsp;&nbsp;.&nbsp; | &nbsp;&nbsp;.&nbsp; | &nbsp;&nbsp;.&nbsp; | &nbsp;&nbsp;.&nbsp; | &nbsp;&nbsp;.&nbsp; | &nbsp;&nbsp;.&nbsp; | &nbsp;&nbsp;.&nbsp; | &nbsp;&nbsp;.&nbsp; | &nbsp;&nbsp;.&nbsp; | &nbsp;&nbsp;.&nbsp; | &nbsp;&nbsp;.&nbsp; | &nbsp;&nbsp;.&nbsp; | &nbsp;&nbsp;.&nbsp; | &nbsp;&nbsp;.&nbsp; | &nbsp;&nbsp;.&nbsp; | &nbsp;&nbsp;.&nbsp; | &nbsp;&nbsp;.&nbsp; | &nbsp;&nbsp;.&nbsp; | &nbsp;&nbsp;.&nbsp; | &nbsp;&nbsp;.&nbsp; | &nbsp;&nbsp;.&nbsp; | &nbsp;&nbsp;.&nbsp; | &nbsp;&nbsp;.&nbsp; | &nbsp;&nbsp;.&nbsp; | &nbsp;&nbsp;.&nbsp; | &nbsp;&nbsp;.&nbsp; | &nbsp;&nbsp;.&nbsp; | &nbsp;&nbsp;.&nbsp; | &nbsp;&nbsp;.&nbsp; | &nbsp;&nbsp;.&nbsp; | &nbsp;&nbsp;.&nbsp; | &nbsp;&nbsp;.&nbsp; |  &nbsp;&nbsp;2&nbsp; | &nbsp;&nbsp;z_rail_mount.stl |
| &nbsp;&nbsp;2&nbsp; | &nbsp;&nbsp;.&nbsp; | &nbsp;&nbsp;.&nbsp; | &nbsp;&nbsp;.&nbsp; | &nbsp;&nbsp;.&nbsp; | &nbsp;&nbsp;.&nbsp; | &nbsp;&nbsp;1&nbsp; | &nbsp;&nbsp;1&nbsp; | &nbsp;&nbsp;4&nbsp; | &nbsp;&nbsp;4&nbsp; | &nbsp;&nbsp;1&nbsp; | &nbsp;&nbsp;.&nbsp; | &nbsp;&nbsp;.&nbsp; | &nbsp;&nbsp;1&nbsp; | &nbsp;&nbsp;.&nbsp; | &nbsp;&nbsp;.&nbsp; | &nbsp;&nbsp;3&nbsp; | &nbsp;&nbsp;.&nbsp; | &nbsp;&nbsp;.&nbsp; | &nbsp;&nbsp;1&nbsp; | &nbsp;&nbsp;1&nbsp; | &nbsp;&nbsp;4&nbsp; | &nbsp;&nbsp;1&nbsp; | &nbsp;&nbsp;1&nbsp; | &nbsp;&nbsp;.&nbsp; | &nbsp;&nbsp;.&nbsp; | &nbsp;&nbsp;.&nbsp; | &nbsp;&nbsp;4&nbsp; | &nbsp;&nbsp;4&nbsp; | &nbsp;&nbsp;1&nbsp; | &nbsp;&nbsp;2&nbsp; | &nbsp;&nbsp;.&nbsp; | &nbsp;&nbsp;.&nbsp; | &nbsp;&nbsp;.&nbsp; | &nbsp;&nbsp;2&nbsp; | &nbsp;&nbsp;2&nbsp; | &nbsp;&nbsp;.&nbsp; | &nbsp;&nbsp;.&nbsp; | &nbsp;&nbsp;.&nbsp; | &nbsp;&nbsp;.&nbsp; | &nbsp;&nbsp;1&nbsp; | &nbsp;&nbsp;1&nbsp; | &nbsp;&nbsp;1&nbsp; | &nbsp;&nbsp;1&nbsp; | &nbsp;&nbsp;.&nbsp; | &nbsp;&nbsp;.&nbsp; | &nbsp;&nbsp;2&nbsp; | &nbsp;&nbsp;1&nbsp; | &nbsp;&nbsp;1&nbsp; | &nbsp;&nbsp;1&nbsp; | &nbsp;&nbsp;.&nbsp; | &nbsp;&nbsp;.&nbsp; | &nbsp;&nbsp;.&nbsp; | &nbsp;&nbsp;.&nbsp; | &nbsp;&nbsp;.&nbsp; | &nbsp;&nbsp;.&nbsp; | &nbsp;&nbsp;1&nbsp; | &nbsp;&nbsp;2&nbsp; | &nbsp;&nbsp;.&nbsp; | &nbsp;&nbsp;2&nbsp; | &nbsp;&nbsp;.&nbsp; | &nbsp;&nbsp;.&nbsp; | &nbsp;&nbsp;.&nbsp; | &nbsp;&nbsp;.&nbsp; | &nbsp;&nbsp;.&nbsp; | &nbsp;&nbsp;.&nbsp; | &nbsp;&nbsp;.&nbsp; | &nbsp;&nbsp;2&nbsp; | &nbsp;&nbsp;.&nbsp; | &nbsp;&nbsp;.&nbsp; | &nbsp;&nbsp;.&nbsp; | &nbsp;&nbsp;.&nbsp; | &nbsp;&nbsp;56&nbsp; | &nbsp;&nbsp;Total 3D printed parts count |
|  |  |  |  |  |  |  |  |  |  |  |  |  |  |  |  |  |  |  |  |  |  |  |  |  |  |  |  |  |  |  |  |  |  |  |  |  |  |  |  |  |  |  |  |  |  |  |  |  |  |  |  |  |  |  |  |  |  |  |  |  |  |  |  |  |  |  |  |  |  |  |  | | **CNC routed parts** |
| &nbsp;&nbsp;.&nbsp; | &nbsp;&nbsp;.&nbsp; | &nbsp;&nbsp;.&nbsp; | &nbsp;&nbsp;2&nbsp; | &nbsp;&nbsp;.&nbsp; | &nbsp;&nbsp;.&nbsp; | &nbsp;&nbsp;.&nbsp; | &nbsp;&nbsp;.&nbsp; | &nbsp;&nbsp;.&nbsp; | &nbsp;&nbsp;.&nbsp; | &nbsp;&nbsp;.&nbsp; | &nbsp;&nbsp;.&nbsp; | &nbsp;&nbsp;.&nbsp; | &nbsp;&nbsp;.&nbsp; | &nbsp;&nbsp;.&nbsp; | &nbsp;&nbsp;.&nbsp; | &nbsp;&nbsp;.&nbsp; | &nbsp;&nbsp;.&nbsp; | &nbsp;&nbsp;.&nbsp; | &nbsp;&nbsp;.&nbsp; | &nbsp;&nbsp;.&nbsp; | &nbsp;&nbsp;.&nbsp; | &nbsp;&nbsp;.&nbsp; | &nbsp;&nbsp;.&nbsp; | &nbsp;&nbsp;.&nbsp; | &nbsp;&nbsp;.&nbsp; | &nbsp;&nbsp;.&nbsp; | &nbsp;&nbsp;.&nbsp; | &nbsp;&nbsp;.&nbsp; | &nbsp;&nbsp;.&nbsp; | &nbsp;&nbsp;.&nbsp; | &nbsp;&nbsp;.&nbsp; | &nbsp;&nbsp;.&nbsp; | &nbsp;&nbsp;.&nbsp; | &nbsp;&nbsp;.&nbsp; | &nbsp;&nbsp;.&nbsp; | &nbsp;&nbsp;.&nbsp; | &nbsp;&nbsp;.&nbsp; | &nbsp;&nbsp;.&nbsp; | &nbsp;&nbsp;.&nbsp; | &nbsp;&nbsp;.&nbsp; | &nbsp;&nbsp;.&nbsp; | &nbsp;&nbsp;.&nbsp; | &nbsp;&nbsp;.&nbsp; | &nbsp;&nbsp;.&nbsp; | &nbsp;&nbsp;.&nbsp; | &nbsp;&nbsp;.&nbsp; | &nbsp;&nbsp;.&nbsp; | &nbsp;&nbsp;.&nbsp; | &nbsp;&nbsp;.&nbsp; | &nbsp;&nbsp;.&nbsp; | &nbsp;&nbsp;.&nbsp; | &nbsp;&nbsp;.&nbsp; | &nbsp;&nbsp;.&nbsp; | &nbsp;&nbsp;.&nbsp; | &nbsp;&nbsp;.&nbsp; | &nbsp;&nbsp;.&nbsp; | &nbsp;&nbsp;.&nbsp; | &nbsp;&nbsp;.&nbsp; | &nbsp;&nbsp;.&nbsp; | &nbsp;&nbsp;.&nbsp; | &nbsp;&nbsp;.&nbsp; | &nbsp;&nbsp;.&nbsp; | &nbsp;&nbsp;.&nbsp; | &nbsp;&nbsp;.&nbsp; | &nbsp;&nbsp;.&nbsp; | &nbsp;&nbsp;.&nbsp; | &nbsp;&nbsp;.&nbsp; | &nbsp;&nbsp;.&nbsp; | &nbsp;&nbsp;.&nbsp; | &nbsp;&nbsp;.&nbsp; | &nbsp;&nbsp;.&nbsp; |  &nbsp;&nbsp;2&nbsp; | &nbsp;&nbsp;aluminium_flat_bar.dxf |
| &nbsp;&nbsp;.&nbsp; | &nbsp;&nbsp;.&nbsp; | &nbsp;&nbsp;.&nbsp; | &nbsp;&nbsp;1&nbsp; | &nbsp;&nbsp;.&nbsp; | &nbsp;&nbsp;.&nbsp; | &nbsp;&nbsp;.&nbsp; | &nbsp;&nbsp;.&nbsp; | &nbsp;&nbsp;.&nbsp; | &nbsp;&nbsp;.&nbsp; | &nbsp;&nbsp;.&nbsp; | &nbsp;&nbsp;.&nbsp; | &nbsp;&nbsp;.&nbsp; | &nbsp;&nbsp;.&nbsp; | &nbsp;&nbsp;.&nbsp; | &nbsp;&nbsp;.&nbsp; | &nbsp;&nbsp;.&nbsp; | &nbsp;&nbsp;.&nbsp; | &nbsp;&nbsp;.&nbsp; | &nbsp;&nbsp;.&nbsp; | &nbsp;&nbsp;.&nbsp; | &nbsp;&nbsp;.&nbsp; | &nbsp;&nbsp;.&nbsp; | &nbsp;&nbsp;.&nbsp; | &nbsp;&nbsp;.&nbsp; | &nbsp;&nbsp;.&nbsp; | &nbsp;&nbsp;.&nbsp; | &nbsp;&nbsp;.&nbsp; | &nbsp;&nbsp;.&nbsp; | &nbsp;&nbsp;.&nbsp; | &nbsp;&nbsp;.&nbsp; | &nbsp;&nbsp;.&nbsp; | &nbsp;&nbsp;.&nbsp; | &nbsp;&nbsp;.&nbsp; | &nbsp;&nbsp;.&nbsp; | &nbsp;&nbsp;.&nbsp; | &nbsp;&nbsp;.&nbsp; | &nbsp;&nbsp;.&nbsp; | &nbsp;&nbsp;.&nbsp; | &nbsp;&nbsp;.&nbsp; | &nbsp;&nbsp;.&nbsp; | &nbsp;&nbsp;.&nbsp; | &nbsp;&nbsp;.&nbsp; | &nbsp;&nbsp;.&nbsp; | &nbsp;&nbsp;.&nbsp; | &nbsp;&nbsp;.&nbsp; | &nbsp;&nbsp;.&nbsp; | &nbsp;&nbsp;.&nbsp; | &nbsp;&nbsp;.&nbsp; | &nbsp;&nbsp;.&nbsp; | &nbsp;&nbsp;.&nbsp; | &nbsp;&nbsp;.&nbsp; | &nbsp;&nbsp;.&nbsp; | &nbsp;&nbsp;.&nbsp; | &nbsp;&nbsp;.&nbsp; | &nbsp;&nbsp;.&nbsp; | &nbsp;&nbsp;.&nbsp; | &nbsp;&nbsp;.&nbsp; | &nbsp;&nbsp;.&nbsp; | &nbsp;&nbsp;.&nbsp; | &nbsp;&nbsp;.&nbsp; | &nbsp;&nbsp;.&nbsp; | &nbsp;&nbsp;.&nbsp; | &nbsp;&nbsp;.&nbsp; | &nbsp;&nbsp;.&nbsp; | &nbsp;&nbsp;.&nbsp; | &nbsp;&nbsp;.&nbsp; | &nbsp;&nbsp;.&nbsp; | &nbsp;&nbsp;.&nbsp; | &nbsp;&nbsp;.&nbsp; | &nbsp;&nbsp;.&nbsp; | &nbsp;&nbsp;.&nbsp; |  &nbsp;&nbsp;1&nbsp; | &nbsp;&nbsp;bed.dxf |
| &nbsp;&nbsp;.&nbsp; | &nbsp;&nbsp;.&nbsp; | &nbsp;&nbsp;.&nbsp; | &nbsp;&nbsp;3&nbsp; | &nbsp;&nbsp;.&nbsp; | &nbsp;&nbsp;.&nbsp; | &nbsp;&nbsp;.&nbsp; | &nbsp;&nbsp;.&nbsp; | &nbsp;&nbsp;.&nbsp; | &nbsp;&nbsp;.&nbsp; | &nbsp;&nbsp;.&nbsp; | &nbsp;&nbsp;.&nbsp; | &nbsp;&nbsp;.&nbsp; | &nbsp;&nbsp;.&nbsp; | &nbsp;&nbsp;.&nbsp; | &nbsp;&nbsp;.&nbsp; | &nbsp;&nbsp;.&nbsp; | &nbsp;&nbsp;.&nbsp; | &nbsp;&nbsp;.&nbsp; | &nbsp;&nbsp;.&nbsp; | &nbsp;&nbsp;.&nbsp; | &nbsp;&nbsp;.&nbsp; | &nbsp;&nbsp;.&nbsp; | &nbsp;&nbsp;.&nbsp; | &nbsp;&nbsp;.&nbsp; | &nbsp;&nbsp;.&nbsp; | &nbsp;&nbsp;.&nbsp; | &nbsp;&nbsp;.&nbsp; | &nbsp;&nbsp;.&nbsp; | &nbsp;&nbsp;.&nbsp; | &nbsp;&nbsp;.&nbsp; | &nbsp;&nbsp;.&nbsp; | &nbsp;&nbsp;.&nbsp; | &nbsp;&nbsp;.&nbsp; | &nbsp;&nbsp;.&nbsp; | &nbsp;&nbsp;.&nbsp; | &nbsp;&nbsp;.&nbsp; | &nbsp;&nbsp;.&nbsp; | &nbsp;&nbsp;.&nbsp; | &nbsp;&nbsp;.&nbsp; | &nbsp;&nbsp;.&nbsp; | &nbsp;&nbsp;.&nbsp; | &nbsp;&nbsp;.&nbsp; | &nbsp;&nbsp;.&nbsp; | &nbsp;&nbsp;.&nbsp; | &nbsp;&nbsp;.&nbsp; | &nbsp;&nbsp;.&nbsp; | &nbsp;&nbsp;.&nbsp; | &nbsp;&nbsp;.&nbsp; | &nbsp;&nbsp;.&nbsp; | &nbsp;&nbsp;.&nbsp; | &nbsp;&nbsp;.&nbsp; | &nbsp;&nbsp;.&nbsp; | &nbsp;&nbsp;.&nbsp; | &nbsp;&nbsp;.&nbsp; | &nbsp;&nbsp;.&nbsp; | &nbsp;&nbsp;.&nbsp; | &nbsp;&nbsp;.&nbsp; | &nbsp;&nbsp;.&nbsp; | &nbsp;&nbsp;.&nbsp; | &nbsp;&nbsp;.&nbsp; | &nbsp;&nbsp;.&nbsp; | &nbsp;&nbsp;.&nbsp; | &nbsp;&nbsp;.&nbsp; | &nbsp;&nbsp;.&nbsp; | &nbsp;&nbsp;.&nbsp; | &nbsp;&nbsp;.&nbsp; | &nbsp;&nbsp;.&nbsp; | &nbsp;&nbsp;.&nbsp; | &nbsp;&nbsp;.&nbsp; | &nbsp;&nbsp;.&nbsp; | &nbsp;&nbsp;.&nbsp; | &nbsp;&nbsp;3&nbsp; | &nbsp;&nbsp;Total CNC routed parts count |

<span></span>
[Top](#TOP)

---

## Duct Assembly
### Vitamins
|Qty|Description|
|---:|:---|
|1| Blower Runda RB5015|
|1| Nut M3 x 2.4mm |
|1| Screw M3 cap x 30mm|
|2| Washer  M3 x 7mm x 0.5mm|

### 3D Printed parts

| 1 x duct.stl | 1 x duct_mount.stl |
|---|---|
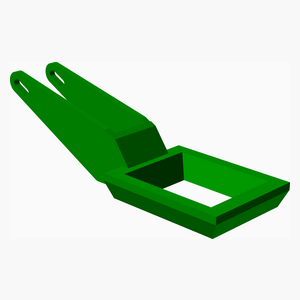
[picture p2: stls/duct.png]
duct.stl
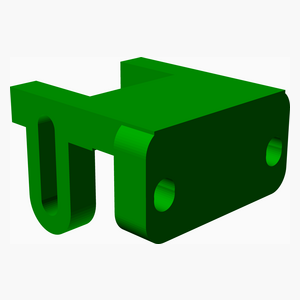
[picture p3: stls/duct_mount.png]
duct_mount.stl
|  |  

### Assembly instructions
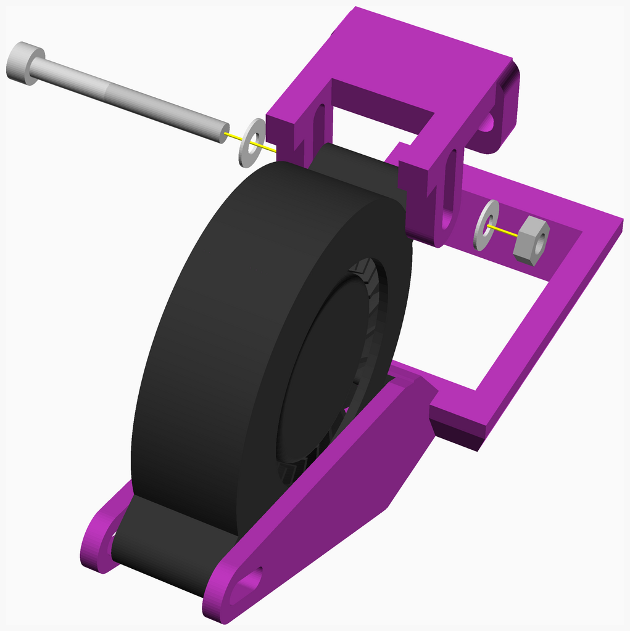
[picture p4: assemblies/duct_assembly.png]
duct_assembly


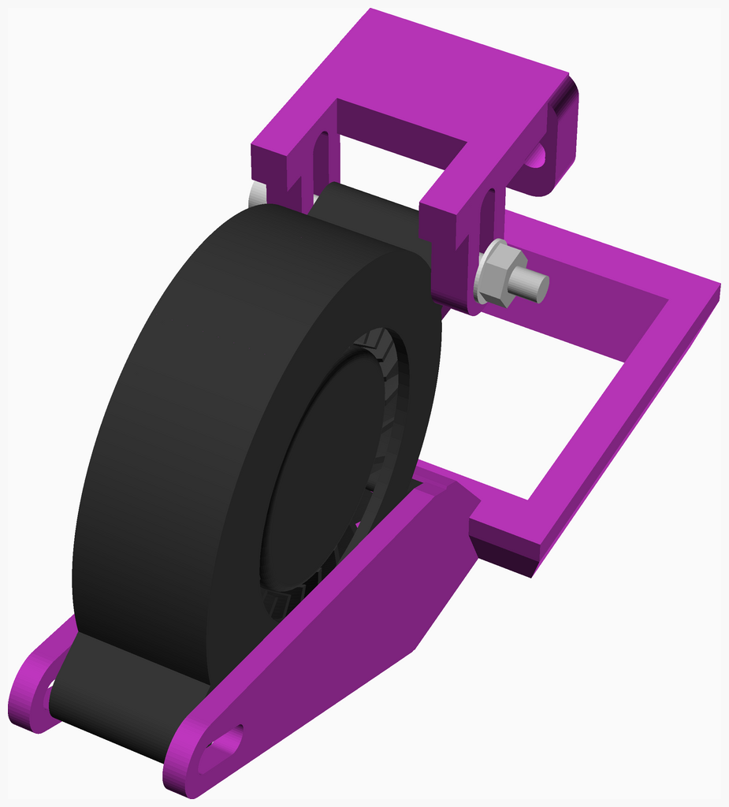
[picture p5: assemblies/duct_assembled.png]
duct_assembled


<span></span>
[Top](#TOP)

---

## 2 x Z Motor Assembly
### Vitamins
|Qty|Description|
|---:|:---|
|2| Leadscrew 8 x 250mm, 8mm lead, 4 starts|
|2| Stepper motor NEMA17 x 47mm|

### Assembly instructions
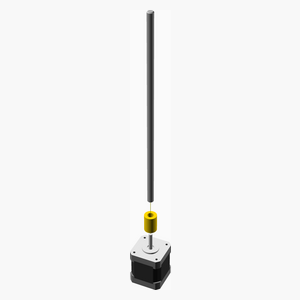
[picture p6: assemblies/z_motor_assembly_tn.png]
z_motor_assembly


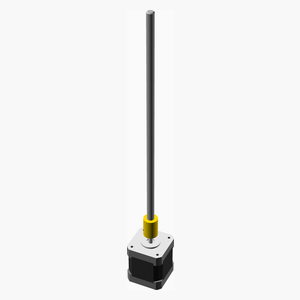
[picture p7: assemblies/z_motor_assembled_tn.png]
z_motor_assembled


<span></span>
[Top](#TOP)

---

## 2 x Spool Rod Assembly
### Vitamins
|Qty|Description|
|---:|:---|
|4| Ball bearing 608-2RS 8mm x 22mm x 7mm|
|8| Nut M8 x 6.5mm |
|2| Threaded rod M8 x 132mm|
|8| Washer  M8 x 17mm x 1.6mm|
|4| Washer penny  M8 x 30mm x 1.5mm|

### Assembly instructions
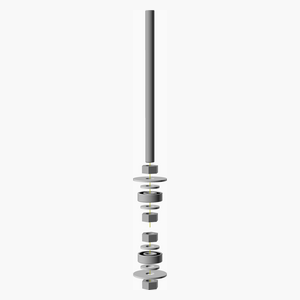
[picture p8: assemblies/spool_rod_assembly_tn.png]
spool_rod_assembly


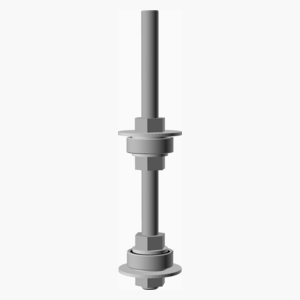
[picture p9: assemblies/spool_rod_assembled_tn.png]
spool_rod_assembled


<span></span>
[Top](#TOP)

---

## Bed Assembly
### Vitamins
|Qty|Description|
|---:|:---|
|4| Nut M5 x 4mm |
|4| Screw M5 cap x 14mm|
|4| Swiss picture clip UKPFS1008_10 11mm|
|2| aluminium flat bar 20mm x 260mm x 5mm|
|1| aluminium plate 314mm x 214mm x 3mm|

### CNC Routed parts

| 2 x aluminium_flat_bar.dxf | 1 x bed.dxf |
|---|---|
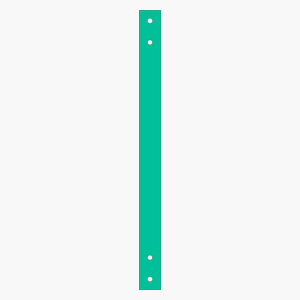
[picture p10: dxfs/aluminium_flat_bar.png]
aluminium_flat_bar.dxf
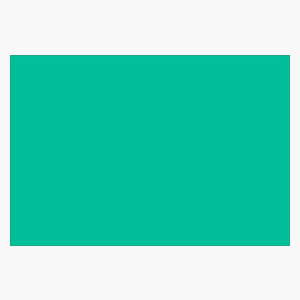
[picture p11: dxfs/bed.png]
bed.dxf
|  |  

### Assembly instructions
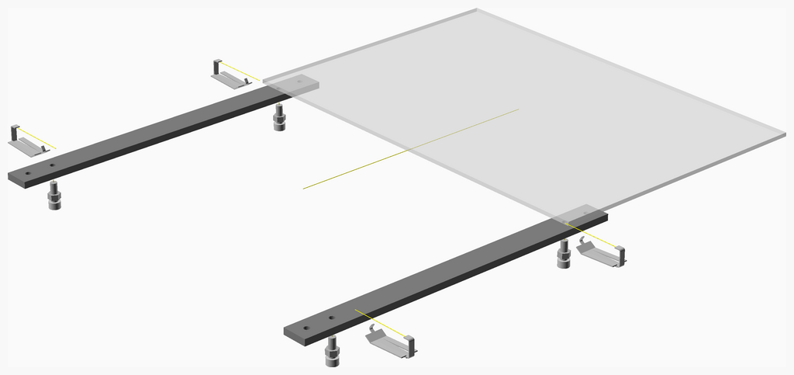
[picture p12: assemblies/bed_assembly.png]
bed_assembly


The screws should be screwed into tapped holes in the flat bar
with a nut each to lock against the bar.

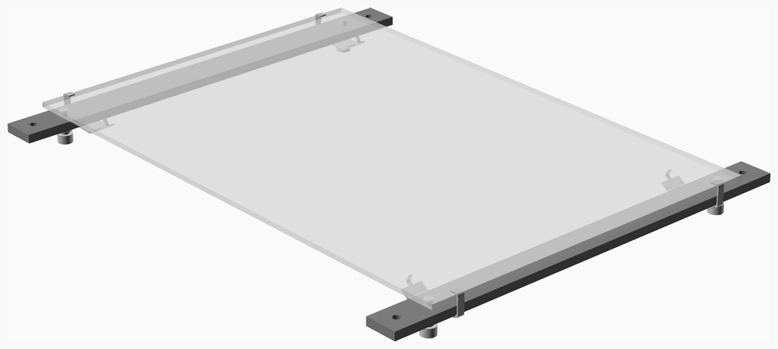
[picture p13: assemblies/bed_assembled.png]
bed_assembled


<span></span>
[Top](#TOP)

---

## Z Axis Assembly
### Vitamins
|Qty|Description|
|---:|:---|
|2| Extrusion E2020 x 470mm|
|4| Nut M4 sliding T|
|4| Screw M4 cap x 10mm|
|4| Washer  M4 x 9mm x 0.8mm|

### Sub-assemblies

| 1 x bed_assembly |
|---|
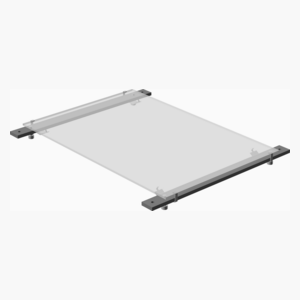
[picture p14: assemblies/bed_assembled_tn.png]
bed_assembled
|  

### Assembly instructions
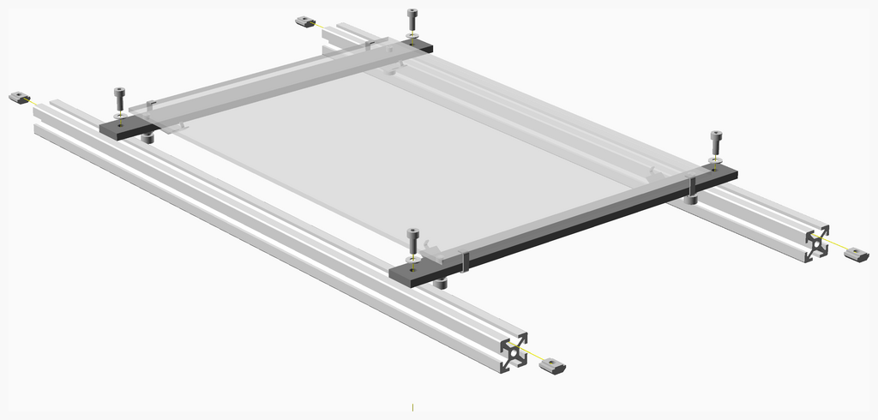
[picture p15: assemblies/z_axis_assembly.png]
z_axis_assembly


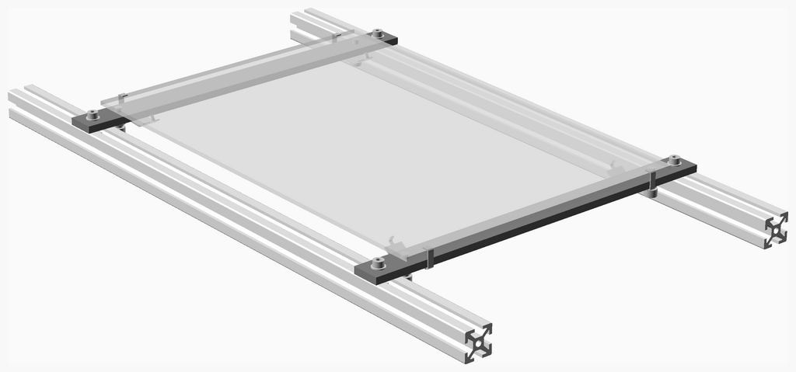
[picture p16: assemblies/z_axis_assembled.png]
z_axis_assembled


<span></span>
[Top](#TOP)

---

## 4 x Idler Assembly
### Vitamins
|Qty|Description|
|---:|:---|
|8| Ball bearing F623-2RS 3mm x 10mm x 4mm|
|12| Washer  M3 x 7mm x 0.5mm|

### Assembly instructions
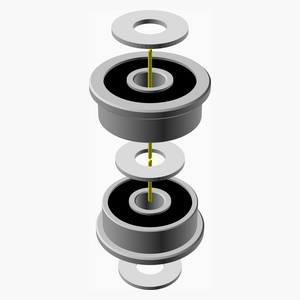
[picture p17: assemblies/idler_assembly_tn.png]
idler_assembly


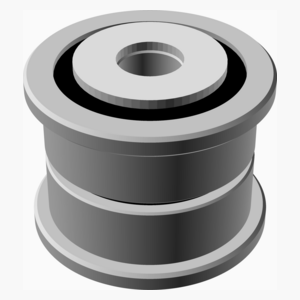
[picture p18: assemblies/idler_assembled_tn.png]
idler_assembled


<span></span>
[Top](#TOP)

---

## Right Y Carriage Assembly
### Vitamins
|Qty|Description|
|---:|:---|
|2| Nut M3 x 2.4mm |
|2| Nut M4 sliding T|
|2| Screw M3 cap x 25mm|
|2| Screw M4 cap x 10mm|
|4| Washer  M3 x 7mm x 0.5mm|
|2| Washer  M4 x 9mm x 0.8mm|

### 3D Printed parts

| 1 x right_y_carriage.stl |
|---|
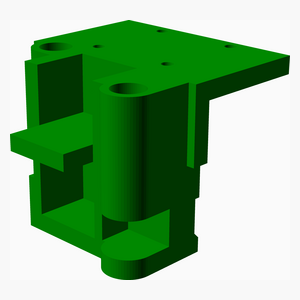
[picture p19: stls/right_y_carriage.png]
right_y_carriage.stl
|  

### Sub-assemblies

| 2 x idler_assembly |
|---|
| idler_assembled 

### Assembly instructions
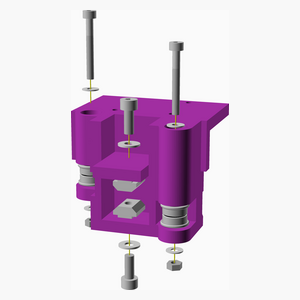
[picture p20: assemblies/right_y_carriage_assembly_tn.png]
right_y_carriage_assembly


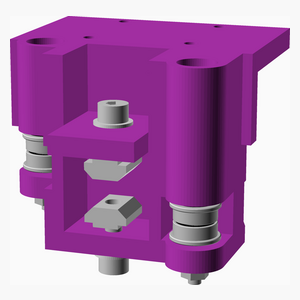
[picture p21: assemblies/right_y_carriage_assembled_tn.png]
right_y_carriage_assembled


<span></span>
[Top](#TOP)

---

## Left Y Carriage Assembly
### Vitamins
|Qty|Description|
|---:|:---|
|2| Nut M3 x 2.4mm |
|2| Nut M4 sliding T|
|2| Screw M3 cap x 25mm|
|2| Screw M4 cap x 10mm|
|4| Washer  M3 x 7mm x 0.5mm|
|2| Washer  M4 x 9mm x 0.8mm|

### 3D Printed parts

| 1 x left_y_carriage.stl |
|---|
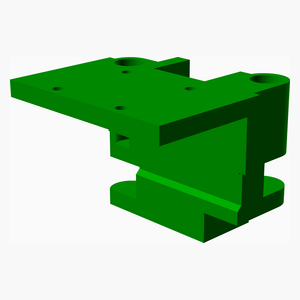
[picture p22: stls/left_y_carriage.png]
left_y_carriage.stl
|  

### Sub-assemblies

| 2 x idler_assembly |
|---|
| idler_assembled 

### Assembly instructions
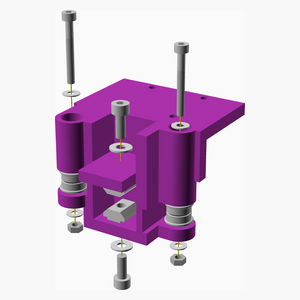
[picture p23: assemblies/left_y_carriage_assembly_tn.png]
left_y_carriage_assembly


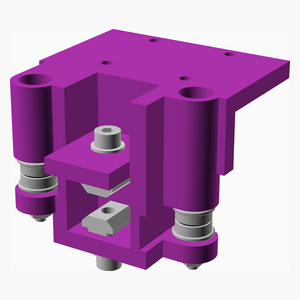
[picture p24: assemblies/left_y_carriage_assembled_tn.png]
left_y_carriage_assembled


<span></span>
[Top](#TOP)

---

## X Carriage Rear Assembly
### Vitamins
|Qty|Description|
|---:|:---|
|1| Microswitch SS-01 or SS-5GL|
|5| Nut M3 x 2.4mm |
|5| Screw M3 cap x 10mm|
|2| Screw M3 cap x 14mm|
|7| Washer  M3 x 7mm x 0.5mm|

### 3D Printed parts

| 2 x belt_clamp.stl | 1 x x_carriage_rear.stl | 1 x x_endstop_mount.stl |
|---|---|---|
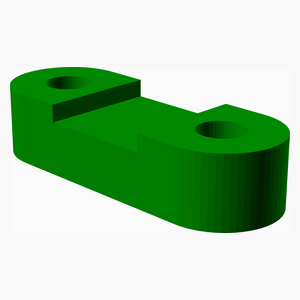
[picture p25: stls/belt_clamp.png]
belt_clamp.stl
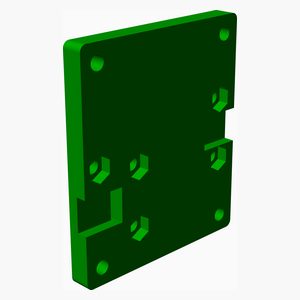
[picture p26: stls/x_carriage_rear.png]
x_carriage_rear.stl
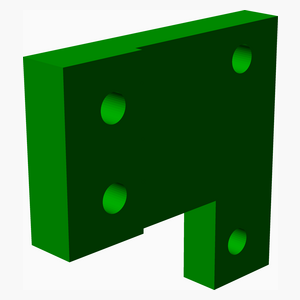
[picture p27: stls/x_endstop_mount.png]
x_endstop_mount.stl
|  |  |  

### Assembly instructions
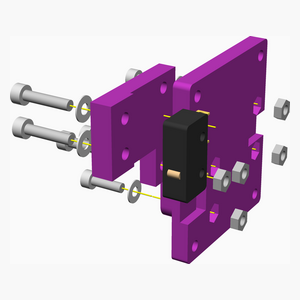
[picture p28: assemblies/x_carriage_rear_assembly_tn.png]
x_carriage_rear_assembly


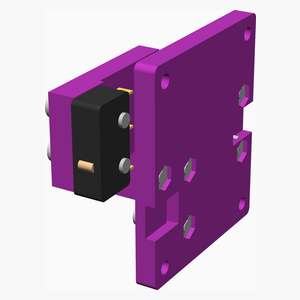
[picture p29: assemblies/x_carriage_rear_assembled_tn.png]
x_carriage_rear_assembled


<span></span>
[Top](#TOP)

---

## X Carriage Front Assembly
### Vitamins
|Qty|Description|
|---:|:---|
|7| Nut M3 x 2.4mm |
|7| Screw M3 cap x 10mm|
|7| Washer  M3 x 7mm x 0.5mm|

### 3D Printed parts

| 2 x belt_clamp.stl | 1 x hotend_mount.stl | 1 x x_carriage_front.stl |
|---|---|---|
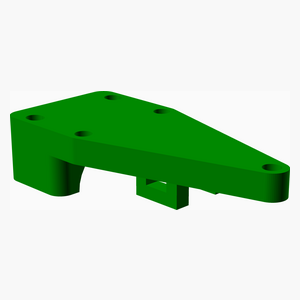
[picture p30: stls/hotend_mount.png]
hotend_mount.stl
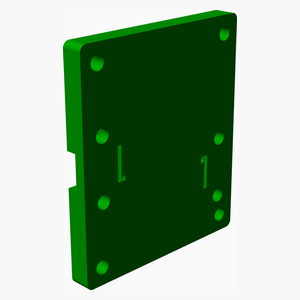
[picture p31: stls/x_carriage_front.png]
x_carriage_front.stl
| belt_clamp.stl |  |  

### Assembly instructions
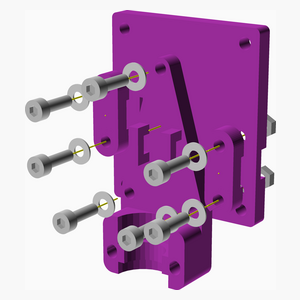
[picture p32: assemblies/x_carriage_front_assembly_tn.png]
x_carriage_front_assembly


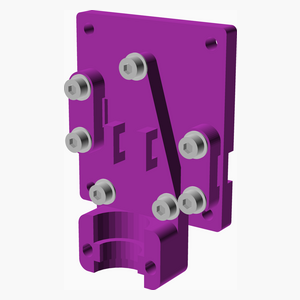
[picture p33: assemblies/x_carriage_front_assembled_tn.png]
x_carriage_front_assembled


<span></span>
[Top](#TOP)

---

## X Carriage Assembly
### Vitamins
|Qty|Description|
|---:|:---|
|2| Nut M3 x 2.4mm |
|2| Screw M3 cap x 45mm|
|4| Washer  M3 x 7mm x 0.5mm|

### 3D Printed parts

| 1 x x_carriage_mount.stl |
|---|
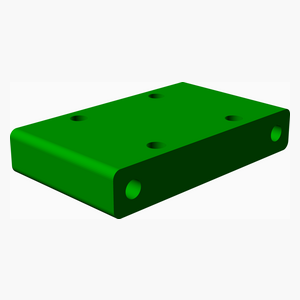
[picture p34: stls/x_carriage_mount.png]
x_carriage_mount.stl
|  

### Sub-assemblies

| 1 x x_carriage_front_assembly | 1 x x_carriage_rear_assembly |
|---|---|
| x_carriage_front_assembled | x_carriage_rear_assembled 

### Assembly instructions
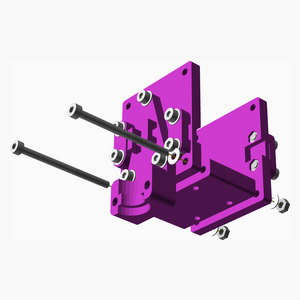
[picture p35: assemblies/x_carriage_assembly_tn.png]
x_carriage_assembly


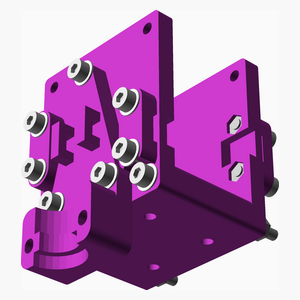
[picture p36: assemblies/x_carriage_assembled_tn.png]
x_carriage_assembled


<span></span>
[Top](#TOP)

---

## X Rail Assembly
### Vitamins
|Qty|Description|
|---:|:---|
|1| Linear rail MGN12 x 400mm|
|1| Linear rail carriage MGN12H|
|16| Nut M3 sliding T|
|14| Screw M3 cap x 10mm|
|2| Screw M3 cs cap x 12mm|

### Assembly instructions
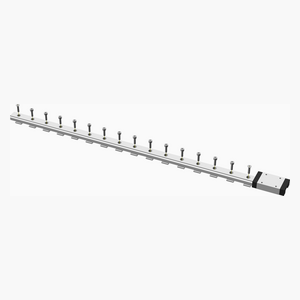
[picture p37: assemblies/x_rail_assembly_tn.png]
x_rail_assembly


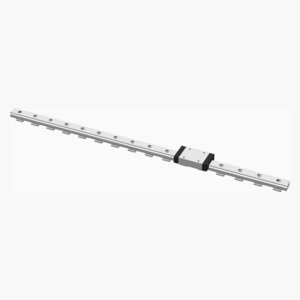
[picture p38: assemblies/x_rail_assembled_tn.png]
x_rail_assembled


<span></span>
[Top](#TOP)

---

## X Rail Extrusion Assembly
### Vitamins
|Qty|Description|
|---:|:---|
|1| Extrusion E2020 x 450mm|

### Sub-assemblies

| 1 x x_rail_assembly |
|---|
| x_rail_assembled 

### Assembly instructions
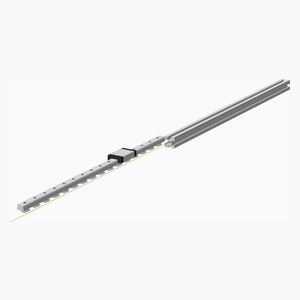
[picture p39: assemblies/x_rail_extrusion_assembly_tn.png]
x_rail_extrusion_assembly


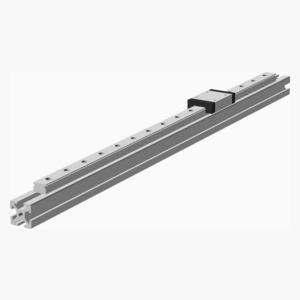
[picture p40: assemblies/x_rail_extrusion_assembled_tn.png]
x_rail_extrusion_assembled


<span></span>
[Top](#TOP)

---

## X Rail Carriage Assembly
### Vitamins
|Qty|Description|
|---:|:---|
|4| Screw M3 cap x 12mm|
|4| Washer  M3 x 7mm x 0.5mm|

### 3D Printed parts

| 1 x x_carriage_mount.stl |
|---|
| x_carriage_mount.stl 

### Sub-assemblies

| 1 x x_rail_extrusion_assembly |
|---|
| x_rail_extrusion_assembled 

### Assembly instructions
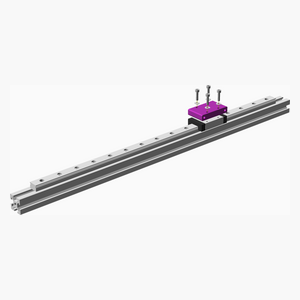
[picture p41: assemblies/x_rail_carriage_assembly_tn.png]
x_rail_carriage_assembly


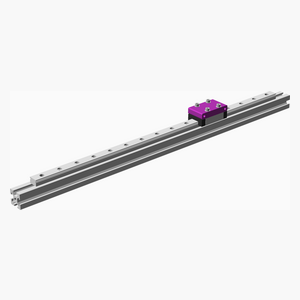
[picture p42: assemblies/x_rail_carriage_assembled_tn.png]
x_rail_carriage_assembled


<span></span>
[Top](#TOP)

---

## X Axis Assembly
### Vitamins
|Qty|Description|
|---:|:---|
|2| Nut M3 x 2.4mm |
|1| Screw M3 cap x 45mm|
|1| Screw M3 cap x 50mm|
|4| Washer  M3 x 7mm x 0.5mm|

### Sub-assemblies

| 1 x x_carriage_assembly | 1 x x_rail_carriage_assembly |
|---|---|
| x_carriage_assembled | x_rail_carriage_assembled 

### Assembly instructions
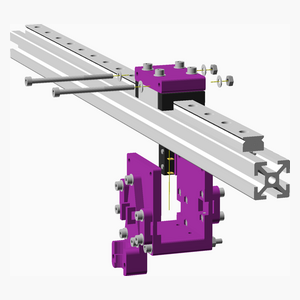
[picture p43: assemblies/x_axis_assembly_tn.png]
x_axis_assembly


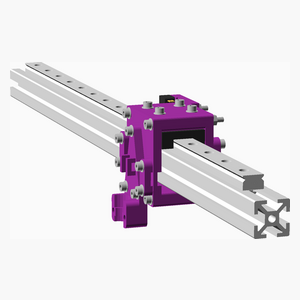
[picture p44: assemblies/x_axis_assembled_tn.png]
x_axis_assembled


<span></span>
[Top](#TOP)

---

## Xy Combined Assembly
### Sub-assemblies

| 1 x left_y_carriage_assembly | 1 x right_y_carriage_assembly | 1 x x_axis_assembly |
|---|---|---|
| left_y_carriage_assembled | right_y_carriage_assembled | x_axis_assembled 

### Assembly instructions
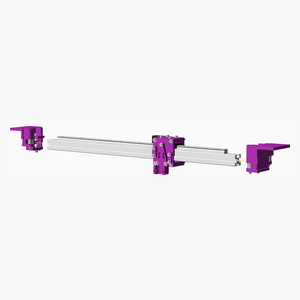
[picture p45: assemblies/xy_combined_assembly_tn.png]
xy_combined_assembly


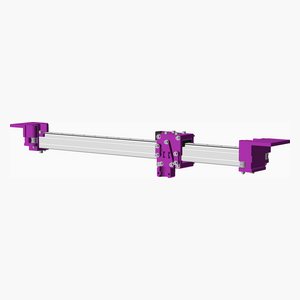
[picture p46: assemblies/xy_combined_assembled_tn.png]
xy_combined_assembled


<span></span>
[Top](#TOP)

---

## Lower Back Frame Assembly
### Vitamins
|Qty|Description|
|---:|:---|
|1| Extrusion E2040 x 472mm|
|6| Nut M4 sliding T|
|6| Screw M4 cap x 10mm|
|6| Washer  M4 x 9mm x 0.8mm|

### 3D Printed parts

| 1 x psu_cover.stl | 2 x psu_mount.stl |
|---|---|
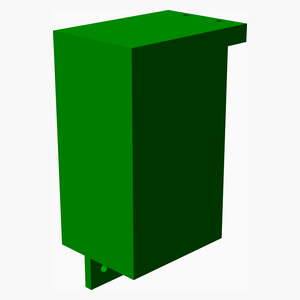
[picture p47: stls/psu_cover.png]
psu_cover.stl
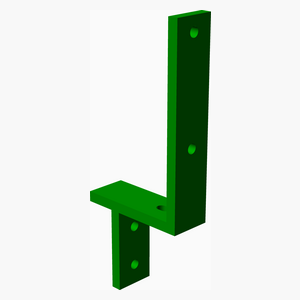
[picture p48: stls/psu_mount.png]
psu_mount.stl
|  |  

### Assembly instructions
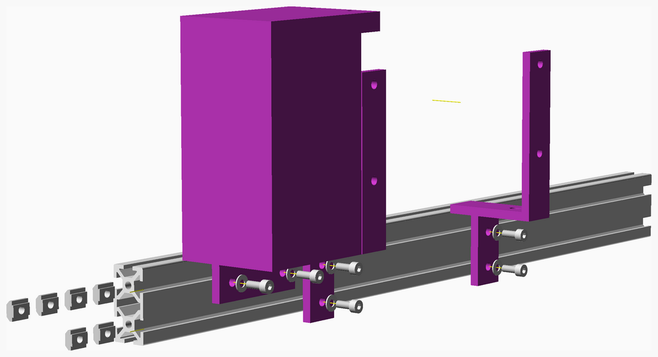
[picture p49: assemblies/lower_back_frame_assembly.png]
lower_back_frame_assembly


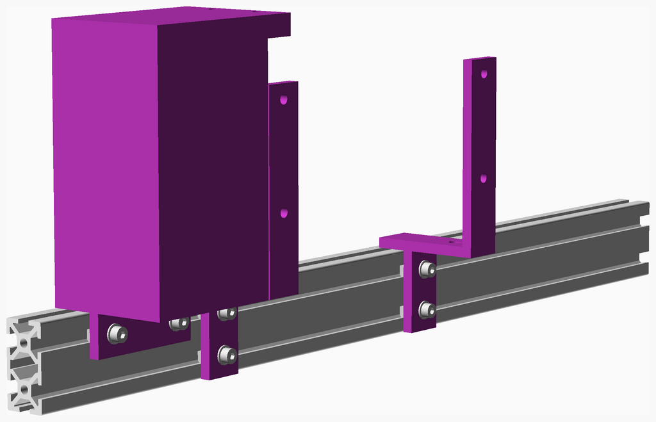
[picture p50: assemblies/lower_back_frame_assembled.png]
lower_back_frame_assembled


<span></span>
[Top](#TOP)

---

## 4 x Milled Corner For Tapped End Assembly
### Vitamins
|Qty|Description|
|---:|:---|
|4| Nut M5 sliding T|
|4| Ooznest 90 Degree Angle Corner (VSLOT-B-90AC)|
|4| Screw M5 low profile x 10mm|
|4| Screw M5 low profile x 12mm|

### Assembly instructions
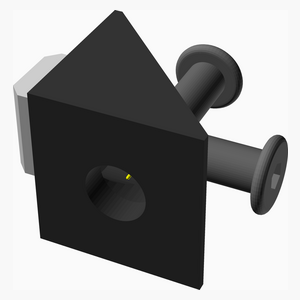
[picture p51: assemblies/milled_corner_for_tapped_end_assembly_tn.png]
milled_corner_for_tapped_end_assembly


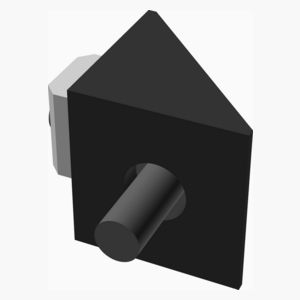
[picture p52: assemblies/milled_corner_for_tapped_end_assembled_tn.png]
milled_corner_for_tapped_end_assembled


<span></span>
[Top](#TOP)

---

## 24 x Cast Corner Bracket Assembly
### Vitamins
|Qty|Description|
|---:|:---|
|24| Extrusion corner bracket 20mm for E2020t|
|48| Nut M4 sliding T|
|48| Screw M5 low profile x  8mm|
|48| Washer  M5 x 10mm x 1mm|

### Assembly instructions
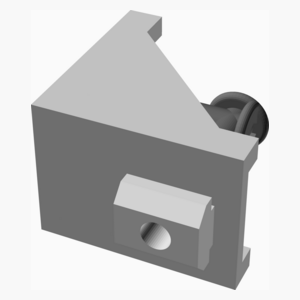
[picture p53: assemblies/cast_corner_bracket_assembly_tn.png]
cast_corner_bracket_assembly


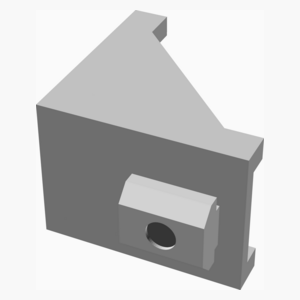
[picture p54: assemblies/cast_corner_bracket_assembled_tn.png]
cast_corner_bracket_assembled


<span></span>
[Top](#TOP)

---

## Left Front Top Corner Assembly
### Vitamins
|Qty|Description|
|---:|:---|
|2| Nut M4 sliding T|
|2| Screw M4 flanged x 10mm|

### 3D Printed parts

| 1 x front_top_corner.stl |
|---|
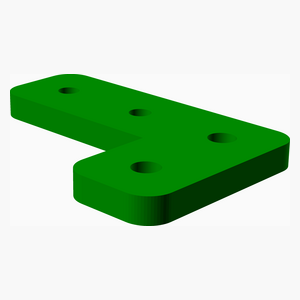
[picture p55: stls/front_top_corner.png]
front_top_corner.stl
|  

### Assembly instructions
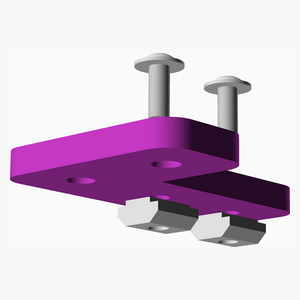
[picture p56: assemblies/left_front_top_corner_assembly_tn.png]
left_front_top_corner_assembly


The two larger (5mm) holes should be empty.

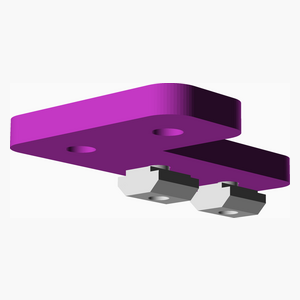
[picture p57: assemblies/left_front_top_corner_assembled_tn.png]
left_front_top_corner_assembled


<span></span>
[Top](#TOP)

---

## Left Back Top Corner Assembly
### Vitamins
|Qty|Description|
|---:|:---|
|3| Nut M4 sliding T|
|3| Screw M4 flanged x 10mm|

### 3D Printed parts

| 1 x back_top_corner.stl |
|---|
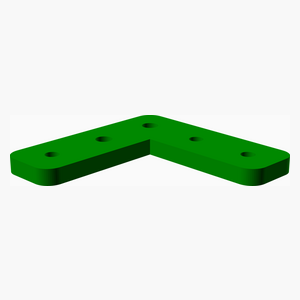
[picture p58: stls/back_top_corner.png]
back_top_corner.stl
|  

### Assembly instructions
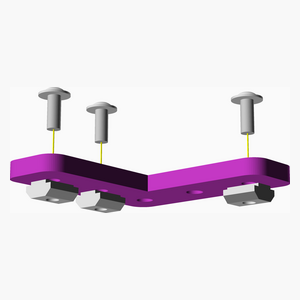
[picture p59: assemblies/left_back_top_corner_assembly_tn.png]
left_back_top_corner_assembly


The two larger (5mm) holes should be empty.

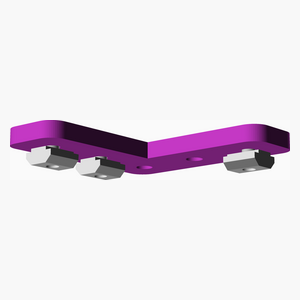
[picture p60: assemblies/left_back_top_corner_assembled_tn.png]
left_back_top_corner_assembled


<span></span>
[Top](#TOP)

---

## 4 x Side Top Corner Assembly
### Vitamins
|Qty|Description|
|---:|:---|
|28| Nut M4 sliding T|
|28| Screw M4 flanged x 10mm|

### 3D Printed parts

| 4 x side_top_corner.stl |
|---|
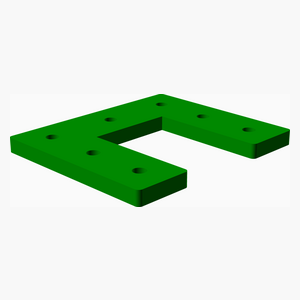
[picture p61: stls/side_top_corner.png]
side_top_corner.stl
|  

### Assembly instructions
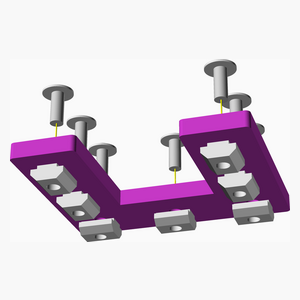
[picture p62: assemblies/side_top_corner_assembly_tn.png]
side_top_corner_assembly


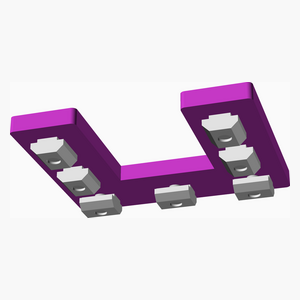
[picture p63: assemblies/side_top_corner_assembled_tn.png]
side_top_corner_assembled


<span></span>
[Top](#TOP)

---

## Left Motor Assembly
### Vitamins
|Qty|Description|
|---:|:---|
|3| Nut M4 sliding T|
|1| Pulley GT2OB 20 teeth|
|1| Screw M3 cap x 10mm|
|3| Screw M3 cap x 12mm|
|3| Screw M4 cap x 10mm|
|1| Stepper motor NEMA17 x 47mm|
|3| Washer  M3 x 7mm x 0.5mm|
|3| Washer  M4 x 9mm x 0.8mm|

### 3D Printed parts

| 1 x left_motor_mount.stl |
|---|
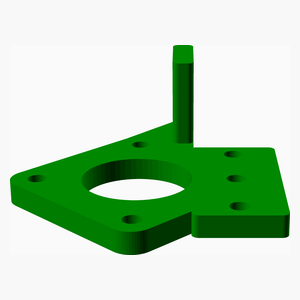
[picture p64: stls/left_motor_mount.png]
left_motor_mount.stl
|  

### Assembly instructions
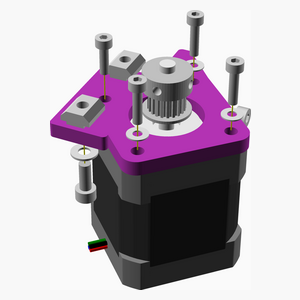
[picture p65: assemblies/left_motor_assembly_tn.png]
left_motor_assembly


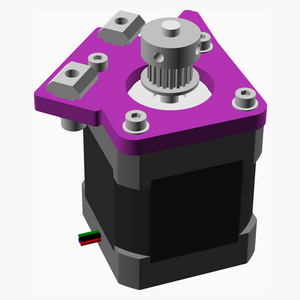
[picture p66: assemblies/left_motor_assembled_tn.png]
left_motor_assembled


<span></span>
[Top](#TOP)

---

## Y Endstop Assembly
### Vitamins
|Qty|Description|
|---:|:---|
|1| Microswitch SS-01 or SS-5GL|
|1| Nut M4 sliding T|
|2| Screw M3 cap x 12mm|
|1| Screw M4 cap x 10mm|
|2| Washer  M3 x 7mm x 0.5mm|
|1| Washer  M4 x 9mm x 0.8mm|

### 3D Printed parts

| 1 x y_endstop_mount.stl |
|---|
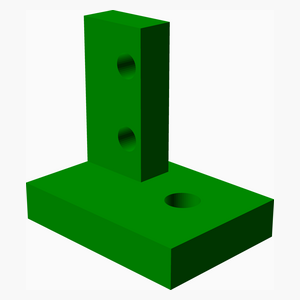
[picture p67: stls/y_endstop_mount.png]
y_endstop_mount.stl
|  

### Assembly instructions
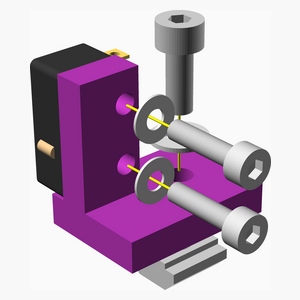
[picture p68: assemblies/y_endstop_assembly_tn.png]
y_endstop_assembly


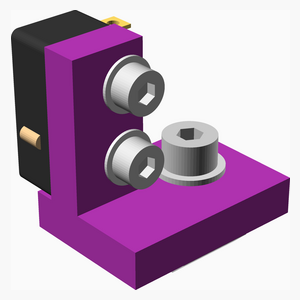
[picture p69: assemblies/y_endstop_assembled_tn.png]
y_endstop_assembled


<span></span>
[Top](#TOP)

---

## 2 x Y Rail Assembly
### Vitamins
|Qty|Description|
|---:|:---|
|2| Linear rail MGN15 x 300mm|
|2| Linear rail carriage MGN15H|
|16| Nut M4 sliding T|
|12| Screw M3 cap x 12mm|
|4| Screw M3 cs cap x 16mm|

### Assembly instructions
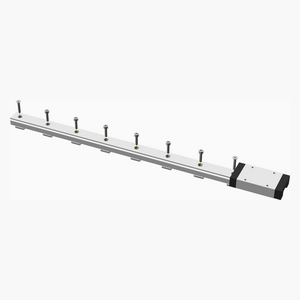
[picture p70: assemblies/y_rail_assembly_tn.png]
y_rail_assembly


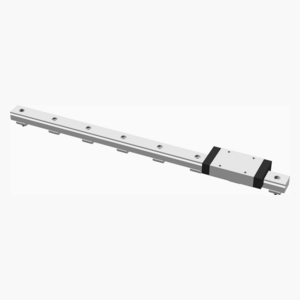
[picture p71: assemblies/y_rail_assembled_tn.png]
y_rail_assembled


<span></span>
[Top](#TOP)

---

## Left Y Rail Assembly
### Vitamins
|Qty|Description|
|---:|:---|
|1| Extrusion E2040 x 354mm|

### Sub-assemblies

| 1 x cast_corner_bracket_assembly | 1 x left_motor_assembly | 1 x y_endstop_assembly |
|---|---|---|
| cast_corner_bracket_assembled | left_motor_assembled | y_endstop_assembled 

| 1 x y_rail_assembly |
|---|
| y_rail_assembled 

### Assembly instructions
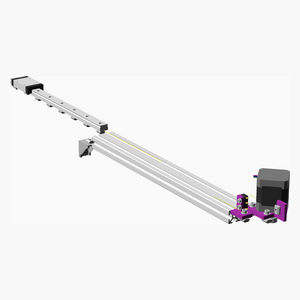
[picture p72: assemblies/left_y_rail_assembly_tn.png]
left_y_rail_assembly


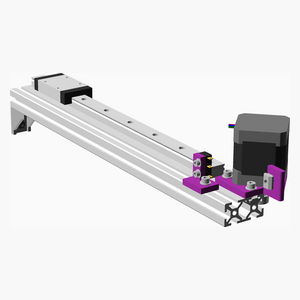
[picture p73: assemblies/left_y_rail_assembled_tn.png]
left_y_rail_assembled


<span></span>
[Top](#TOP)

---

## Left Upper End Assembly
### Vitamins
|Qty|Description|
|---:|:---|
|1| Extrusion E2020 x 354mm|

### Sub-assemblies

| 2 x cast_corner_bracket_assembly | 1 x left_back_top_corner_assembly | 1 x left_front_top_corner_assembly |
|---|---|---|
| cast_corner_bracket_assembled | left_back_top_corner_assembled | left_front_top_corner_assembled 

| 1 x left_y_rail_assembly | 2 x side_top_corner_assembly |
|---|---|
| left_y_rail_assembled | side_top_corner_assembled 

### Assembly instructions
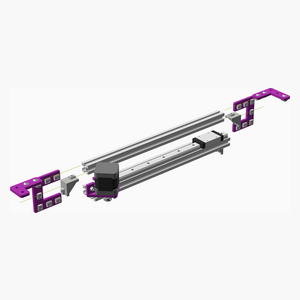
[picture p74: assemblies/left_upper_end_assembly_tn.png]
left_upper_end_assembly


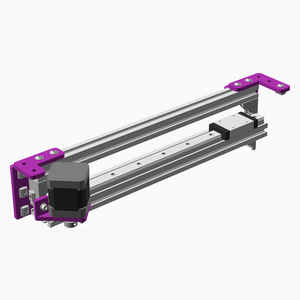
[picture p75: assemblies/left_upper_end_assembled_tn.png]
left_upper_end_assembled


<span></span>
[Top](#TOP)

---

## 4 x Bottom Corner Assembly
### Vitamins
|Qty|Description|
|---:|:---|
|20| Nut M4 sliding T|
|20| Screw M4 flanged x 10mm|

### 3D Printed parts

| 4 x bottom_corner.stl |
|---|
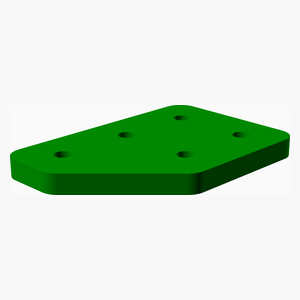
[picture p76: stls/bottom_corner.png]
bottom_corner.stl
|  

### Assembly instructions
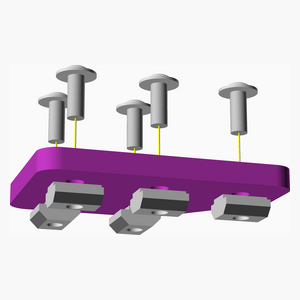
[picture p77: assemblies/bottom_corner_assembly_tn.png]
bottom_corner_assembly


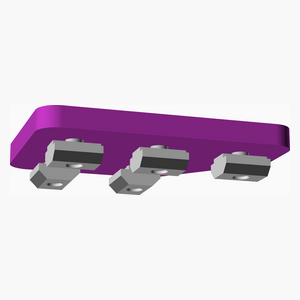
[picture p78: assemblies/bottom_corner_assembled_tn.png]
bottom_corner_assembled


<span></span>
[Top](#TOP)

---

## 4 x Reversed Bottom Corner Assembly
### Vitamins
|Qty|Description|
|---:|:---|
|20| Nut M4 sliding T|
|20| Screw M4 flanged x 10mm|

### 3D Printed parts

| 4 x bottom_corner.stl |
|---|
| bottom_corner.stl 

### Assembly instructions
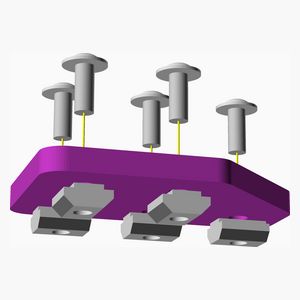
[picture p79: assemblies/reversed_bottom_corner_assembly_tn.png]
reversed_bottom_corner_assembly


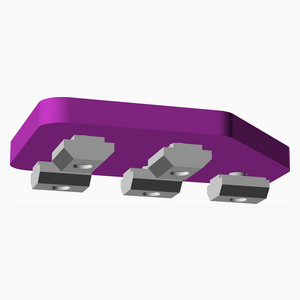
[picture p80: assemblies/reversed_bottom_corner_assembled_tn.png]
reversed_bottom_corner_assembled


<span></span>
[Top](#TOP)

---

## Duet Mount Assembly
### Vitamins
|Qty|Description|
|---:|:---|
|6| Nut M4 sliding T|
|6| Screw M4 cap x 10mm|
|6| Washer  M4 x 9mm x 0.8mm|

### 3D Printed parts

| 1 x duet_mount.stl |
|---|
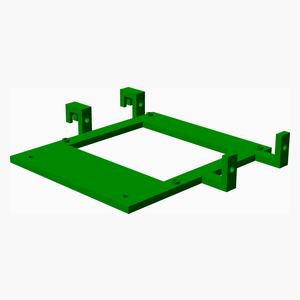
[picture p81: stls/duet_mount.png]
duet_mount.stl
|  

### Assembly instructions
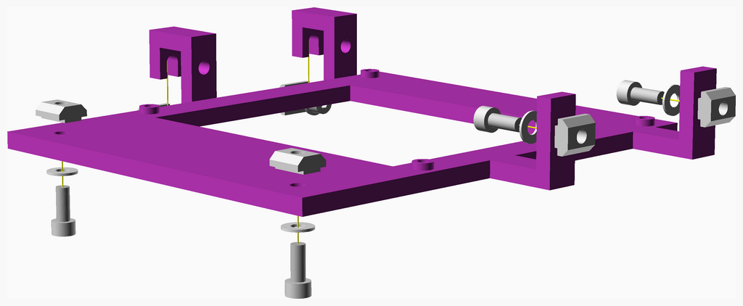
[picture p82: assemblies/duet_mount_assembly.png]
duet_mount_assembly


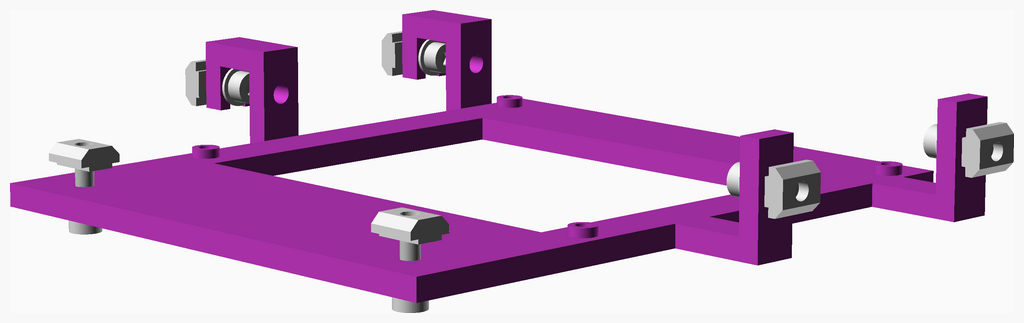
[picture p83: assemblies/duet_mount_assembled.png]
duet_mount_assembled


<span></span>
[Top](#TOP)

---

## 2 x Z Carriage Assembly
### Vitamins
|Qty|Description|
|---:|:---|
|2| Linear rail carriage MGN15H|
|4| Screw M3 cap x 10mm|
|4| Screw M3 cap x 12mm|
|4| Washer  M3 x 7mm x 0.5mm|

### 3D Printed parts

| 2 x z_rail_mount.stl |
|---|
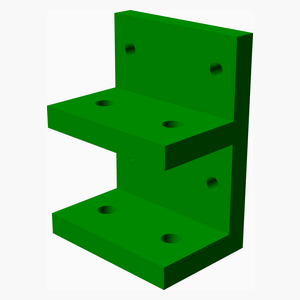
[picture p84: stls/z_rail_mount.png]
z_rail_mount.stl
|  

### Assembly instructions
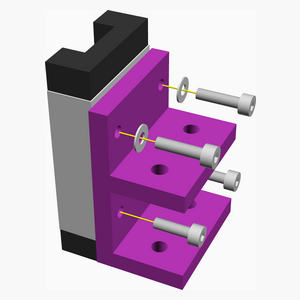
[picture p85: assemblies/z_carriage_assembly_tn.png]
z_carriage_assembly


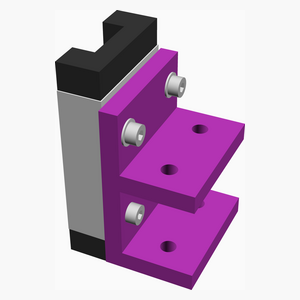
[picture p86: assemblies/z_carriage_assembled_tn.png]
z_carriage_assembled


<span></span>
[Top](#TOP)

---

## 2 x Z Rail Assembly
### Vitamins
|Qty|Description|
|---:|:---|
|2| Linear rail MGN15 x 300mm|
|16| Nut M4 sliding T|
|12| Screw M3 cap x 12mm|
|4| Screw M3 cs cap x 16mm|

### Assembly instructions
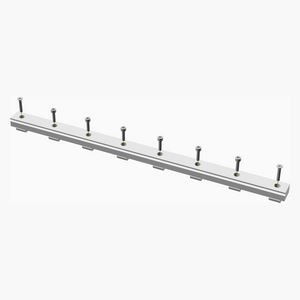
[picture p87: assemblies/z_rail_assembly_tn.png]
z_rail_assembly


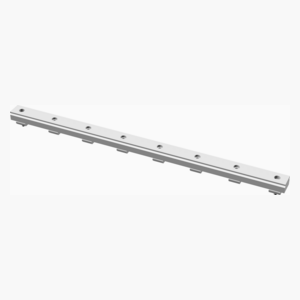
[picture p88: assemblies/z_rail_assembled_tn.png]
z_rail_assembled


<span></span>
[Top](#TOP)

---

## Left Z Axis Rail Assembly
### Vitamins
|Qty|Description|
|---:|:---|
|1| Extrusion E2020 x 320mm|

### Sub-assemblies

| 4 x cast_corner_bracket_assembly | 1 x duet_mount_assembly | 1 x z_carriage_assembly |
|---|---|---|
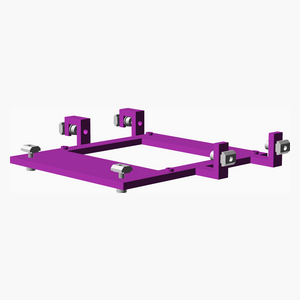
[picture p89: assemblies/duet_mount_assembled_tn.png]
duet_mount_assembled
| cast_corner_bracket_assembled |  | z_carriage_assembled 

| 1 x z_rail_assembly |
|---|
| z_rail_assembled 

### Assembly instructions
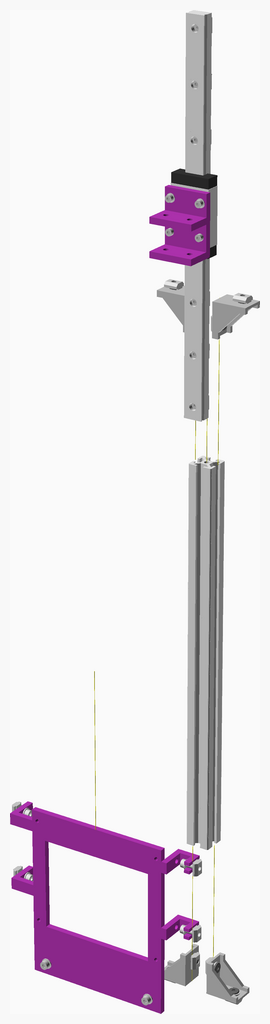
[picture p90: assemblies/left_z_axis_rail_assembly.png]
left_z_axis_rail_assembly


Be careful with the MGN carriage until it is attached to the rest of
the end frame.

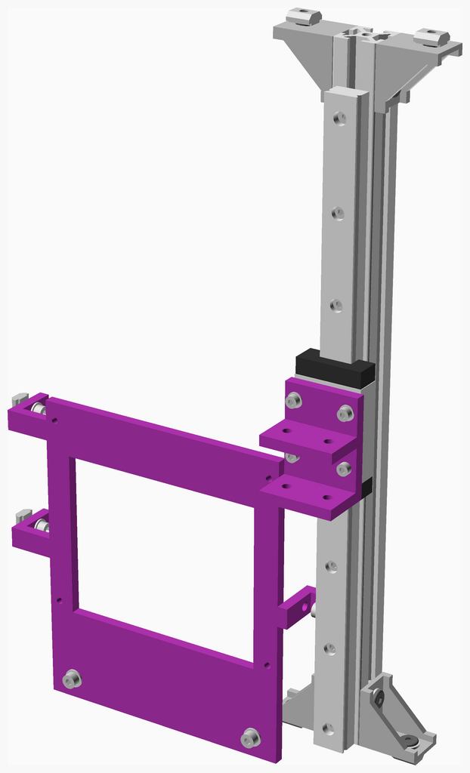
[picture p91: assemblies/left_z_axis_rail_assembled.png]
left_z_axis_rail_assembled


<span></span>
[Top](#TOP)

---

## 4 x Milled Corner Bracket Assembly
### Vitamins
|Qty|Description|
|---:|:---|
|8| Nut M5 sliding T|
|4| Ooznest 90 Degree Angle Corner (VSLOT-B-90AC)|
|8| Screw M5 low profile x 10mm|

### Assembly instructions
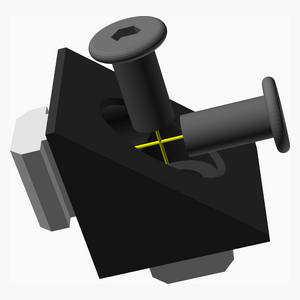
[picture p92: assemblies/milled_corner_bracket_assembly_tn.png]
milled_corner_bracket_assembly


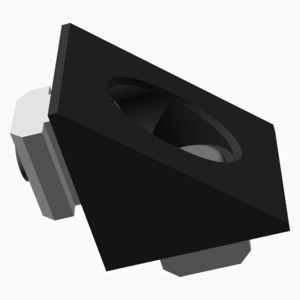
[picture p93: assemblies/milled_corner_bracket_assembled_tn.png]
milled_corner_bracket_assembled


<span></span>
[Top](#TOP)

---

## 2 x Rail Guard Assembly
### Vitamins
|Qty|Description|
|---:|:---|
|2| Nut M4 sliding T|
|2| Screw M4 cap x 16mm|
|2| Washer  M4 x 9mm x 0.8mm|

### 3D Printed parts

| 2 x rail_guard.stl |
|---|
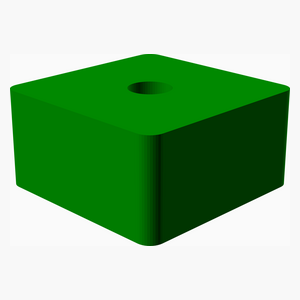
[picture p94: stls/rail_guard.png]
rail_guard.stl
|  

### Assembly instructions
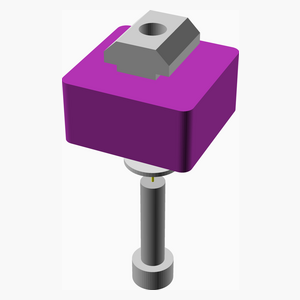
[picture p95: assemblies/rail_guard_assembly_tn.png]
rail_guard_assembly


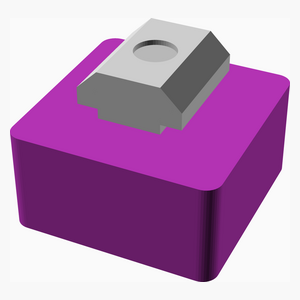
[picture p96: assemblies/rail_guard_assembled_tn.png]
rail_guard_assembled


<span></span>
[Top](#TOP)

---

## 2 x Z Motor Mount Assembly
### Vitamins
|Qty|Description|
|---:|:---|
|12| Nut M5 sliding T|
|12| Screw M4 cap x 10mm|
|12| Washer  M4 x 9mm x 0.8mm|

### 3D Printed parts

| 2 x z_motor_mount.stl |
|---|
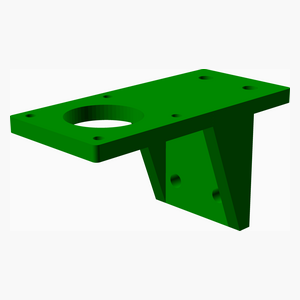
[picture p97: stls/z_motor_mount.png]
z_motor_mount.stl
|  

### Assembly instructions
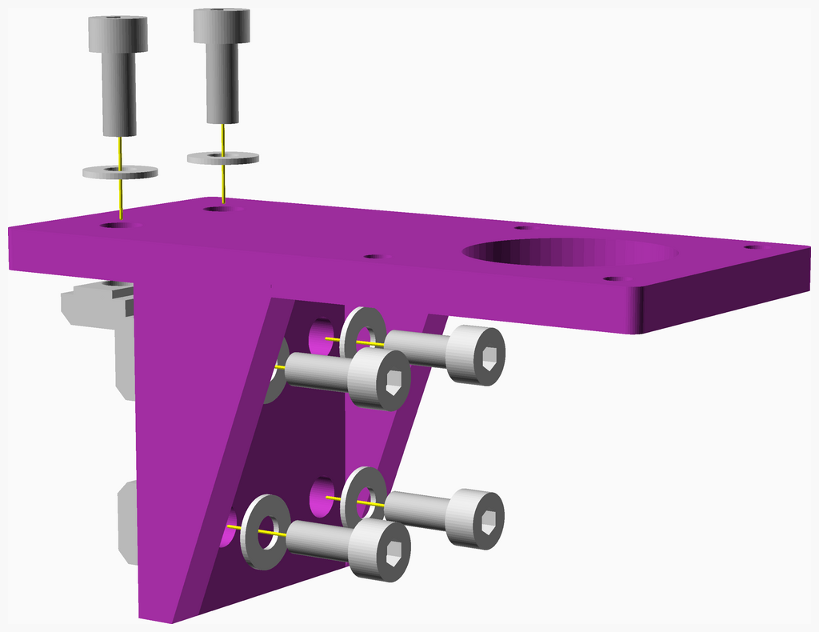
[picture p98: assemblies/z_motor_mount_assembly.png]
z_motor_mount_assembly


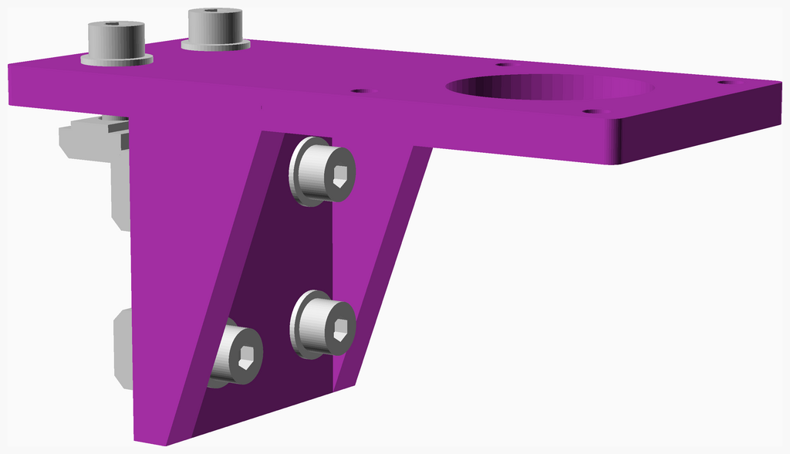
[picture p99: assemblies/z_motor_mount_assembled.png]
z_motor_mount_assembled


<span></span>
[Top](#TOP)

---

## Left Lower End Assembly
### Vitamins
|Qty|Description|
|---:|:---|
|1| Extrusion E2040 x 354mm|

### Sub-assemblies

| 1 x cast_corner_bracket_assembly | 2 x milled_corner_bracket_assembly | 1 x rail_guard_assembly |
|---|---|---|
| cast_corner_bracket_assembled | milled_corner_bracket_assembled | rail_guard_assembled 

| 1 x z_motor_mount_assembly |
|---|
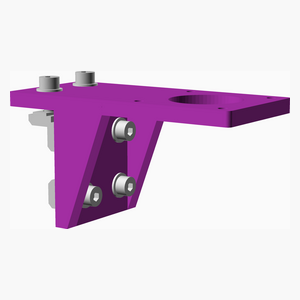
[picture p100: assemblies/z_motor_mount_assembled_tn.png]
z_motor_mount_assembled
|  

### Assembly instructions
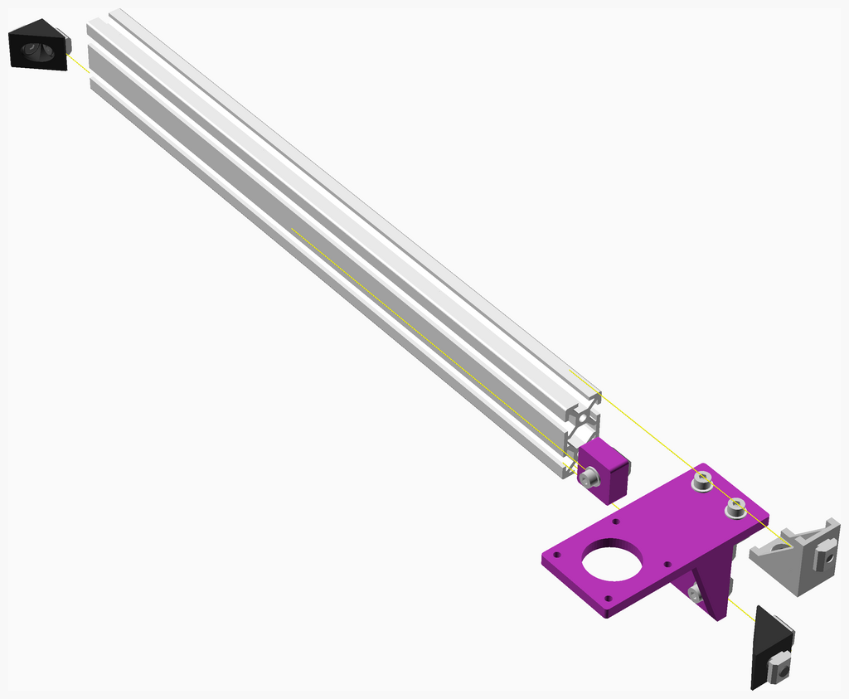
[picture p101: assemblies/left_lower_end_assembly.png]
left_lower_end_assembly


The position of the motor mount is not crucial but the design has it
centered 80mm from the center. The rail guard should be positioned
at the centre.

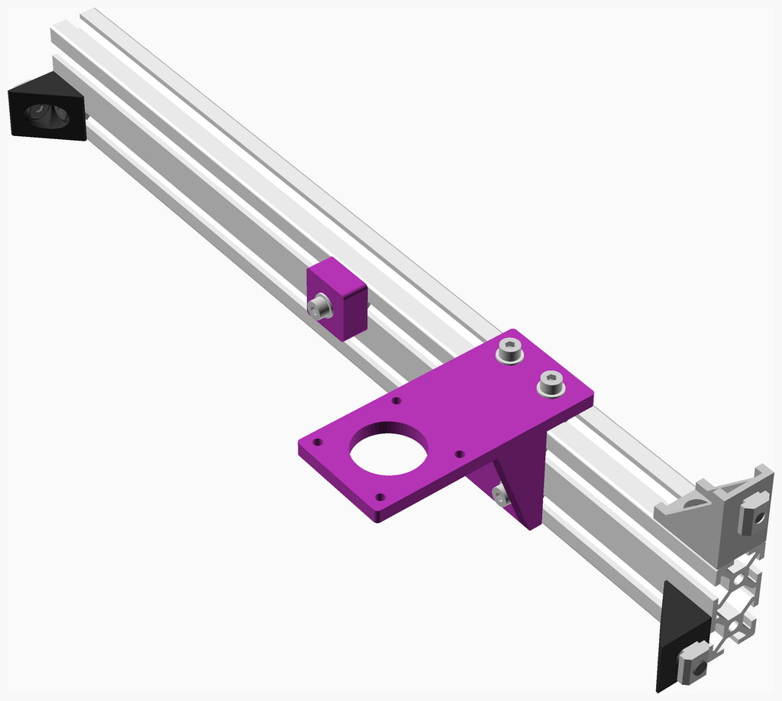
[picture p102: assemblies/left_lower_end_assembled.png]
left_lower_end_assembled


<span></span>
[Top](#TOP)

---

## Left Lower End With Z Assembly
### Sub-assemblies

| 1 x bottom_corner_assembly | 1 x cast_corner_bracket_assembly | 1 x left_lower_end_assembly |
|---|---|---|
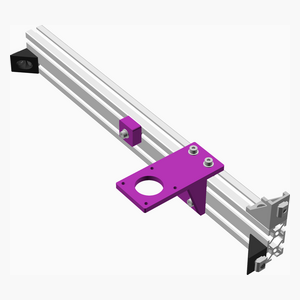
[picture p103: assemblies/left_lower_end_assembled_tn.png]
left_lower_end_assembled
| bottom_corner_assembled | cast_corner_bracket_assembled |  

| 1 x left_z_axis_rail_assembly | 1 x reversed_bottom_corner_assembly |
|---|---|
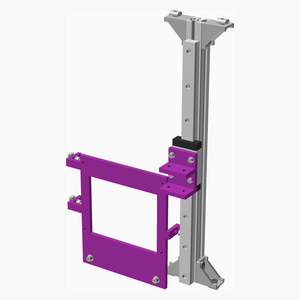
[picture p104: assemblies/left_z_axis_rail_assembled_tn.png]
left_z_axis_rail_assembled
|  | reversed_bottom_corner_assembled 

### Assembly instructions
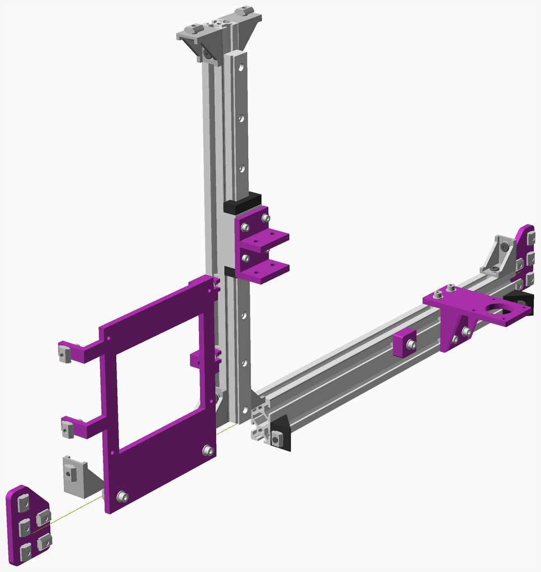
[picture p105: assemblies/left_lower_end_with_z_assembly.png]
left_lower_end_with_z_assembly


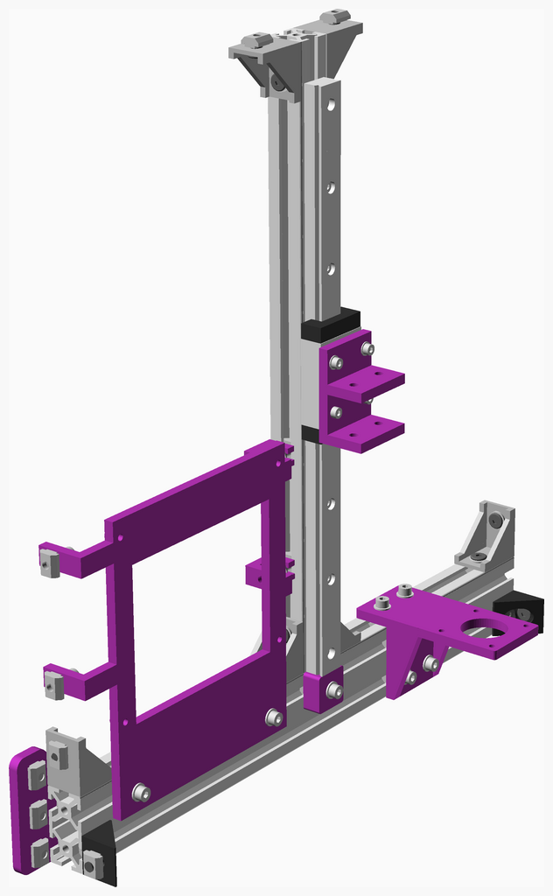
[picture p106: assemblies/left_lower_end_with_z_assembled.png]
left_lower_end_with_z_assembled


<span></span>
[Top](#TOP)

---

## Left Central End Assembly
### Sub-assemblies

| 1 x cast_corner_bracket_assembly | 1 x left_lower_end_with_z_assembly | 1 x left_upper_end_assembly |
|---|---|---|
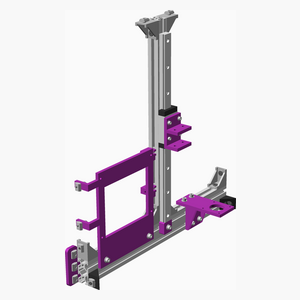
[picture p107: assemblies/left_lower_end_with_z_assembled_tn.png]
left_lower_end_with_z_assembled
| cast_corner_bracket_assembled |  | left_upper_end_assembled 

### Assembly instructions
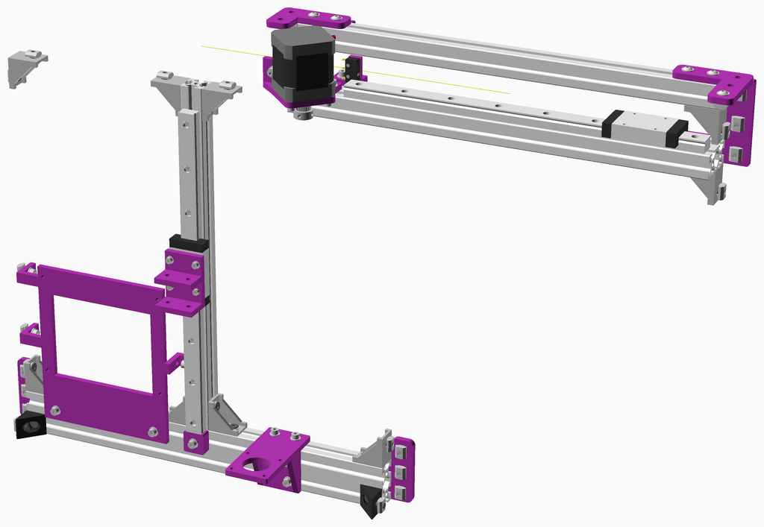
[picture p108: assemblies/left_central_end_assembly.png]
left_central_end_assembly


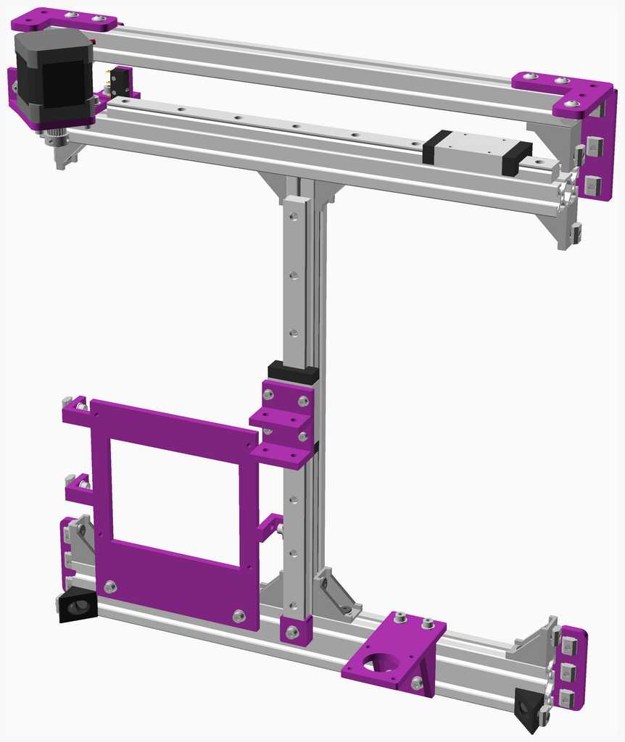
[picture p109: assemblies/left_central_end_assembled.png]
left_central_end_assembled


<span></span>
[Top](#TOP)

---

## 2 x Dual Idler Assembly
### Vitamins
|Qty|Description|
|---:|:---|
|8| Ball bearing F623-2RS 3mm x 10mm x 4mm|
|10| Washer  M3 x 7mm x 0.5mm|

### Assembly instructions
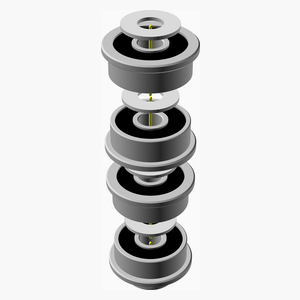
[picture p110: assemblies/dual_idler_assembly_tn.png]
dual_idler_assembly


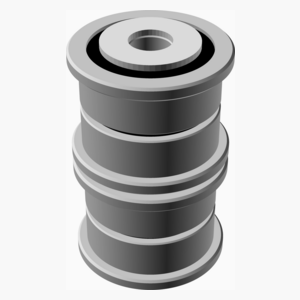
[picture p111: assemblies/dual_idler_assembled_tn.png]
dual_idler_assembled


<span></span>
[Top](#TOP)

---

## Back Left Idler Assembly
### Vitamins
|Qty|Description|
|---:|:---|
|1| Nut M3 x 2.4mm |
|3| Nut M4 sliding T|
|1| Screw M3 cap x 35mm|
|3| Screw M4 cap x 10mm|
|2| Washer  M3 x 7mm x 0.5mm|
|3| Washer  M4 x 9mm x 0.8mm|

### 3D Printed parts

| 1 x left_idler.stl |
|---|
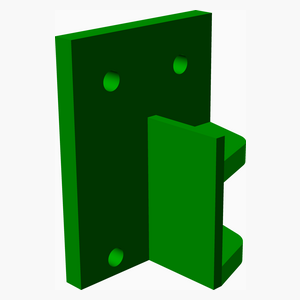
[picture p112: stls/left_idler.png]
left_idler.stl
|  

### Sub-assemblies

| 1 x dual_idler_assembly |
|---|
| dual_idler_assembled 

### Assembly instructions
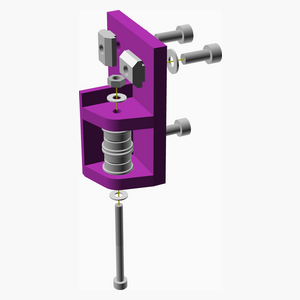
[picture p113: assemblies/back_left_idler_assembly_tn.png]
back_left_idler_assembly


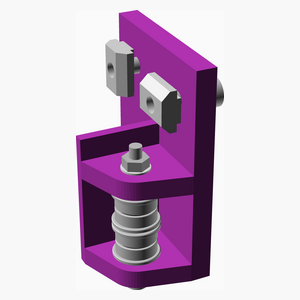
[picture p114: assemblies/back_left_idler_assembled_tn.png]
back_left_idler_assembled


<span></span>
[Top](#TOP)

---

## Left Rear Upright Assembly
### Vitamins
|Qty|Description|
|---:|:---|
|1| Extrusion E2040 x 430mm|
|1| Extrusion inner corner bracket for E2020t|
|4| Nut M4 sliding T|
|2| Screw M5 flanged x 12mm|

### 3D Printed parts

| 1 x foot.stl |
|---|
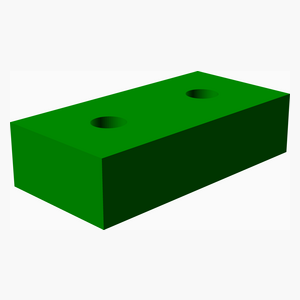
[picture p115: stls/foot.png]
foot.stl
|  

### Sub-assemblies

| 1 x back_left_idler_assembly | 1 x bottom_corner_assembly | 1 x cast_corner_bracket_assembly |
|---|---|---|
| back_left_idler_assembled | bottom_corner_assembled | cast_corner_bracket_assembled 

### Assembly instructions
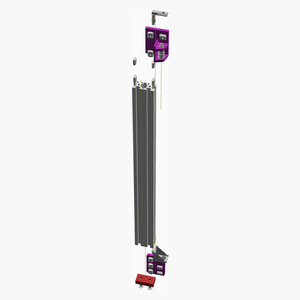
[picture p116: assemblies/left_rear_upright_assembly_tn.png]
left_rear_upright_assembly


Items should be slid into place as shown. The idler will need to
be slide down temporarily to allow the hidden corner bracket grub
screw to be tightened. The extra t-nuts are for the IEC socket mount
that is attached later.

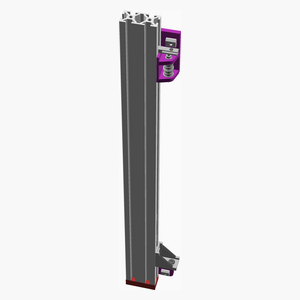
[picture p117: assemblies/left_rear_upright_assembled_tn.png]
left_rear_upright_assembled


<span></span>
[Top](#TOP)

---

## Left Central And Rear Assembly
### Vitamins
|Qty|Description|
|---:|:---|
|4| Screw M4 cap x 10mm|
|2| Screw M5 flanged x 12mm|
|4| Washer  M4 x 9mm x 0.8mm|

### 3D Printed parts

| 1 x iec_socket_mount.stl |
|---|
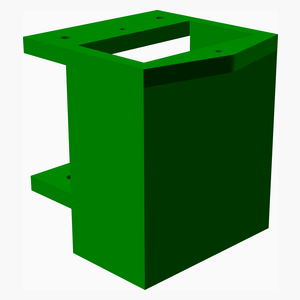
[picture p118: stls/iec_socket_mount.png]
iec_socket_mount.stl
|  

### Sub-assemblies

| 1 x left_central_end_assembly | 1 x left_rear_upright_assembly |
|---|---|
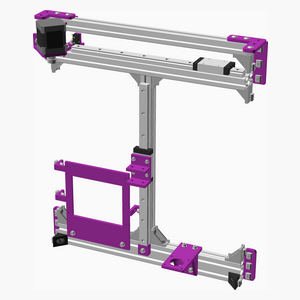
[picture p119: assemblies/left_central_end_assembled_tn.png]
left_central_end_assembled
|  | left_rear_upright_assembled 

### Assembly instructions
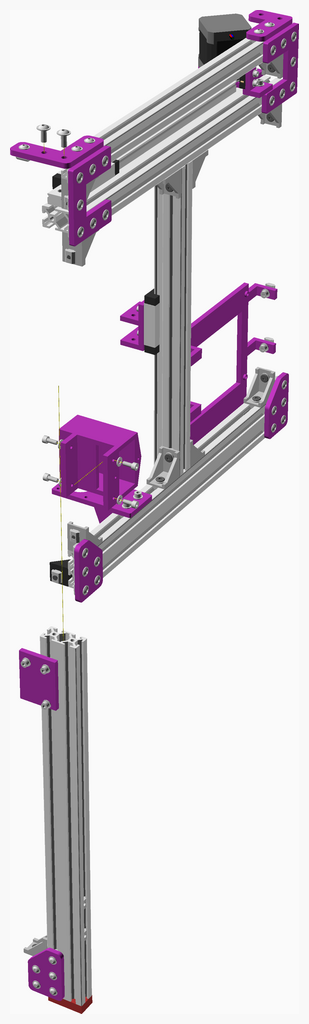
[picture p120: assemblies/left_central_and_rear_assembly.png]
left_central_and_rear_assembly


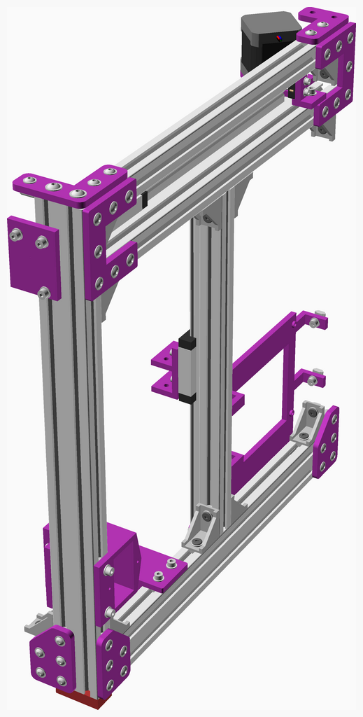
[picture p121: assemblies/left_central_and_rear_assembled.png]
left_central_and_rear_assembled


<span></span>
[Top](#TOP)

---

## Left Front Upright Assembly
### Vitamins
|Qty|Description|
|---:|:---|
|1| Extrusion E2040 x 430mm|
|2| Screw M5 flanged x 12mm|

### 3D Printed parts

| 1 x foot.stl |
|---|
| foot.stl 

### Sub-assemblies

| 1 x cast_corner_bracket_assembly | 1 x reversed_bottom_corner_assembly |
|---|---|
| cast_corner_bracket_assembled | reversed_bottom_corner_assembled 

### Assembly instructions
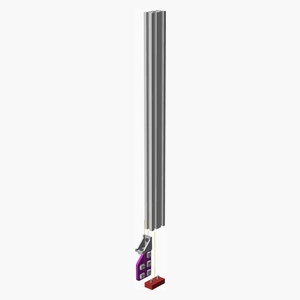
[picture p122: assemblies/left_front_upright_assembly_tn.png]
left_front_upright_assembly


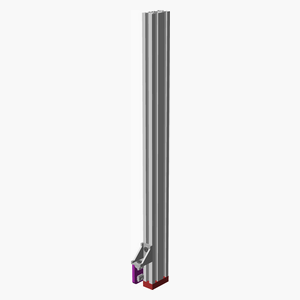
[picture p123: assemblies/left_front_upright_assembled_tn.png]
left_front_upright_assembled


<span></span>
[Top](#TOP)

---

## Left End Frame Assembly
### Vitamins
|Qty|Description|
|---:|:---|
|2| Screw M5 flanged x 12mm|

### Sub-assemblies

| 1 x left_central_and_rear_assembly | 1 x left_front_upright_assembly |
|---|---|
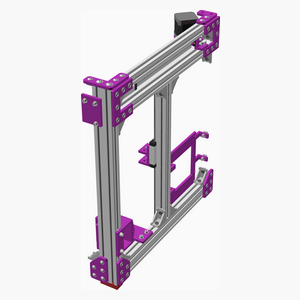
[picture p124: assemblies/left_central_and_rear_assembled_tn.png]
left_central_and_rear_assembled
|  | left_front_upright_assembled 

### Assembly instructions
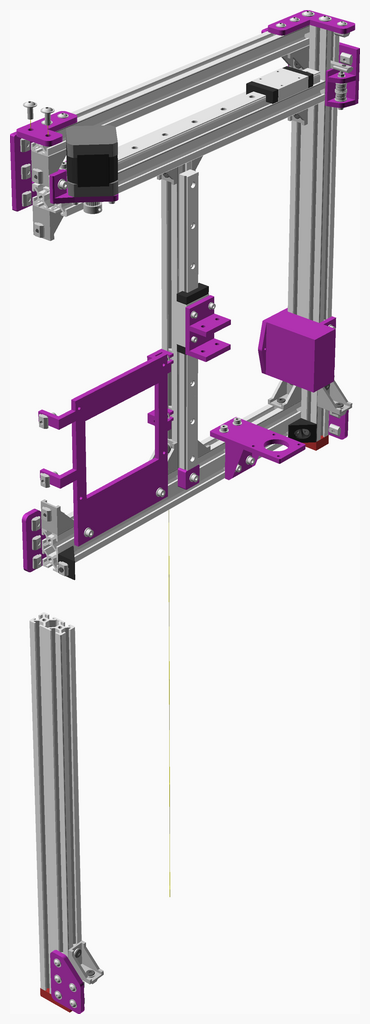
[picture p125: assemblies/left_end_frame_assembly.png]
left_end_frame_assembly


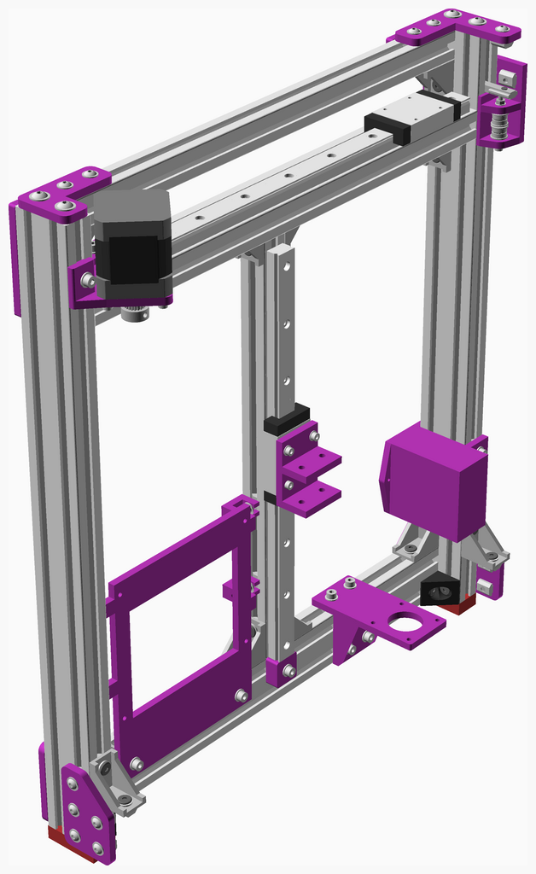
[picture p126: assemblies/left_end_frame_assembled.png]
left_end_frame_assembled


<span></span>
[Top](#TOP)

---

## Left End With Z Carriage Rail Assembly
### Vitamins
|Qty|Description|
|---:|:---|
|1| Extrusion E2020 x 220mm|
|4| Nut M4 sliding T|
|2| Nut M5 sliding T|
|1| Ooznest ACME anti-backlash nut|
|4| Screw M4 cap x 10mm|
|2| Screw M5 cap x 16mm|
|4| Washer  M4 x 9mm x 0.8mm|
|2| Washer  M5 x 10mm x 1mm|

### Sub-assemblies

| 1 x left_end_frame_assembly | 2 x milled_corner_for_tapped_end_assembly |
|---|---|
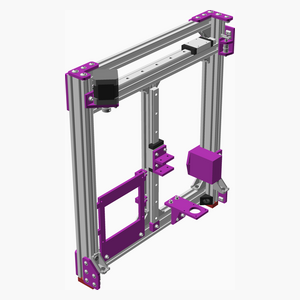
[picture p127: assemblies/left_end_frame_assembled_tn.png]
left_end_frame_assembled
|  | milled_corner_for_tapped_end_assembled 

### Assembly instructions
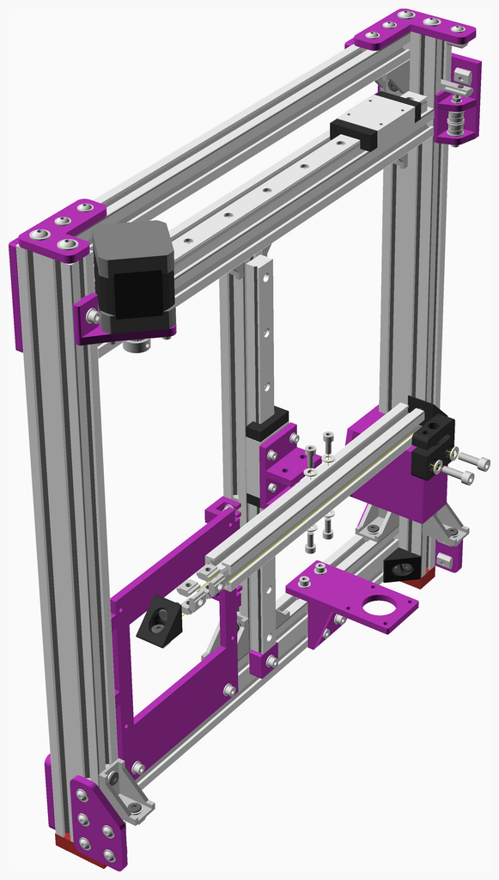
[picture p128: assemblies/left_end_with_z_carriage_rail_assembly.png]
left_end_with_z_carriage_rail_assembly


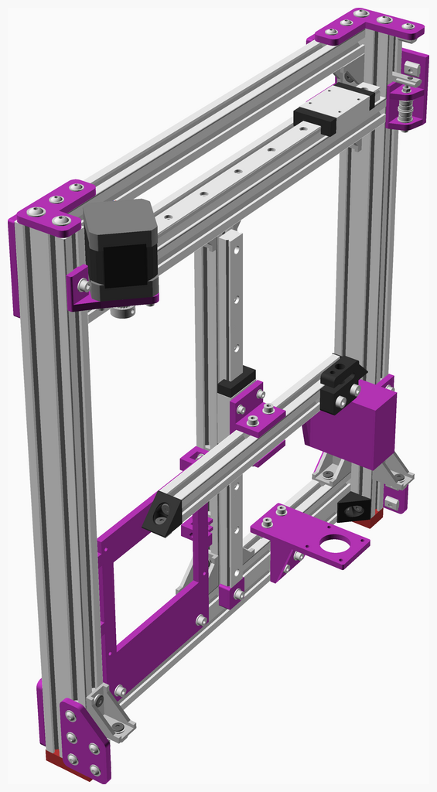
[picture p129: assemblies/left_end_with_z_carriage_rail_assembled.png]
left_end_with_z_carriage_rail_assembled


<span></span>
[Top](#TOP)

---

## 2 x Titan Mount Assembly
### Vitamins
|Qty|Description|
|---:|:---|
|2| E3D Titan Extruder|
|4| Nut M4 sliding T|
|4| Screw M4 cap x 10mm|
|2| Stepper motor NEMA17 x 40mm|
|4| Washer  M4 x 9mm x 0.8mm|

### 3D Printed parts

| 2 x titan_mount.stl |
|---|
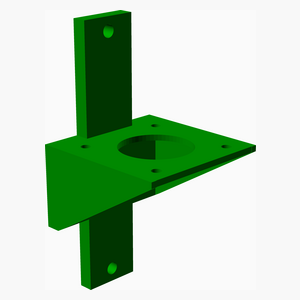
[picture p130: stls/titan_mount.png]
titan_mount.stl
|  

### Assembly instructions
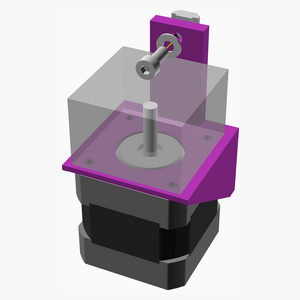
[picture p131: assemblies/titan_mount_assembly_tn.png]
titan_mount_assembly


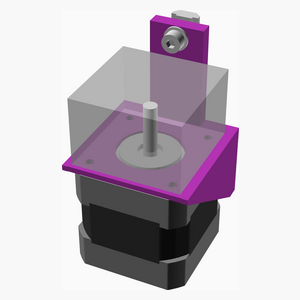
[picture p132: assemblies/titan_mount_assembled_tn.png]
titan_mount_assembled


<span></span>
[Top](#TOP)

---

## Right Front Top Corner Assembly
### Vitamins
|Qty|Description|
|---:|:---|
|2| Nut M4 sliding T|
|2| Screw M4 flanged x 10mm|

### 3D Printed parts

| 1 x front_top_corner.stl |
|---|
| front_top_corner.stl 

### Assembly instructions
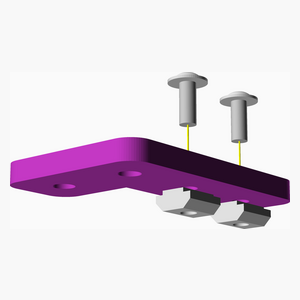
[picture p133: assemblies/right_front_top_corner_assembly_tn.png]
right_front_top_corner_assembly


The two larger (5mm) holes should be empty.

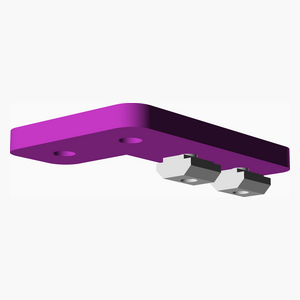
[picture p134: assemblies/right_front_top_corner_assembled_tn.png]
right_front_top_corner_assembled


<span></span>
[Top](#TOP)

---

## Right Back Top Corner Assembly
### Vitamins
|Qty|Description|
|---:|:---|
|3| Nut M4 sliding T|
|3| Screw M4 flanged x 10mm|

### 3D Printed parts

| 1 x back_top_corner.stl |
|---|
| back_top_corner.stl 

### Assembly instructions
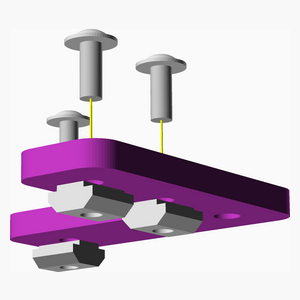
[picture p135: assemblies/right_back_top_corner_assembly_tn.png]
right_back_top_corner_assembly


The two larger (5mm) holes should be empty.

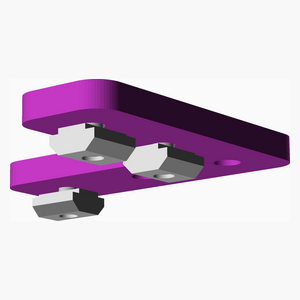
[picture p136: assemblies/right_back_top_corner_assembled_tn.png]
right_back_top_corner_assembled


<span></span>
[Top](#TOP)

---

## Right Motor Assembly
### Vitamins
|Qty|Description|
|---:|:---|
|3| Nut M4 sliding T|
|1| Pulley GT2OB 20 teeth|
|1| Screw M3 cap x 10mm|
|3| Screw M3 cap x 12mm|
|3| Screw M4 cap x 10mm|
|1| Stepper motor NEMA17 x 47mm|
|3| Washer  M3 x 7mm x 0.5mm|
|3| Washer  M4 x 9mm x 0.8mm|

### 3D Printed parts

| 1 x right_motor_mount.stl |
|---|
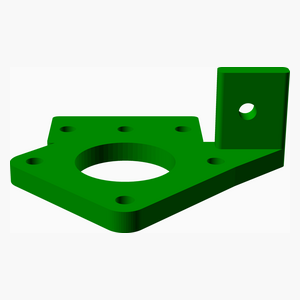
[picture p137: stls/right_motor_mount.png]
right_motor_mount.stl
|  

### Assembly instructions
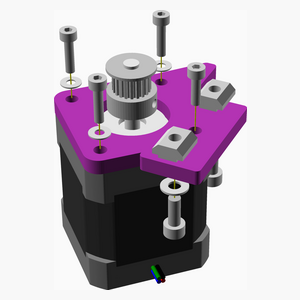
[picture p138: assemblies/right_motor_assembly_tn.png]
right_motor_assembly


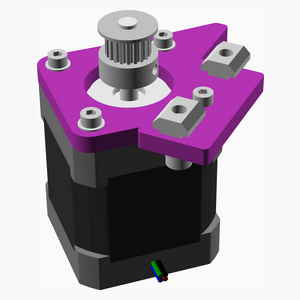
[picture p139: assemblies/right_motor_assembled_tn.png]
right_motor_assembled


<span></span>
[Top](#TOP)

---

## Right Y Rail Assembly
### Vitamins
|Qty|Description|
|---:|:---|
|1| Extrusion E2040 x 354mm|

### Sub-assemblies

| 1 x cast_corner_bracket_assembly | 1 x right_motor_assembly | 1 x y_rail_assembly |
|---|---|---|
| cast_corner_bracket_assembled | right_motor_assembled | y_rail_assembled 

### Assembly instructions
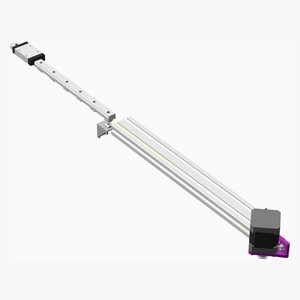
[picture p140: assemblies/right_y_rail_assembly_tn.png]
right_y_rail_assembly


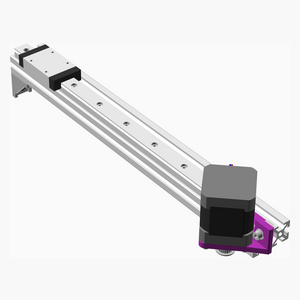
[picture p141: assemblies/right_y_rail_assembled_tn.png]
right_y_rail_assembled


<span></span>
[Top](#TOP)

---

## Right Upper End Assembly
### Vitamins
|Qty|Description|
|---:|:---|
|1| Extrusion E2020 x 354mm|

### Sub-assemblies

| 2 x cast_corner_bracket_assembly | 1 x right_back_top_corner_assembly | 1 x right_front_top_corner_assembly |
|---|---|---|
| cast_corner_bracket_assembled | right_back_top_corner_assembled | right_front_top_corner_assembled 

| 1 x right_y_rail_assembly | 2 x side_top_corner_assembly | 2 x titan_mount_assembly |
|---|---|---|
| right_y_rail_assembled | side_top_corner_assembled | titan_mount_assembled 

### Assembly instructions
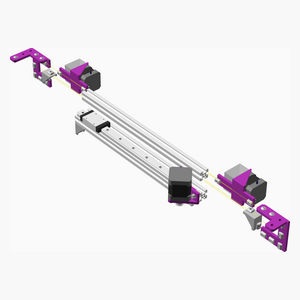
[picture p142: assemblies/right_upper_end_assembly_tn.png]
right_upper_end_assembly


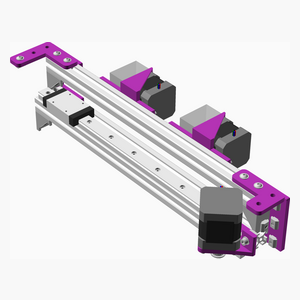
[picture p143: assemblies/right_upper_end_assembled_tn.png]
right_upper_end_assembled


<span></span>
[Top](#TOP)

---

## Right Z Axis Rail Assembly
### Vitamins
|Qty|Description|
|---:|:---|
|1| Extrusion E2020 x 320mm|

### Sub-assemblies

| 4 x cast_corner_bracket_assembly | 1 x z_carriage_assembly | 1 x z_rail_assembly |
|---|---|---|
| cast_corner_bracket_assembled | z_carriage_assembled | z_rail_assembled 

### Assembly instructions
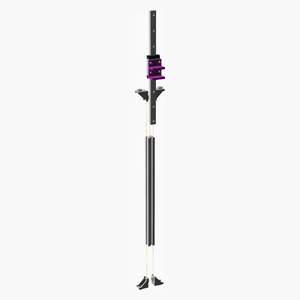
[picture p144: assemblies/right_z_axis_rail_assembly_tn.png]
right_z_axis_rail_assembly


Be careful with the MGN carriage until it is attached to the rest of
the end frame.

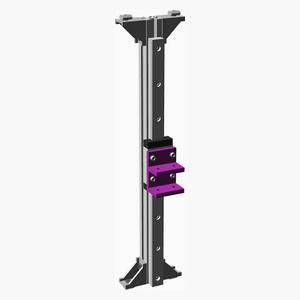
[picture p145: assemblies/right_z_axis_rail_assembled_tn.png]
right_z_axis_rail_assembled


<span></span>
[Top](#TOP)

---

## Right Lower End Assembly
### Vitamins
|Qty|Description|
|---:|:---|
|1| Extrusion E2040 x 354mm|

### Sub-assemblies

| 1 x cast_corner_bracket_assembly | 2 x milled_corner_bracket_assembly | 1 x rail_guard_assembly |
|---|---|---|
| cast_corner_bracket_assembled | milled_corner_bracket_assembled | rail_guard_assembled 

| 1 x z_motor_mount_assembly |
|---|
| z_motor_mount_assembled 

### Assembly instructions
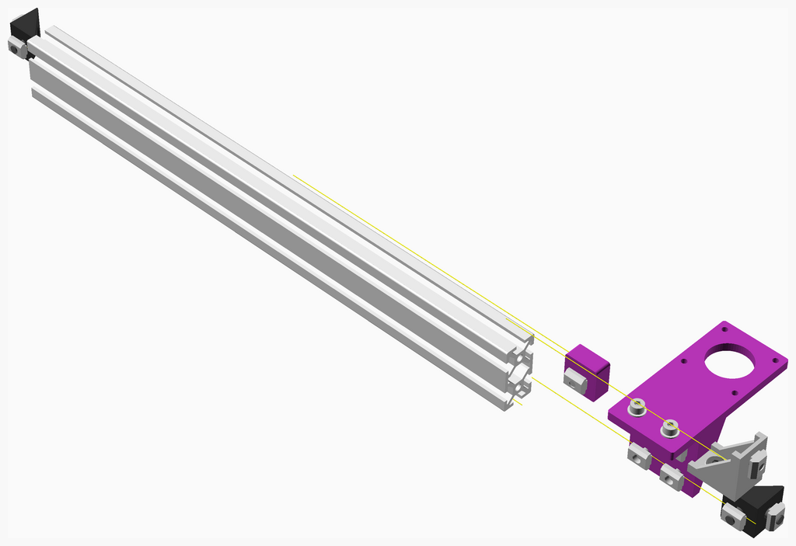
[picture p146: assemblies/right_lower_end_assembly.png]
right_lower_end_assembly


The position of the motor mount is not crucial but the design has it
centered 80mm from the center. The rail guard should be positioned
at the centre.

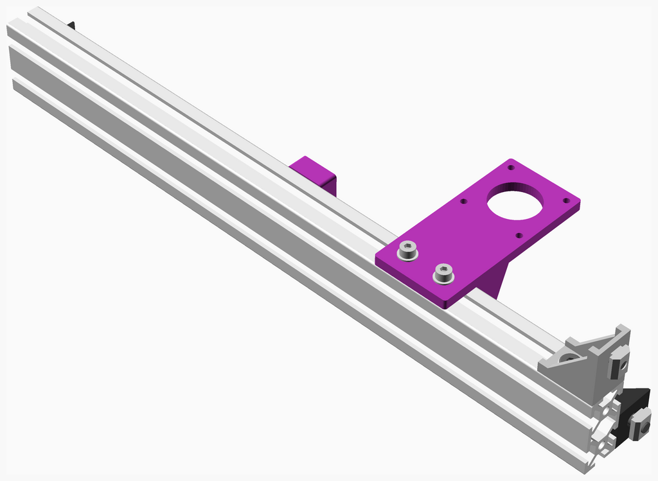
[picture p147: assemblies/right_lower_end_assembled.png]
right_lower_end_assembled


<span></span>
[Top](#TOP)

---

## Right Lower End With Z Assembly
### Sub-assemblies

| 1 x bottom_corner_assembly | 1 x cast_corner_bracket_assembly | 1 x reversed_bottom_corner_assembly |
|---|---|---|
| bottom_corner_assembled | cast_corner_bracket_assembled | reversed_bottom_corner_assembled 

| 1 x right_lower_end_assembly | 1 x right_z_axis_rail_assembly |
|---|---|
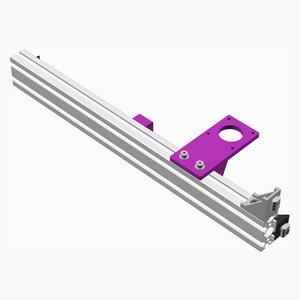
[picture p148: assemblies/right_lower_end_assembled_tn.png]
right_lower_end_assembled
|  | right_z_axis_rail_assembled 

### Assembly instructions
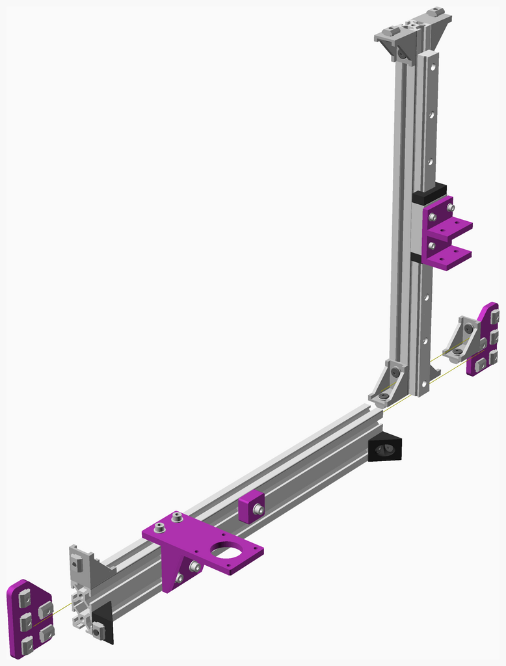
[picture p149: assemblies/right_lower_end_with_z_assembly.png]
right_lower_end_with_z_assembly


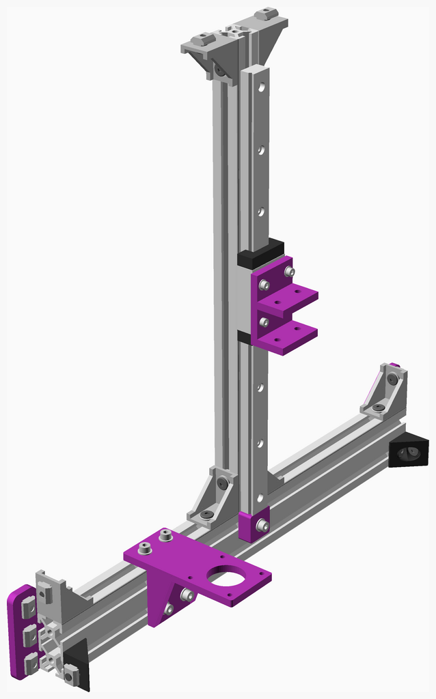
[picture p150: assemblies/right_lower_end_with_z_assembled.png]
right_lower_end_with_z_assembled


<span></span>
[Top](#TOP)

---

## Right Central End Assembly
### Sub-assemblies

| 1 x cast_corner_bracket_assembly | 1 x right_lower_end_with_z_assembly | 1 x right_upper_end_assembly |
|---|---|---|
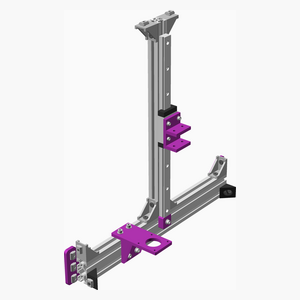
[picture p151: assemblies/right_lower_end_with_z_assembled_tn.png]
right_lower_end_with_z_assembled
| cast_corner_bracket_assembled |  | right_upper_end_assembled 

### Assembly instructions
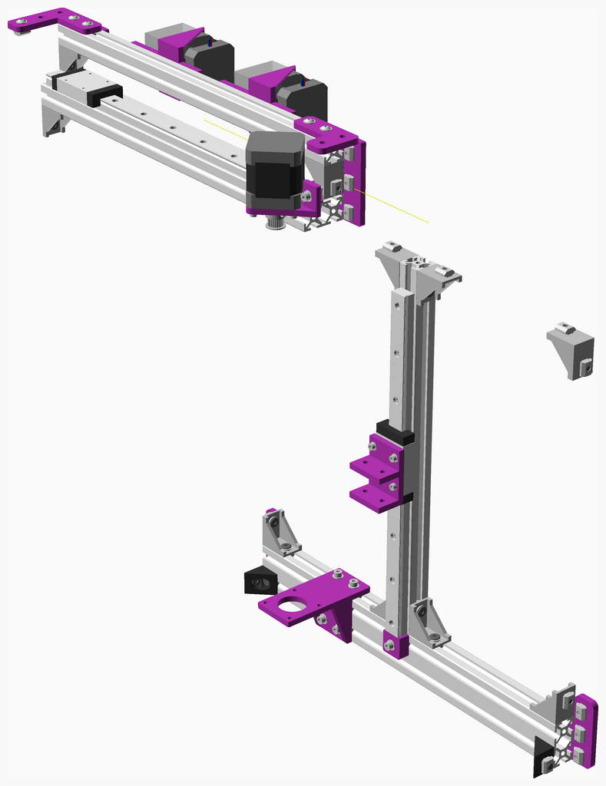
[picture p152: assemblies/right_central_end_assembly.png]
right_central_end_assembly


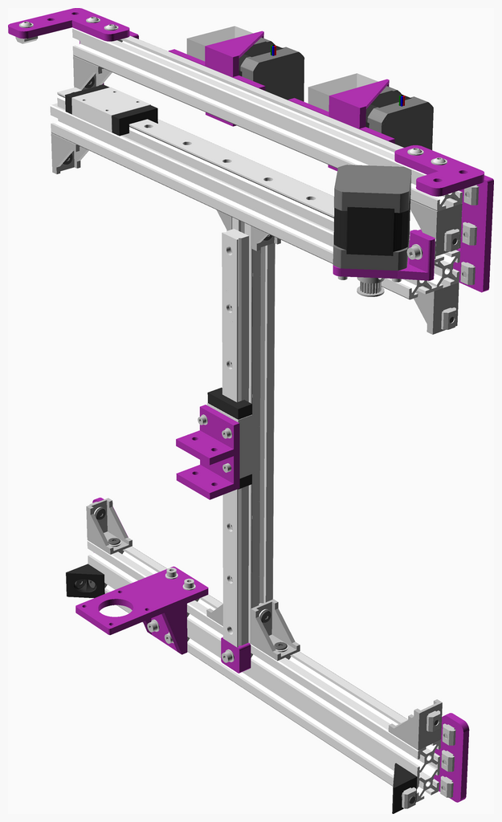
[picture p153: assemblies/right_central_end_assembled.png]
right_central_end_assembled


<span></span>
[Top](#TOP)

---

## Back Right Idler Assembly
### Vitamins
|Qty|Description|
|---:|:---|
|1| Nut M3 x 2.4mm |
|3| Nut M4 sliding T|
|1| Screw M3 cap x 35mm|
|3| Screw M4 cap x 10mm|
|2| Washer  M3 x 7mm x 0.5mm|
|3| Washer  M4 x 9mm x 0.8mm|

### 3D Printed parts

| 1 x right_idler.stl |
|---|
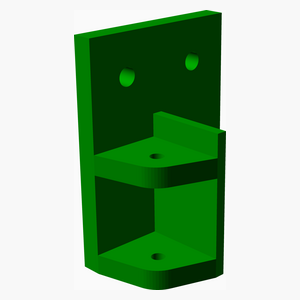
[picture p154: stls/right_idler.png]
right_idler.stl
|  

### Sub-assemblies

| 1 x dual_idler_assembly |
|---|
| dual_idler_assembled 

### Assembly instructions
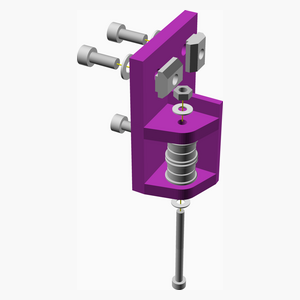
[picture p155: assemblies/back_right_idler_assembly_tn.png]
back_right_idler_assembly


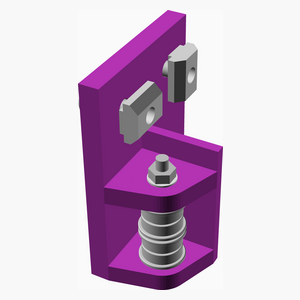
[picture p156: assemblies/back_right_idler_assembled_tn.png]
back_right_idler_assembled


<span></span>
[Top](#TOP)

---

## Right Rear Upright Assembly
### Vitamins
|Qty|Description|
|---:|:---|
|1| Extrusion E2040 x 430mm|
|1| Extrusion inner corner bracket for E2020t|
|4| Nut M4 sliding T|
|4| Screw M4 cap x 10mm|
|2| Screw M5 flanged x 12mm|
|4| Washer  M4 x 9mm x 0.8mm|

### 3D Printed parts

| 1 x foot.stl | 1 x spool_rod_holder.stl |
|---|---|
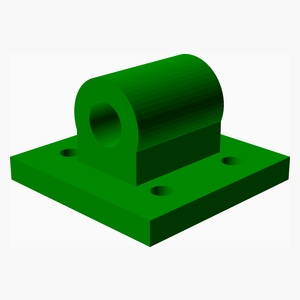
[picture p157: stls/spool_rod_holder.png]
spool_rod_holder.stl
| foot.stl |  

### Sub-assemblies

| 1 x back_right_idler_assembly | 1 x cast_corner_bracket_assembly | 1 x reversed_bottom_corner_assembly |
|---|---|---|
| back_right_idler_assembled | cast_corner_bracket_assembled | reversed_bottom_corner_assembled 

### Assembly instructions
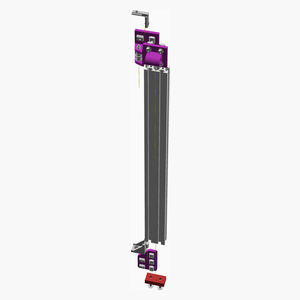
[picture p158: assemblies/right_rear_upright_assembly_tn.png]
right_rear_upright_assembly


Items should be slid into place as shown. The idler will need to
be slid down temporarily to allow the hidden corner bracket grub
screw to be tightened.

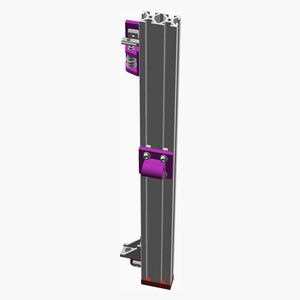
[picture p159: assemblies/right_rear_upright_assembled_tn.png]
right_rear_upright_assembled


<span></span>
[Top](#TOP)

---

## Right Central And Rear Assembly
### Vitamins
|Qty|Description|
|---:|:---|
|2| Screw M5 flanged x 12mm|

### Sub-assemblies

| 1 x right_central_end_assembly | 1 x right_rear_upright_assembly |
|---|---|
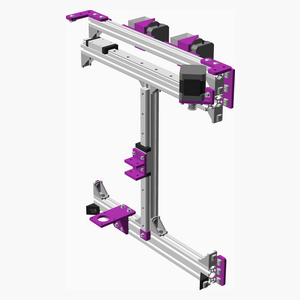
[picture p160: assemblies/right_central_end_assembled_tn.png]
right_central_end_assembled
|  | right_rear_upright_assembled 

### Assembly instructions
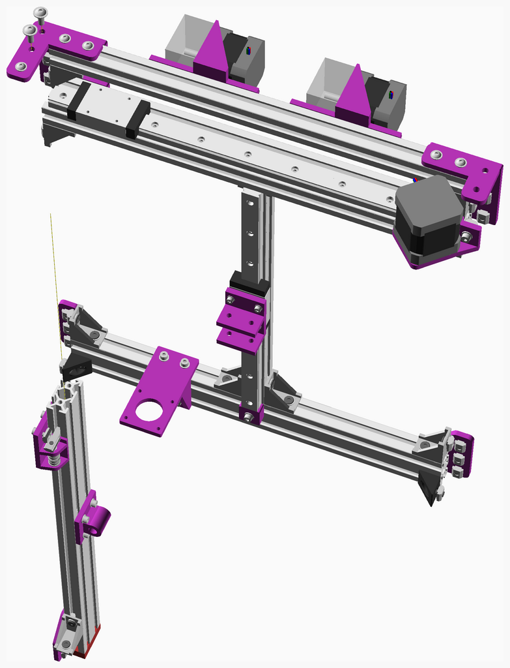
[picture p161: assemblies/right_central_and_rear_assembly.png]
right_central_and_rear_assembly


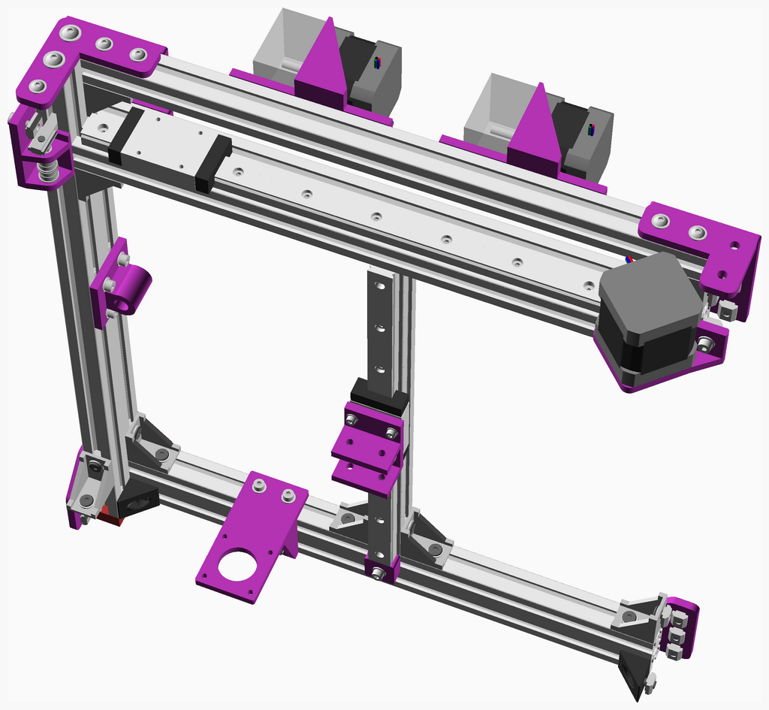
[picture p162: assemblies/right_central_and_rear_assembled.png]
right_central_and_rear_assembled


<span></span>
[Top](#TOP)

---

## Right Front Upright Assembly
### Vitamins
|Qty|Description|
|---:|:---|
|1| Extrusion E2040 x 430mm|
|4| Nut M4 sliding T|
|4| Screw M4 cap x 10mm|
|2| Screw M5 flanged x 12mm|
|4| Washer  M4 x 9mm x 0.8mm|

### 3D Printed parts

| 1 x foot.stl | 1 x spool_rod_holder.stl |
|---|---|
| foot.stl | spool_rod_holder.stl 

### Sub-assemblies

| 1 x bottom_corner_assembly | 1 x cast_corner_bracket_assembly |
|---|---|
| bottom_corner_assembled | cast_corner_bracket_assembled 

### Assembly instructions
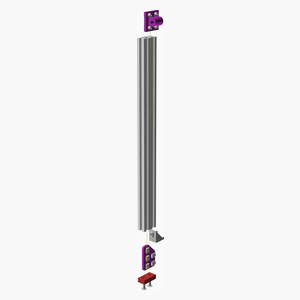
[picture p163: assemblies/right_front_upright_assembly_tn.png]
right_front_upright_assembly


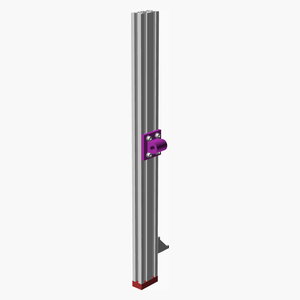
[picture p164: assemblies/right_front_upright_assembled_tn.png]
right_front_upright_assembled


<span></span>
[Top](#TOP)

---

## Right End Frame Assembly
### Vitamins
|Qty|Description|
|---:|:---|
|2| Screw M5 flanged x 12mm|

### Sub-assemblies

| 1 x right_central_and_rear_assembly | 1 x right_front_upright_assembly |
|---|---|
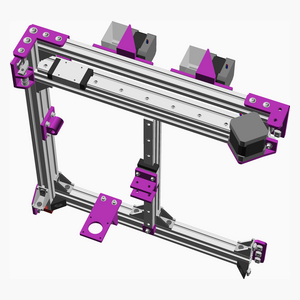
[picture p165: assemblies/right_central_and_rear_assembled_tn.png]
right_central_and_rear_assembled
|  | right_front_upright_assembled 

### Assembly instructions
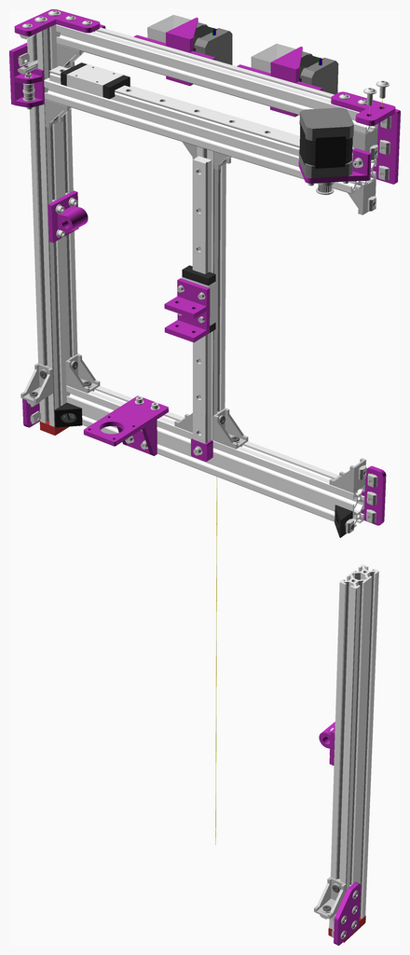
[picture p166: assemblies/right_end_frame_assembly.png]
right_end_frame_assembly


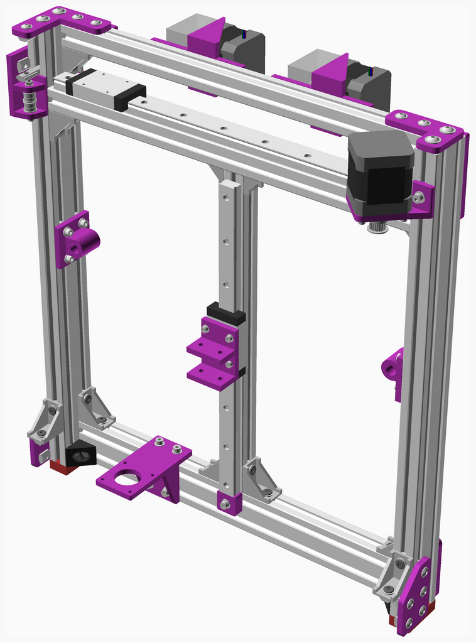
[picture p167: assemblies/right_end_frame_assembled.png]
right_end_frame_assembled


<span></span>
[Top](#TOP)

---

## Right End With Z Carriage Rail Assembly
### Vitamins
|Qty|Description|
|---:|:---|
|1| Extrusion E2020 x 220mm|
|4| Nut M4 sliding T|
|2| Nut M5 sliding T|
|1| Ooznest ACME anti-backlash nut|
|4| Screw M4 cap x 10mm|
|2| Screw M5 cap x 16mm|
|4| Washer  M4 x 9mm x 0.8mm|
|2| Washer  M5 x 10mm x 1mm|

### Sub-assemblies

| 2 x milled_corner_for_tapped_end_assembly | 1 x right_end_frame_assembly |
|---|---|
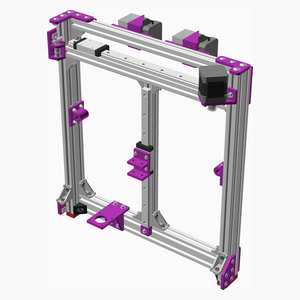
[picture p168: assemblies/right_end_frame_assembled_tn.png]
right_end_frame_assembled
| milled_corner_for_tapped_end_assembled |  

### Assembly instructions
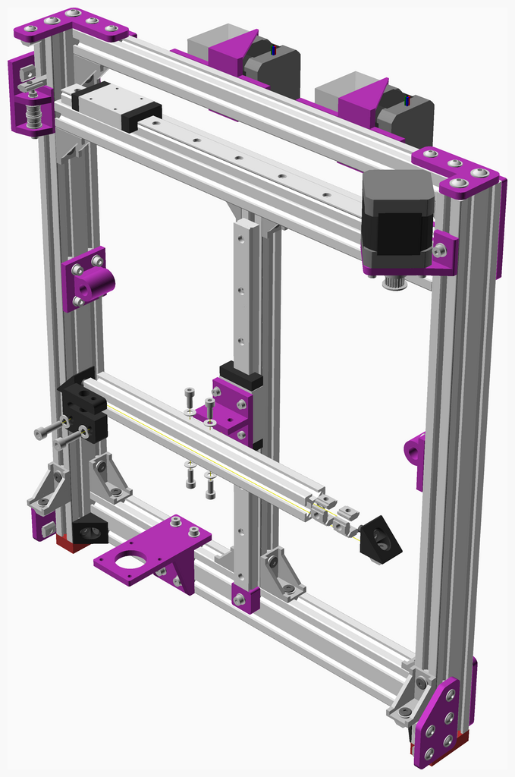
[picture p169: assemblies/right_end_with_z_carriage_rail_assembly.png]
right_end_with_z_carriage_rail_assembly


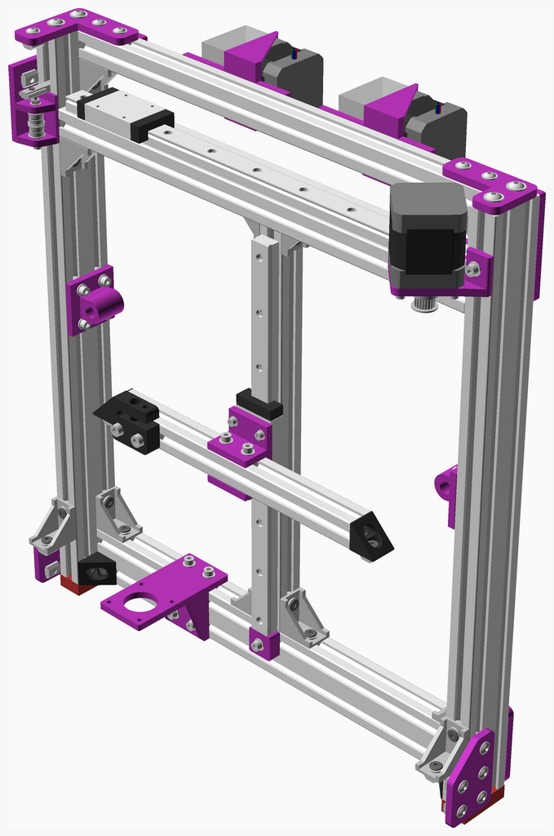
[picture p170: assemblies/right_end_with_z_carriage_rail_assembled.png]
right_end_with_z_carriage_rail_assembled


<span></span>
[Top](#TOP)

---

## Frame Assembly
### Vitamins
|Qty|Description|
|---:|:---|
|2| Extrusion E2040 x 472mm|

### Sub-assemblies

| 1 x left_end_with_z_carriage_rail_assembly | 1 x lower_back_frame_assembly | 1 x right_end_with_z_carriage_rail_assembly |
|---|---|---|
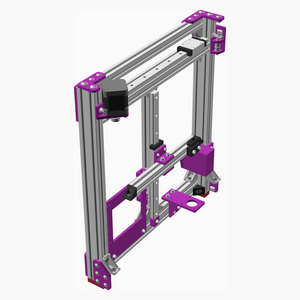
[picture p171: assemblies/left_end_with_z_carriage_rail_assembled_tn.png]
left_end_with_z_carriage_rail_assembled
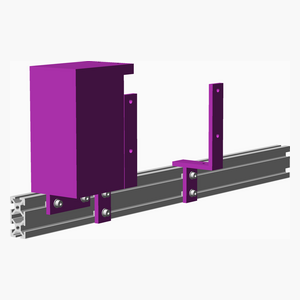
[picture p172: assemblies/lower_back_frame_assembled_tn.png]
lower_back_frame_assembled
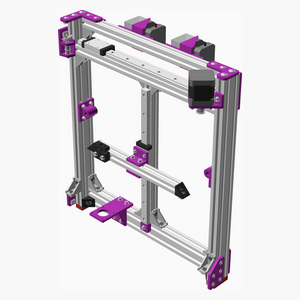
[picture p173: assemblies/right_end_with_z_carriage_rail_assembled_tn.png]
right_end_with_z_carriage_rail_assembled
|  |  |  

### Assembly instructions
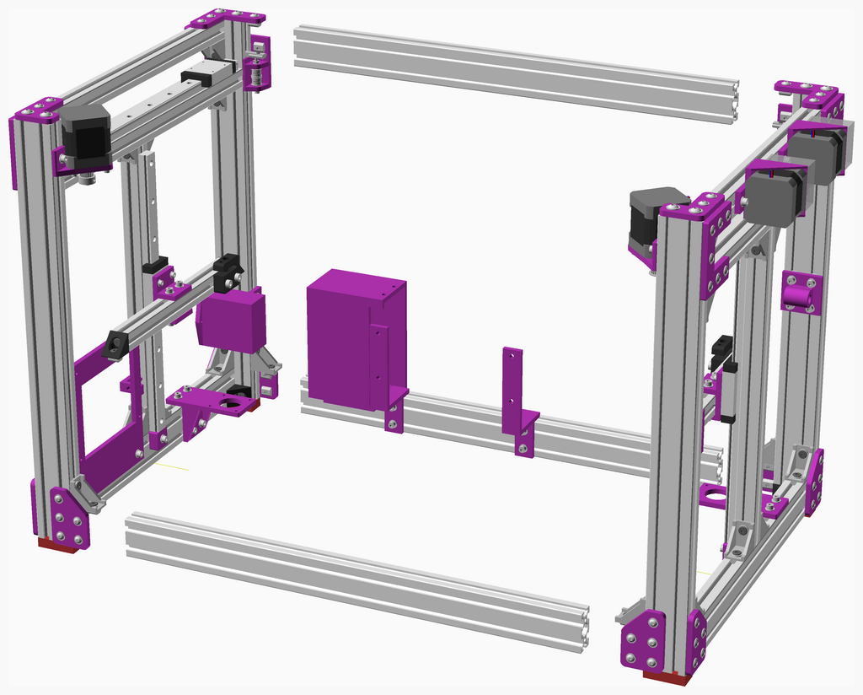
[picture p174: assemblies/frame_assembly.png]
frame_assembly


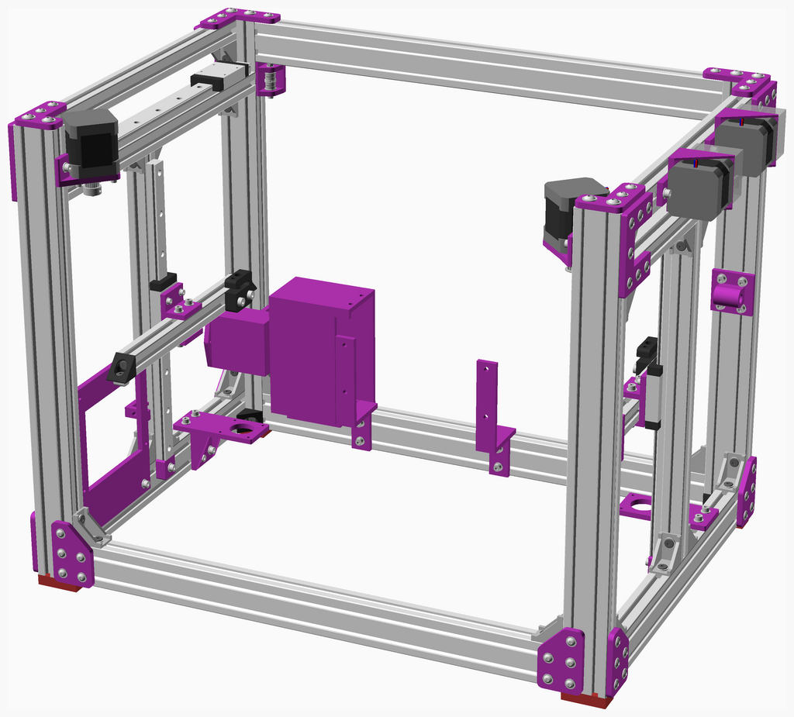
[picture p175: assemblies/frame_assembled.png]
frame_assembled


<span></span>
[Top](#TOP)

---

## Frame With X Rail Assembly
### Vitamins
|Qty|Description|
|---:|:---|
|8| Screw M3 cap x 12mm|
|8| Washer  M3 x 7mm x 0.5mm|

### Sub-assemblies

| 1 x frame_assembly | 1 x xy_combined_assembly |
|---|---|
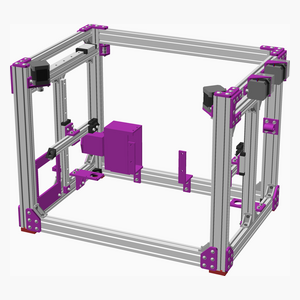
[picture p176: assemblies/frame_assembled_tn.png]
frame_assembled
|  | xy_combined_assembled 

### Assembly instructions
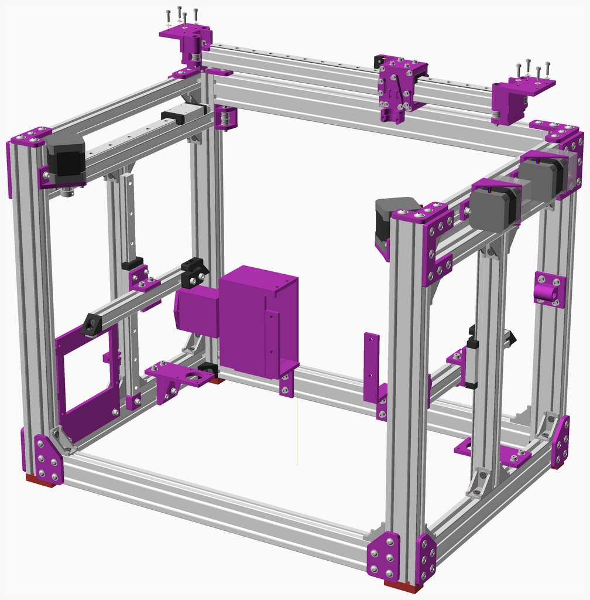
[picture p177: assemblies/frame_with_x_rail_assembly.png]
frame_with_x_rail_assembly


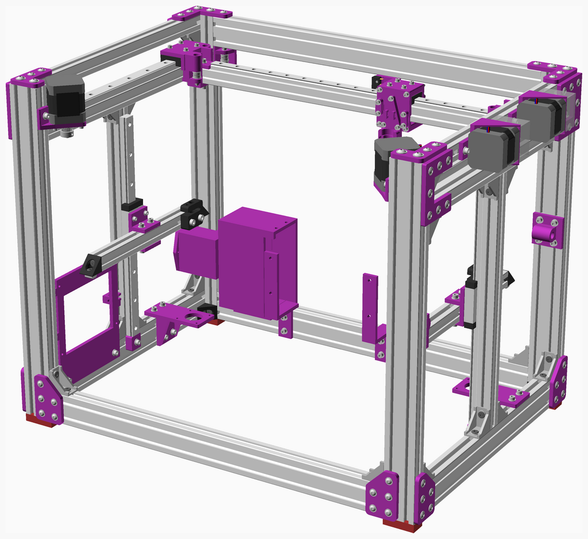
[picture p178: assemblies/frame_with_x_rail_assembled.png]
frame_with_x_rail_assembled


<span></span>
[Top](#TOP)

---

## Frame With Bed Assembly
### Sub-assemblies

| 1 x frame_with_x_rail_assembly | 1 x z_axis_assembly |
|---|---|
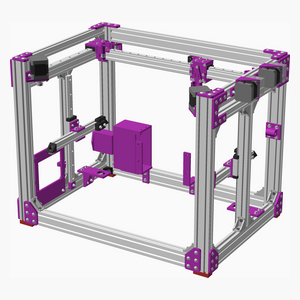
[picture p179: assemblies/frame_with_x_rail_assembled_tn.png]
frame_with_x_rail_assembled
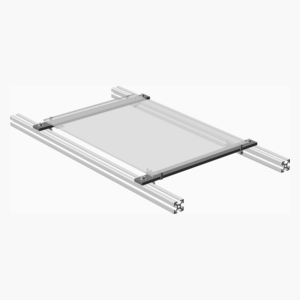
[picture p180: assemblies/z_axis_assembled_tn.png]
z_axis_assembled
|  |  

### Assembly instructions
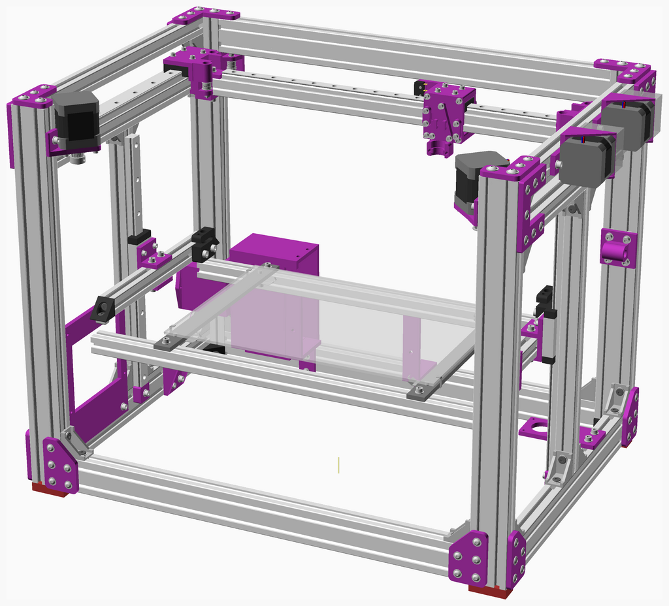
[picture p181: assemblies/frame_with_bed_assembly.png]
frame_with_bed_assembly


Loosen the t-nuts at either end of the z carriage extrusion and slide
one end in then the other.

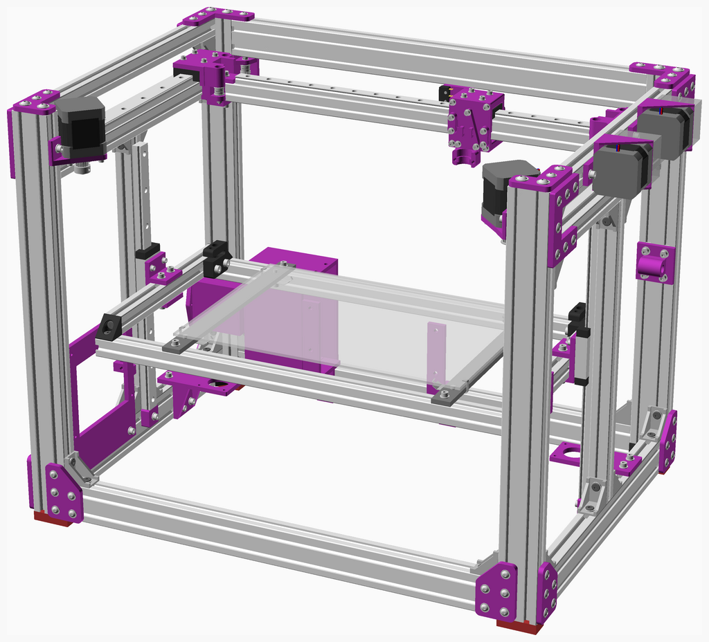
[picture p182: assemblies/frame_with_bed_assembled.png]
frame_with_bed_assembled


<span></span>
[Top](#TOP)

---

## Frame With Spool Holder Assembly
### Vitamins
|Qty|Description|
|---:|:---|
|2| Filament spool 200 x 60|
|4| Nut M8 x 6.5mm |
|4| Washer  M8 x 17mm x 1.6mm|

### Sub-assemblies

| 1 x frame_with_bed_assembly | 2 x spool_rod_assembly |
|---|---|
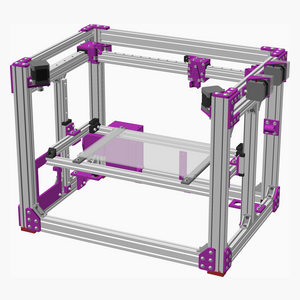
[picture p183: assemblies/frame_with_bed_assembled_tn.png]
frame_with_bed_assembled
|  | spool_rod_assembled 

### Assembly instructions
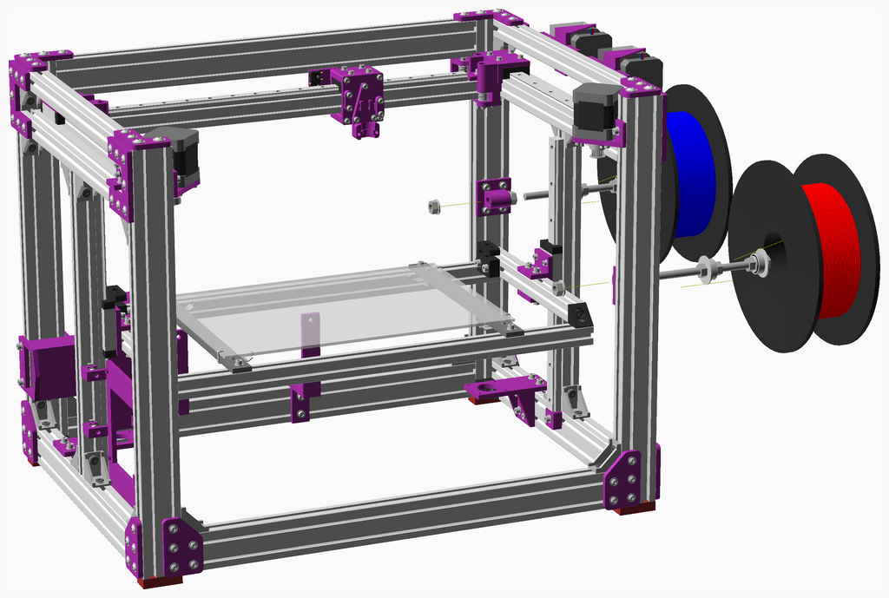
[picture p184: assemblies/frame_with_spool_holder_assembly.png]
frame_with_spool_holder_assembly


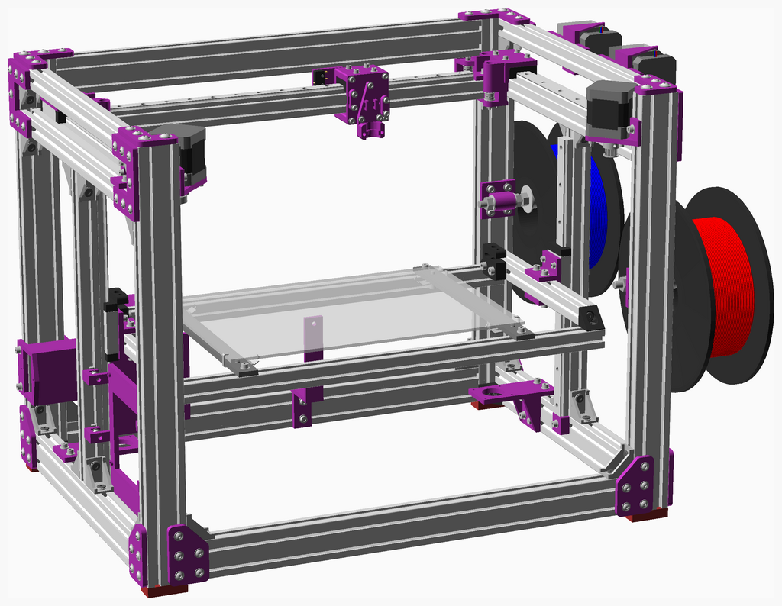
[picture p185: assemblies/frame_with_spool_holder_assembled.png]
frame_with_spool_holder_assembled


<span></span>
[Top](#TOP)

---

## Frame With Z Motor Assembly
### Vitamins
|Qty|Description|
|---:|:---|
|8| Screw M3 cap x 12mm|
|8| Washer  M3 x 7mm x 0.5mm|

### Sub-assemblies

| 1 x frame_with_spool_holder_assembly | 2 x z_motor_assembly |
|---|---|
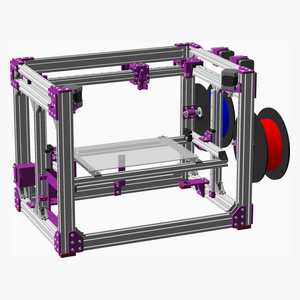
[picture p186: assemblies/frame_with_spool_holder_assembled_tn.png]
frame_with_spool_holder_assembled
|  | z_motor_assembled 

### Assembly instructions
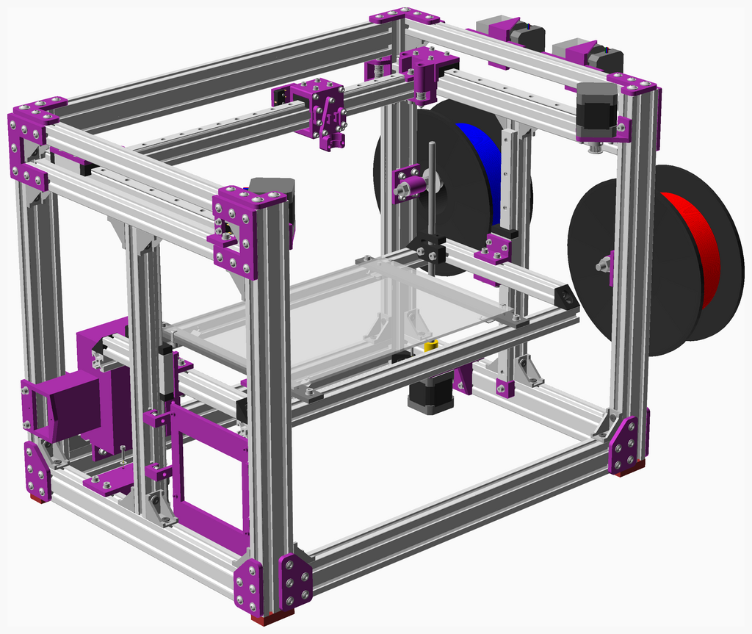
[picture p187: assemblies/frame_with_z_motor_assembly.png]
frame_with_z_motor_assembly


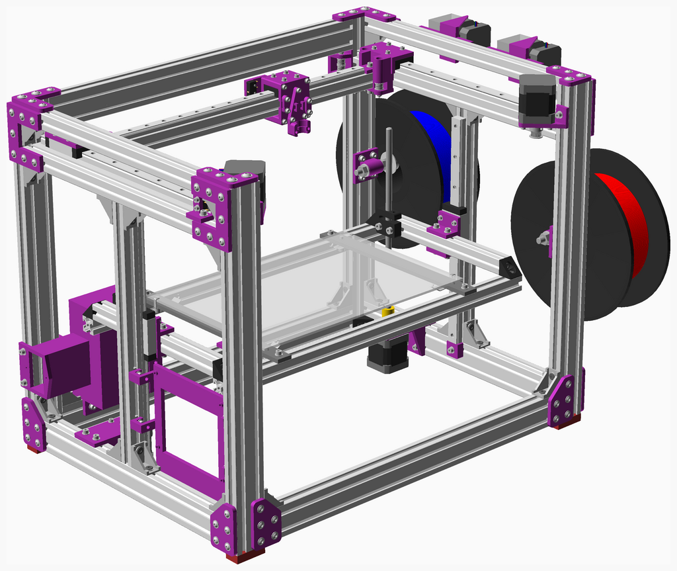
[picture p188: assemblies/frame_with_z_motor_assembled.png]
frame_with_z_motor_assembled


<span></span>
[Top](#TOP)

---

## Hotend Assembly
### Vitamins
|Qty|Description|
|---:|:---|
|1| Fan 30mm x 10mm|
|1| Inductive Probe|
|2| Nut M12 x 4mm |
|2| Nut M3 x 2.4mm |
|2| Screw M3 cap x 40mm|
|4| Washer  M3 x 7mm x 0.5mm|
|2| Washer star M12 x 1mm|

### 3D Printed parts

| 1 x hotend_clamp.stl | 1 x probe_mount.stl |
|---|---|
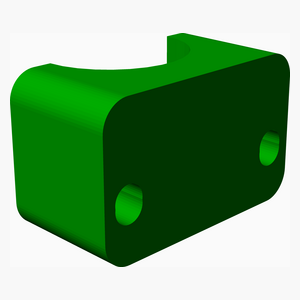
[picture p189: stls/hotend_clamp.png]
hotend_clamp.stl
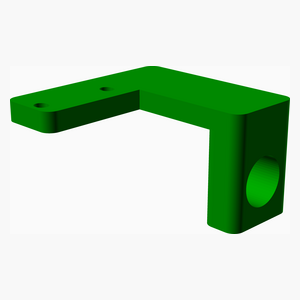
[picture p190: stls/probe_mount.png]
probe_mount.stl
|  |  

### Sub-assemblies

| 1 x duct_assembly | 1 x frame_with_z_motor_assembly |
|---|---|
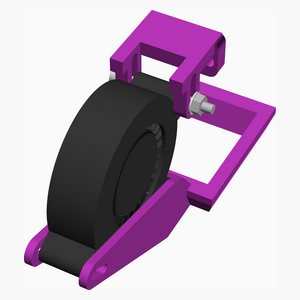
[picture p191: assemblies/duct_assembled_tn.png]
duct_assembled
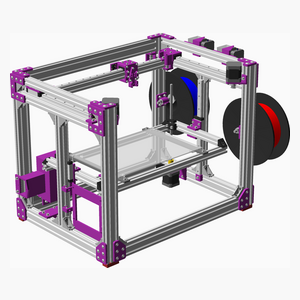
[picture p192: assemblies/frame_with_z_motor_assembled_tn.png]
frame_with_z_motor_assembled
|  |  

### Assembly instructions
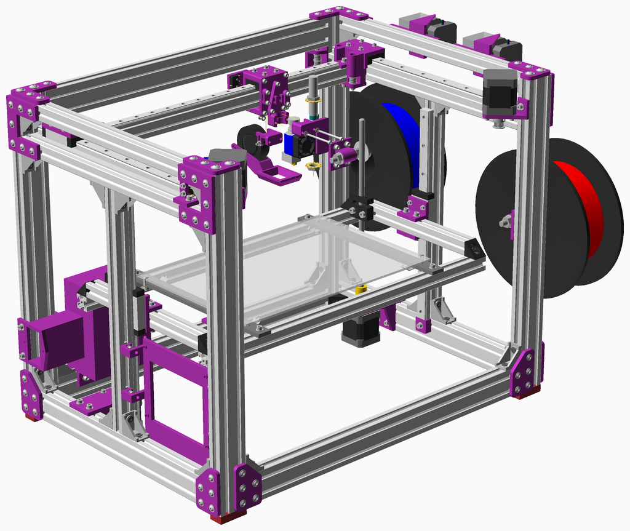
[picture p193: assemblies/hotend_assembly.png]
hotend_assembly


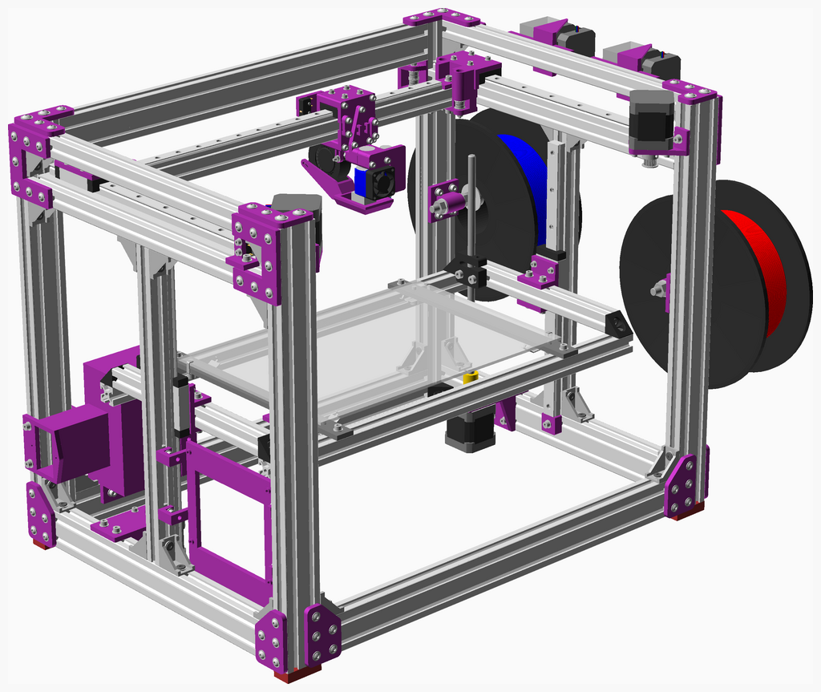
[picture p194: assemblies/hotend_assembled.png]
hotend_assembled


<span></span>
[Top](#TOP)

---

## Belts Assembly
### Vitamins
|Qty|Description|
|---:|:---|
|1| GT2 1601.66|
|1| GT2 1609.36|

### Sub-assemblies

| 1 x hotend_assembly |
|---|
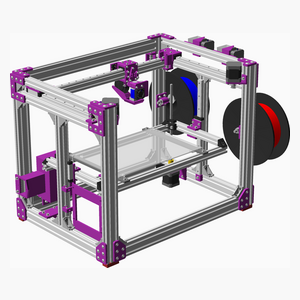
[picture p195: assemblies/hotend_assembled_tn.png]
hotend_assembled
|  

### Assembly instructions
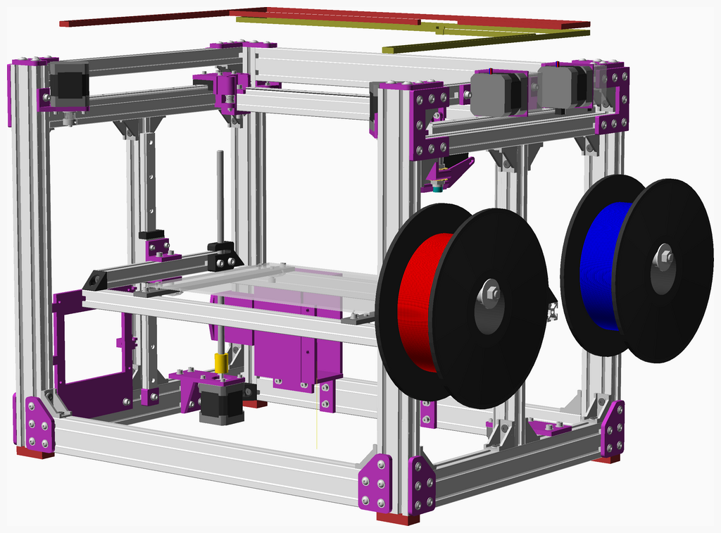
[picture p196: assemblies/belts_assembly.png]
belts_assembly


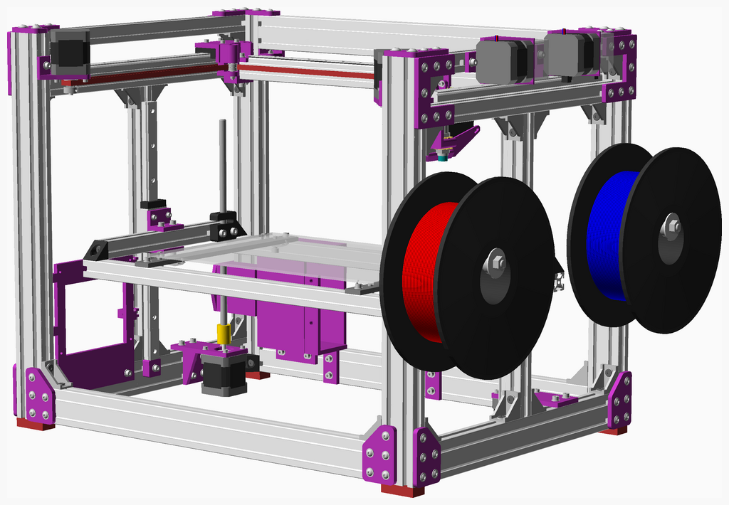
[picture p197: assemblies/belts_assembled.png]
belts_assembled


<span></span>
[Top](#TOP)

---

## Socket Assembly
### Vitamins
|Qty|Description|
|---:|:---|
|1| IEC320 C14 switched fused inlet module|
|2| Screw M3 cs cap x  6mm|

### Sub-assemblies

| 1 x belts_assembly |
|---|
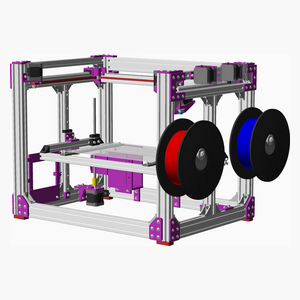
[picture p198: assemblies/belts_assembled_tn.png]
belts_assembled
|  

### Assembly instructions
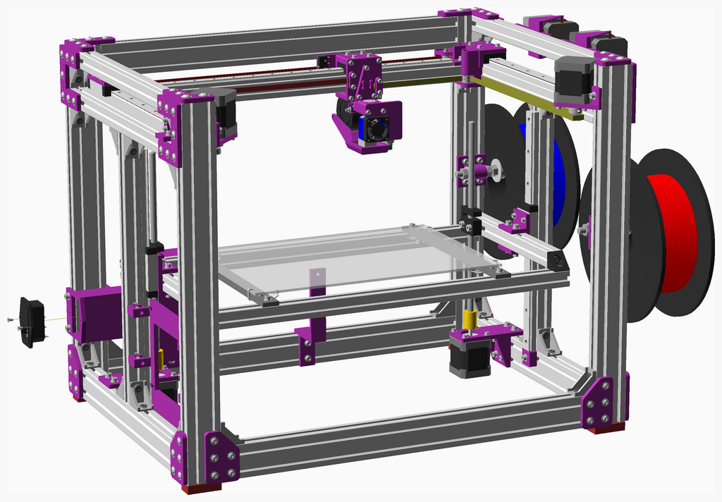
[picture p199: assemblies/socket_assembly.png]
socket_assembly


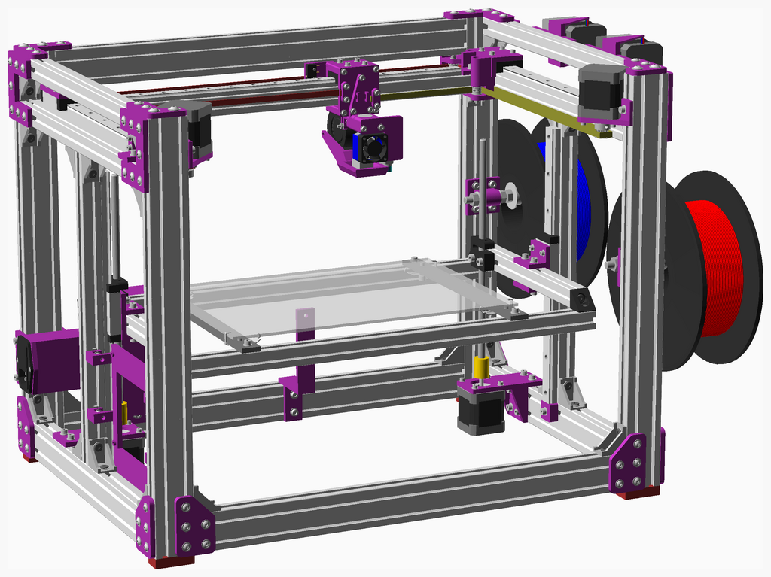
[picture p200: assemblies/socket_assembled.png]
socket_assembled


<span></span>
[Top](#TOP)

---

## Duet Assembly
### Vitamins
|Qty|Description|
|---:|:---|
|1| Cat 5 patch cable 300mm|
|1| Duet 2 Ethernet electronics|
|1| Micro SD card|
|4| Nut M3 x 2.4mm |
|4| Screw M3 cap x 10mm|
|8| Washer  M3 x 7mm x 0.5mm|

### Sub-assemblies

| 1 x socket_assembly |
|---|
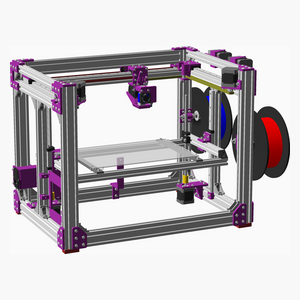
[picture p201: assemblies/socket_assembled_tn.png]
socket_assembled
|  

### Assembly instructions
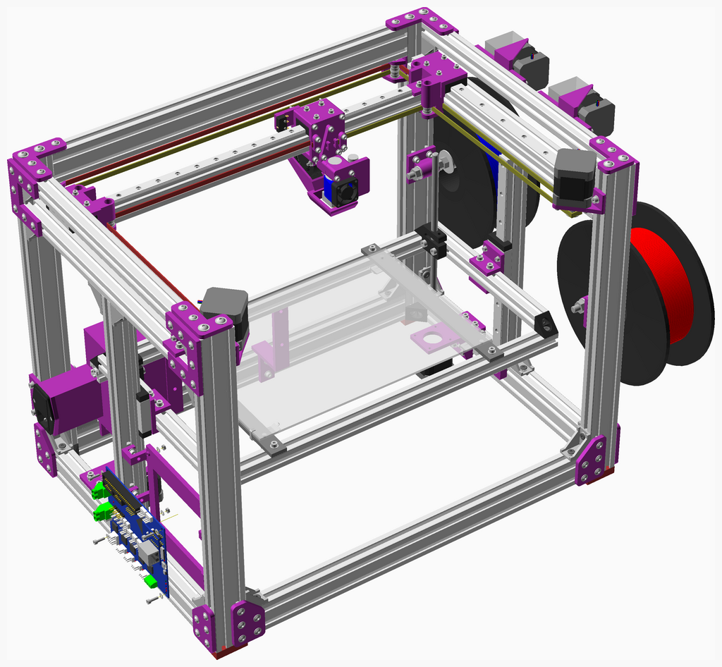
[picture p202: assemblies/duet_assembly.png]
duet_assembly


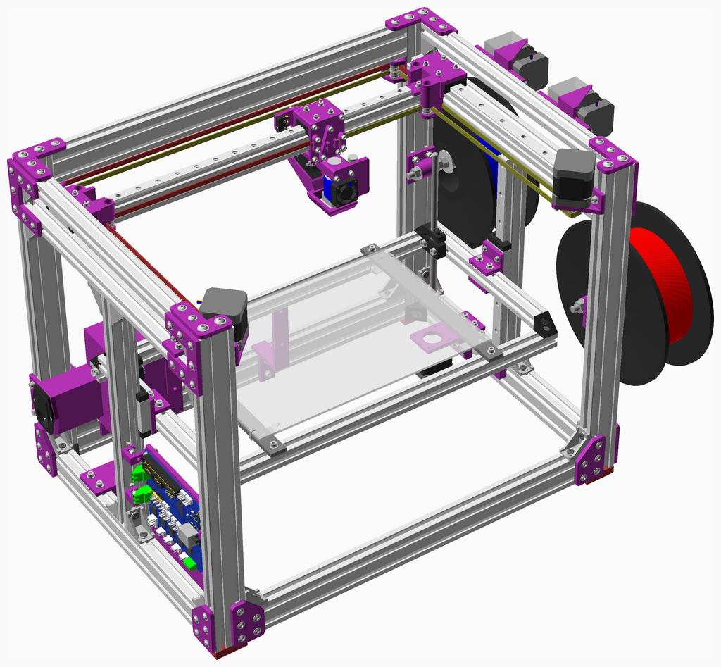
[picture p203: assemblies/duet_assembled.png]
duet_assembled


<span></span>
[Top](#TOP)

---

## Main Assembly
### Vitamins
|Qty|Description|
|---:|:---|
|1| PSU S-300-12|
|4| Screw M4 cap x  8mm|
|4| Screw M4 cap x 10mm|
|8| Washer  M4 x 9mm x 0.8mm|

### Sub-assemblies

| 1 x duet_assembly |
|---|
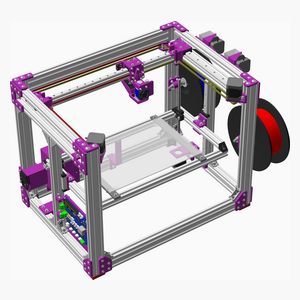
[picture p204: assemblies/duet_assembled_tn.png]
duet_assembled
|  

### Assembly instructions
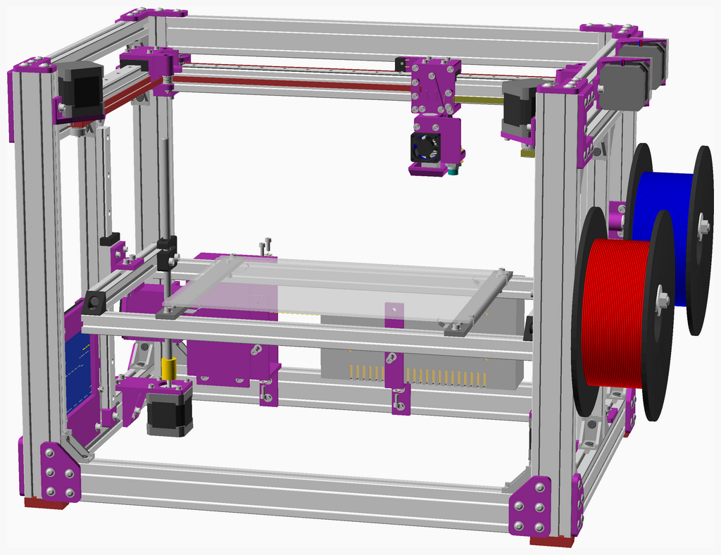
[picture p205: assemblies/main_assembly.png]
main_assembly


Insert PSU

main_assembled

<span></span>
[Top](#TOP)
