beanz/m-bot-scad/scad/vitamins/e3d/V6.6_Duct.stl

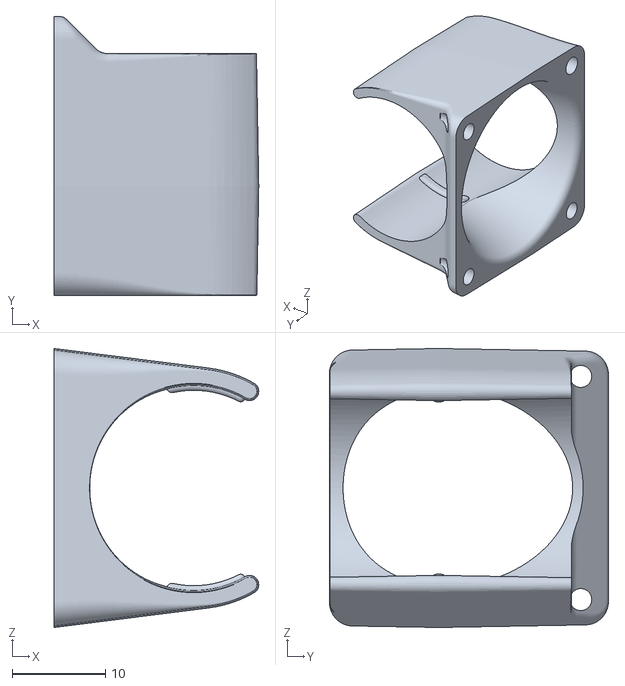
[picture p206: CAD file, 2020-08-26]
scad/vitamins/e3d/V6.6_Duct.stl
22.0 x 30.0 x 30.0
