beanz/m-bot-scad/stls/belt_clamp.stl

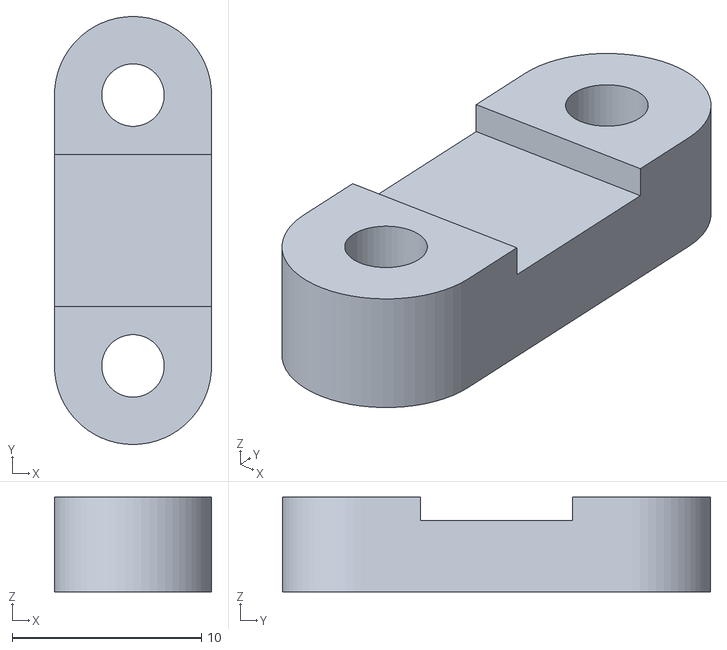
[picture p207: CAD file, 2023-09-02]
stls/belt_clamp.stl
8.30 x 22.6 x 5.00
