beanz/m-bot-scad/scad/ooznest/90-degree-corner_VSLOT-B-90AC.stl

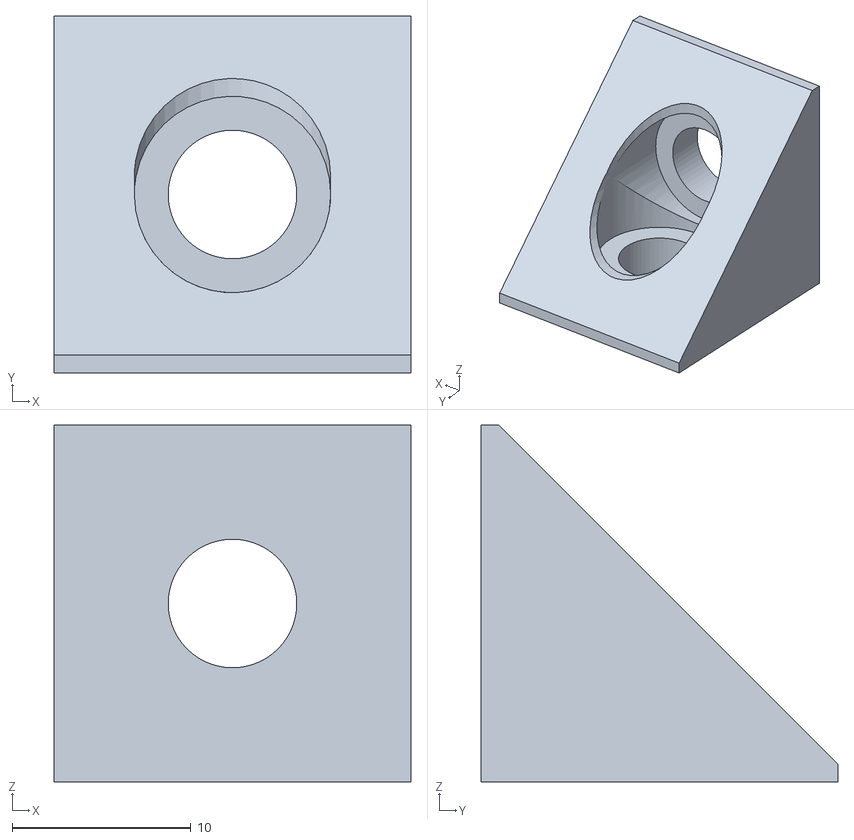
[picture p208: CAD file, 2020-08-26]
scad/ooznest/90-degree-corner_VSLOT-B-90AC.stl
20.0 x 20.0 x 20.0
