beanz/m-bot-scad/stls/x_endstop_mount.stl

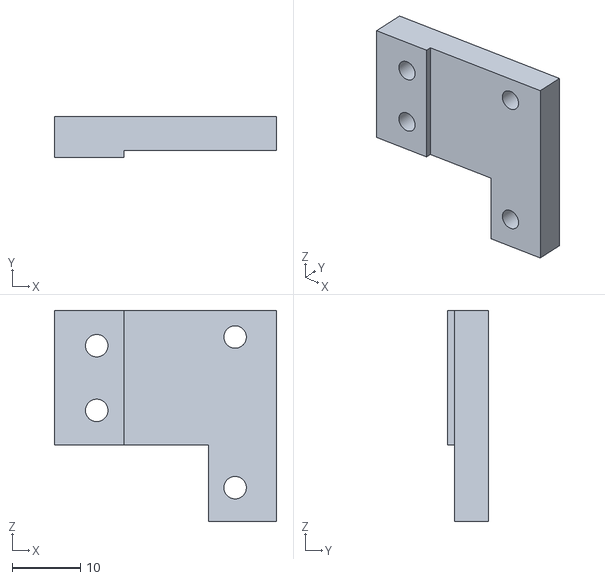
[picture p209: CAD file, 2023-09-02]
stls/x_endstop_mount.stl
32.6 x 6.00 x 31.0
