beanz/m-bot-scad/stls/hotend_clamp.stl

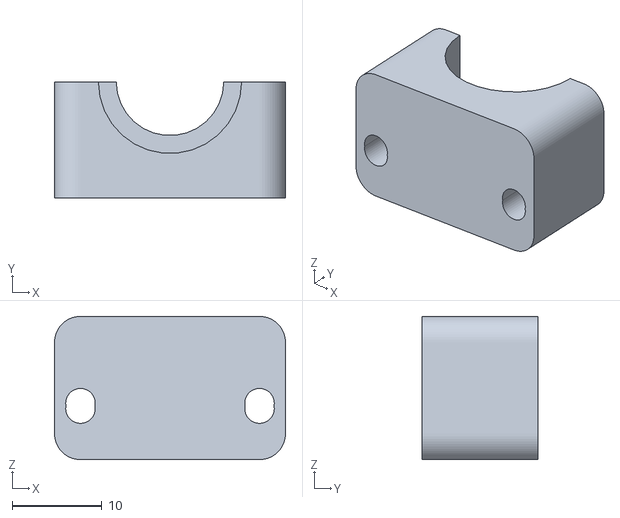
[picture p210: CAD file, 2023-09-02]
stls/hotend_clamp.stl
25.8 x 13.0 x 16.0
