beanz/m-bot-scad/stls/right_motor_mount.stl

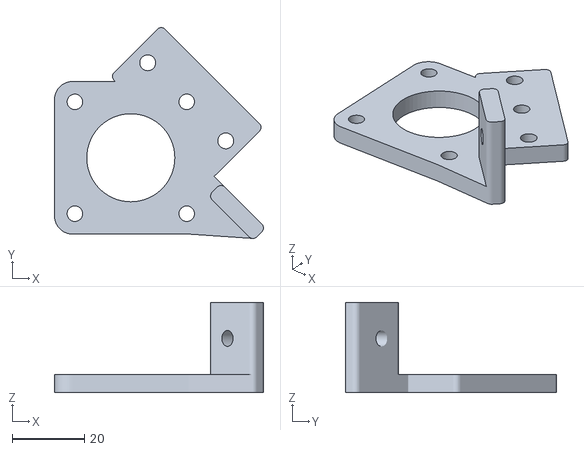
[picture p211: CAD file, 2023-09-02]
stls/right_motor_mount.stl
57.9 x 58.4 x 25.0
