beanz/m-bot-scad/stls/front_top_corner.stl

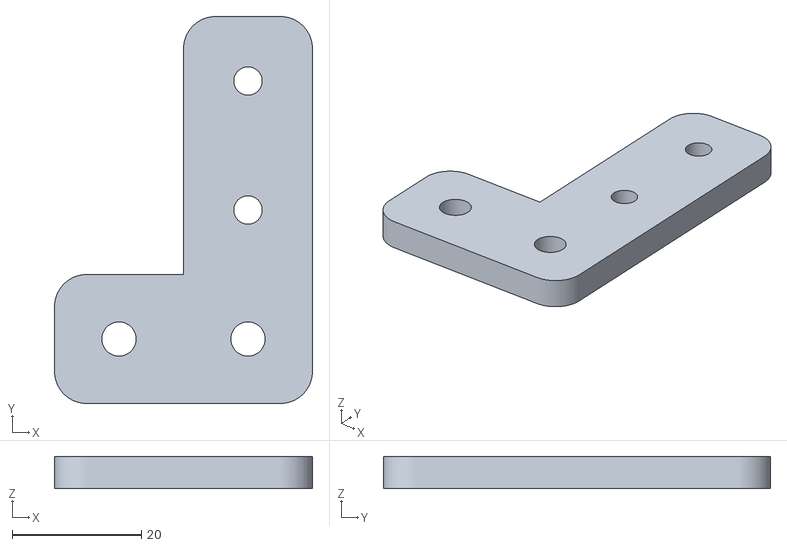
[picture p212: CAD file, 2023-09-02]
stls/front_top_corner.stl
40.0 x 60.0 x 5.00
