beanz/m-bot-scad/stls/duct_mount.stl

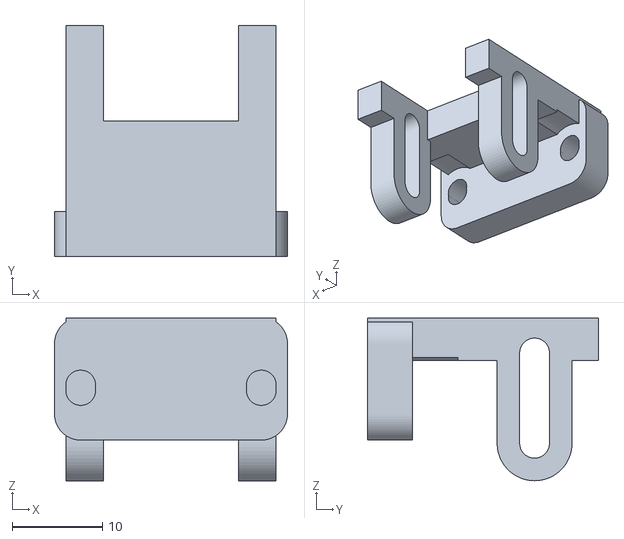
[picture p213: CAD file, 2023-09-02]
stls/duct_mount.stl
25.8 x 25.6 x 18.0
