beanz/m-bot-scad/stls/side_top_corner.stl

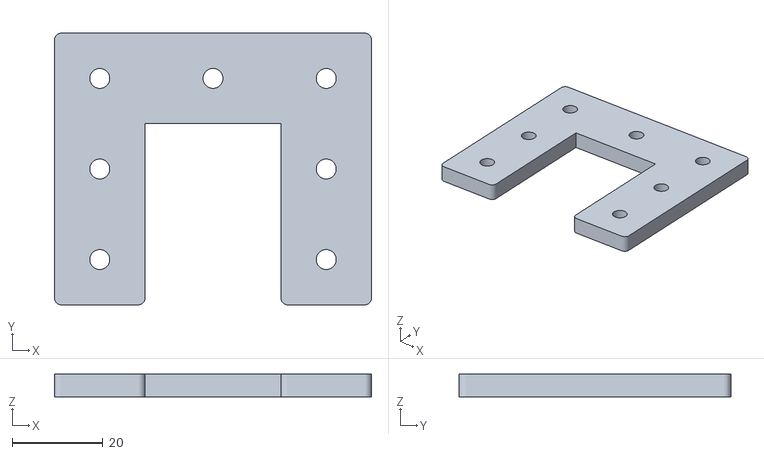
[picture p214: CAD file, 2023-09-02]
stls/side_top_corner.stl
70.0 x 60.0 x 5.00
