beanz/m-bot-scad/stls/hotend_mount.stl

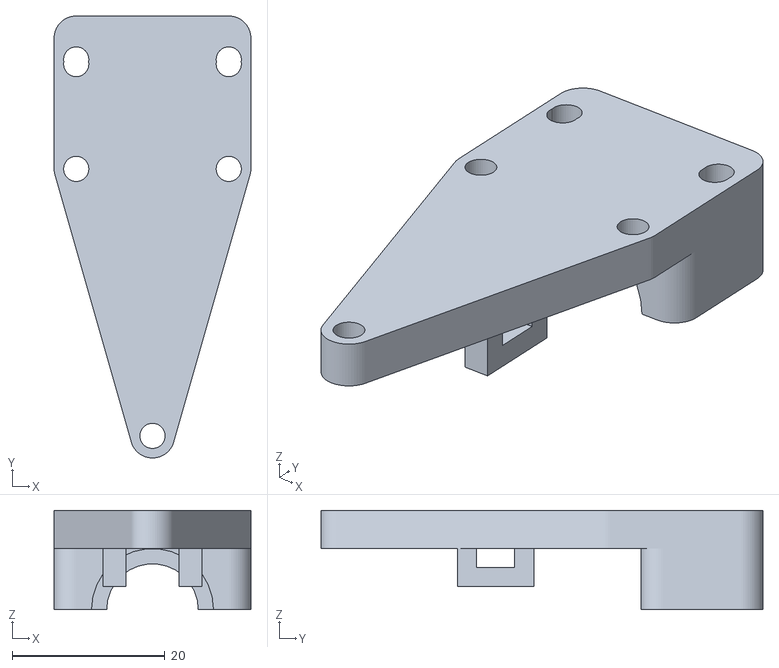
[picture p215: CAD file, 2023-09-02]
stls/hotend_mount.stl
25.8 x 57.9 x 13.0
