beanz/m-bot-scad/stls/titan_mount.stl

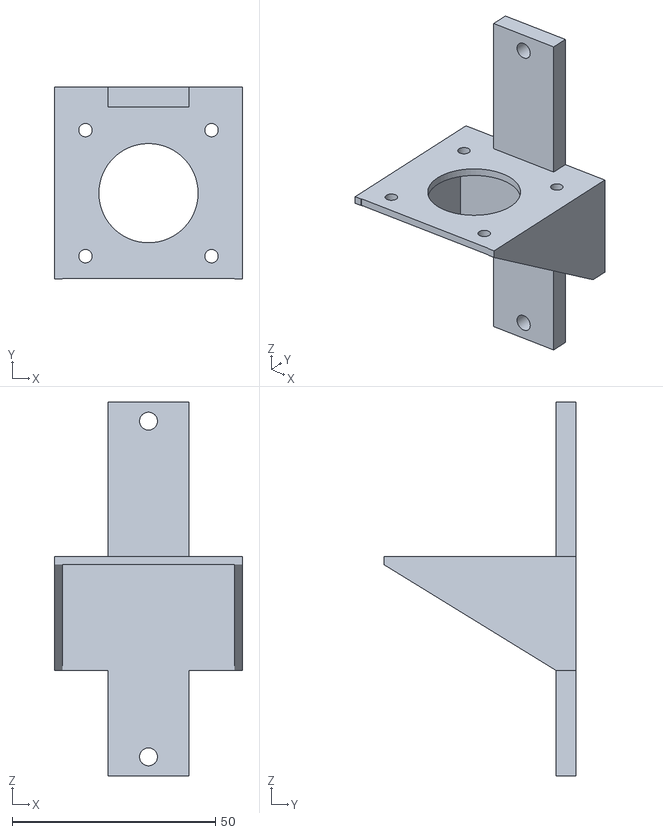
[picture p216: CAD file, 2023-09-02]
stls/titan_mount.stl
46.3 x 47.3 x 92.0
