beanz/m-bot-scad/stls/duet_mount.stl

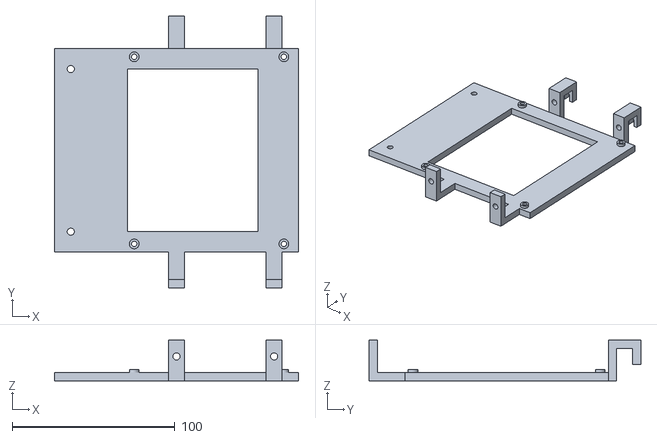
[picture p217: CAD file, 2023-09-02]
stls/duet_mount.stl
150.0 x 167.0 x 25.0
