beanz/m-bot-scad/stls/x_carriage_front.stl

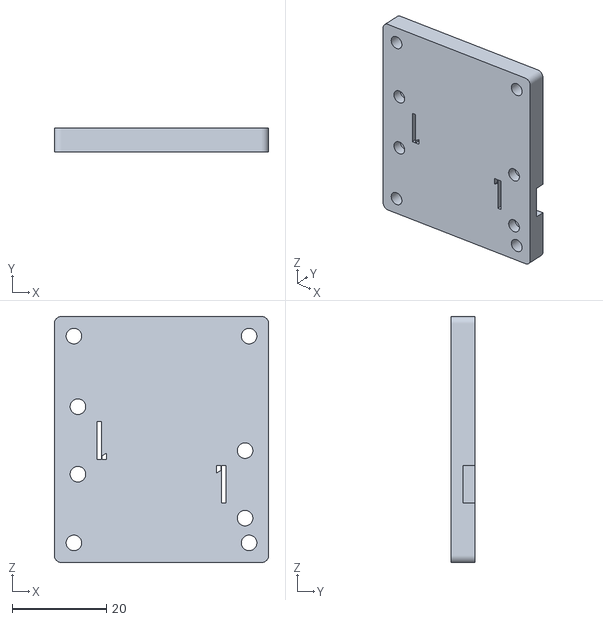
[picture p218: CAD file, 2023-09-02]
stls/x_carriage_front.stl
45.4 x 5.00 x 52.1
