beanz/m-bot-scad/stls/duct.stl

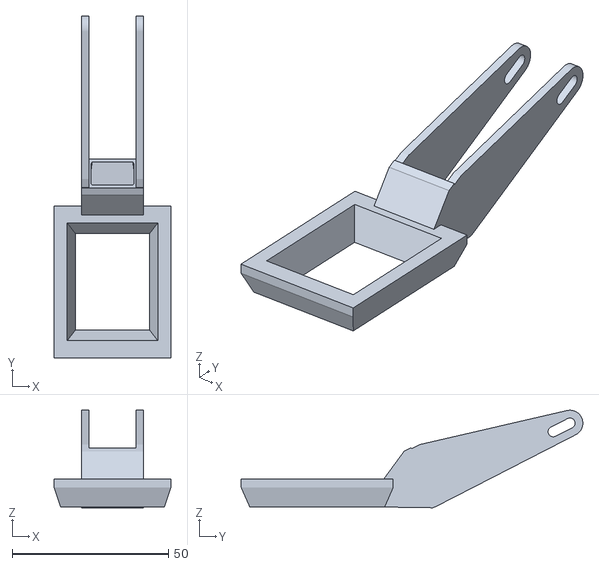
[picture p219: CAD file, 2023-09-02]
stls/duct.stl
37.5 x 109.5 x 31.3
