beanz/m-bot-scad/stls/x_carriage_mount.stl

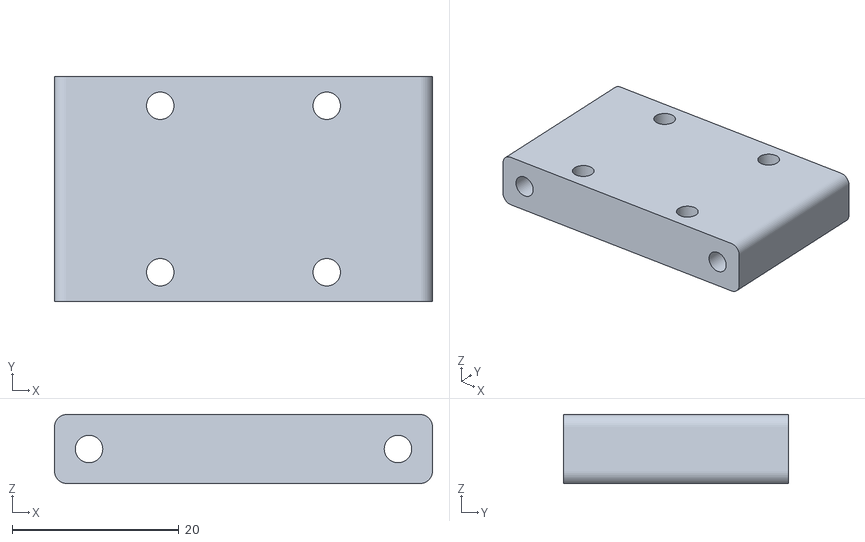
[picture p220: CAD file, 2023-09-02]
stls/x_carriage_mount.stl
45.4 x 27.0 x 8.29
