beanz/m-bot-scad/stls/rail_guard.stl

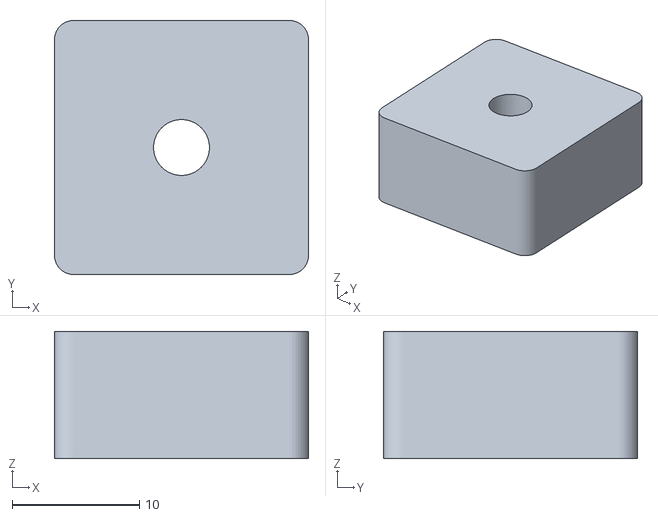
[picture p221: CAD file, 2023-09-02]
stls/rail_guard.stl
20.0 x 20.0 x 10.0
