beanz/m-bot-scad/stls/spool_rod_holder.stl

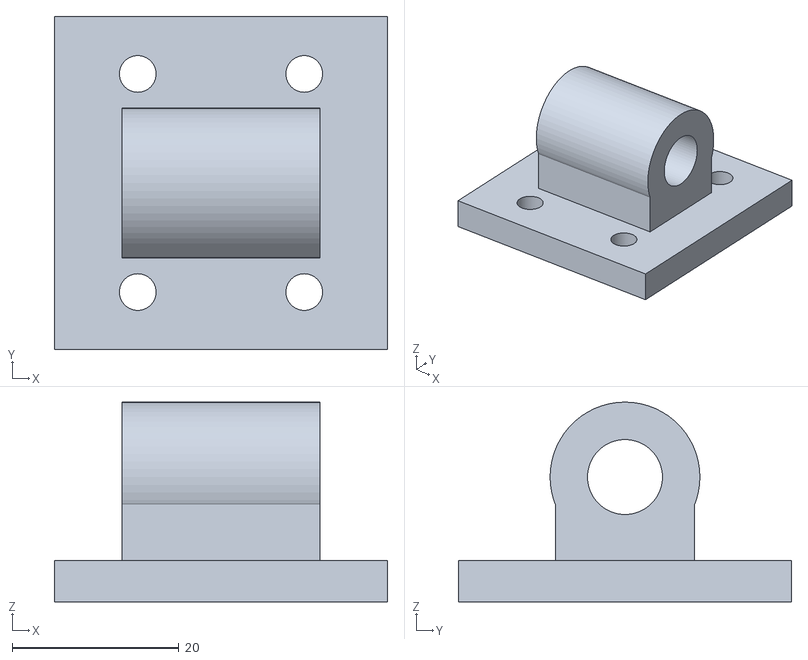
[picture p222: CAD file, 2023-09-02]
stls/spool_rod_holder.stl
40.0 x 40.0 x 24.0
