beanz/m-bot-scad/stls/right_y_carriage.stl

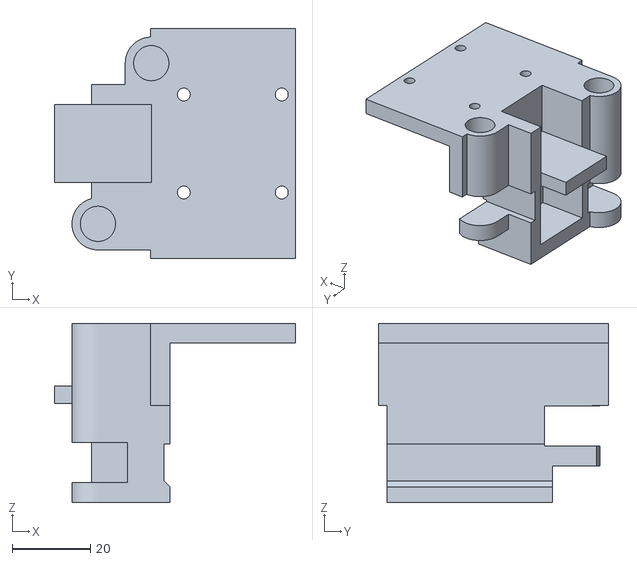
[picture p223: CAD file, 2023-09-02]
stls/right_y_carriage.stl
61.5 x 58.8 x 45.8
