beanz/m-bot-scad/stls/foot.stl

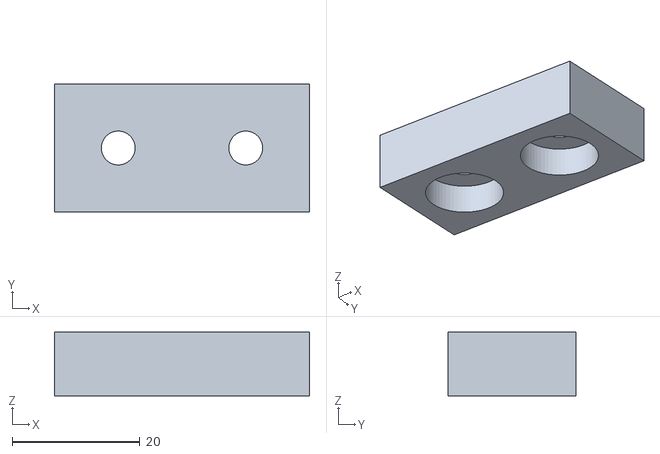
[picture p224: CAD file, 2023-09-02]
stls/foot.stl
40.0 x 20.0 x 10.0
