beanz/m-bot-scad/stls/probe_mount.stl

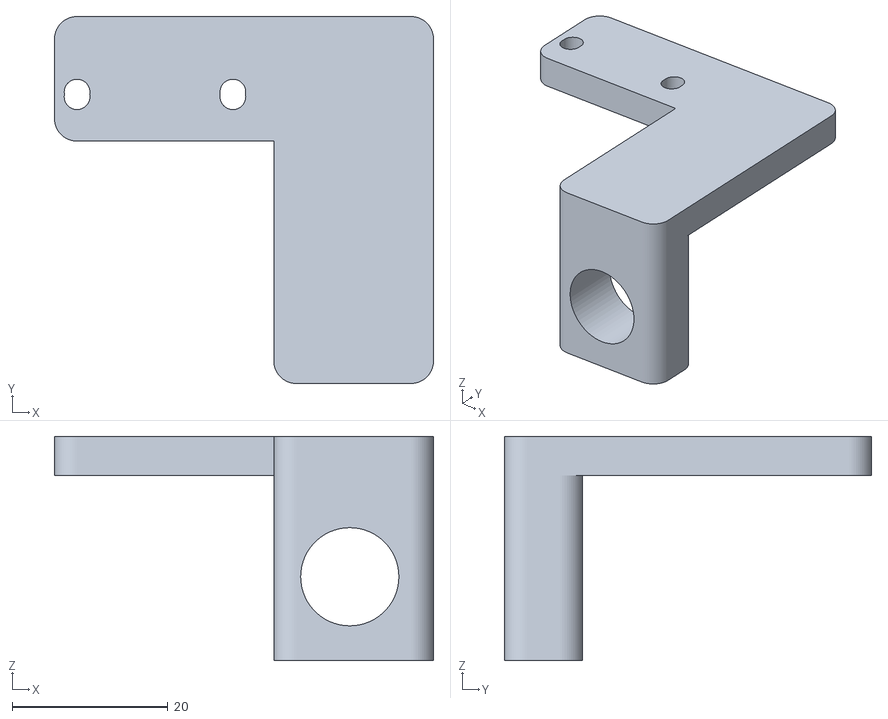
[picture p225: CAD file, 2023-09-02]
stls/probe_mount.stl
48.6 x 47.1 x 28.8
