beanz/m-bot-scad/stls/z_rail_mount.stl

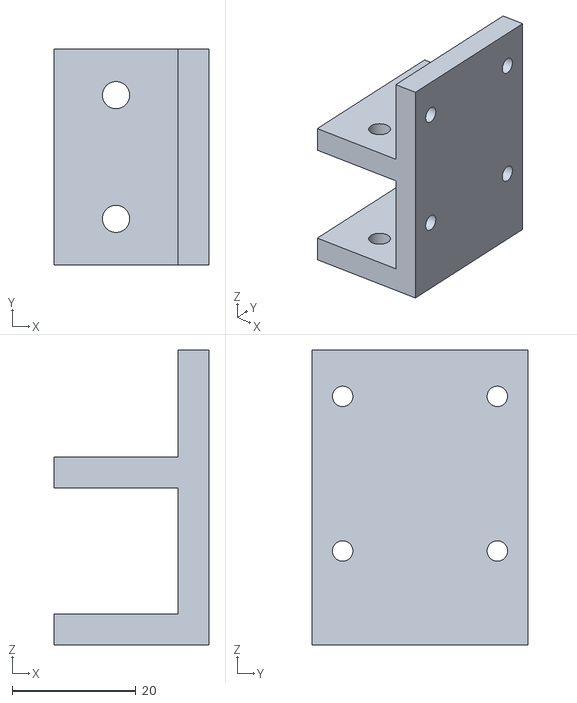
[picture p226: CAD file, 2023-09-02]
stls/z_rail_mount.stl
25.0 x 35.0 x 47.7
