beanz/m-bot-scad/stls/psu_mount.stl

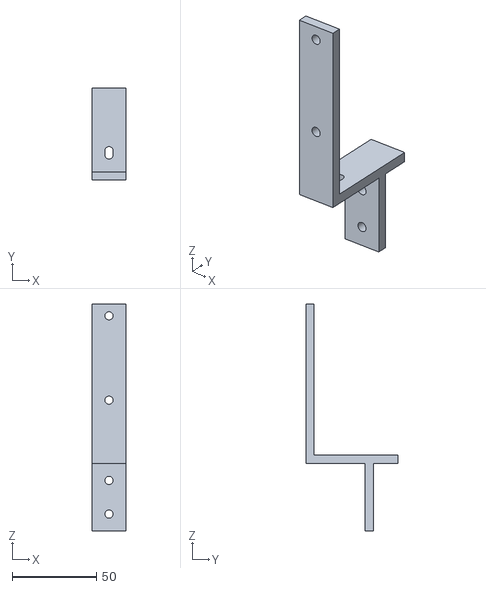
[picture p227: CAD file, 2023-09-02]
stls/psu_mount.stl
20.0 x 54.8 x 134.5
