beanz/m-bot-scad/stls/z_motor_mount.stl

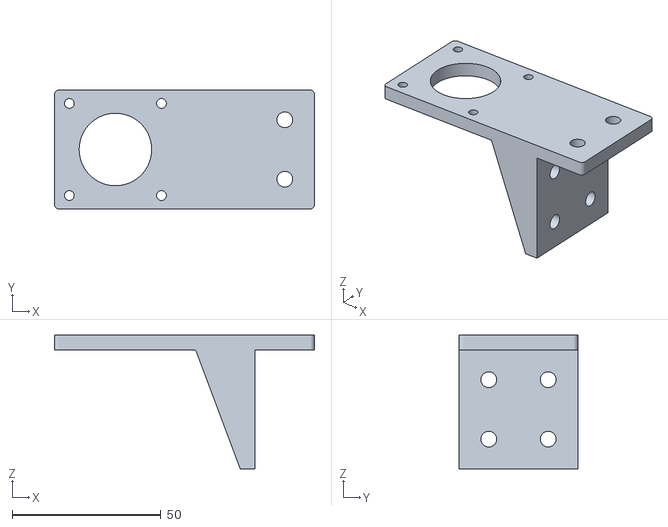
[picture p228: CAD file, 2023-09-02]
stls/z_motor_mount.stl
87.5 x 40.0 x 45.0
