beanz/m-bot-scad/stls/y_endstop_mount.stl

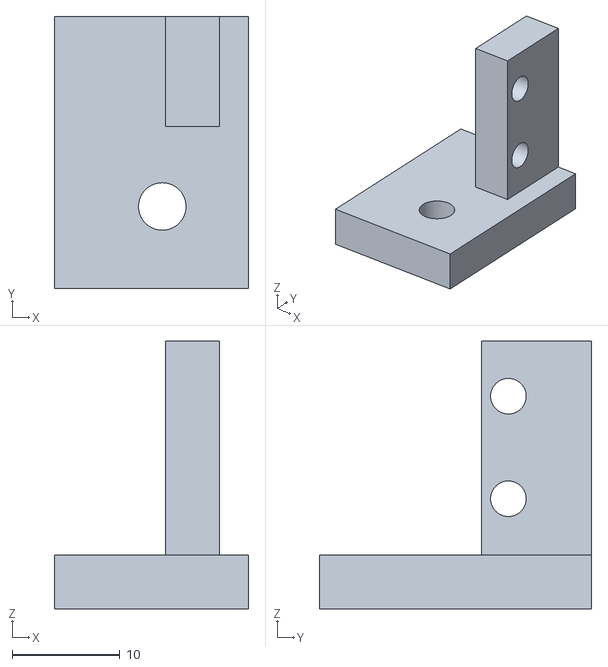
[picture p229: CAD file, 2023-09-02]
stls/y_endstop_mount.stl
18.0 x 25.2 x 24.8
