beanz/m-bot-scad/stls/iec_socket_mount.stl

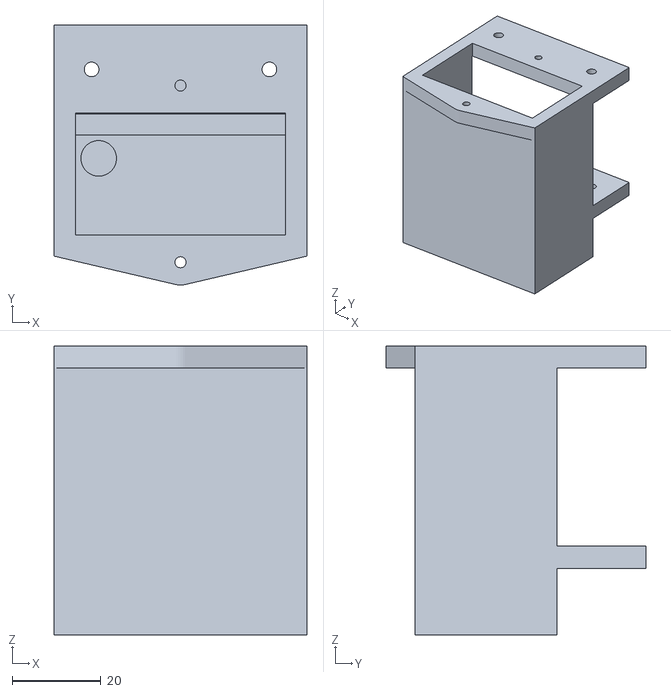
[picture p230: CAD file, 2023-09-02]
stls/iec_socket_mount.stl
56.8 x 58.5 x 65.0
