beanz/m-bot-scad/stls/right_idler.stl

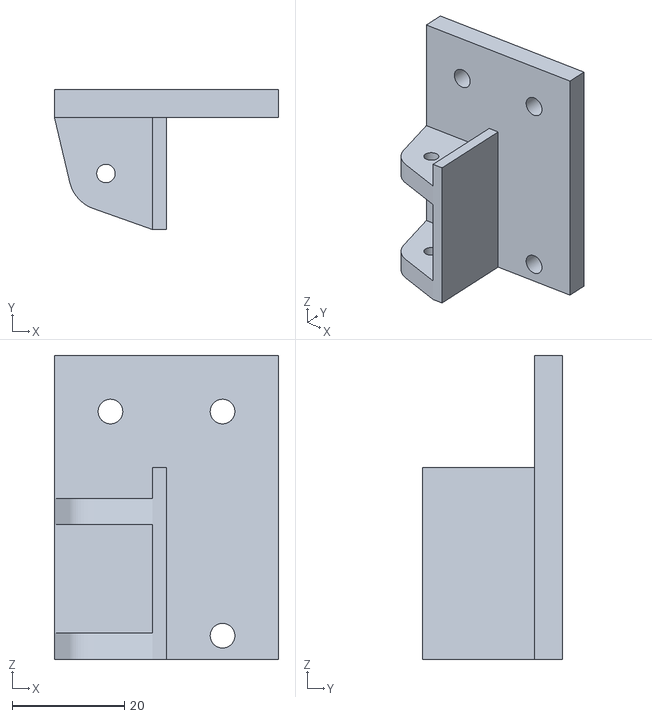
[picture p231: CAD file, 2023-09-02]
stls/right_idler.stl
40.0 x 25.0 x 54.2
