beanz/m-bot-scad/stls/back_top_corner.stl

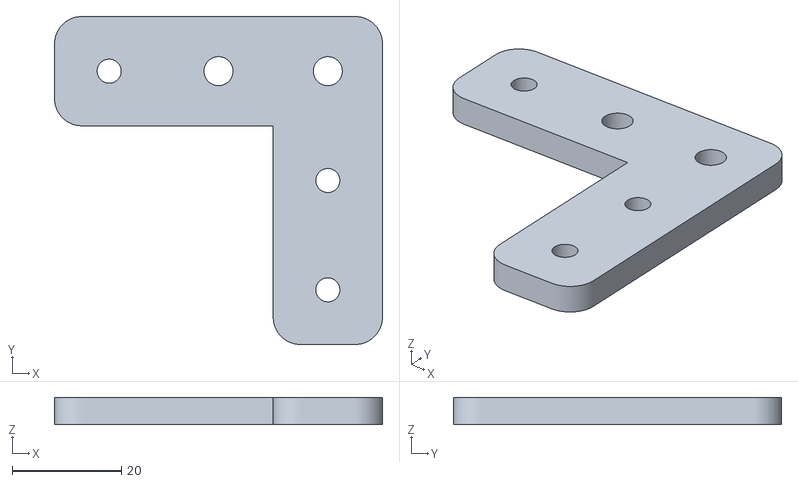
[picture p232: CAD file, 2023-09-02]
stls/back_top_corner.stl
60.0 x 60.0 x 5.00
