beanz/m-bot-scad/stls/bottom_corner.stl

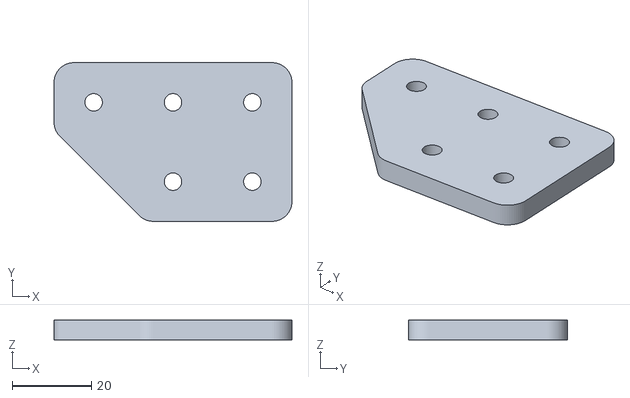
[picture p233: CAD file, 2023-09-02]
stls/bottom_corner.stl
60.0 x 40.0 x 5.00
