beanz/m-bot-scad/stls/psu_cover.stl

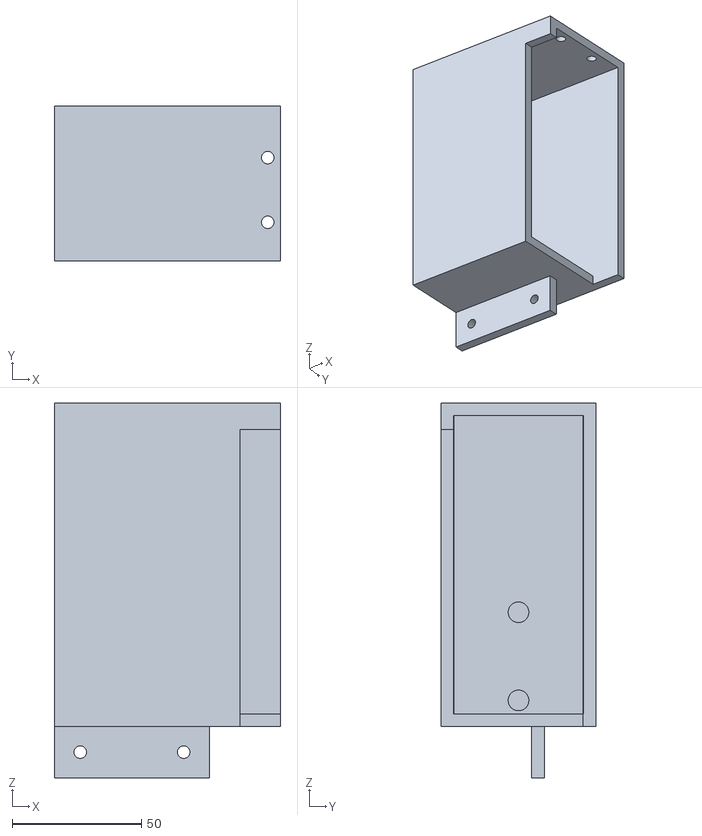
[picture p234: CAD file, 2023-09-02]
stls/psu_cover.stl
87.5 x 60.0 x 145.0
