beanz/m-bot-scad/scad/frame.scad

include <conf.scad>
include <lazy.scad>
include <shapes.scad>

use <common.scad>
use <corners.scad>
use <spool-holder.scad>
use <left-frame.scad>
use <right-frame.scad>
use <x-axis.scad>
use <y-axis.scad>
use <z-axis.scad>
use <electronics.scad>
use <xy-motor.scad>
use <titan-mount.scad>
use <rail-guard.scad>

module right_end_with_z_carriage_rail_assembly()
    pose([59.5, 0, 314.5], [71.76, 71.11, 146.26])
    assembly("right_end_with_z_carriage_rail") {
  right_end_frame_assembly();
  txz(-ew/2, (ph-pos[2])+z_offset+ew*2) {
    z_carriage_rail_assembly();
  }
}

module left_end_with_z_carriage_rail_assembly()
    pose([57.4, 0, 35], [13.22, 116.53, 160.49])
    assembly("left_end_with_z_carriage_rail") {
  left_end_frame_assembly();
  txz(ew/2, (ph-pos[2])+z_offset+ew*2) {
    mirror([1, 0, 0]) z_carriage_rail_assembly();
  }
}

module right_end_frame_assembly()
    pose([59.2, 0, 307], [-114.19, -201.17, 107.06])
    assembly("right_end_frame") {
  explode([0, 0, -fh-50]) {
    right_front_upright_assembly();
  }
  txyz(-ew, -fd/2+ew/2, fh+th) {
    myz(ew/2) {
      screw(ex_tap_screw, 12);
    }
  }
  right_central_and_rear_assembly();
}

module left_end_frame_assembly()
    pose([60.6, 0, 40.8], [-89.82, -223.04, 49.42])
    assembly("left_end_frame") {
  explode([0, 0, -fh-50]) {
    left_front_upright_assembly();
  }
  txyz(ew, -fd/2+ew/2, fh+th) {
    myz(ew/2) {
      screw(ex_tap_screw, 12);
    }
  }
  left_central_and_rear_assembly();
}

module right_central_and_rear_assembly()
    pose([34.7, 0, 292.3], [53.05, 111.09, -113.35])
    assembly("right_central_and_rear") {
  explode([0, 0, -fh-50], offset = [-ew, fd/2-ew/2, fh/2]) {
    right_rear_upright_assembly();
  }
  right_central_end_assembly();
  txyz(-ew, fd/2-ew/2, fh+th) {
    myz(ew/2) {
      screw(ex_tap_screw, 12);
    }
  }
}

module left_central_and_rear_assembly()
    pose([59.2, 0, 211.1], [-99.86, 168.58, 89.53])
    assembly("left_central_and_rear") {
  explode([0, 0, -fh-50], offset = [ew, fd/2-ew/2, fh/2]) {
    left_rear_upright_assembly();
  }
  left_central_end_assembly();
  txyz(-th, fd/2-ew-iec_socket_cut_out_h()/2, ew2+psu_w/2+th) {
    explode([0, -50, 0], offset = [ew+th, 0, 0], true) {
      ry(-90) socket_mount_assembly();
    }
  }
  txyz(ew, fd/2-ew/2, fh+th) {
    myz(ew/2) {
      screw(ex_tap_screw, 12);
    }
  }
}

module right_central_end_assembly()
    pose([63.7, 0, 320.6], [-92.29, -25.31, 289.37])
    assembly("right_central_end") {
  right_lower_end_with_z_assembly();
  explode([0, fd*0.7, 0], offset = [0, 0, fh-ew2]) right_upper_end_assembly();
  txyz(-ew/2, -(fd/2-ew), y_bar_h-ew) {
    ry(90) cast_corner_bracket_assembly();
  }
}

module left_central_end_assembly()
    pose([65.8, 0, 114.8], [36.16, 78.88, 294.35])
    assembly("left_central_end") {
  left_lower_end_with_z_assembly();
  explode([0, fd*0.7, 0], offset = [0, 0, fh-ew2]) left_upper_end_assembly();
  txyz(ew/2, -(fd/2-ew), y_bar_h-ew) {
    ry(90) cast_corner_bracket_assembly();
  }
}

module right_upper_end_assembly()
    pose([53.2, 0, 319.4], [150.37, 200.95, 225.02])
    assembly("right_upper_end") {
  txz(-ew, y_bar_h) right_y_rail_assembly();
  txz(-ew/2, fh-ew/2) {
    rx(90) {
      extrusion(e2020, fd-ew*2);
    }
    mxz(fd/2-ew) {
      tz(-ew/2) {
        explode([0, 140, 0]) rz(180) ry(90) cast_corner_bracket_assembly();
      }
    }
  }
  mxz(fd/2) {
    tyz(-ew*1.5, fh-ew*1.75) ry(90) {
      explode([0, 180, 0]) {
        side_top_corner_assembly();
      }
    }
  }
  txyz(-ew/2, fd/2-ew/2, fh) explode([0, 180, 0])
    right_back_top_corner_assembly();
  txyz(-ew/2, -fd/2+ew/2, fh) explode([0, -180, 0])
    right_front_top_corner_assembly();

  tyz(-60, fh-ew/2) explode([0, -180, 0]) {
    ry(90) rx(-90) titan_mount_assembly();
  }
  tyz(60, fh-ew/2) explode([0, 180, 0]) {
    ry(90) rx(-90) titan_mount_assembly();
  }
}

module left_upper_end_assembly()
  pose([61.6, 0, 49.7], [-9.05, 20.89, 393.67]) assembly("left_upper_end") {
  txz(ew, y_bar_h) left_y_rail_assembly();
  txz(ew/2, fh-ew/2) {
    rx(90) {
      extrusion(e2020, fd-ew*2);
    }
    mxz(fd/2-ew) {
      tz(-ew/2) {
        explode([0, 50, 0]) rz(180) ry(90) cast_corner_bracket_assembly();
      }
    }
  }
  mxz(fd/2) {
    tyz(ew*1.5, fh-ew*1.75) ry(90) {
      explode([0, 90, 0]) {
        ty(-ew*3) ry(180) {
          side_top_corner_assembly();
        }
      }
    }
  }
  txyz(ew/2, fd/2-ew/2, fh) {
    explode([0, 140, 0]) left_back_top_corner_assembly();
  }
  txyz(ew/2, -fd/2+ew/2, fh) {
    explode([0, -140, 0]) left_front_top_corner_assembly();
  }
}

module right_lower_end_with_z_assembly()
    pose([63.7, 0, 218.8], [-51.59, -28.97, 194.08])
    assembly("right_lower_end_with_z") {
  right_lower_end_assembly();
  explode([0, -fw*0.4, 0], offset = [0, 0, ew]) {
    tx(-ew) right_z_axis_rail_assembly();
  }
  txyz(-ew/2, -fd/2+ew, ew2) {
    explode([0, -140, 0], offset = [0, -10, 10]) {
      ry(-90) cast_corner_bracket_assembly();
    }
  }
  tz(ew) {
    ty(fd/2-ew) {
      explode([0, 40, 0]) ry(90) bottom_corner_assembly();
    }
    ty(-(fd/2-ew)) {
      explode([0, -fd/2+20, 0]) ry(90) {
        reversed_bottom_corner_assembly();
      }
    }
  }
}

module left_lower_end_with_z_assembly()
    pose([68.6, 0, 37.1], [142.98, -245.36, 194.7])
    assembly("left_lower_end_with_z") {
  left_lower_end_assembly();
  explode([0, -fw*0.4, 0], offset = [0, 0, ew]) {
    tx(ew) left_z_axis_rail_assembly();
    txyz(ew/2, -fd/2+ew, ew2) {
      explode([0, 100, 0], offset = [0, -10, 10]) {
        ry(-90) cast_corner_bracket_assembly();
      }
    }
  }
  tz(ew) {
    ty(fd/2-ew) {
      explode([0, 40, 0]) rz(180) ry(90) reversed_bottom_corner_assembly();
    }
    ty(-(fd/2-ew)) {
      explode([0, -fd/2-60, 0]) rz(180) ry(90) bottom_corner_assembly();
    }
  }
}

//! The position of the motor mount is not crucial but the design has it
//! centered 80mm from the center. The rail guard should be positioned
//! at the centre.

module right_lower_end_assembly()
    pose([48.3, 0, 134.4], [93.95, 188.8, 194.16])
    assembly("right_lower_end") {
  lower_end_assembly();
}

//! The position of the motor mount is not crucial but the design has it
//! centered 80mm from the center. The rail guard should be positioned
//! at the centre.

module left_lower_end_assembly()
    pose([49.7, 0, 142.1], [113.75, 206.43, 164.43])
    assembly("left_lower_end") {
  mirror([1, 0, 0]) lower_end_assembly();
}

module lower_end_assembly() {
  tx(-ew/2) {
    tz(ew2/2) {
      rx(90) {
        extrusion(e2040, fd-ew*2);
      }
      tz(ew) {
        ty(fd/2-ew) {
          explode([0, 140, 0], offset = [0, -10, 10]) {
            rz(180) ry(-90) cast_corner_bracket_assembly();
          }
        }
      }
    }
    explode([0, 180, 0]) z_motor_mount_assembly();
    txz(-ew, ew*1.5) explode([0, fd/2+10, 0]) ry(90) rail_guard_assembly();
  }

  tx(-ew) {
    ty(fd/2-ew) {
      tz(ew/2) rz(180) {
        explode([0, -140, 0]) milled_corner_bracket_assembly();
      }
    }
    ty(-(fd/2-ew)) {
      tz(ew/2) {
        explode([0, -40, 0]) rx(180) rz(180) milled_corner_bracket_assembly();
      }
    }
  }
}

module lower_back_frame_assembly()
  pose([82.3, 0, 308], [-199.39, -120.66, 90.82]) assembly("lower_back_frame") {
  lower_back_frame_unit();
  txyz(-fw/2+psu_l/2+ew2+80, th-ew/2, ew2+psu_w/2+th) {
    psu_mount_assembly();
  }
}

module lower_back_frame_unit() {
  tyz(-ew/2, ew2/2) {
    ry(90) rz(90) extrusion(e2040, fw-ew*4);
  }
}

module xy_combined_assembly()
  pose([83.7, 0, 36.9], [-175.28, 151.92, 355.94]) assembly("xy_combined") {
  txyz(pos[0], pos[1]+y_rail_offset, x_bar_h) {
    x_axis_assembly();
  }
  txyz(-(fw/2-ew*1.5), pos[1]+y_rail_offset, y_bar_h) {
    explode([-50, 0, 0], offset = [0, 0, -ew/2]) {
      left_y_carriage_assembly();
    }
  }
  txyz(fw/2-ew*1.5, pos[1]+y_rail_offset, y_bar_h) {
    explode([50, 0, 0], offset = [-50, 0, -ew/2]) {
      right_y_carriage_assembly();
    }
  }
}

module xy_combined_assembly_with_fixings() {
  xy_combined_assembly();
  tyz(pos[1]+y_rail_offset, y_bar_h) myz(fw/2-ew*1.5) y_carriage_screws();
}

//! Loosen the t-nuts at either end of the z carriage extrusion and slide
//! one end in then the other.

module frame_with_bed_assembly()
  pose([67.9, 0, 25.2], [51.78, -1.41, 223.77])
  assembly("frame_with_bed") {

  frame_with_x_rail_assembly();
  explode([0, 0, -20]) z_axis_assembly();
}

module frame_with_x_rail_assembly()
    pose([68.6, 0, 31.5], [30.37, -8.04, 221.51])
    assembly("frame_with_x_rail") {
  frame_assembly();
  explode([0, 0, 100], true) xy_combined_assembly_with_fixings();
}

module frame_assembly()
    pose([67.9, 0, 24.3], [-1.52, 42.48, 200.56])
    assembly("frame") {
  tx(fw/2) explode([60, 0, 0]) right_end_with_z_carriage_rail_assembly();
  tx(-fw/2) explode([-60, 0, 0]) left_end_with_z_carriage_rail_assembly();

  ty(fd/2) {
    lower_back_frame_assembly();

    // upper back
    tyz(-ew/2, fh-ew2/2) {
      ry(90) rz(90) extrusion(e2040, fw-ew*4);
    }
  }

  // lower front
  ty(-fd/2) {
    mirror([0,1,0]) {
      // mirror is safe as all components in unit are symmetrical
      lower_back_frame_unit();
    }
  }

  // optional front extrusion
  *color("green") tyz(-(fd/2-ew/2), motor_z-th-ew/2) {
    ry(90) extrusion(e2020, fw-ew*4);
    myz(fw/2-ew2) {
      txz(0, -ew/2) rz(90) ry(90) cast_corner_bracket_assembly();
    }
  }

}

if ($preview) {
  $explode = 0;
  //frame_assembly();
  //frame_with_bed_assembly();
  //frame_with_x_rail_assembly();
  //left_central_and_rear_assembly();
  //left_central_end_assembly();
  //left_end_frame_assembly();
  //left_end_with_z_carriage_rail_assembly();
  //left_lower_end_assembly();
  //left_lower_end_with_z_assembly();
  left_upper_end_assembly();
  //lower_back_frame_assembly();
  //right_central_and_rear_assembly();
  //right_central_end_assembly();
  //right_end_frame_assembly();
  //right_end_with_z_carriage_rail_assembly();
  //right_lower_end_assembly();
  //right_lower_end_with_z_assembly();
  //right_upper_end_assembly();
  //xy_combined_assembly();
}
