beanz/m-bot-scad/(list of files, cad)

Other CAD files:
dxfs/aluminium_flat_bar.dxf
dxfs/bed.dxf
stls/x_carriage_rear.stl
stls/left_y_carriage.stl
stls/left_idler.stl
stls/left_motor_mount.stl
scad/right-frame.scad
scad/ooznest/8mm-acme-anti-backlash-nut_VSLOT-H-A-AB-NUT-B.stl
