beanz/m-bot-scad/printme.html

/home/beanz/bin/python: No module named markdown
