beanz/m-bot-scad/assemblies/back_left_idler_assembled.png

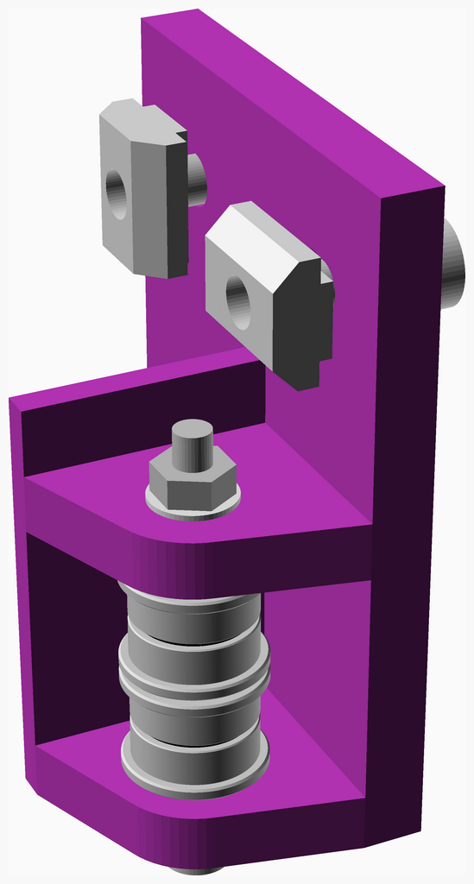
assemblies/back_left_idler_assembled.png
