beanz/m-bot-scad/assemblies/back_left_idler_assembly.png

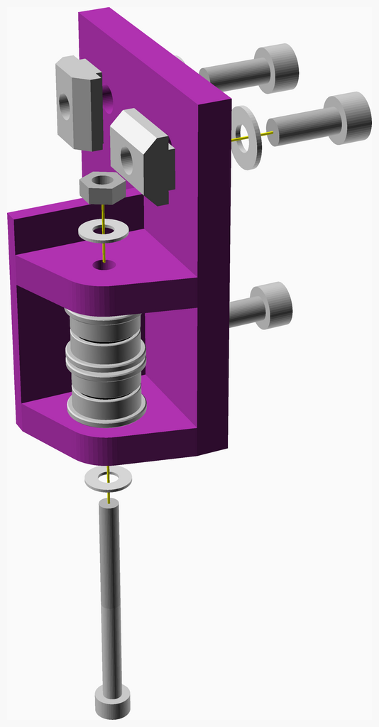
assemblies/back_left_idler_assembly.png
