beanz/m-bot-scad/assemblies/back_right_idler_assembled.png

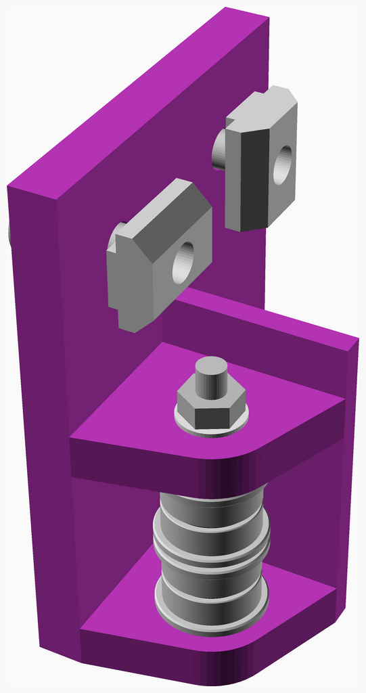
assemblies/back_right_idler_assembled.png
