beanz/m-bot-scad/assemblies/back_right_idler_assembly.png

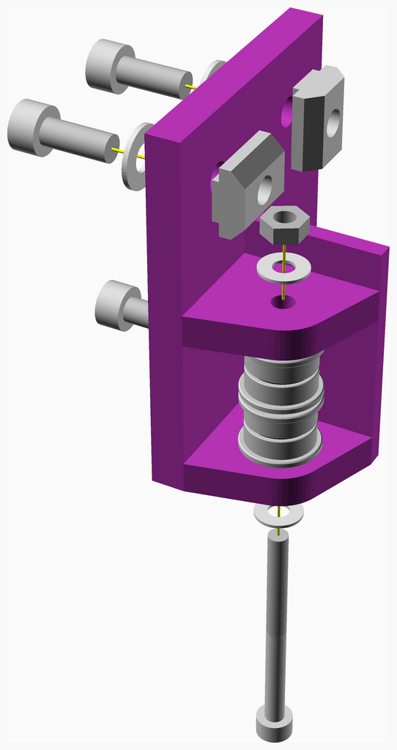
assemblies/back_right_idler_assembly.png
