beanz/m-bot-scad/assemblies/bed_assembly_tn.png

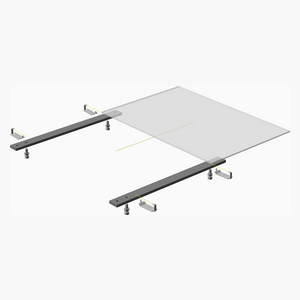
assemblies/bed_assembly_tn.png
