beanz/m-bot-scad/assemblies/belts_assembly_tn.png

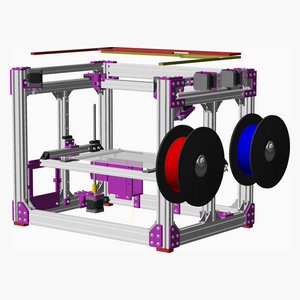
assemblies/belts_assembly_tn.png
