beanz/m-bot-scad/assemblies/bottom_corner_assembled.png

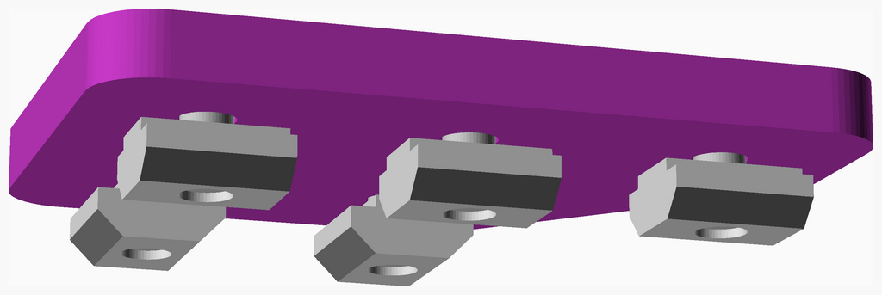
assemblies/bottom_corner_assembled.png
