beanz/m-bot-scad/assemblies/bottom_corner_assembly.png

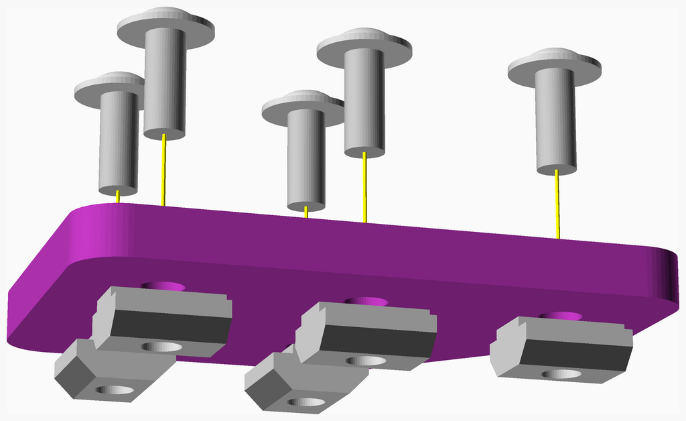
assemblies/bottom_corner_assembly.png
