beanz/m-bot-scad/assemblies/cast_corner_bracket_assembled.png

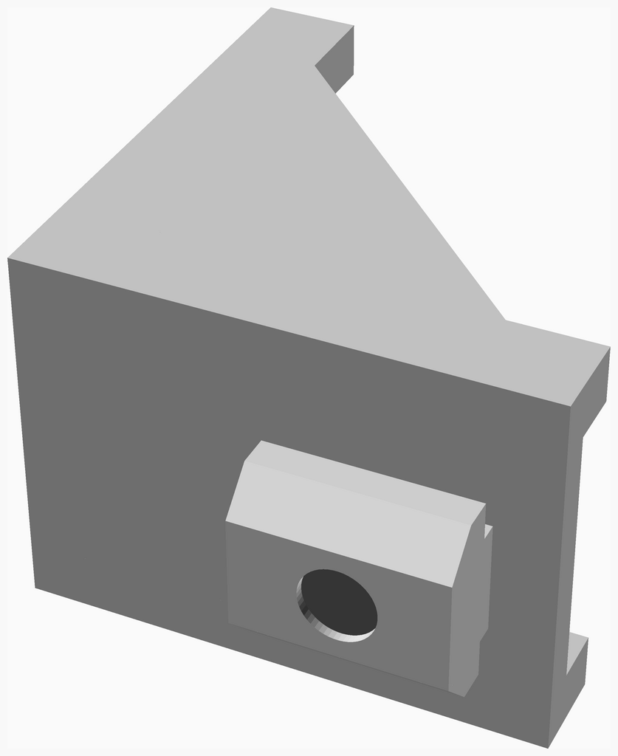
assemblies/cast_corner_bracket_assembled.png
