beanz/m-bot-scad/assemblies/cast_corner_bracket_assembly.png

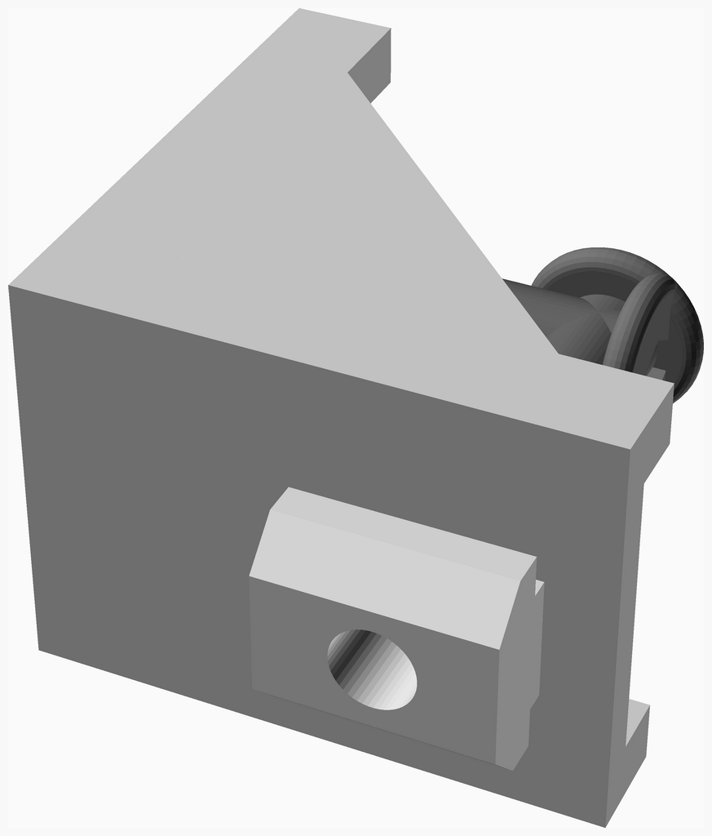
assemblies/cast_corner_bracket_assembly.png
