beanz/m-bot-scad/assemblies/dual_idler_assembled.png

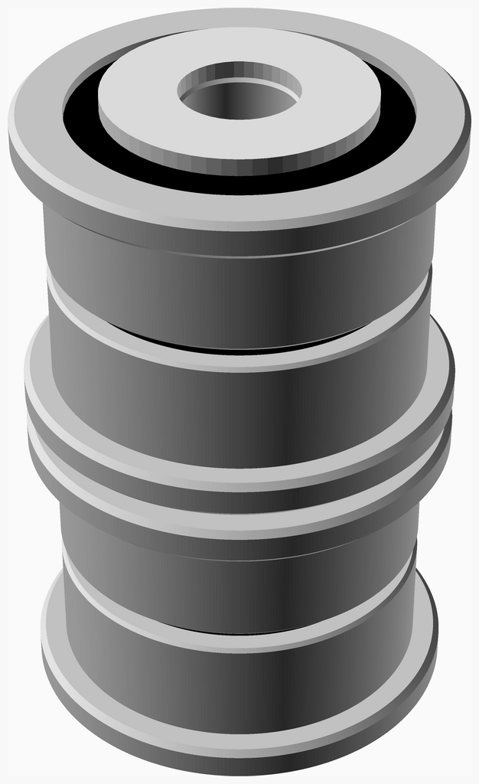
assemblies/dual_idler_assembled.png
