beanz/m-bot-scad/assemblies/dual_idler_assembly.png

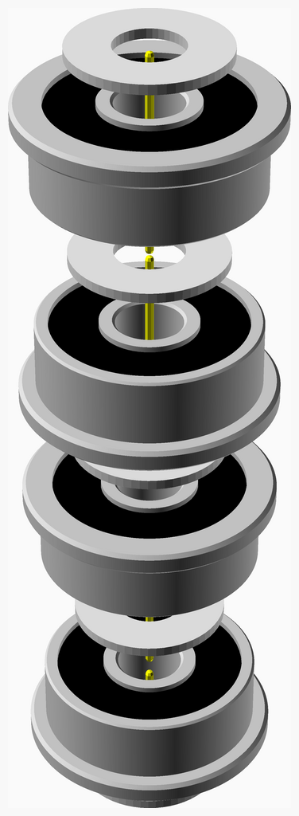
assemblies/dual_idler_assembly.png
