beanz/m-bot-scad/assemblies/duct_assembly_tn.png

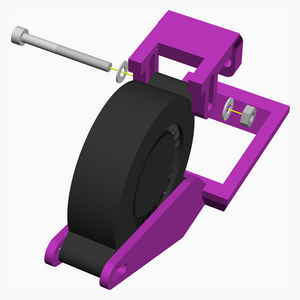
assemblies/duct_assembly_tn.png
