beanz/m-bot-scad/assemblies/duet_mount_assembly_tn.png

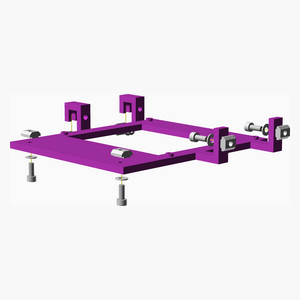
assemblies/duet_mount_assembly_tn.png
