beanz/m-bot-scad/assemblies/frame_assembly_tn.png

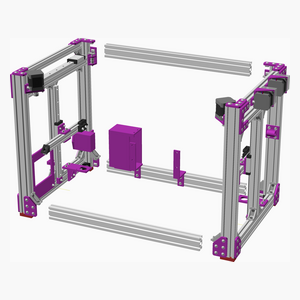
assemblies/frame_assembly_tn.png
