beanz/m-bot-scad/assemblies/frame_with_spool_holder_assembly_tn.png

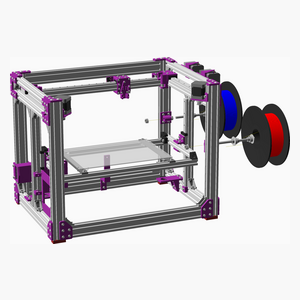
assemblies/frame_with_spool_holder_assembly_tn.png
