beanz/m-bot-scad/assemblies/frame_with_x_rail_assembly_tn.png

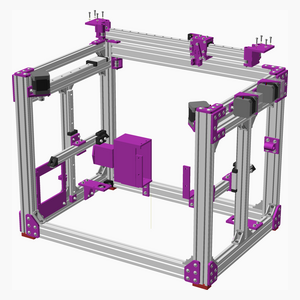
assemblies/frame_with_x_rail_assembly_tn.png
