beanz/m-bot-scad/assemblies/idler_assembled.png

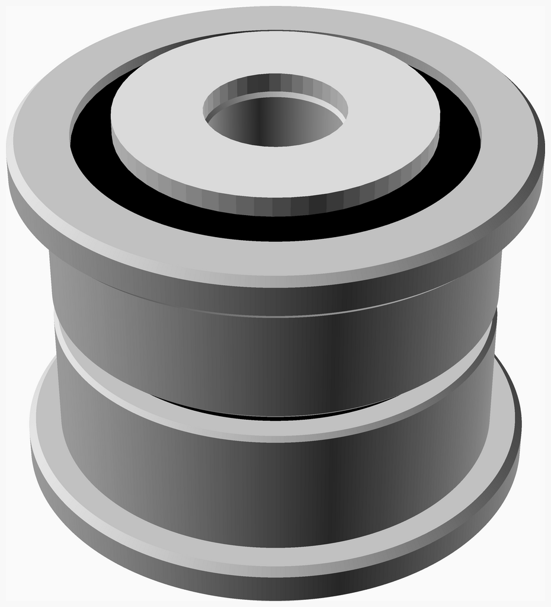
assemblies/idler_assembled.png
