beanz/m-bot-scad/assemblies/idler_assembly.png

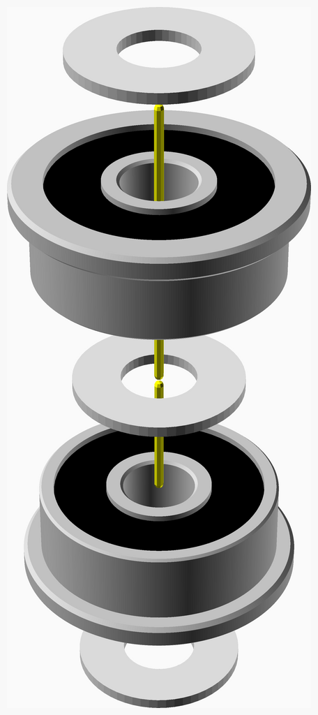
assemblies/idler_assembly.png
