beanz/m-bot-scad/assemblies/left_back_top_corner_assembled.png

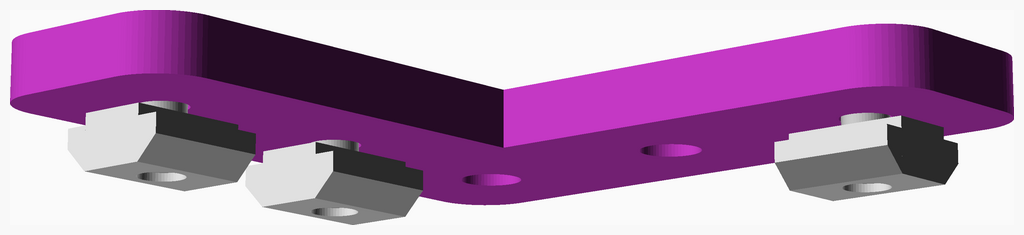
assemblies/left_back_top_corner_assembled.png
