beanz/m-bot-scad/assemblies/left_back_top_corner_assembly.png

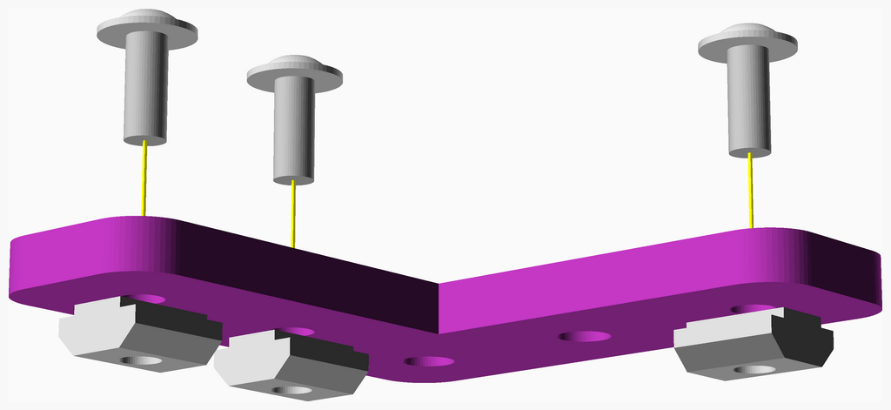
assemblies/left_back_top_corner_assembly.png
