beanz/m-bot-scad/assemblies/left_central_and_rear_assembly_tn.png

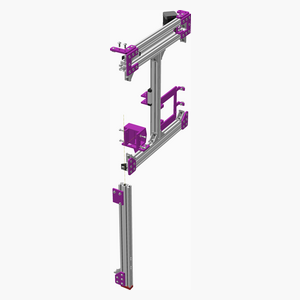
assemblies/left_central_and_rear_assembly_tn.png
