beanz/m-bot-scad/assemblies/left_central_end_assembly_tn.png

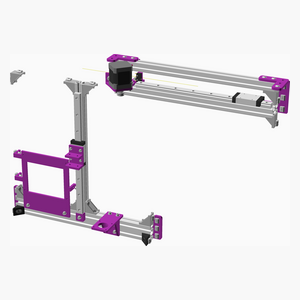
assemblies/left_central_end_assembly_tn.png
