beanz/m-bot-scad/assemblies/left_end_frame_assembly_tn.png

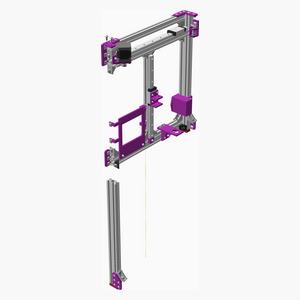
assemblies/left_end_frame_assembly_tn.png
