beanz/m-bot-scad/assemblies/left_front_top_corner_assembled.png

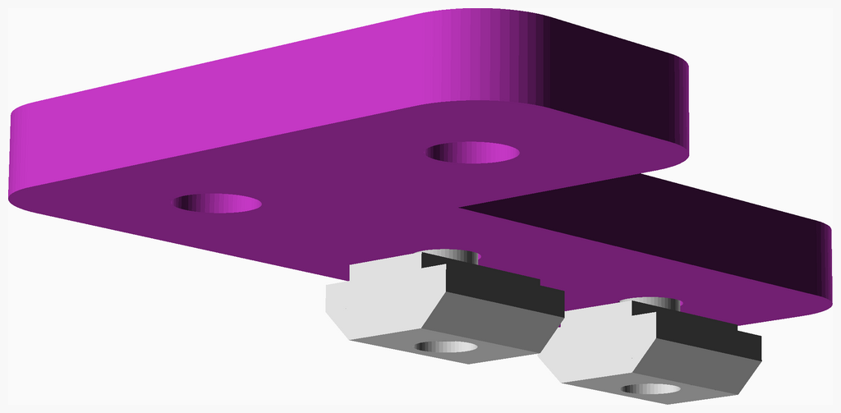
assemblies/left_front_top_corner_assembled.png
