beanz/m-bot-scad/assemblies/left_front_top_corner_assembly.png

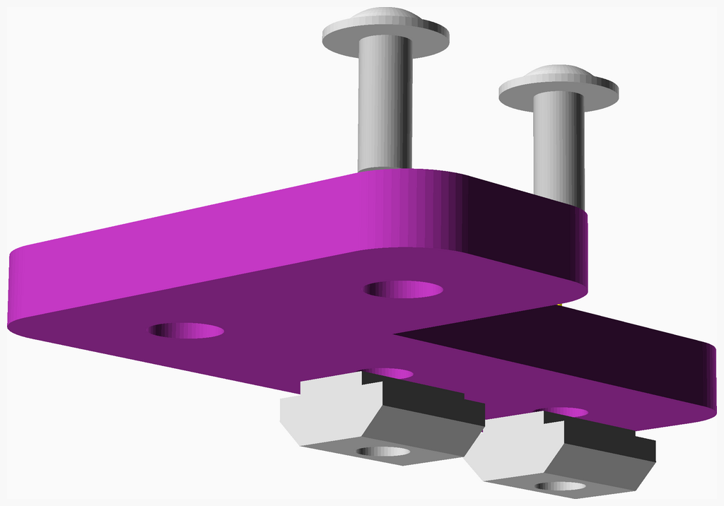
assemblies/left_front_top_corner_assembly.png
