beanz/m-bot-scad/assemblies/left_lower_end_assembly_tn.png

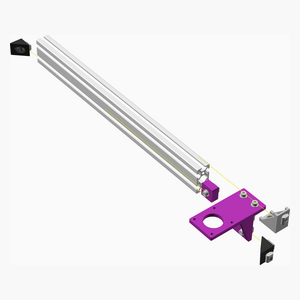
assemblies/left_lower_end_assembly_tn.png
