beanz/m-bot-scad/assemblies/left_motor_assembled.png

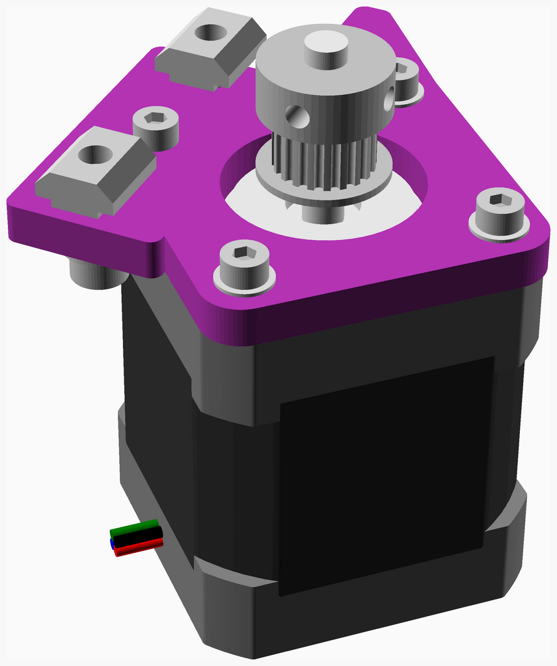
assemblies/left_motor_assembled.png
