beanz/m-bot-scad/assemblies/left_motor_assembly.png

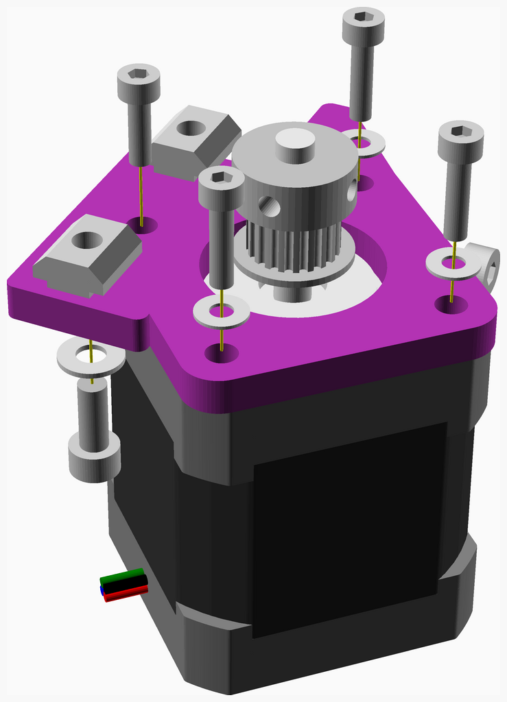
assemblies/left_motor_assembly.png
