beanz/m-bot-scad/assemblies/left_rear_upright_assembled.png

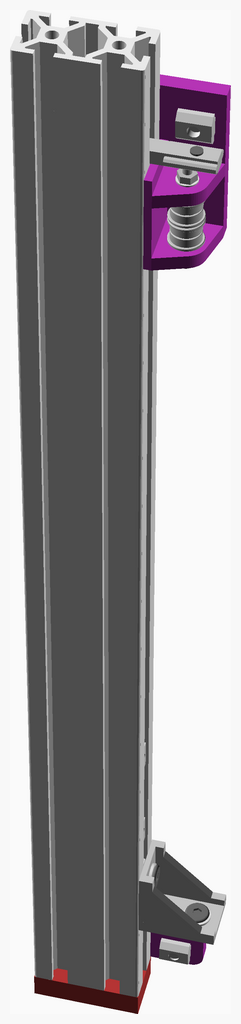
assemblies/left_rear_upright_assembled.png
