beanz/m-bot-scad/assemblies/left_upper_end_assembled.png

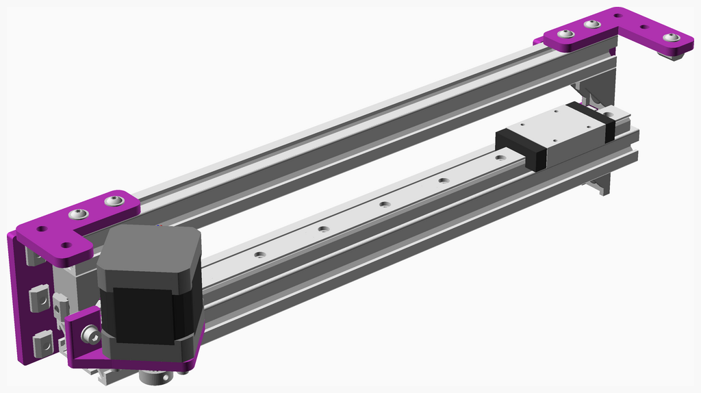
assemblies/left_upper_end_assembled.png
