beanz/m-bot-scad/assemblies/left_upper_end_assembly.png

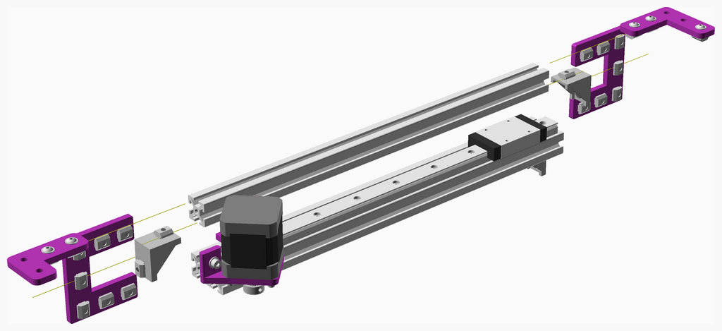
assemblies/left_upper_end_assembly.png
