beanz/m-bot-scad/assemblies/left_y_carriage_assembled.png

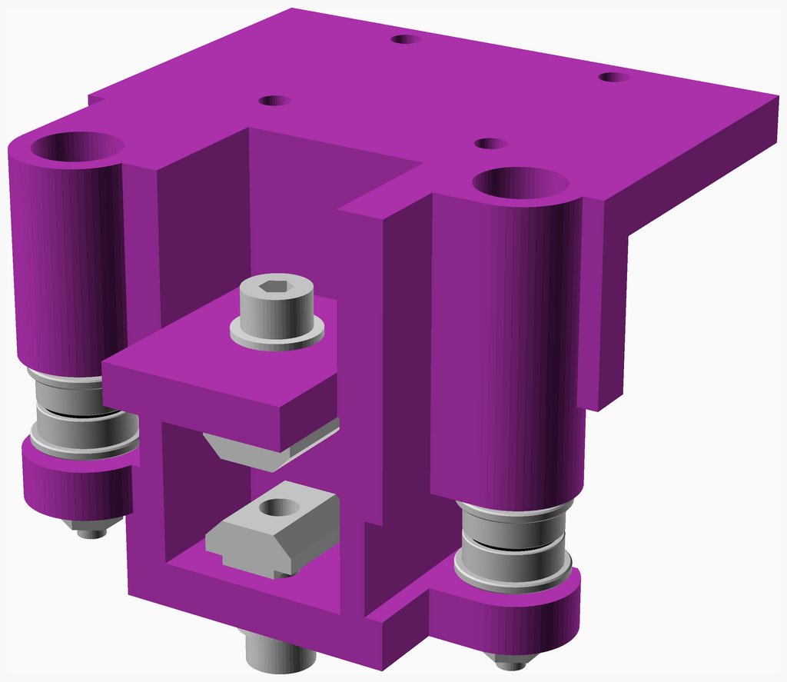
assemblies/left_y_carriage_assembled.png
