beanz/m-bot-scad/assemblies/left_y_carriage_assembly.png

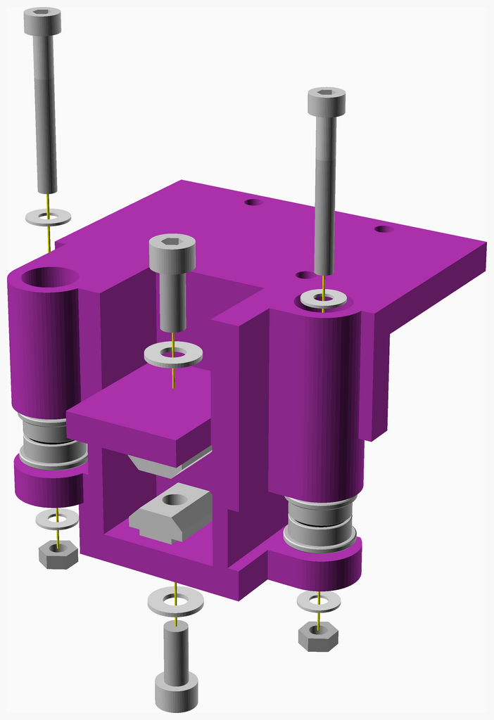
assemblies/left_y_carriage_assembly.png
