beanz/m-bot-scad/assemblies/left_y_rail_assembled.png

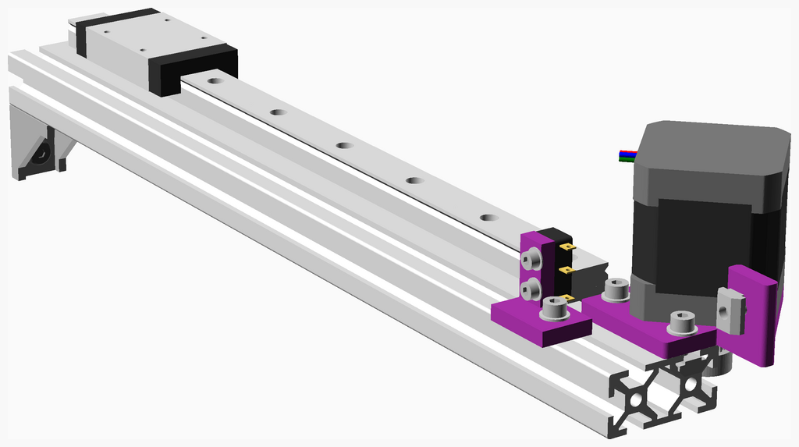
assemblies/left_y_rail_assembled.png
