beanz/m-bot-scad/assemblies/left_z_axis_rail_assembly_tn.png

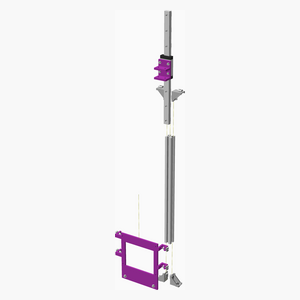
assemblies/left_z_axis_rail_assembly_tn.png
