beanz/m-bot-scad/assemblies/lower_back_frame_assembly_tn.png

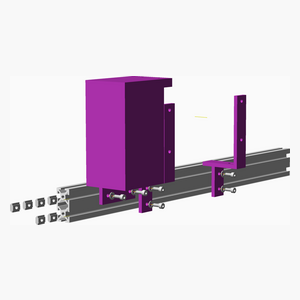
assemblies/lower_back_frame_assembly_tn.png
