beanz/m-bot-scad/assemblies/main_assembled_tn.png

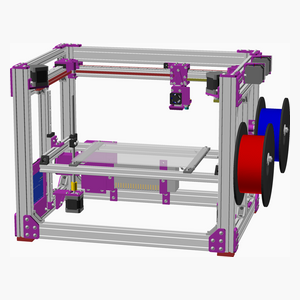
assemblies/main_assembled_tn.png
