beanz/m-bot-scad/assemblies/milled_corner_bracket_assembled.png

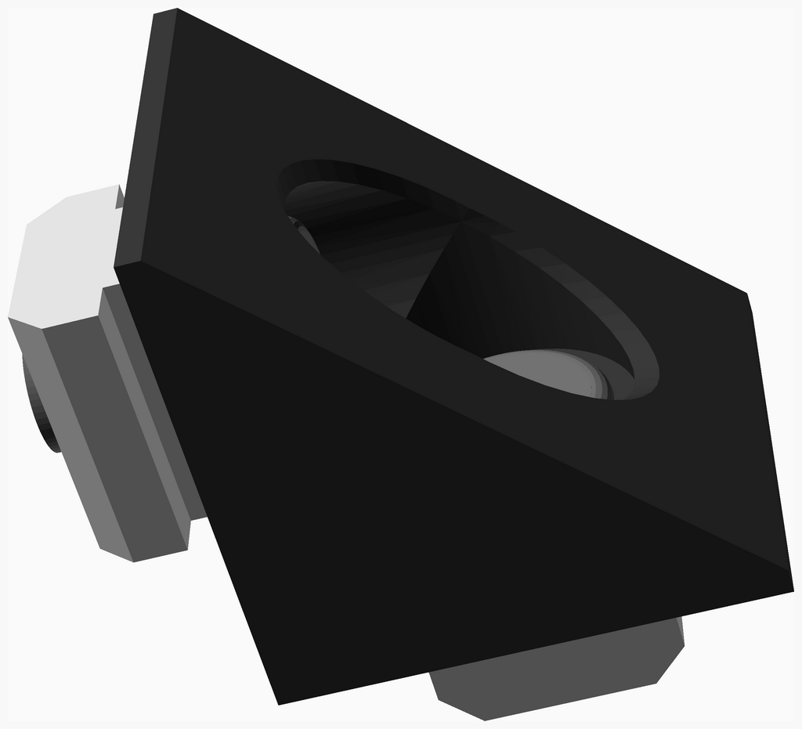
assemblies/milled_corner_bracket_assembled.png
