beanz/m-bot-scad/assemblies/milled_corner_bracket_assembly.png

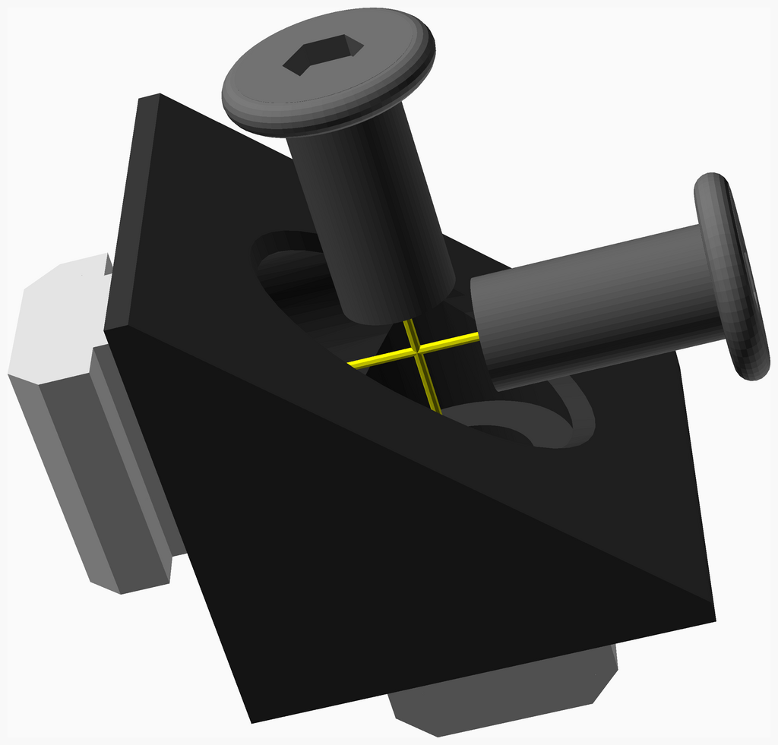
assemblies/milled_corner_bracket_assembly.png
