beanz/m-bot-scad/assemblies/milled_corner_for_tapped_end_assembled.png

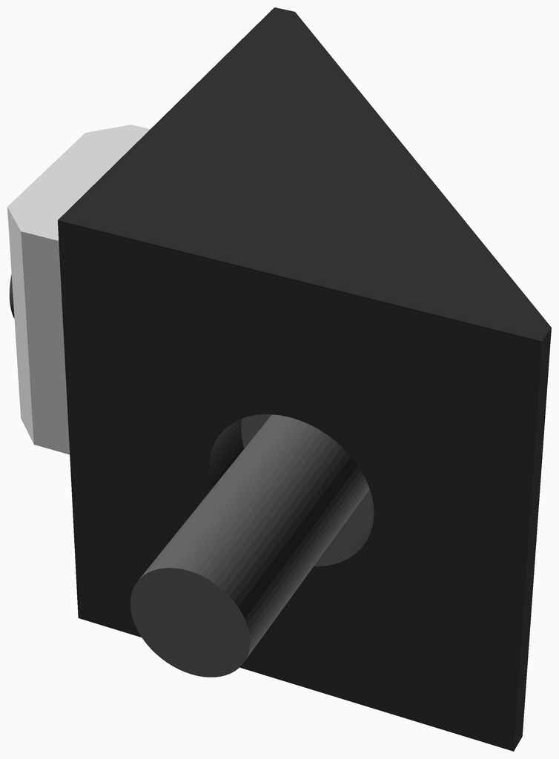
assemblies/milled_corner_for_tapped_end_assembled.png
