beanz/m-bot-scad/assemblies/reversed_bottom_corner_assembled.png

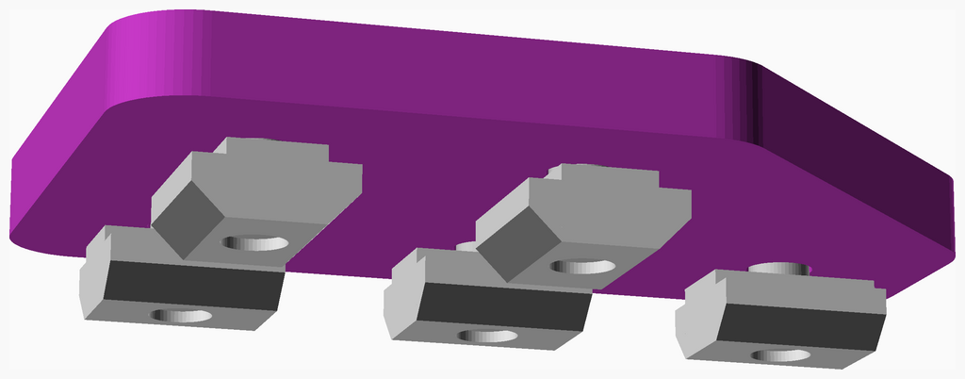
assemblies/reversed_bottom_corner_assembled.png
