beanz/m-bot-scad/assemblies/reversed_bottom_corner_assembly.png

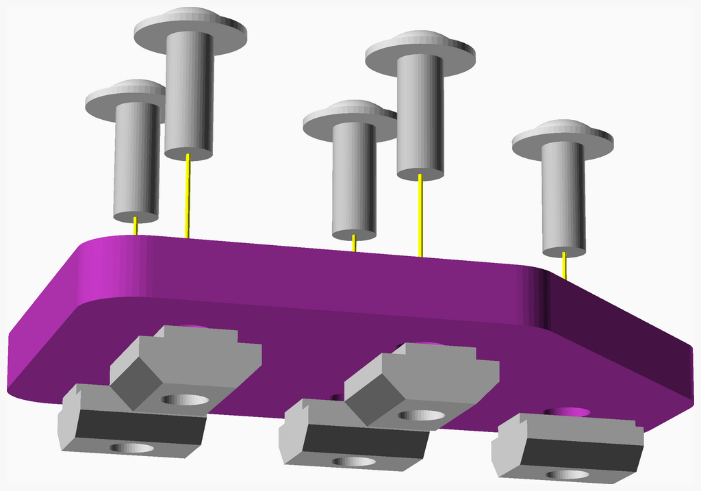
assemblies/reversed_bottom_corner_assembly.png
