beanz/m-bot-scad/assemblies/right_back_top_corner_assembled.png

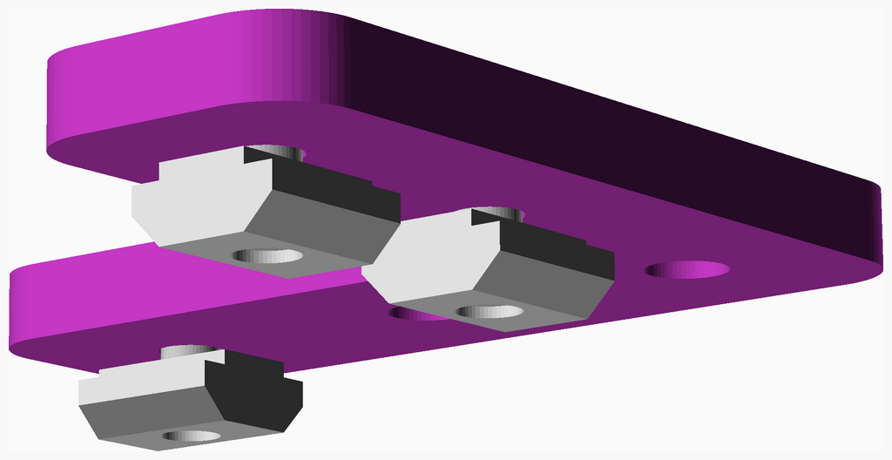
assemblies/right_back_top_corner_assembled.png
