beanz/m-bot-scad/assemblies/right_back_top_corner_assembly.png

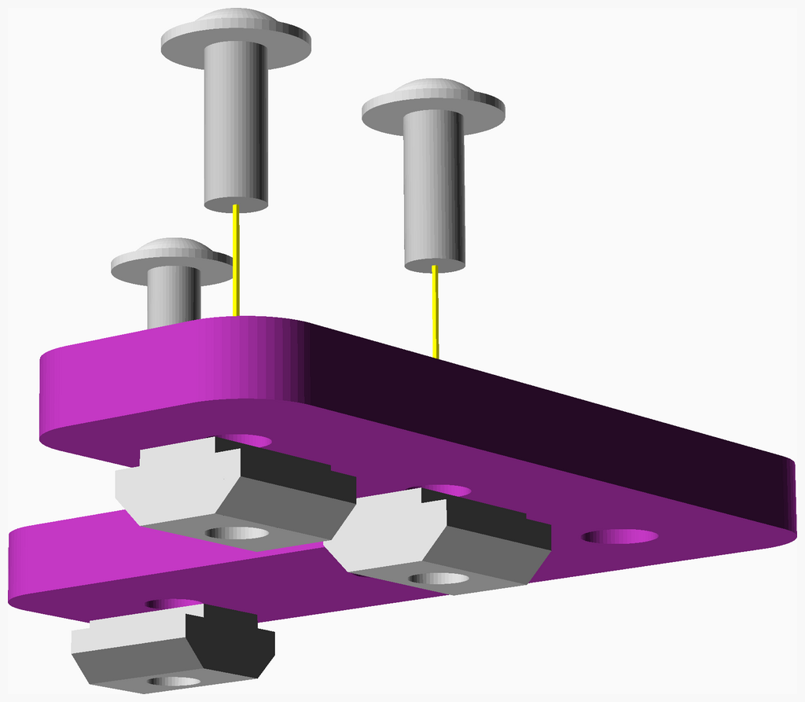
assemblies/right_back_top_corner_assembly.png
