beanz/m-bot-scad/assemblies/right_central_and_rear_assembly_tn.png

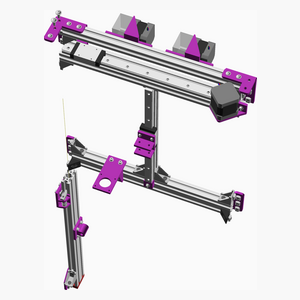
assemblies/right_central_and_rear_assembly_tn.png
