beanz/m-bot-scad/assemblies/right_central_end_assembly_tn.png

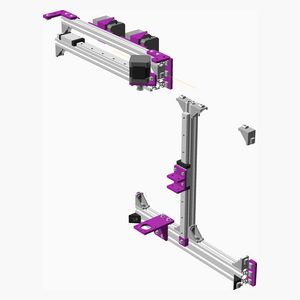
assemblies/right_central_end_assembly_tn.png
