beanz/m-bot-scad/assemblies/right_end_frame_assembly_tn.png

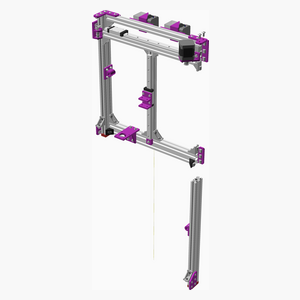
assemblies/right_end_frame_assembly_tn.png
