beanz/m-bot-scad/assemblies/right_front_top_corner_assembled.png

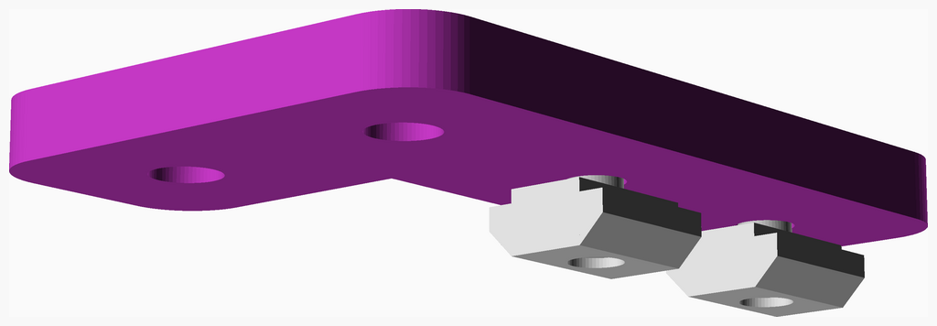
assemblies/right_front_top_corner_assembled.png
