beanz/m-bot-scad/assemblies/right_front_top_corner_assembly.png

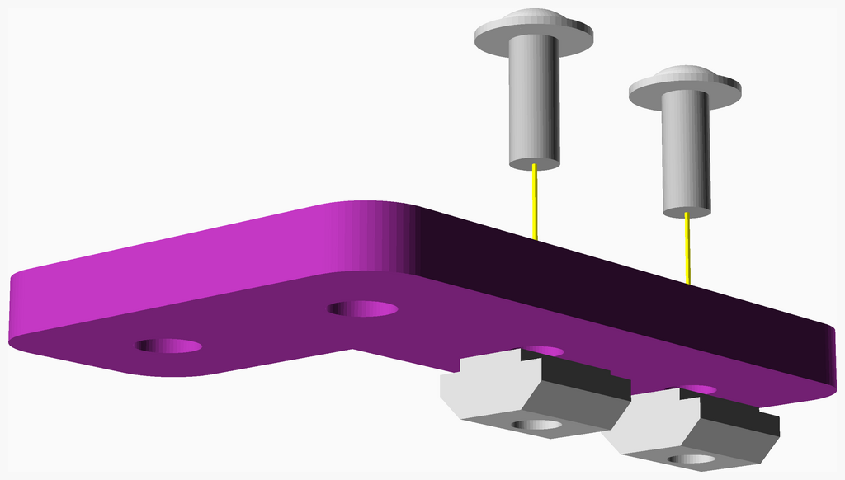
assemblies/right_front_top_corner_assembly.png
