beanz/m-bot-scad/assemblies/right_lower_end_assembly_tn.png

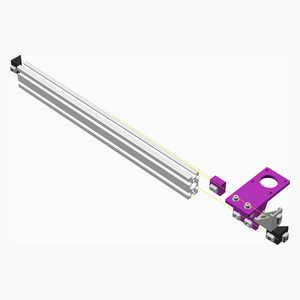
assemblies/right_lower_end_assembly_tn.png
