beanz/m-bot-scad/assemblies/right_motor_assembled.png

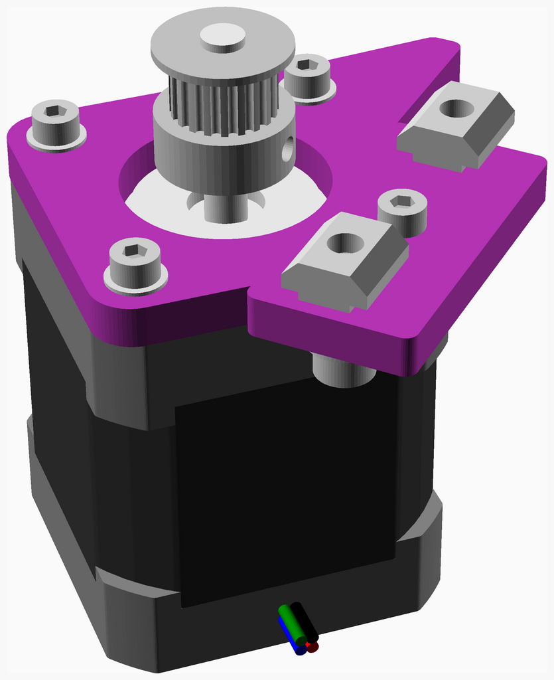
assemblies/right_motor_assembled.png
