beanz/m-bot-scad/assemblies/right_motor_assembly.png

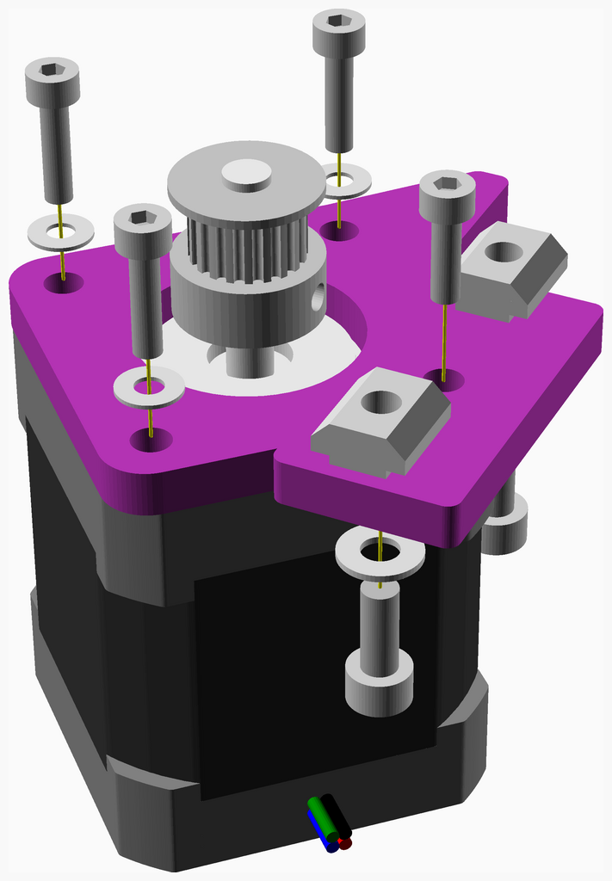
assemblies/right_motor_assembly.png
