beanz/m-bot-scad/assemblies/right_rear_upright_assembled.png

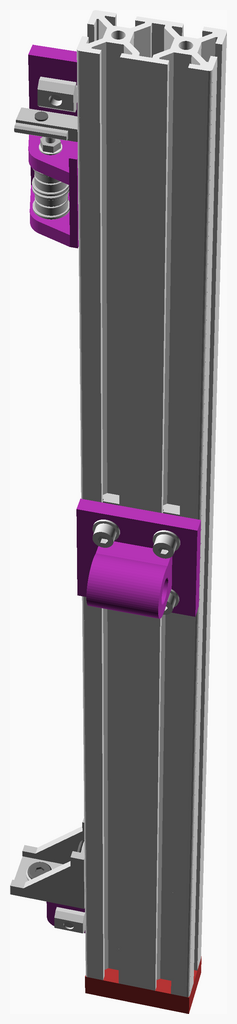
assemblies/right_rear_upright_assembled.png
