beanz/m-bot-scad/assemblies/right_upper_end_assembled.png

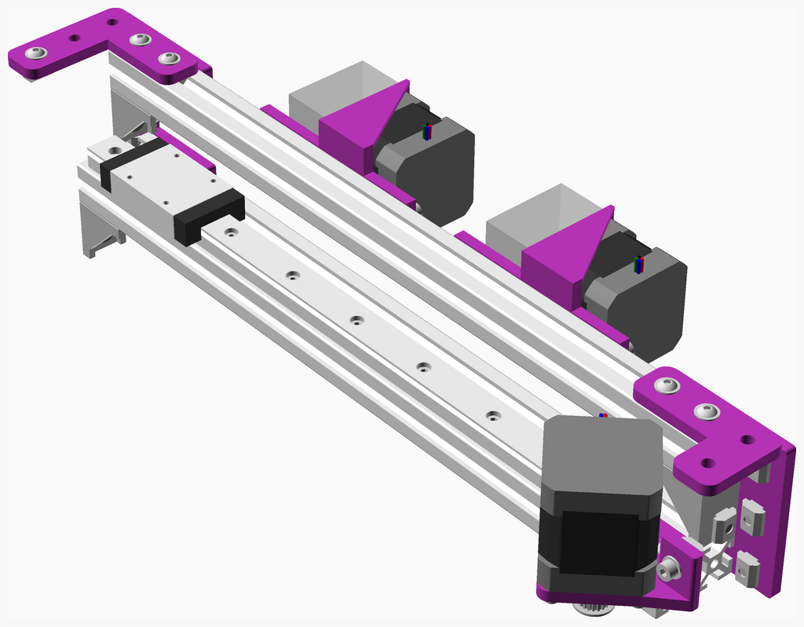
assemblies/right_upper_end_assembled.png
