beanz/m-bot-scad/assemblies/right_upper_end_assembly.png

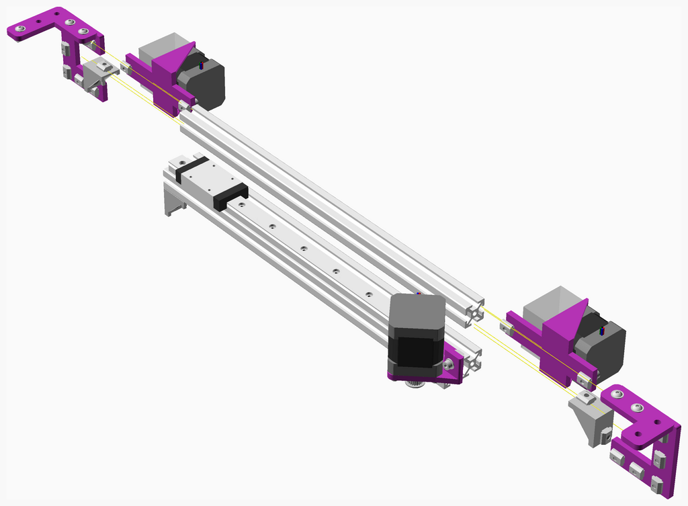
assemblies/right_upper_end_assembly.png
