beanz/m-bot-scad/assemblies/right_y_carriage_assembled.png

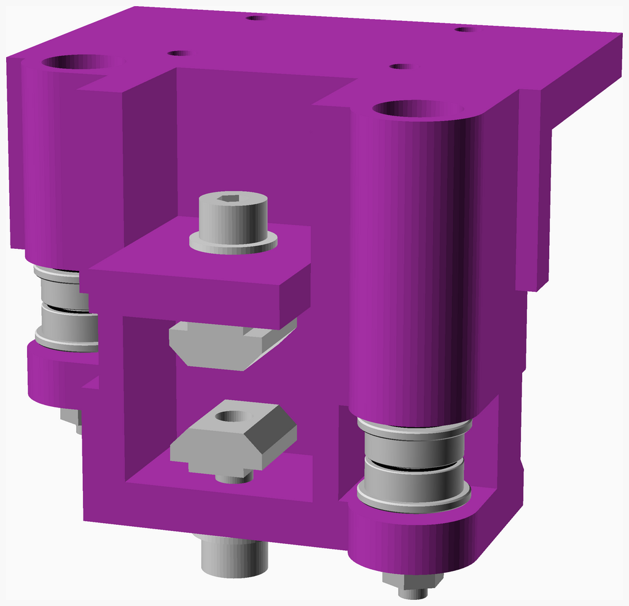
assemblies/right_y_carriage_assembled.png
