beanz/m-bot-scad/assemblies/right_y_rail_assembled.png

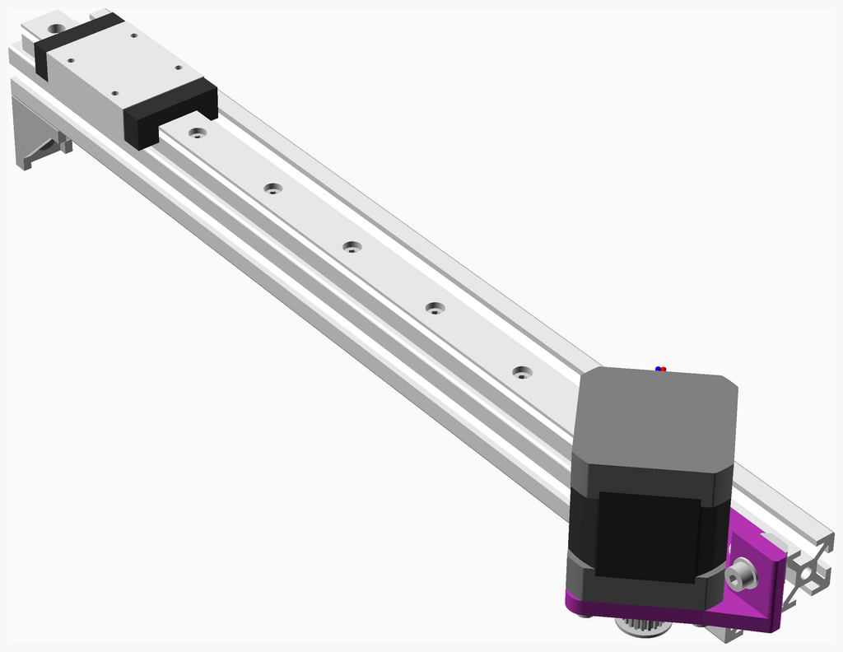
assemblies/right_y_rail_assembled.png
