beanz/m-bot-scad/assemblies/right_y_rail_assembly.png

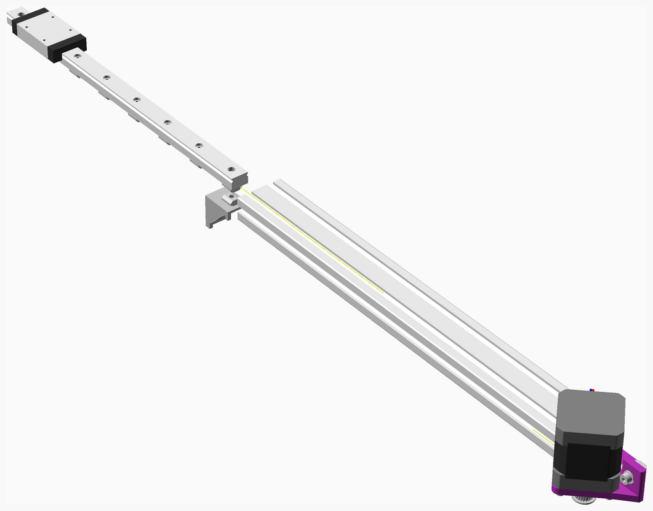
assemblies/right_y_rail_assembly.png
