beanz/m-bot-scad/assemblies/right_z_axis_rail_assembled.png

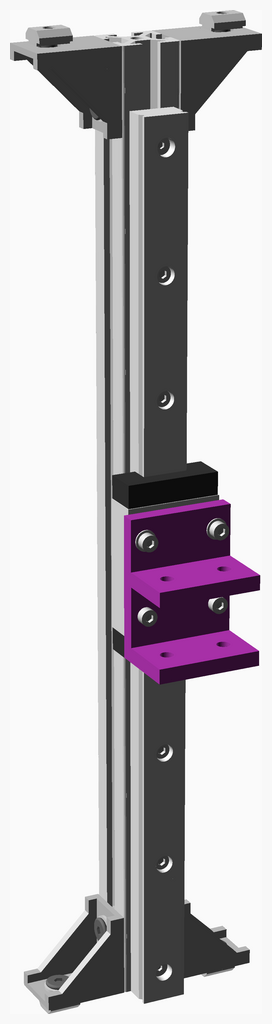
assemblies/right_z_axis_rail_assembled.png
