beanz/m-bot-scad/assemblies/side_top_corner_assembled.png

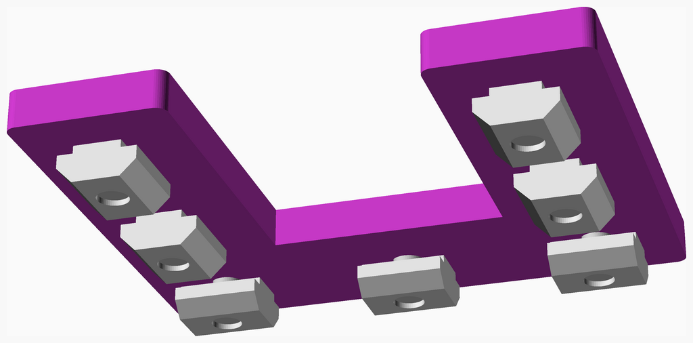
assemblies/side_top_corner_assembled.png
