beanz/m-bot-scad/assemblies/side_top_corner_assembly.png

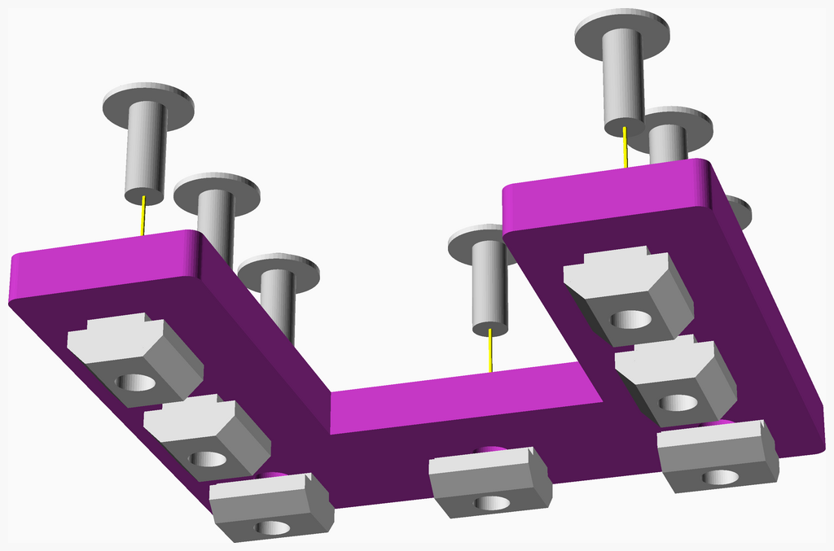
assemblies/side_top_corner_assembly.png
