beanz/m-bot-scad/assemblies/socket_assembly_tn.png

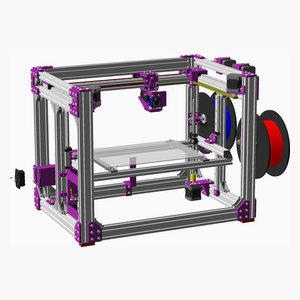
assemblies/socket_assembly_tn.png
