beanz/m-bot-scad/assemblies/spool_rod_assembled.png

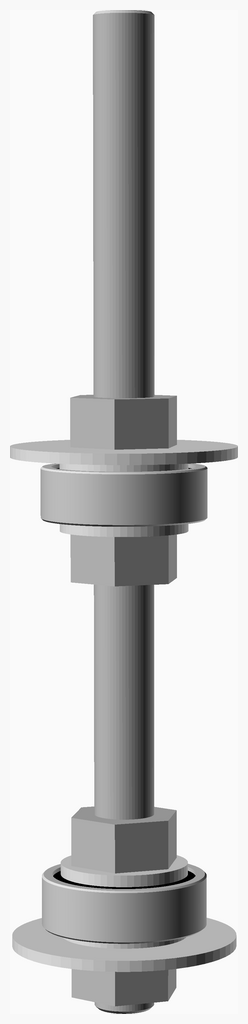
assemblies/spool_rod_assembled.png
