beanz/m-bot-scad/assemblies/titan_mount_assembled.png

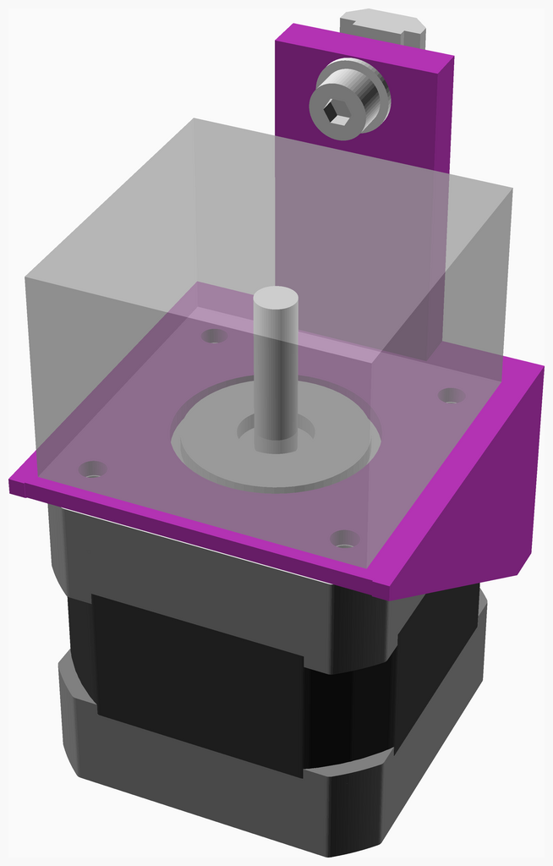
assemblies/titan_mount_assembled.png
