beanz/m-bot-scad/assemblies/x_axis_assembled.png

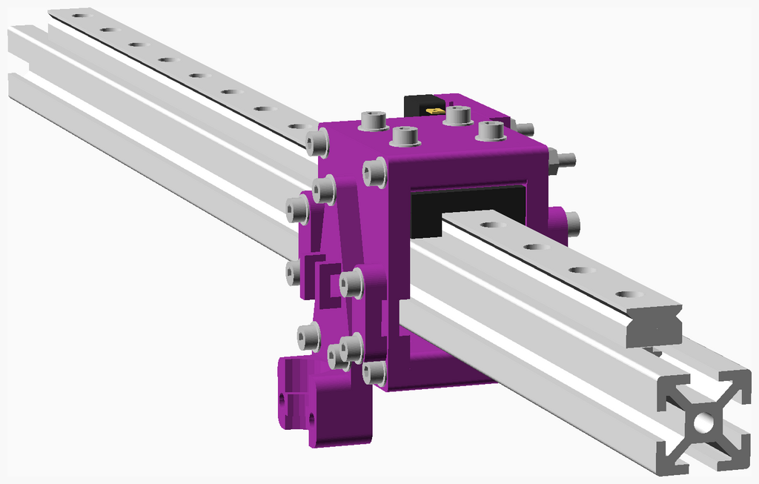
assemblies/x_axis_assembled.png
