beanz/m-bot-scad/assemblies/x_axis_assembly.png

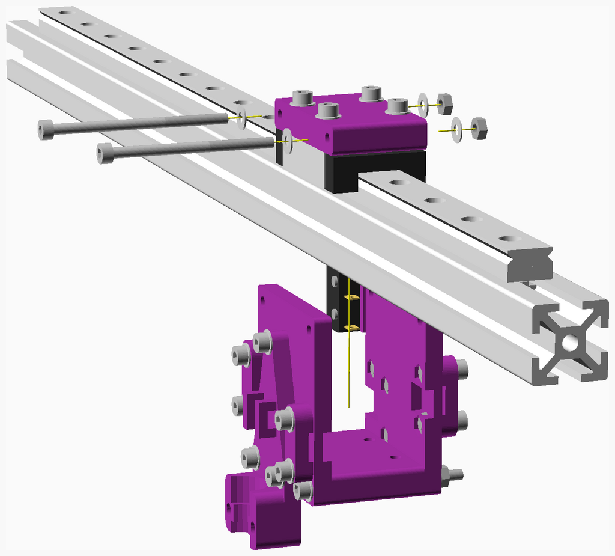
assemblies/x_axis_assembly.png
