beanz/m-bot-scad/assemblies/x_carriage_front_assembled.png

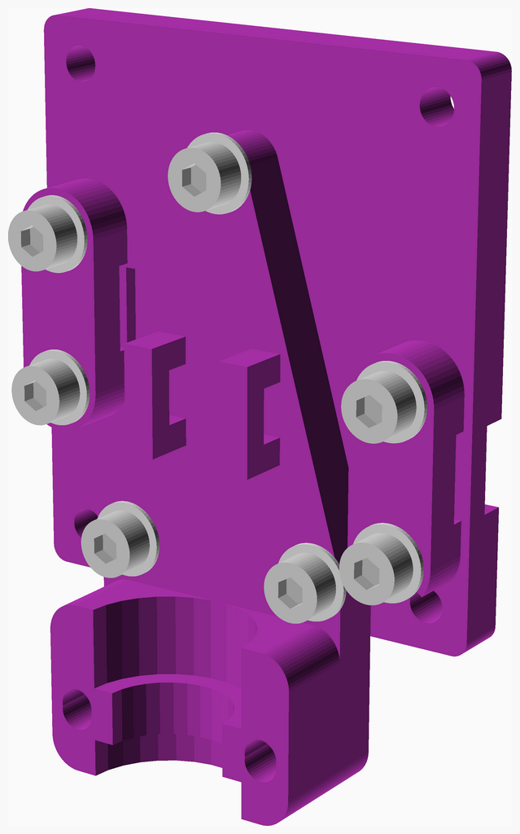
assemblies/x_carriage_front_assembled.png
