beanz/m-bot-scad/assemblies/x_carriage_front_assembly.png

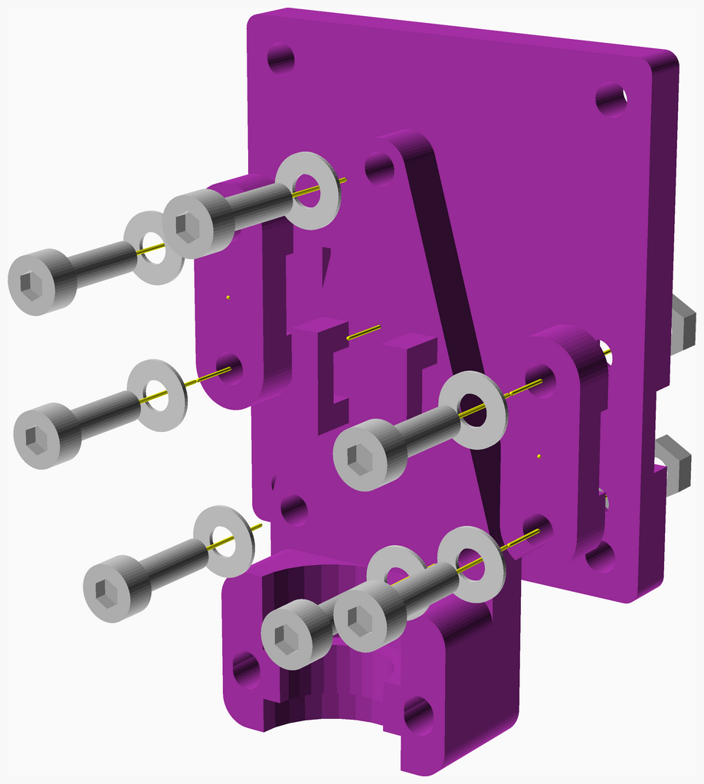
assemblies/x_carriage_front_assembly.png
