beanz/m-bot-scad/assemblies/x_carriage_rear_assembled.png

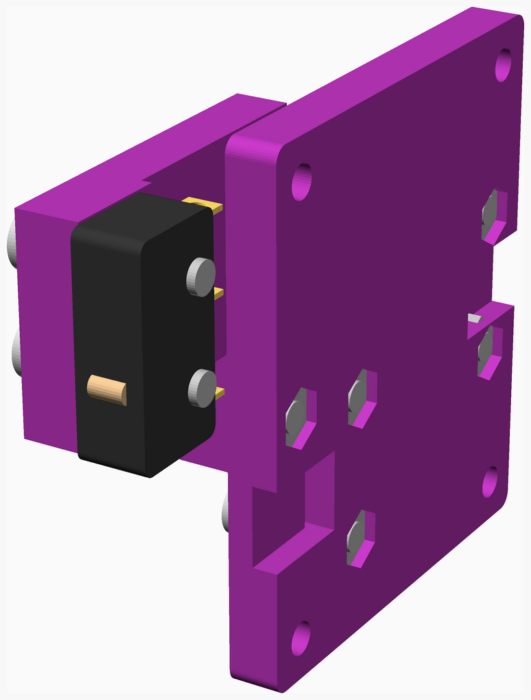
assemblies/x_carriage_rear_assembled.png
