beanz/m-bot-scad/assemblies/x_carriage_rear_assembly.png

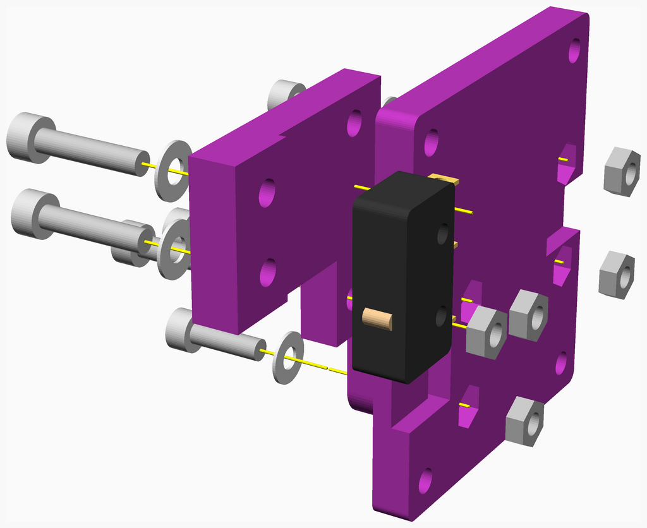
assemblies/x_carriage_rear_assembly.png
