beanz/m-bot-scad/assemblies/x_rail_assembly.png

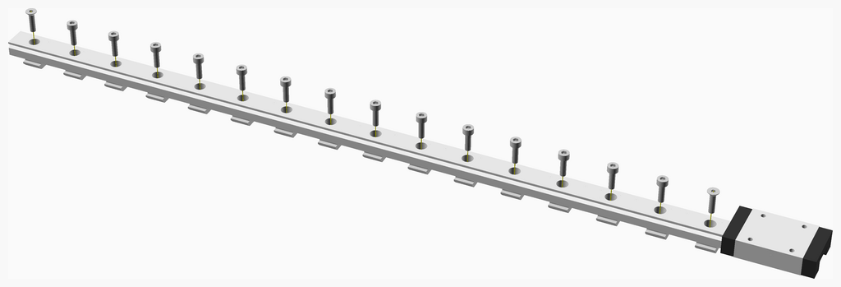
assemblies/x_rail_assembly.png
