beanz/m-bot-scad/assemblies/x_rail_carriage_assembled.png

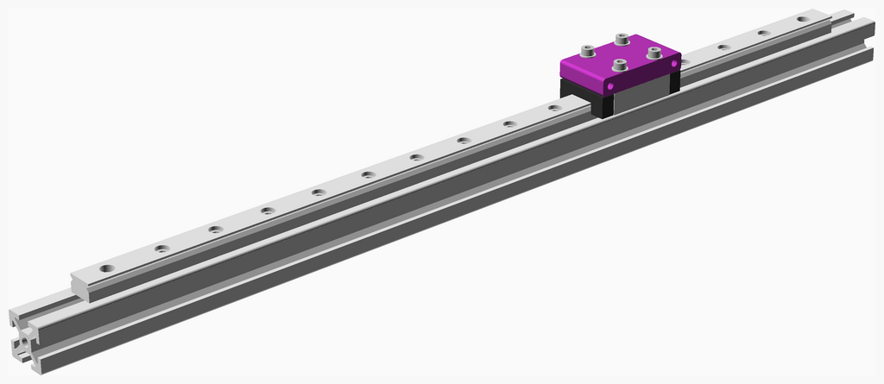
assemblies/x_rail_carriage_assembled.png
