beanz/m-bot-scad/assemblies/xy_combined_assembled.png

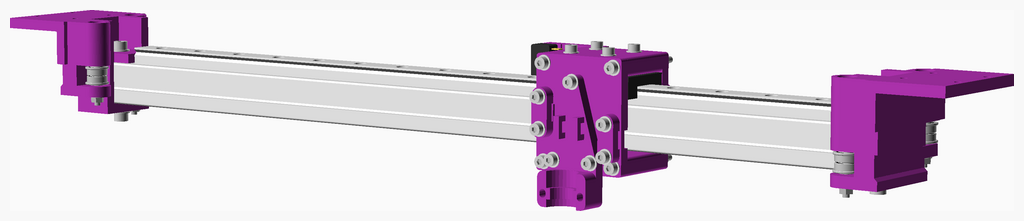
assemblies/xy_combined_assembled.png
