beanz/m-bot-scad/assemblies/y_endstop_assembled.png

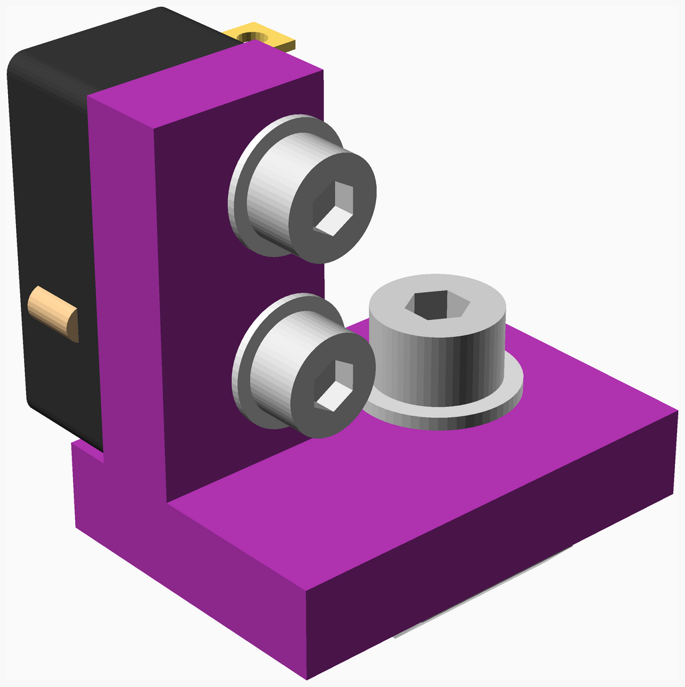
assemblies/y_endstop_assembled.png
