beanz/m-bot-scad/assemblies/y_endstop_assembly.png

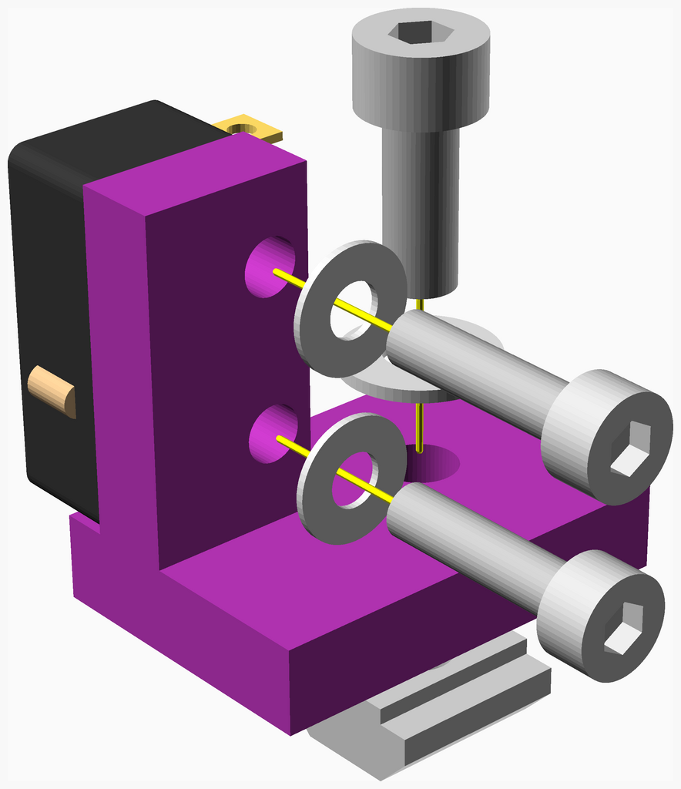
assemblies/y_endstop_assembly.png
