beanz/m-bot-scad/assemblies/y_rail_assembled.png

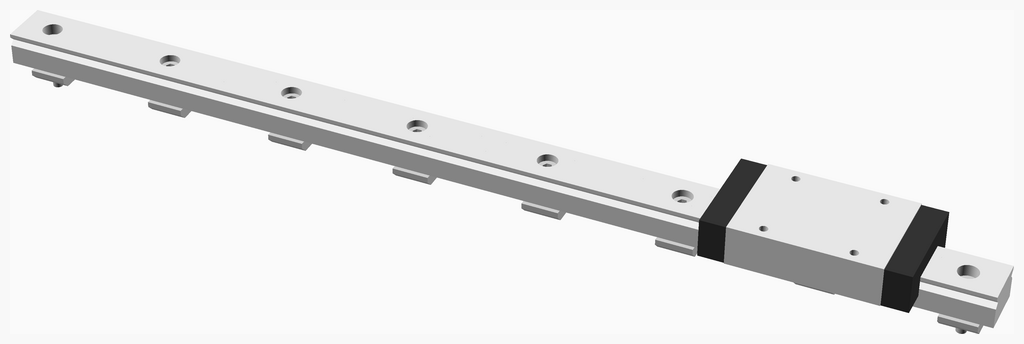
assemblies/y_rail_assembled.png
