beanz/m-bot-scad/assemblies/z_axis_assembly_tn.png

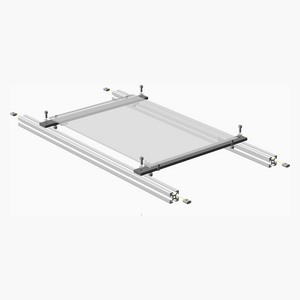
assemblies/z_axis_assembly_tn.png
