beanz/m-bot-scad/assemblies/z_carriage_assembled.png

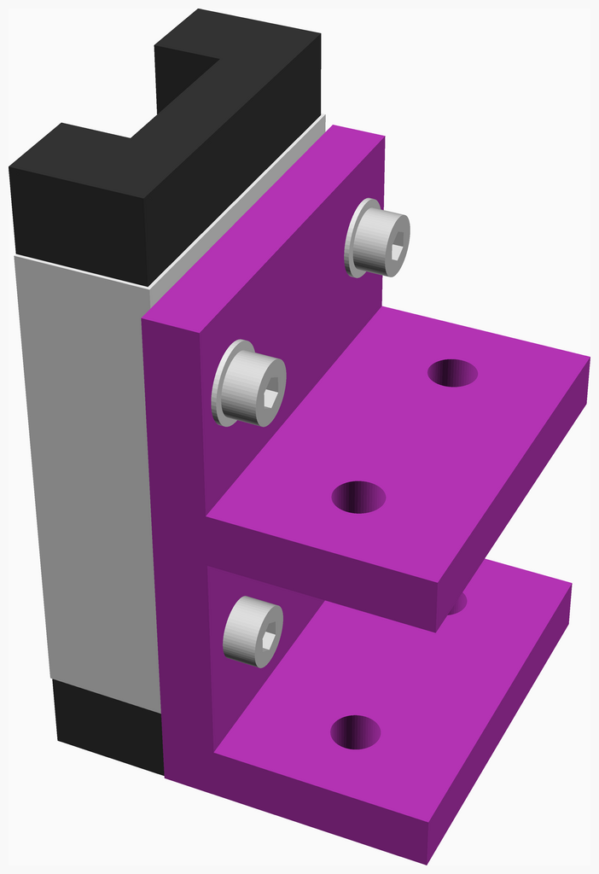
assemblies/z_carriage_assembled.png
