beanz/m-bot-scad/assemblies/z_carriage_assembly.png

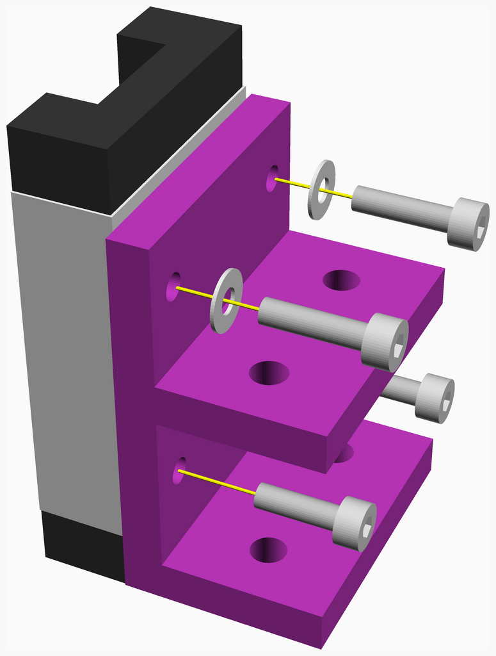
assemblies/z_carriage_assembly.png
