beanz/m-bot-scad/assemblies/z_motor_mount_assembly_tn.png

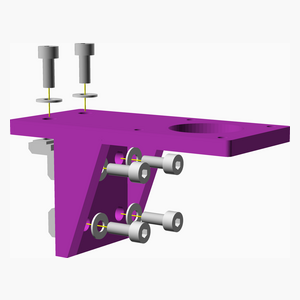
assemblies/z_motor_mount_assembly_tn.png
