beanz/m-bot-scad/assemblies/z_rail_assembly.png

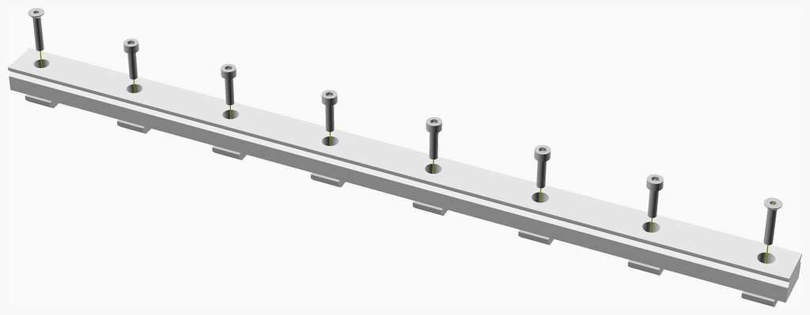
assemblies/z_rail_assembly.png
