beanz/m-bot-scad/(commit log)

2020-08-26 Initial port to NopSCADlib
    [8mm-acme-anti-backlash-nut_VSLOT-H-A-AB-NUT-B.stl, 90-degree-corner_VSLOT-B-90AC.stl, V6.6_Duct.stl, common.scad, conf.scad, e3d-v6.scad, electronics.scad, frame.scad]
2020-08-27 Fix belt end on rear carriage
    [main.scad]
2020-08-27 Fix clearance on hotend clamp
    [e3d-v6.scad]
2020-08-27 Refactor and start fan and duct
    [belts.scad, common.scad, conf.scad, corners.scad, e3d-v6.scad, feet.scad, frame.scad, idlers.scad]
2020-08-28 Add fan duct
    [x-carriage.scad]
2020-08-28 Correct screw/nut orientation
    [x-carriage.scad]
2020-08-28 Fix duct mounting and endstop position
    [x-carriage.scad]
2020-08-28 Make assemblies for corners
    [corners.scad, frame.scad, left-frame.scad, right-frame.scad]
2020-08-28 Fix spool rod assembly view
    [spool-holder.scad]
2020-08-29 Refactor final corner assembly
    [corners.scad, frame.scad]
2020-08-29 Fix part hitting motor body and enlarge holes a little
    [xy-motor.scad]
2020-08-29 Pre-assembly corner plates
    [corners.scad, frame.scad]
2020-08-29 Fix fan duct assembly
    [main.scad, x-carriage.scad]
2020-08-29 Make extrusion screws more consistent
    [conf.scad, electronics.scad, idlers.scad, spool-holder.scad, titan-mount.scad, xy-motor.scad, y-axis.scad, z-axis.scad]
2020-08-29 Fix extrusion screw length
    [electronics.scad, idlers.scad, rail-guard.scad, spool-holder.scad, titan-mount.scad, xy-motor.scad, y-axis.scad, z-axis.scad]
2020-08-29 PSU fan should face backwards
    [conf.scad, electronics.scad, main.scad]
2020-08-30 Don't mirror assemblies that aren't symmetrical
    And remove labels
    [conf.scad, frame.scad, left-frame.scad, right-frame.scad, y-axis.scad, z-axis.scad]
2020-08-30 Remove TOFIX comment
    [y-axis.scad]
2020-08-30 New flanged bearings
    [conf.scad]
2020-08-30 Fix PSU mount position
    [electronics.scad]
2020-08-31 Allow for difference in psu screw location
    [electronics.scad]
2020-09-06 Fix MGN15 carriages
    [conf.scad]
2020-09-06 Fix PSU mount screw positions
    [electronics.scad]
2020-09-11 Make fan duct mounting less constrained
    [x-carriage.scad]
2020-09-11 Fix lead screw length
    [z-axis.scad]
2020-09-11 Fix duct screw
    [x-carriage.scad]
2020-09-12 More clearance for hotend clamp screws
    [x-carriage.scad]
2020-09-12 Clearance for hotend fan
    [x-carriage.scad]
2020-09-12 Fix hotend mount regression
    [x-carriage.scad]
2020-09-29 Longer titan mount
    [titan-mount.scad]
2020-09-29 Simpler duct
    [x-carriage.scad]
2020-09-29 Fix nut trap on front x carriage
    [x-carriage.scad]
2020-09-29 Optional inserts for x carriage
    [conf.scad, x-carriage.scad]
2022-06-04 chore: use new motor names
    [conf.scad, main.scad, titan-mount.scad, xy-motor.scad, z-axis.scad]
2022-06-04 chore: update rail/carriage variables
    [conf.scad, x-axis.scad, y-axis.scad, z-axis.scad]
2022-06-04 fix: z motor assembly
    [z-axis.scad]
2023-09-02 update generated
    [aluminium_flat_bar.dxf, back_top_corner.stl, bed.dxf, belt_clamp.stl, bom.csv, bottom_corner.stl, duct.stl, duct_mount.stl]
